tyevco/dial-me-spinner/hardware/mechanical/clash_report.txt

# clash_report.txt -- generated by check_clashes.sh (see legend at the end)
CLEAR  rotor  antenna
CLEAR  rotor  base_board
CLEAR  rotor  base_cup
CLEAR  rotor  base_parts
CLEAR  rotor  battery
CLEAR  rotor  battery_leads
CLEAR  rotor  coax
CLEAR  rotor  detent@click
CLEAR  rotor  detent@free
CLEAR  rotor  fa_lower_plate
CLEAR  rotor  guide_pins
CLEAR  rotor  harness
CLEAR  rotor  hub+nut
CLEAR  rotor  light_box
CLEAR  rotor  lower_spacer
CLEAR  rotor  main_board
CLEAR  rotor  main_bottom_parts
CLEAR  rotor  main_top_parts
CLEAR  rotor  nfc_coil
CLEAR  rotor  nfc_tail
CLEAR  rotor  oled_bracket
CLEAR  rotor  oled_glass
CLEAR  rotor  spindle+pad
CLEAR  rotor  top_cover
CLASH  press  base_cup  overlap ~ 0.000 mm^3
CLASH  press  base_parts  overlap ~ 1.674 mm^3
CLEAR  press  antenna
CLEAR  press  base_board
CLEAR  press  battery
CLEAR  press  battery_leads
CLEAR  press  guide_pins
CLEAR  rest   antenna
CLEAR  rest   base_board
CLEAR  rest   base_cup
CLEAR  rest   base_parts
CLEAR  rest   battery
CLEAR  rest   battery_leads
CLASH  pair   detent@click  x  main_board  overlap ~ 0.000 mm^3
CLASH  pair   detent@free  x  main_board  overlap ~ 0.000 mm^3
CLEAR  pair   battery_leads  x  base_cup
CLEAR  pair   battery_leads  x  fa_lower_plate
CLEAR  pair   battery_leads  x  guide_pins
CLEAR  pair   coax  x  base_board
CLEAR  pair   coax  x  base_cup
CLEAR  pair   coax  x  base_parts
CLEAR  pair   coax  x  detent@click
CLEAR  pair   coax  x  detent@free
CLEAR  pair   coax  x  fa_lower_plate
CLEAR  pair   coax  x  hub+nut
CLEAR  pair   coax  x  lower_spacer
CLEAR  pair   coax  x  spindle+pad
CLEAR  pair   detent@click  x  hub+nut
CLEAR  pair   detent@free  x  hub+nut
CLEAR  pair   harness  x  base_cup
CLEAR  pair   harness  x  detent@click
CLEAR  pair   harness  x  detent@free
CLEAR  pair   harness  x  fa_lower_plate
CLEAR  pair   harness  x  hub+nut
CLEAR  pair   harness  x  lower_spacer
CLEAR  pair   harness  x  spindle+pad
CLEAR  pair   main_bottom_parts  x  coax
CLEAR  pair   main_bottom_parts  x  detent@click
CLEAR  pair   main_bottom_parts  x  detent@free
CLEAR  pair   main_bottom_parts  x  harness
CLEAR  pair   main_bottom_parts  x  hub+nut
CLEAR  pair   main_top_parts  x  hub+nut
CLEAR  pair   main_top_parts  x  light_box
CLEAR  pair   main_top_parts  x  oled_bracket
CLEAR  pair   main_top_parts  x  top_cover
CLEAR  pair   nfc_coil  x  light_box
CLEAR  pair   nfc_coil  x  main_top_parts
CLEAR  pair   nfc_coil  x  oled_bracket
CLEAR  pair   nfc_coil  x  oled_glass
CLEAR  pair   nfc_coil  x  top_cover
CLEAR  pair   nfc_tail  x  light_box
CLEAR  pair   nfc_tail  x  main_board
CLEAR  pair   nfc_tail  x  main_top_parts
CLEAR  pair   nfc_tail  x  oled_bracket
CLEAR  pair   nfc_tail  x  oled_glass
CLEAR  pair   nfc_tail  x  top_cover
CLEAR  pair   oled_bracket  x  hub+nut
--- near misses (rotor envelope grown 0.3 mm) ---
CLASH  rotor  detent@click  overlap ~ 0.600 mm^3
CLASH  rotor  lower_spacer  overlap ~ 9.399 mm^3
--- legend ---
rotor  = stationary item vs the rotor's swept envelope; press/rest = base item vs the floating assembly
(FA) + rotor moved down 0.50 mm / at rest; pair = two items in the same body.  top_cover includes the
cover glass and the diffuser; nfc_coil / nfc_tail = the NFC flex coil and its tail to the J11 pads.
Expected, not defects:
  * press base_cup ~0 mm^3: the plate under-bosses touch the cup stop faces at full travel (the hard stop).
  * press base_parts: includes SW1 actuator vs the press pad (switch travel + pad compression, ~1-2 mm^3).
  * pair detent x main_board ~0 mm^3: rails and saddle are bonded/screwed to the board bottom (face contact).
  * not checked: nfc_coil x nfc_tail (one flex) and the tail's soldered end, which is the J11 joint body in
    main_top_parts; the modelled tail starts 0.05 mm beyond it, so nfc_tail x main_top_parts must be CLEAR.
  * near misses (envelope grown 0.3 mm): detent@click = the felt shoe resting on the ring (intended),
    lower_spacer = the drop-stop flange 0.15 mm under the carrier lip (intended crash stop).
Everything else that says CLASH is a real interference.  calcs_output.txt section 11 names the parts
(exact for the rotor and hub, sampled for the actuator); docs/mechanical.md section 3 says who must act.
