tyevco/dial-me-spinner/hardware/fab/base/dial-me-spinner-base-3d-bottom.png

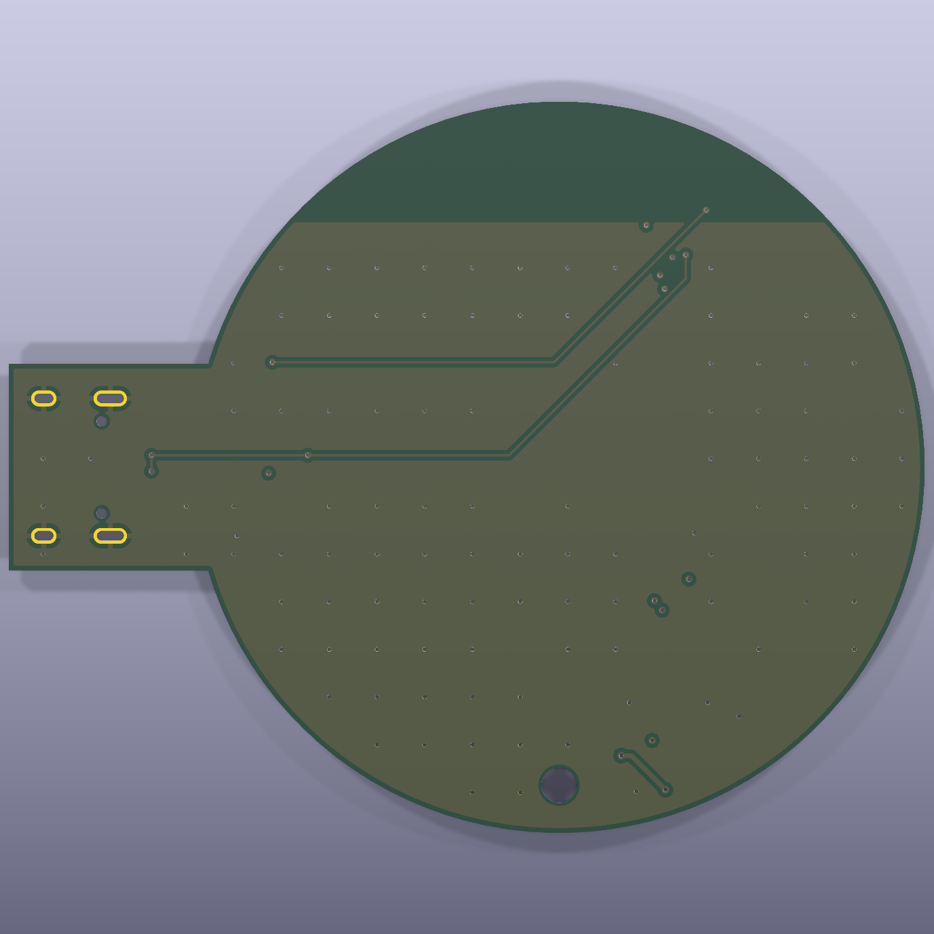
hardware/fab/base/dial-me-spinner-base-3d-bottom.png
