tyevco/dial-me-spinner/hardware/fab/base/dial-me-spinner-base-3d-top.png

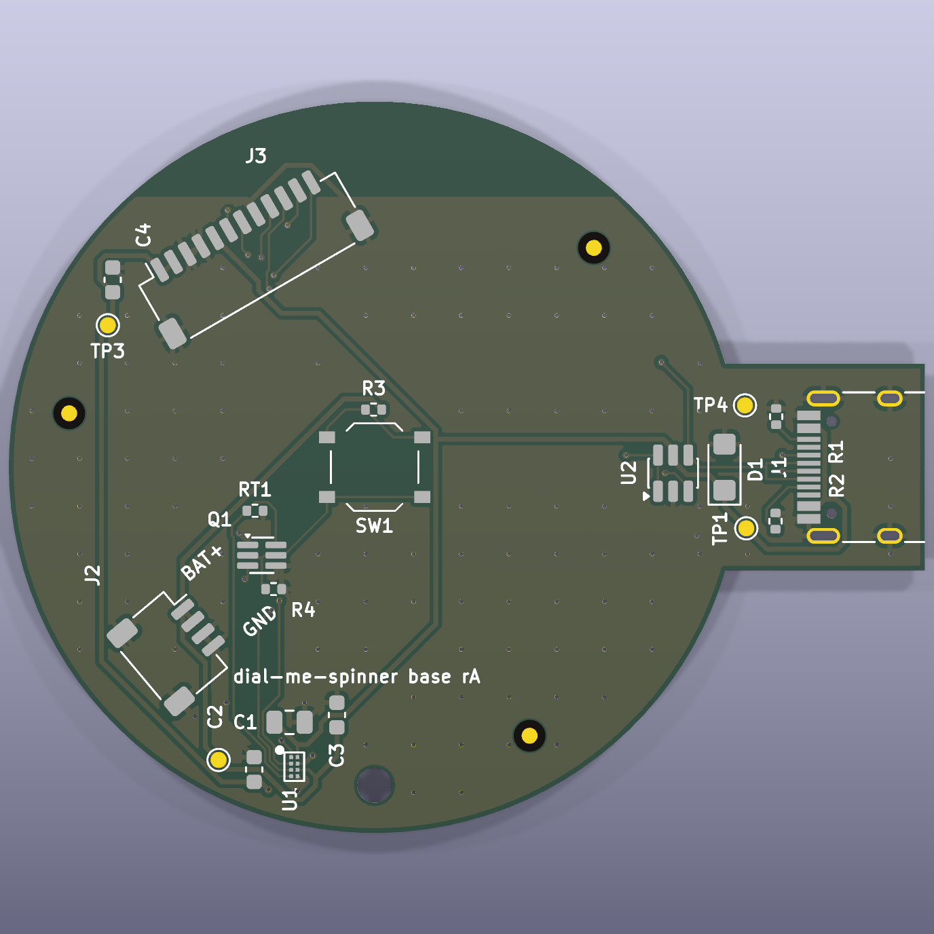
hardware/fab/base/dial-me-spinner-base-3d-top.png
