tyevco/dial-me-spinner/hardware/fab/main/dial-me-spinner-main-3d-bottom.png

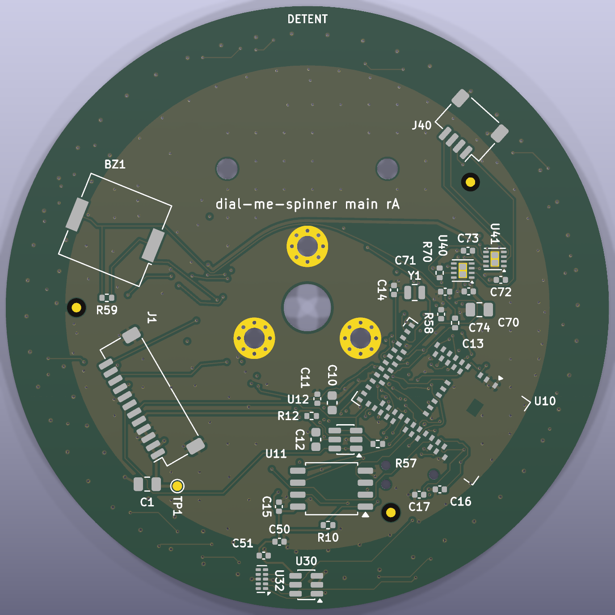
hardware/fab/main/dial-me-spinner-main-3d-bottom.png
