tyevco/dial-me-spinner/hardware/kicad/main/render/sheet-1.png

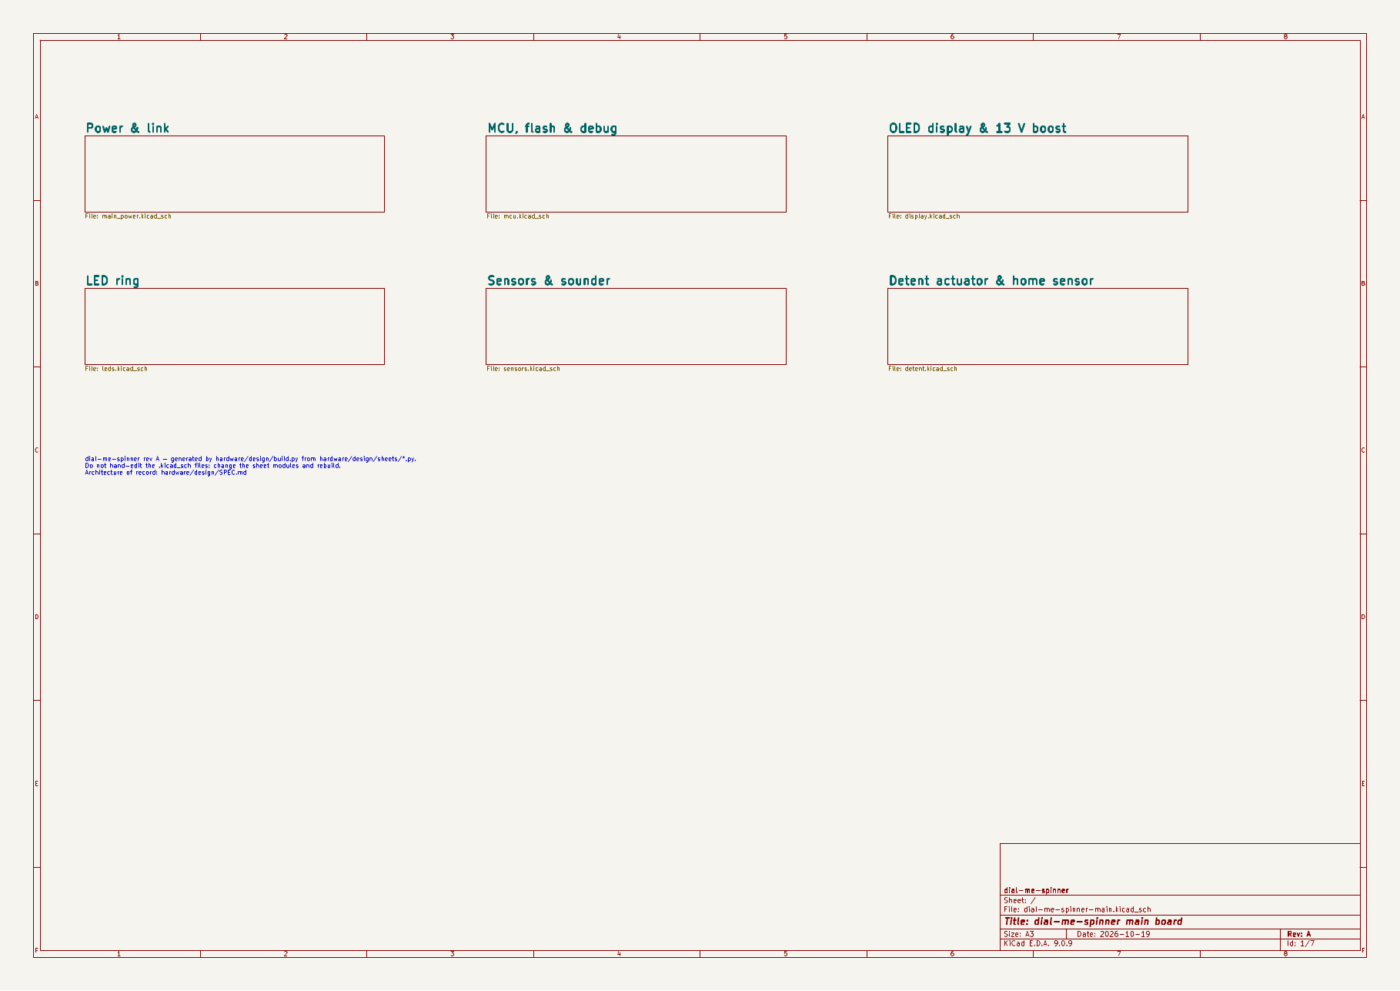
hardware/kicad/main/render/sheet-1.png
