tyevco/dial-me-spinner/hardware/kicad/main/render/sheet-2.png

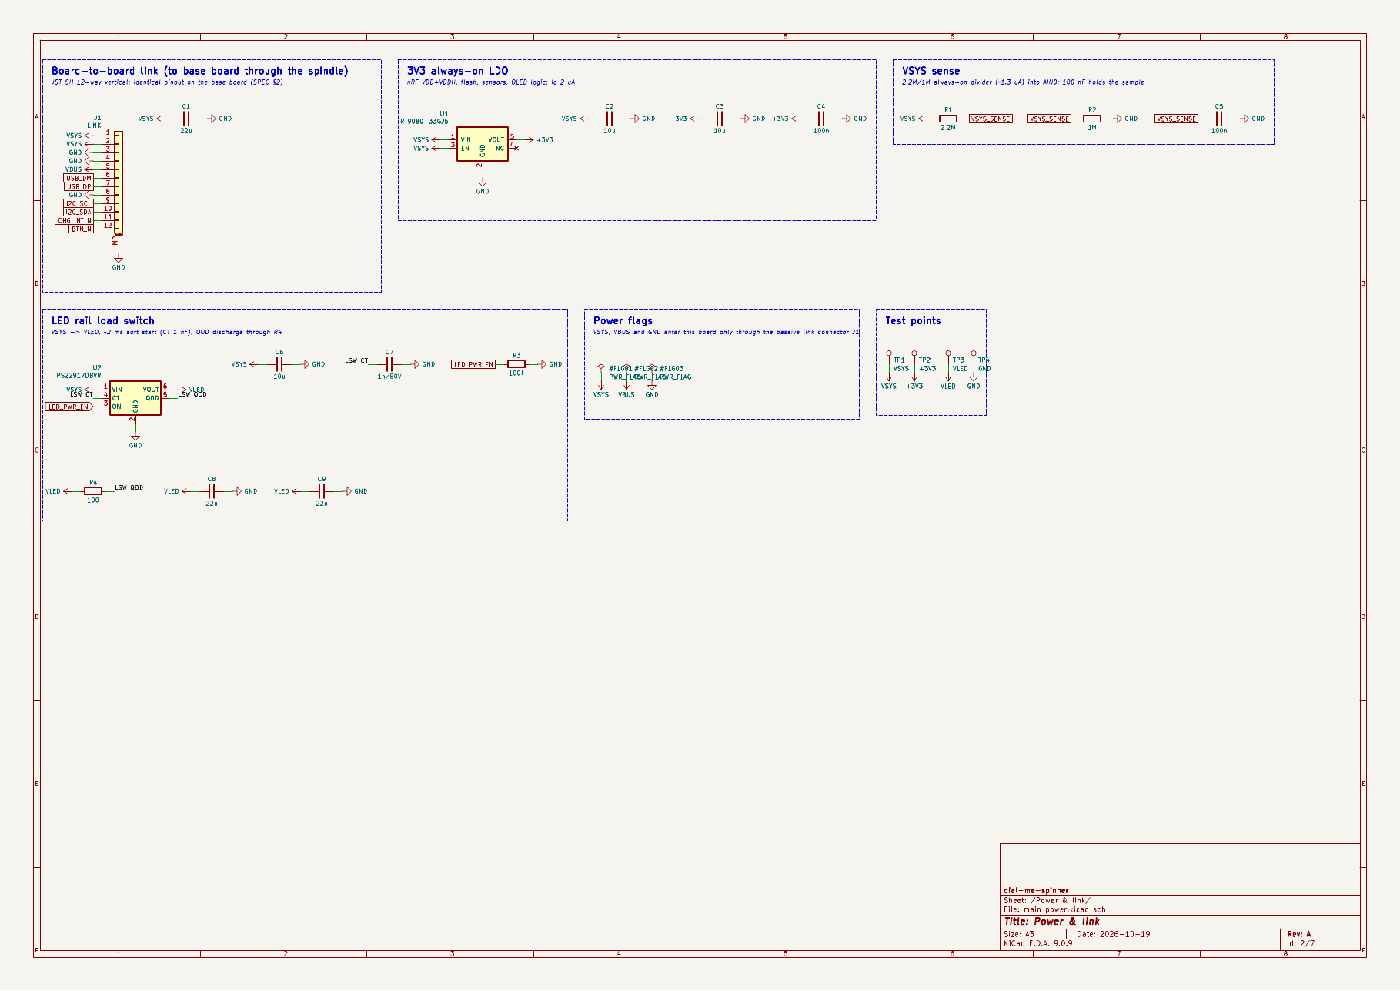
hardware/kicad/main/render/sheet-2.png
