tyevco/dial-me-spinner/hardware/kicad/main/render/sheet-3.png

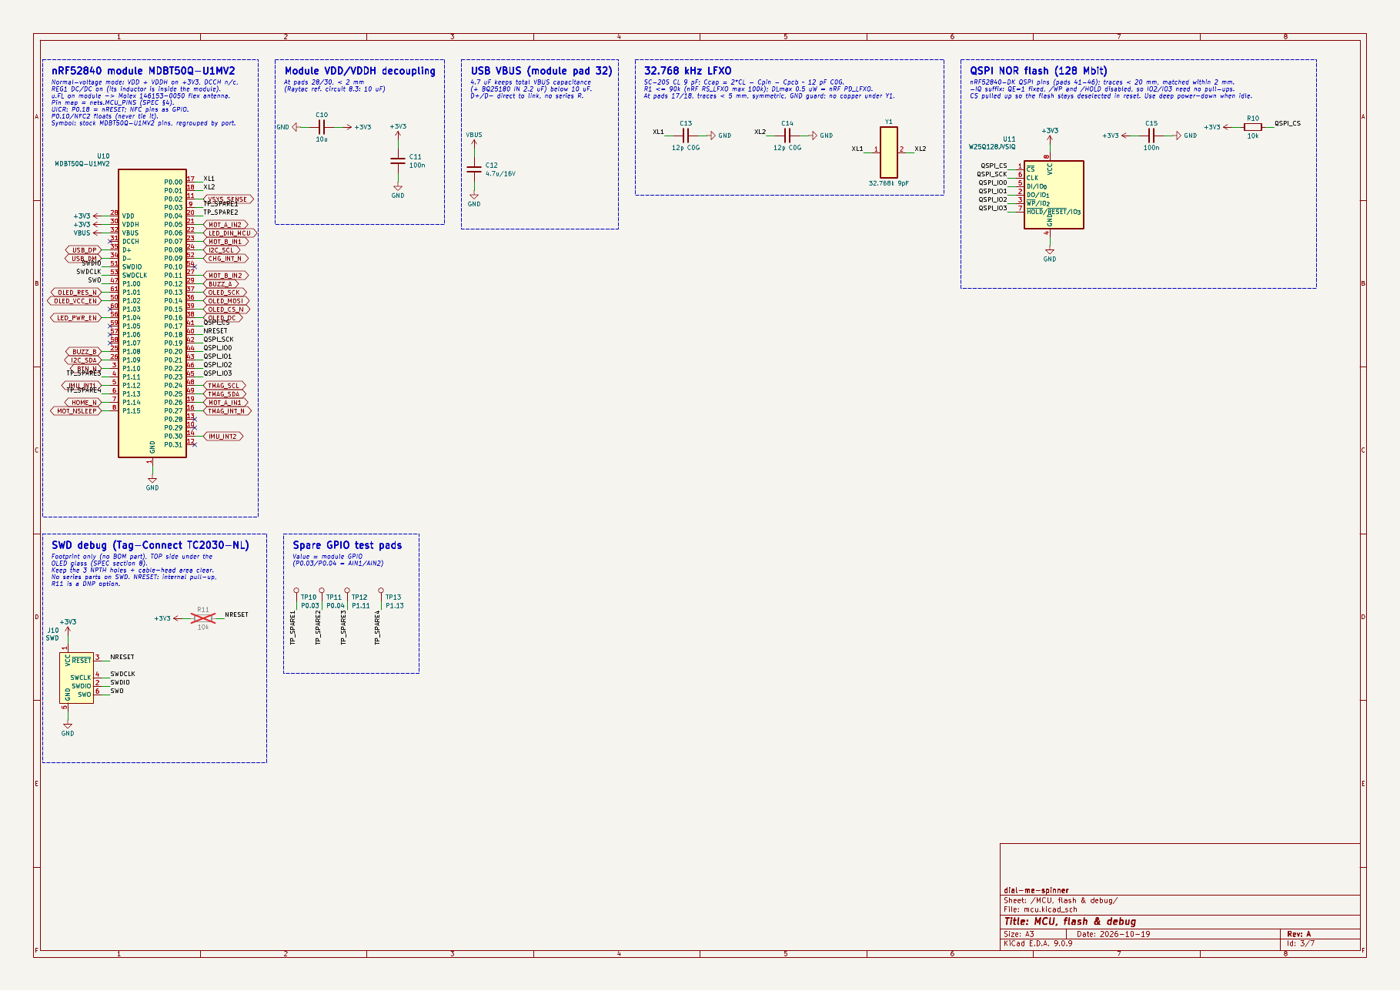
hardware/kicad/main/render/sheet-3.png
