tyevco/dial-me-spinner/hardware/kicad/main/render/sheet-4.png

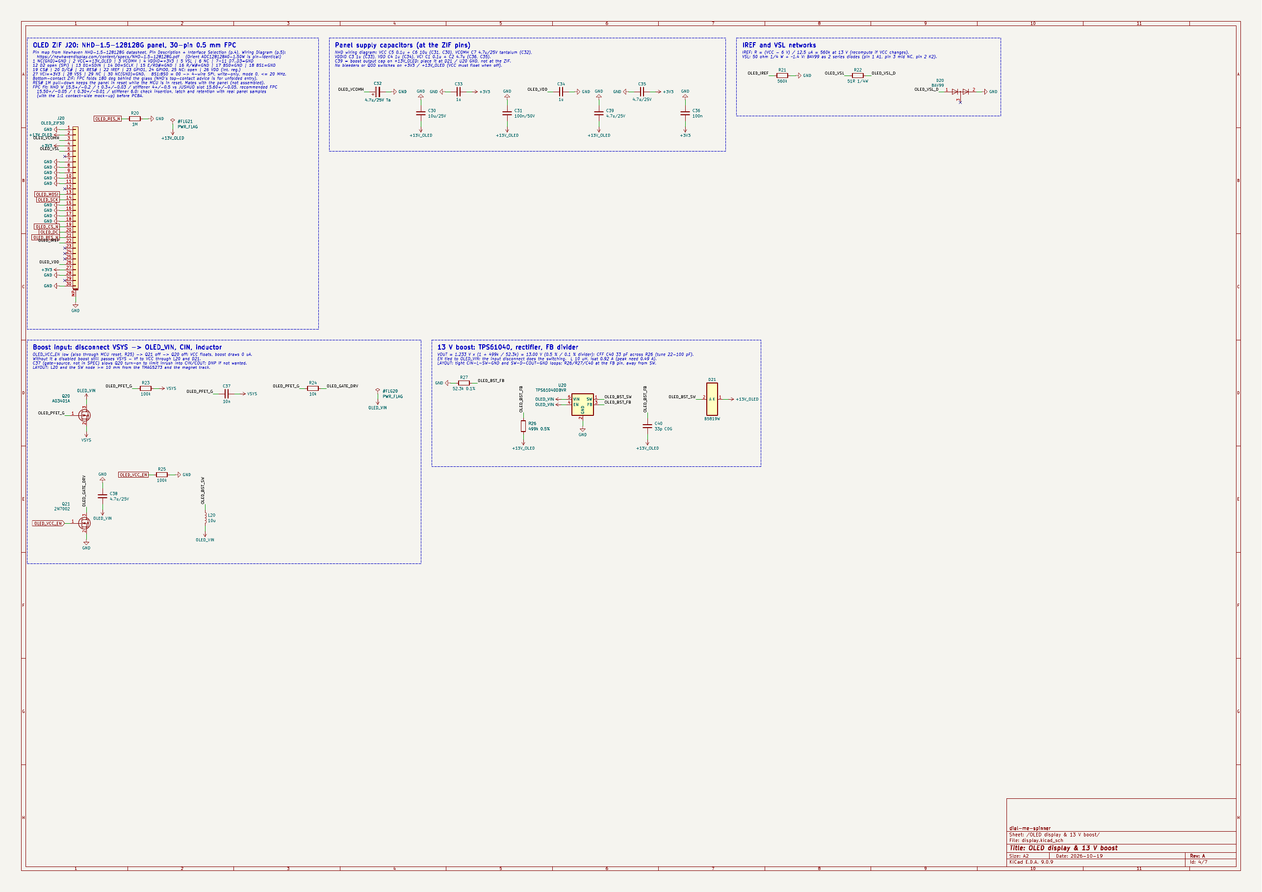
hardware/kicad/main/render/sheet-4.png
