tyevco/dial-me-spinner/hardware/kicad/main/render/sheet-5.png

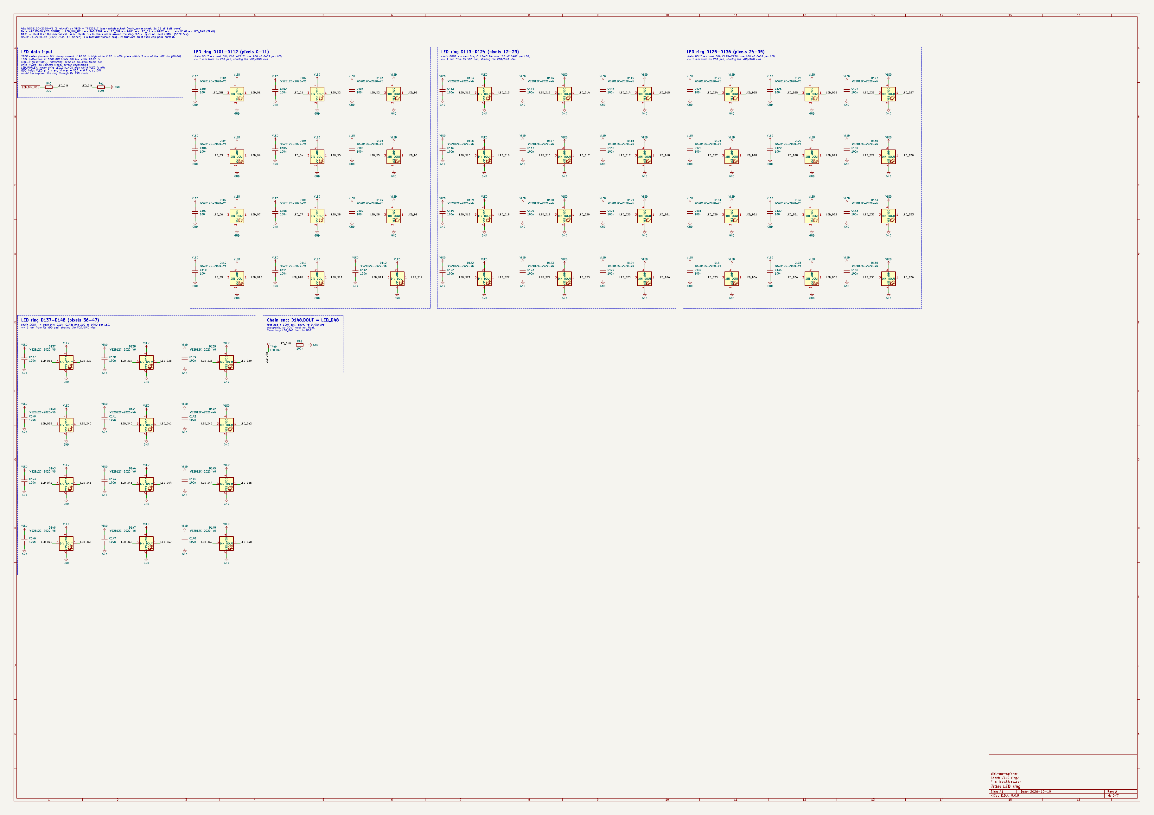
hardware/kicad/main/render/sheet-5.png
