tyevco/dial-me-spinner/hardware/kicad/main/render/sheet-6.png

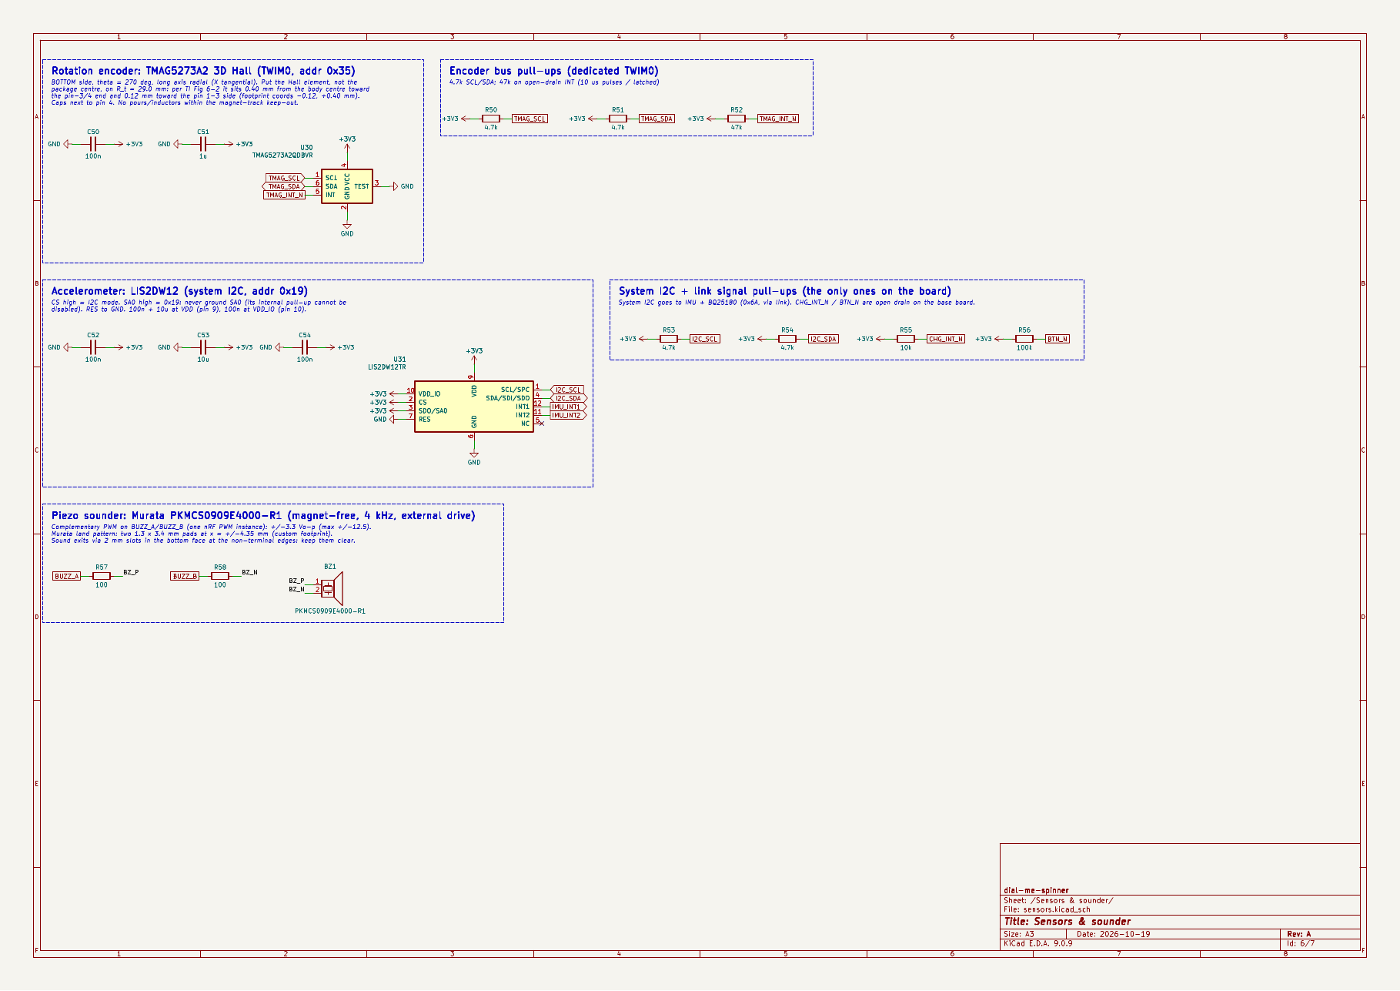
hardware/kicad/main/render/sheet-6.png
