tyevco/dial-me-spinner/hardware/kicad/main/render/sheet-7.png

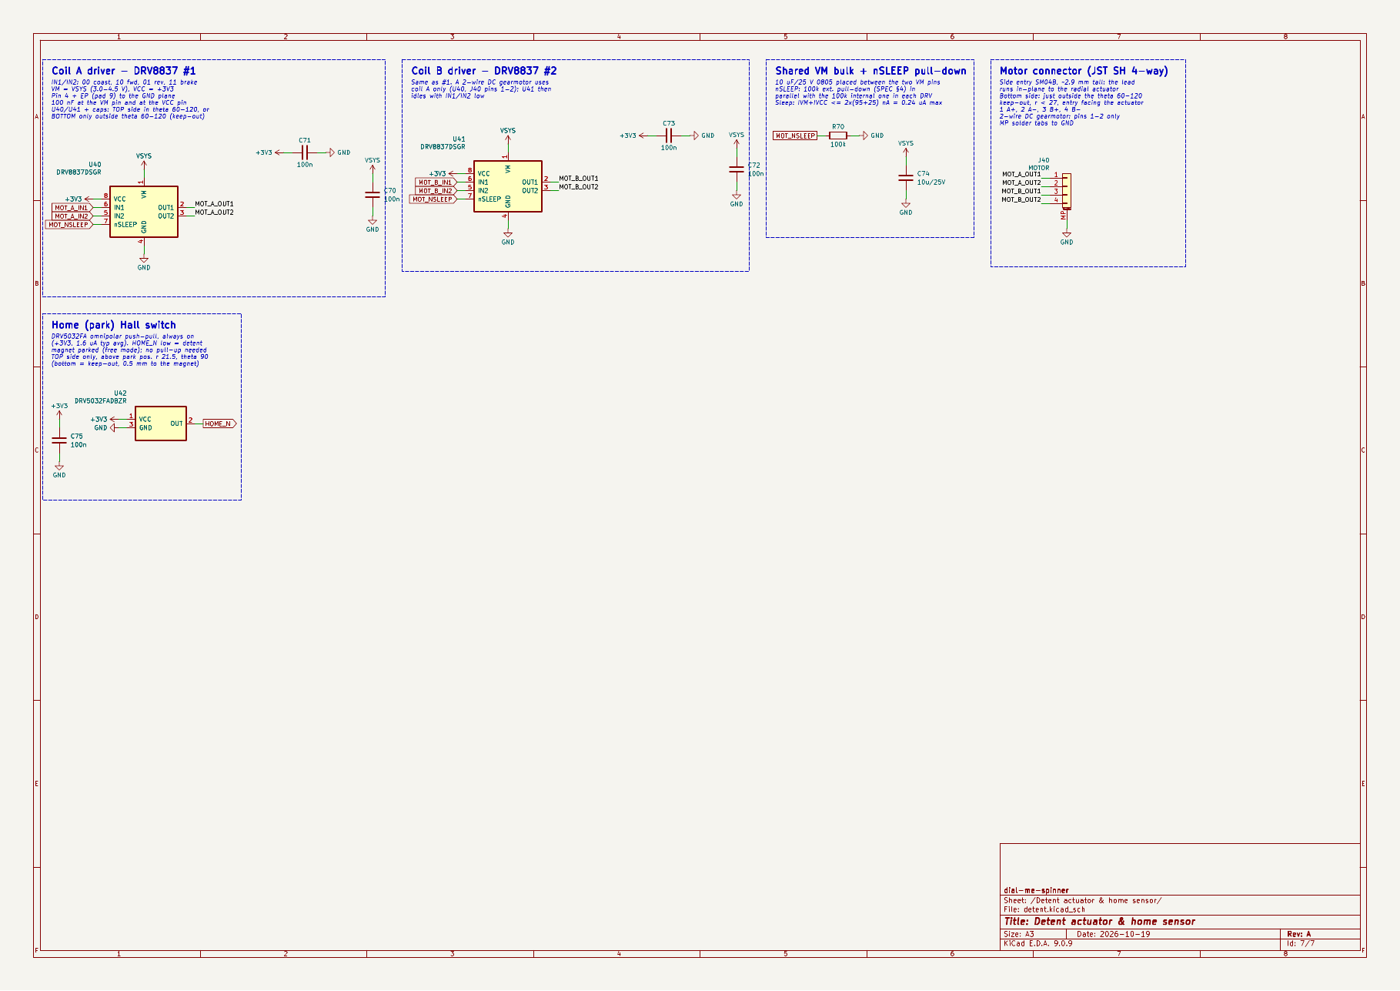
hardware/kicad/main/render/sheet-7.png
