tyevco/dial-me-spinner/hardware/mechanical/renders/section_xz.png

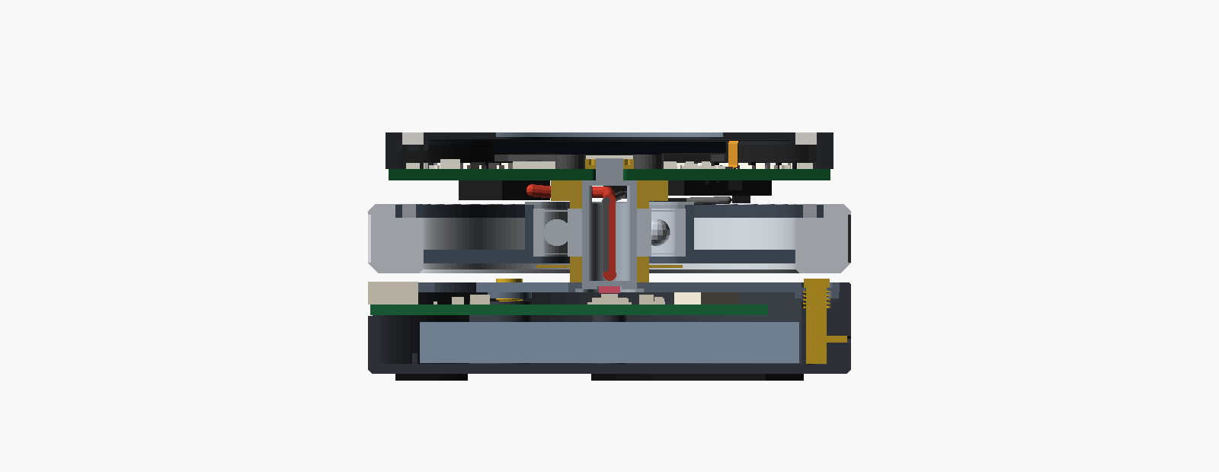
hardware/mechanical/renders/section_xz.png
