tyevco/dial-me-spinner/hardware/fab/main/ORDER-NOTES.md

# Order notes: dial-me-spinner-main.kicad_pcb

(generated by hardware/design/release.py; do not edit)

* Do not place (DNP), excluded from BOM/CPL: C43, R11, U43
* Bottom-side placements (33): BZ1, C1, C10, C11, C12, C13, C14, C15, C16, C17, C50, C51, C70, C71, C72, C73, C74, J1, J40, R10, R12, R57, R58, R59, R70, U10, U11, U12, U30, U32, U40, U41, Y1
* CPL angles and origins include the JLC library corrections from hardware/design/jlc_offsets.json (top: θ+α, bottom: 180−θ+α). Every row was checked by putting the EasyEDA pads down at its point and angle: all land on copper. Still check every IC and connector in JLC's placement preview.
* Board-only parts (no BOM): FID1, FID2, FID3, FID4, FID5, FID6, H4, H5
