tyevco/dial-me-spinner/hardware/fab/base/dial-me-spinner-base-BOM-JLCPCB.csv

Comment | Designator | Footprint | LCSC Part # | MPN | Qty
2.2u/25V | C1 | C_0805_2012Metric | C277470 | CC0805KKX7R8BB225 | 1
10u/25V | C2,C4 | C_0603_1608Metric | C96446 | CL10A106MA8NRNC | 2
4.7u | C3 | C_0603_1608Metric | C19666 | CL10A475KO8NNNC | 1
SMF5.0A | D1 | D_SMF | C151296 | SMF5.0A | 1
TYPE-C-31-M-12 | J1 | USB_C_Receptacle_HRO_TYPE-C-31-M-12 | C165948 | TYPE-C-31-M-12 | 1
BATT | J2 | JST_SH_SM04B-SRSS-TB_1x04-1MP_P1.00mm_Horizontal | C160404 | SM04B-SRSS-TB(LF)(SN) | 1
LINK | J3 | JST_SH_SM12B-SRSS-TB_1x12-1MP_P1.00mm_Horizontal | C160411 | SM12B-SRSS-TB(LF)(SN) | 1
BSS138DW | Q1 | SOT-363_SC-70-6 | C154900 | BSS138DW-7-F | 1
5.1k | R1,R2 | R_0402_1005Metric | C25905 | 0402WGF5101TCE | 2
1k | R3 | R_0402_1005Metric | C11702 | 0402WGF1001TCE | 1
100k | R4 | R_0402_1005Metric | C25741 | 0402WGF1003TCE | 1
10k B3435 | RT1 | R_0402_1005Metric | C77131 | NCP15XH103F03RC | 1
TS-1187A | SW1 | SW_Push_1P1T_XKB_TS-1187A | C318884 | TS-1187A-B-A-B | 1
BQ25180YBGR | U1 | Texas_DSBGA-8_1.04x1.59mm_Layout2x4_P0.4mm_YBG0008 | C3682423 | BQ25180YBGR | 1
USBLC6-2SC6 | U2 | SOT-23-6 | C7519 | USBLC6-2SC6 | 1
