tyevco/dial-me-spinner/hardware/fab/main/dial-me-spinner-main-BOM-JLCPCB.csv

Comment | Designator | Footprint | LCSC Part # | MPN | Qty
PKMCS0909E4000-R1 | BZ1 | Buzzer_Murata_PKMCS0909E4000-R1 | C910763 | PKMCS0909E4000-R1 | 1
22u | C1,C8,C9 | C_0805_2012Metric | C45783 | CL21A226MAQNNNE | 3
10u/25V | C2,C6,C41 | C_0603_1608Metric | C96446 | CL10A106MA8NRNC | 3
10u | C3,C10,C53 | C_0603_1608Metric | C19702 | CL10A106KP8NNNC | 3
100n | C4,C5,C11,C15,C36,C50,C52,C54,C70,C71,C72,C73,C75,C101,C102,C103,C104,C105,C106,C107,C108,C109,C110,C111,C112,C113,C114,C115,C116,C117,C118,C119,C120,C121,C122,C123,C124,C125,C126,C127,C128,C129,C130,C131,C132,C133,C134,C135,C136,C137,C138,C139,C140,C141,C142,C143,C144,C145,C146,C147,C148 | C_0402_1005Metric | C1525 | CL05B104KO5NNNC | 61
1n/50V | C7,C37 | C_0402_1005Metric | C1523 | 0402B102K500NT | 2
4.7u/16V | C12 | C_0603_1608Metric | C19666 | CL10A475KO8NNNC | 1
12p C0G | C13,C14 | C_0402_1005Metric | C1547 | 0402CG120J500NT | 2
180p C0G | C16,C17 | C_0402_1005Metric | C78636 | 0402CG181J500NT | 2
10u/25V | C30,C74 | C_0805_2012Metric | C15850 | CL21A106KAYNNNE | 2
100n/50V | C31 | C_0402_1005Metric | C307331 | CL05B104KB54PNC | 1
4.7u/25V Ta | C32 | CP_EIA-3216-18_Kemet-A | C7189 | TAJA475K025RNJ | 1
1u | C33,C34,C51 | C_0402_1005Metric | C52923 | CL05A105KA5NQNC | 3
4.7u/25V | C35,C38,C39 | C_0805_2012Metric | C1779 | CL21A475KAQNNNE | 3
33p C0G | C40 | C_0402_1005Metric | C1562 | 0402CG330J500NT | 1
BAV99 | D20 | SOT-23 | C2500 | BAV99,215 | 1
B5819W | D21 | D_SOD-123 | C8598 | B5819W SL | 1
WS2812C-2020-V6 | D101,D102,D103,D104,D105,D106,D107,D108,D109,D110,D111,D112,D113,D114,D115,D116,D117,D118,D119,D120,D121,D122,D123,D124,D125,D126,D127,D128,D129,D130,D131,D132,D133,D134,D135,D136,D137,D138,D139,D140,D141,D142,D143,D144,D145,D146,D147,D148 | LED_WS2812B-2020_PLCC4_2.0x2.0mm | C55109522 | WS2812C-2020-V6 | 48
LINK | J1 | JST_SH_SM12B-SRSS-TB_1x12-1MP_P1.00mm_Horizontal | C160411 | SM12B-SRSS-TB(LF)(SN) | 1
OLED_ZIF30 | J20 | JUSHUO_AFC01-S30FCA-00_1x30-1MP_P0.50mm_Horizontal | C262671 | AFC01-S30FCA-00 | 1
MOTOR | J40 | JST_SH_SM04B-SRSS-TB_1x04-1MP_P1.00mm_Horizontal | C160404 | SM04B-SRSS-TB(LF)(SN) | 1
10u | L20 | L_Sunlord_SWPA3015S | C45403 | SWPA3015S100MT | 1
2.2M | R1 | R_0402_1005Metric | C11490 | 0402WGF2204TCE | 1
1M | R2,R20,R59 | R_0402_1005Metric | C26083 | 0402WGF1004TCE | 3
100k | R3,R25,R41,R42,R56,R70 | R_0402_1005Metric | C25741 | 0402WGF1003TCE | 6
68 | R4 | R_0402_1005Metric | C163455 | RC0402FR-0768RL | 1
10k | R10,R55 | R_0402_1005Metric | C25744 | 0402WGF1002TCE | 2
4.7 | R12 | R_0402_1005Metric | C2909356 | FRC0402F4R70TS | 1
560k | R21 | R_0402_1005Metric | C132339 | 0402WGF5603TCE | 1
51R 1/4W | R22 | R_1206_3216Metric | C18019 | 1206W4F510JT5E | 1
499k 0.5% | R26 | R_0402_1005Metric | C4167968 | RC0402DR-07499KL | 1
52.3k 0.1% | R27 | R_0402_1005Metric | C852832 | RT0402BRD0752K3L | 1
220 | R40 | R_0402_1005Metric | C25091 | 0402WGF2200TCE | 1
0 | R43 | R_0402_1005Metric | C17168 | 0402WGF0000TCE | 1
4.7k | R50,R51,R53,R54 | R_0402_1005Metric | C25900 | 0402WGF4701TCE | 4
47k | R52 | R_0402_1005Metric | C25792 | 0402WGF4702TCE | 1
470 | R57,R58 | R_0402_1005Metric | C25117 | 0402WGF4700TCE | 2
RT9080-33GJ5 | U1 | SOT-23-5 | C841192 | RT9080-33GJ5 | 1
TPS22917DBVR | U2,U21 | SOT-23-6 | C2681320 | TPS22917DBVR | 2
MDBT50Q-U1MV2 | U10 | Raytac_MDBT50Q_UFL | C2688382 | MDBT50Q-U1MV2 | 1
W25Q128JVSIQ | U11 | SOIC-8_5.3x5.3mm_P1.27mm | C97521 | W25Q128JVSIQ | 1
USBLC6-2SC6 | U12 | SOT-23-6 | C7519 | USBLC6-2SC6 | 1
TPS61040DBVR | U20 | SOT-23-5 | C7722 | TPS61040DBVR | 1
TMAG5273A2QDBVR | U30 | SOT-23-6 | C3715882 | TMAG5273A2QDBVR | 1
LIS2DW12TR | U31 | LGA-12_2x2mm_P0.5mm | C189624 | LIS2DW12TR | 1
TPD4E05U06DQAR | U32 | USON-10_2.5x1.0mm_P0.5mm | C138714 | TPD4E05U06DQAR | 1
DRV8837DSGR | U40,U41 | Texas_DSG0008A_WSON-8-1EP_2x2mm_P0.5mm_EP0.9x1.6mm | C39159 | DRV8837DSGR | 2
DRV5032FADBZR | U42 | SOT-23 | C140921 | DRV5032FADBZR | 1
32.768k 9pF | Y1 | Crystal_SII_SC-20S_2.0x1.2mm | C97603 | SC-20S 32.768kHz 20PPM 9pF | 1
