tyevco/dial-me-spinner/hardware/mechanical/step/rotor_ring.step

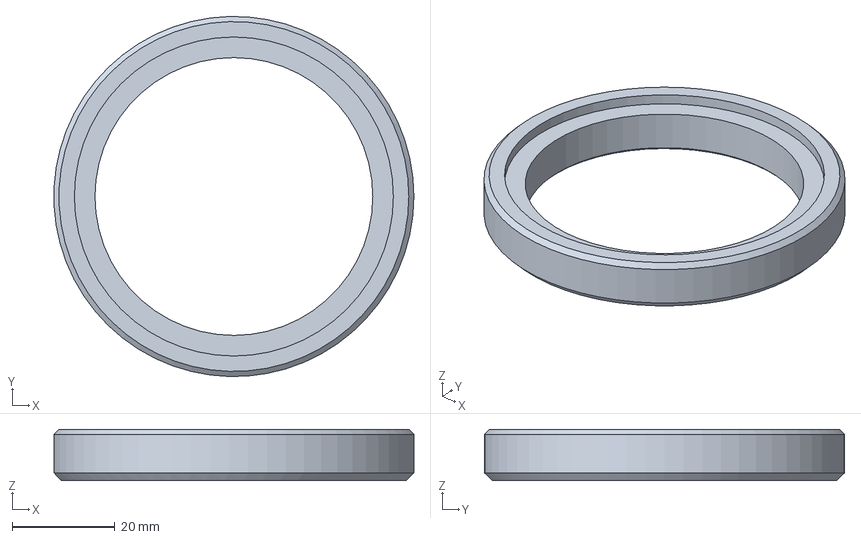
[picture p24: CAD file, 2026-10-21]
hardware/mechanical/step/rotor_ring.step
70.0 x 70.0 x 10.0 mm
