tyevco/dial-me-spinner/hardware/mechanical/stl/magnet_shim.stl

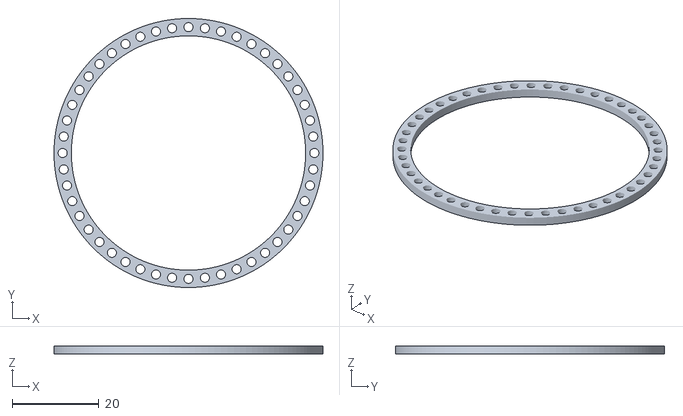
[picture p25: CAD file, 2026-10-21]
hardware/mechanical/stl/magnet_shim.stl
62.0 x 62.0 x 1.95
