tyevco/dial-me-spinner/hardware/mechanical/step/spindle_hub.step

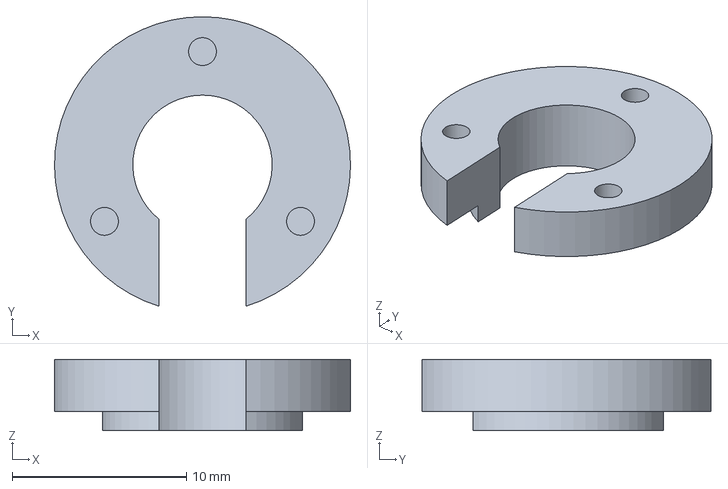
[picture p26: CAD file, 2026-10-21]
hardware/mechanical/step/spindle_hub.step
17.0 x 16.6 x 4.10 mm
