tyevco/dial-me-spinner/hardware/mechanical/stl/light_box.stl

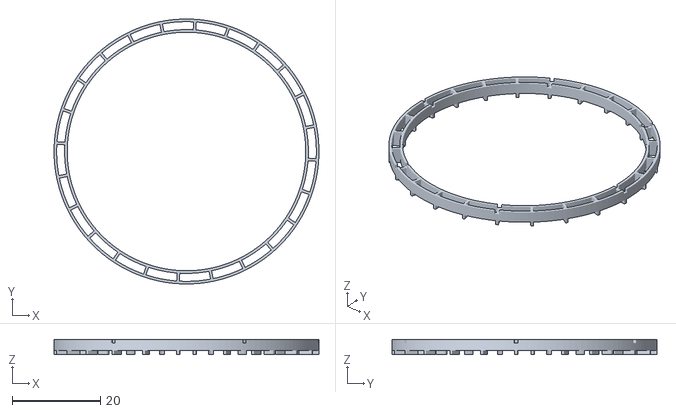
[picture p27: CAD file, 2026-10-20]
hardware/mechanical/stl/light_box.stl
60.0 x 60.0 x 3.50
