tyevco/dial-me-spinner/hardware/mechanical/step/lower_spacer.step

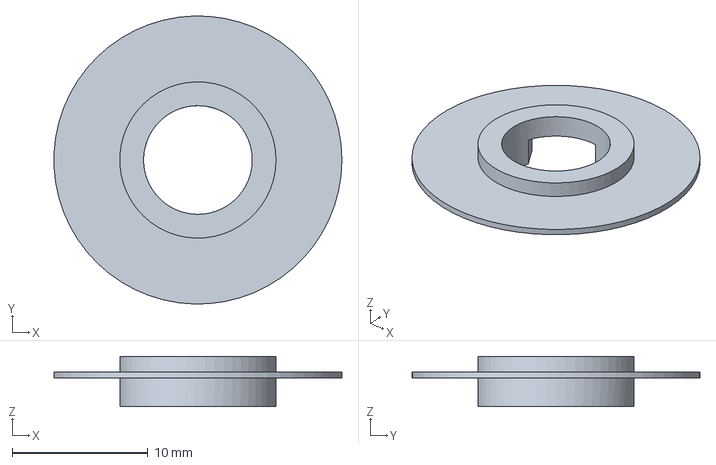
[picture p28: CAD file, 2026-10-21]
hardware/mechanical/step/lower_spacer.step
21.2 x 21.2 x 3.70 mm
