tyevco/dial-me-spinner/hardware/mechanical/stl/oled_bracket.stl

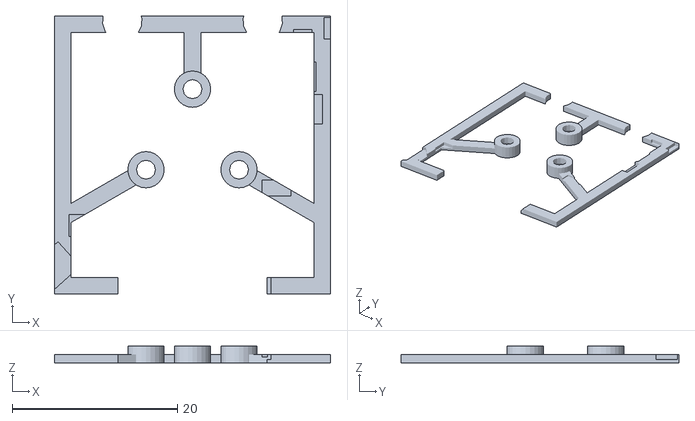
[picture p29: CAD file, 2026-10-20]
hardware/mechanical/stl/oled_bracket.stl
33.4 x 33.6 x 2.05
