tyevco/dial-me-spinner/hardware/mechanical/step/cap_ring.step

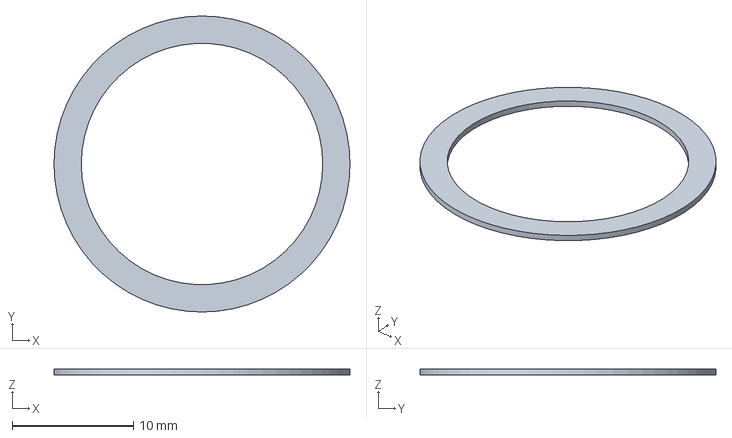
[picture p30: CAD file, 2026-10-21]
hardware/mechanical/step/cap_ring.step
24.4 x 24.4 x 0.5 mm
