tyevco/dial-me-spinner/hardware/mechanical/stl/diffuser.stl

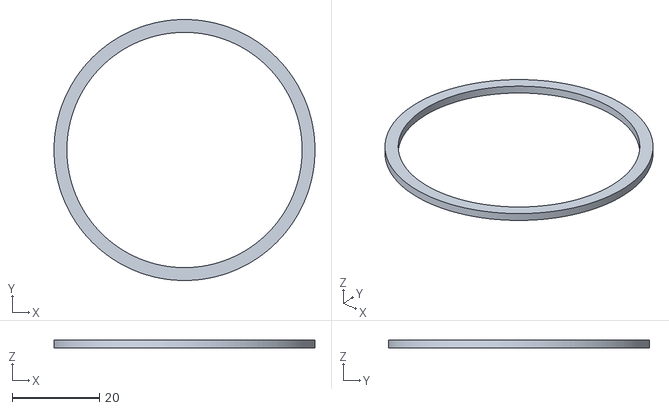
[picture p31: CAD file, 2026-10-20]
hardware/mechanical/stl/diffuser.stl
60.0 x 60.0 x 1.76
