tyevco/dial-me-spinner/hardware/mechanical/step/spindle.step

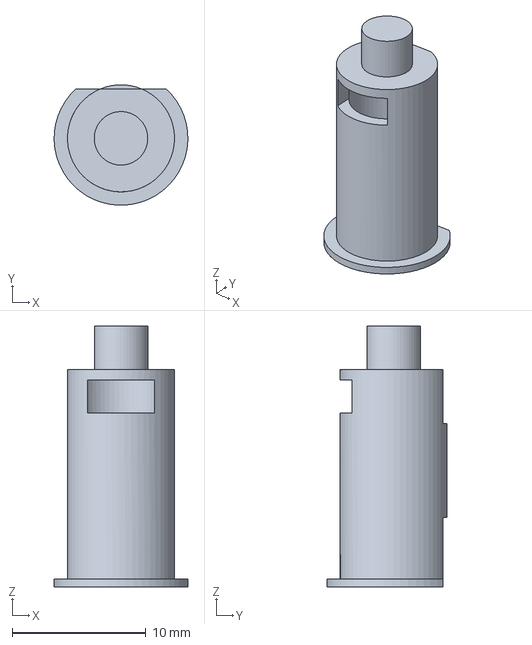
[picture p32: CAD file, 2026-10-21]
hardware/mechanical/step/spindle.step
10.00 x 8.98 x 19.5 mm
