tyevco/dial-me-spinner/hardware/mechanical/stl/base_cup.stl

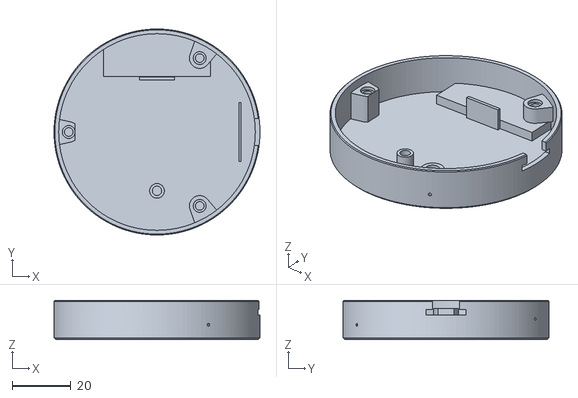
[picture p33: CAD file, 2026-10-20]
hardware/mechanical/stl/base_cup.stl
70.0 x 70.0 x 13.3
