tyevco/dial-me-spinner/hardware/mechanical/stl/fa_lower_plate.stl

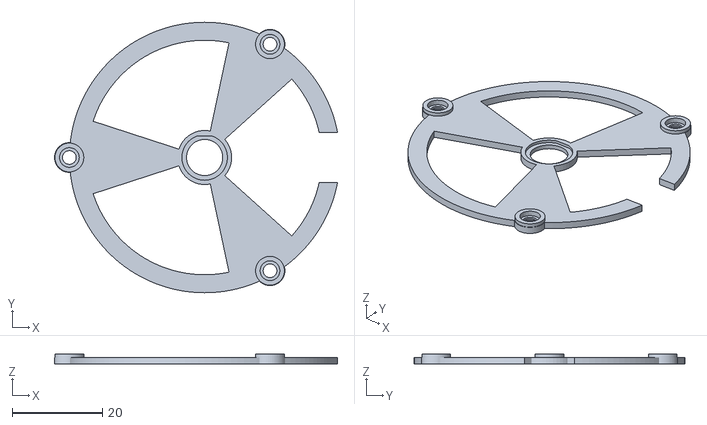
[picture p34: CAD file, 2026-10-20]
hardware/mechanical/stl/fa_lower_plate.stl
62.8 x 60.0 x 2.30
