tyevco/dial-me-spinner/hardware/mechanical/stl/top_cover.stl

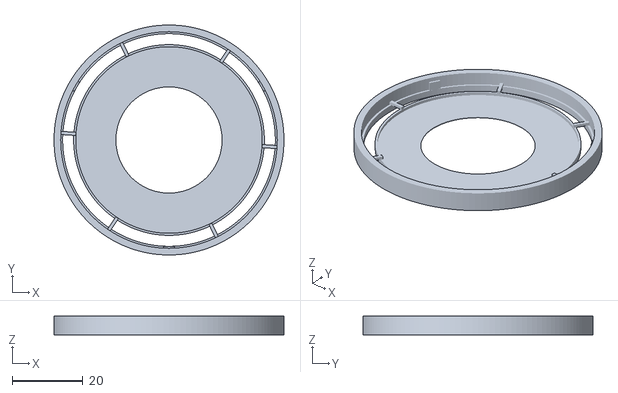
[picture p35: CAD file, 2026-10-20]
hardware/mechanical/stl/top_cover.stl
65.0 x 65.0 x 5.25
