tyevco/dial-me-spinner/hardware/mechanical/stl/link_plate.stl

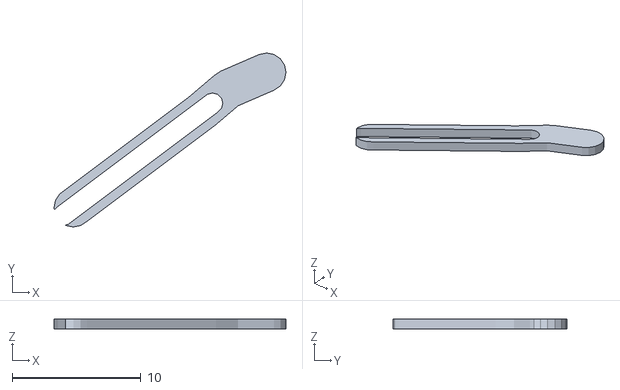
[picture p36: CAD file, 2026-10-19]
hardware/mechanical/stl/link_plate.stl
18.0 x 13.5 x 0.8
