tyevco/dial-me-spinner/hardware/mechanical/stl/detent_carriage.stl

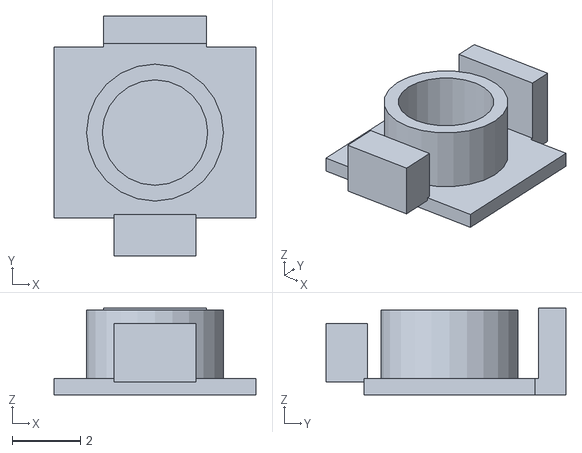
[picture p37: CAD file, 2026-10-19]
hardware/mechanical/stl/detent_carriage.stl
5.90 x 7.00 x 2.53
