tyevco/dial-me-spinner/hardware/mechanical/stl/rotor_carrier.stl

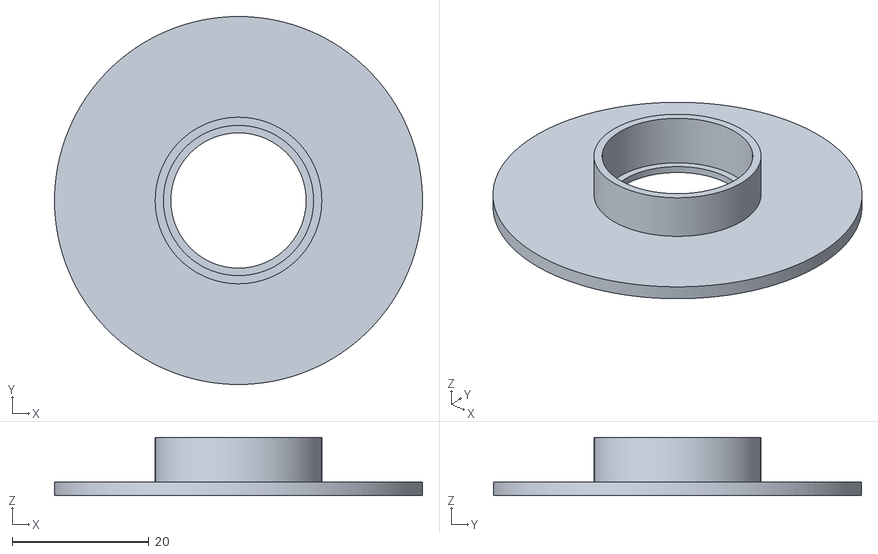
[picture p38: CAD file, 2026-10-19]
hardware/mechanical/stl/rotor_carrier.stl
53.9 x 53.9 x 8.50
