tyevco/dial-me-spinner/hardware/mechanical/stl/carriage_rail.stl

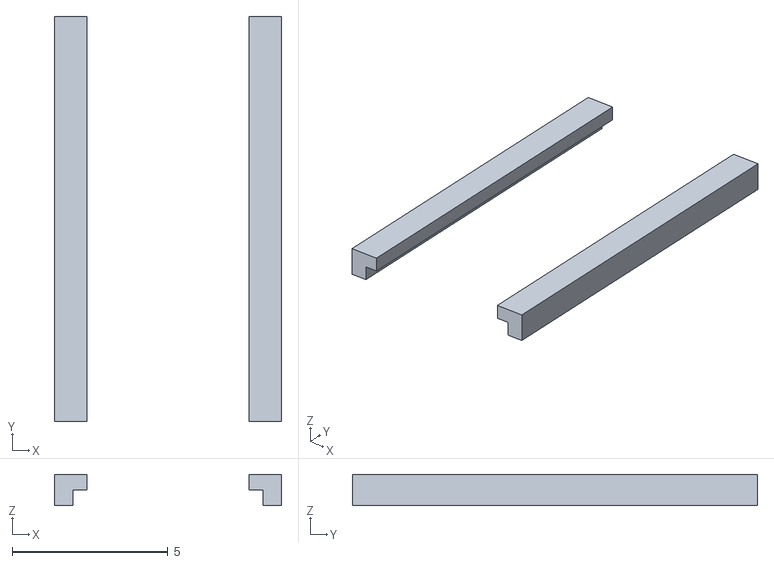
[picture p39: CAD file, 2026-10-19]
hardware/mechanical/stl/carriage_rail.stl
7.30 x 13.0 x 1.00
