tyevco/dial-me-spinner/hardware/mechanical/stl/stepper_saddle.stl

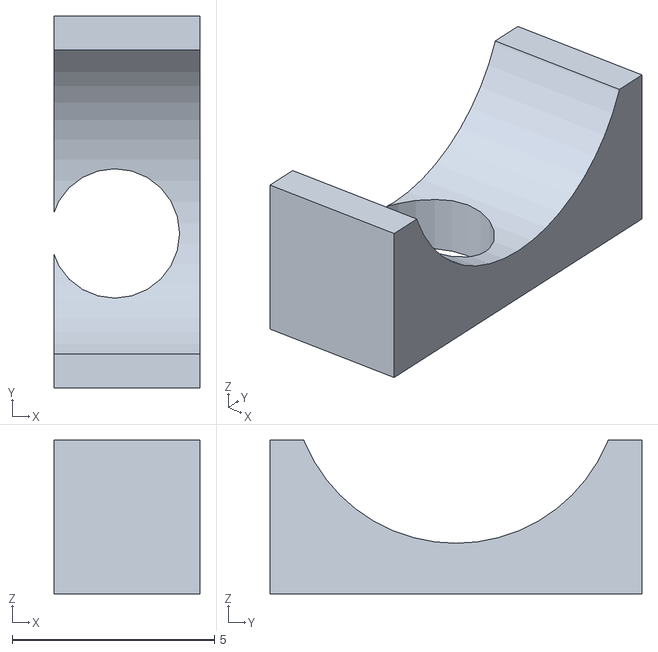
[picture p40: CAD file, 2026-10-19]
hardware/mechanical/stl/stepper_saddle.stl
3.60 x 9.20 x 3.80
