tyevco/dial-me-spinner/hardware/mechanical/board_parts.scad

// GENERATED by extract_board_parts.py from hardware/kicad/*/*.kicad_pcb -- do not edit.
// [ref, side, x, y, phi_deg, u0, u1, v0, v1, z0, h]  (oriented box in the footprint frame)
MAIN_PARTS = [
  ["R2", "T", -14.233, -5.388, 0.00, -0.525, 0.525, -0.270, 0.270, 30.700, 0.40],
  ["C7", "T", 16.547, 1.464, 0.00, -0.500, 0.500, -0.250, 0.250, 30.700, 0.55],
  ["C142", "T", 15.767, -20.548, 38.00, -0.500, 0.500, -0.250, 0.250, 30.700, 0.55],
  ["C115", "T", -6.703, 25.017, -165.00, -0.500, 0.500, -0.250, 0.250, 30.700, 0.55],
  ["C116", "T", -9.912, 23.928, -157.00, -0.500, 0.500, -0.250, 0.250, 30.700, 0.55],
  ["D125", "T", -28.500, 0.000, -90.00, -1.100, 1.100, -1.000, 1.000, 30.700, 0.90],
  ["U31", "T", -11.841, -2.448, 0.00, -1.000, 1.000, -1.000, 1.000, 30.700, 0.80],
  ["L20", "T", 12.500, -12.124, 0.00, -1.500, 1.500, -1.500, 1.500, 30.700, 1.50],
  ["D141", "T", 14.250, -24.682, 30.00, -1.100, 1.100, -1.000, 1.000, 30.700, 0.90],
  ["D128", "T", -26.331, -10.906, -67.00, -1.100, 1.100, -1.000, 1.000, 30.700, 0.90],
  ["D114", "T", -3.720, 28.256, -172.00, -1.100, 1.100, -1.000, 1.000, 30.700, 0.90],
  ["C38", "T", 16.842, 13.872, 90.00, -1.000, 1.000, -0.625, 0.625, 30.700, 1.45],
  ["C31", "T", -7.618, -7.156, 0.00, -0.500, 0.500, -0.250, 0.250, 30.700, 0.55],
  ["D119", "T", -20.153, 20.153, -135.00, -1.100, 1.100, -1.000, 1.000, 30.700, 0.90],
  ["D105", "T", 24.682, 14.250, 120.00, -1.100, 1.100, -1.000, 1.000, 30.700, 0.90],
  ["C54", "T", -9.521, 0.078, 90.00, -0.500, 0.500, -0.250, 0.250, 30.700, 0.55],
  ["C104", "T", 23.928, 9.912, 113.00, -0.500, 0.500, -0.250, 0.250, 30.700, 0.55],
  ["D21", "T", 3.521, -17.317, 0.00, -1.400, 1.400, -0.900, 0.900, 30.700, 1.35],
  ["D109", "T", 14.250, 24.682, 150.00, -1.100, 1.100, -1.000, 1.000, 30.700, 0.90],
  ["R1", "T", -14.909, -4.049, 0.00, -0.525, 0.525, -0.270, 0.270, 30.700, 0.40],
  ["C53", "T", -13.314, 1.521, 0.00, -0.800, 0.800, -0.400, 0.400, 30.700, 0.90],
  ["C117", "T", -12.950, 22.430, -150.00, -0.500, 0.500, -0.250, 0.250, 30.700, 0.55],
  ["C37", "T", 12.919, 14.684, 0.00, -0.500, 0.500, -0.250, 0.250, 30.700, 0.55],
  ["C107", "T", 18.314, 18.314, 135.00, -0.500, 0.500, -0.250, 0.250, 30.700, 0.55],
  ["D135", "T", -7.376, -27.529, -15.00, -1.100, 1.100, -1.000, 1.000, 30.700, 0.90],
  ["C106", "T", 20.548, 15.767, 128.00, -0.500, 0.500, -0.250, 0.250, 30.700, 0.55],
  ["D144", "T", 22.611, -17.350, 53.00, -1.100, 1.100, -1.000, 1.000, 30.700, 0.90],
  ["R53", "T", -14.993, -0.293, 0.00, -0.525, 0.525, -0.270, 0.270, 30.700, 0.40],
  ["D124", "T", -28.256, 3.720, -97.00, -1.100, 1.100, -1.000, 1.000, 30.700, 0.90],
  ["C118", "T", -15.767, 20.548, -142.00, -0.500, 0.500, -0.250, 0.250, 30.700, 0.55],
  ["C103", "T", 25.017, 6.703, 105.00, -0.500, 0.500, -0.250, 0.250, 30.700, 0.55],
  ["D103", "T", 27.529, 7.376, 105.00, -1.100, 1.100, -1.000, 1.000, 30.700, 0.90],
  ["R27", "T", 5.480, -19.879, 90.00, -0.525, 0.525, -0.270, 0.270, 30.700, 0.40],
  ["D126", "T", -28.256, -3.720, -82.00, -1.100, 1.100, -1.000, 1.000, 30.700, 0.90],
  ["D129", "T", -24.682, -14.250, -60.00, -1.100, 1.100, -1.000, 1.000, 30.700, 0.90],
  ["D132", "T", -17.350, -22.611, -37.00, -1.100, 1.100, -1.000, 1.000, 30.700, 0.90],
  ["R55", "T", -10.546, 2.112, 0.00, -0.525, 0.525, -0.270, 0.270, 30.700, 0.40],
  ["R42", "T", 23.599, -4.806, 0.00, -0.525, 0.525, -0.270, 0.270, 30.700, 0.40],
  ["D131", "T", -20.153, -20.153, -45.00, -1.100, 1.100, -1.000, 1.000, 30.700, 0.90],
  ["C124", "T", -25.678, 3.381, -97.00, -0.500, 0.500, -0.250, 0.250, 30.700, 0.55],
  ["C110", "T", 9.912, 23.928, 158.00, -0.500, 0.500, -0.250, 0.250, 30.700, 0.55],
  ["C135", "T", -6.703, -25.017, -15.00, -0.500, 0.500, -0.250, 0.250, 30.700, 0.55],
  ["C8", "T", 19.493, 5.021, 90.00, -1.000, 1.000, -0.625, 0.625, 30.700, 1.45],
  ["R50", "T", -9.591, -2.198, 90.00, -0.525, 0.525, -0.270, 0.270, 30.700, 0.40],
  ["D127", "T", -27.529, -7.376, -75.00, -1.100, 1.100, -1.000, 1.000, 30.700, 0.90],
  ["D108", "T", 17.350, 22.611, 143.00, -1.100, 1.100, -1.000, 1.000, 30.700, 0.90],
  ["D122", "T", -26.331, 10.906, -112.00, -1.100, 1.100, -1.000, 1.000, 30.700, 0.90],
  ["C4", "T", 16.808, 11.340, 0.00, -0.500, 0.500, -0.250, 0.250, 30.700, 0.55],
  ["D142", "T", 17.350, -22.611, 38.00, -1.100, 1.100, -1.000, 1.000, 30.700, 0.90],
  ["R41", "T", 23.243, -2.711, 0.00, -0.525, 0.525, -0.270, 0.270, 30.700, 0.40],
  ["C112", "T", 3.381, 25.678, 173.00, -0.500, 0.500, -0.250, 0.250, 30.700, 0.55],
  ["C9", "T", 19.026, 1.250, 90.00, -1.000, 1.000, -0.625, 0.625, 30.700, 1.45],
  ["D130", "T", -22.611, -17.350, -52.00, -1.100, 1.100, -1.000, 1.000, 30.700, 0.90],
  ["C30", "T", -11.623, -10.621, 90.00, -1.000, 1.000, -0.625, 0.625, 30.700, 1.45],
  ["C147", "T", 25.017, -6.703, 75.00, -0.500, 0.500, -0.250, 0.250, 30.700, 0.55],
  ["C130", "T", -20.548, -15.767, -52.00, -0.500, 0.500, -0.250, 0.250, 30.700, 0.55],
  ["C120", "T", -20.548, 15.767, -127.00, -0.500, 0.500, -0.250, 0.250, 30.700, 0.55],
  ["C148", "T", 25.678, -3.381, 83.00, -0.500, 0.500, -0.250, 0.250, 30.700, 0.55],
  ["D136", "T", -3.720, -28.256, -7.00, -1.100, 1.100, -1.000, 1.000, 30.700, 0.90],
  ["C129", "T", -22.430, -12.950, -60.00, -0.500, 0.500, -0.250, 0.250, 30.700, 0.55],
  ["D120", "T", -22.611, 17.350, -127.00, -1.100, 1.100, -1.000, 1.000, 30.700, 0.90],
  ["D107", "T", 20.153, 20.153, 135.00, -1.100, 1.100, -1.000, 1.000, 30.700, 0.90],
  ["C128", "T", -23.928, -9.912, -67.00, -0.500, 0.500, -0.250, 0.250, 30.700, 0.55],
  ["C33", "T", -4.320, -6.982, 0.00, -0.500, 0.500, -0.250, 0.250, 30.700, 0.55],
  ["D138", "T", 3.720, -28.256, 8.00, -1.100, 1.100, -1.000, 1.000, 30.700, 0.90],
  ["R54", "T", -16.236, -2.146, 0.00, -0.525, 0.525, -0.270, 0.270, 30.700, 0.40],
  ["C145", "T", 22.430, -12.950, 60.00, -0.500, 0.500, -0.250, 0.250, 30.700, 0.55],
  ["U2", "T", 14.606, 4.071, 0.00, -0.800, 0.800, -1.450, 1.450, 30.700, 1.45],
  ["C144", "T", 20.548, -15.767, 53.00, -0.500, 0.500, -0.250, 0.250, 30.700, 0.55],
  ["C6", "T", 11.441, 4.045, 90.00, -0.800, 0.800, -0.400, 0.400, 30.700, 0.90],
  ["J20", "T", 0.000, -9.500, 0.00, -9.700, 9.700, -5.700, -0.350, 30.700, 2.00],
  ["D145", "T", 24.682, -14.250, 60.00, -1.100, 1.100, -1.000, 1.000, 30.700, 0.90],
  ["C102", "T", 25.678, 3.381, 98.00, -0.500, 0.500, -0.250, 0.250, 30.700, 0.55],
  ["C146", "T", 23.928, -9.912, 68.00, -0.500, 0.500, -0.250, 0.250, 30.700, 0.55],
  ["D143", "T", 20.153, -20.153, 45.00, -1.100, 1.100, -1.000, 1.000, 30.700, 0.90],
  ["U42", "T", 0.000, 21.500, 0.00, -0.650, 0.650, -1.450, 1.450, 30.700, 1.15],
  ["C109", "T", 12.950, 22.430, 150.00, -0.500, 0.500, -0.250, 0.250, 30.700, 0.55],
  ["D139", "T", 7.376, -27.529, 15.00, -1.100, 1.100, -1.000, 1.000, 30.700, 0.90],
  ["C141", "T", 12.950, -22.430, 30.00, -0.500, 0.500, -0.250, 0.250, 30.700, 0.55],
  ["C134", "T", -9.912, -23.928, -22.00, -0.500, 0.500, -0.250, 0.250, 30.700, 0.55],
  ["C127", "T", -25.017, -6.703, -75.00, -0.500, 0.500, -0.250, 0.250, 30.700, 0.55],
  ["U21", "T", 13.355, 11.969, 0.00, -0.800, 0.800, -1.450, 1.450, 30.700, 1.45],
  ["C43", "T", 22.037, 3.052, 0.00, -0.500, 0.500, -0.250, 0.250, 30.700, 0.55],
  ["D110", "T", 10.906, 26.331, 158.00, -1.100, 1.100, -1.000, 1.000, 30.700, 0.90],
  ["D20", "T", 10.142, -5.451, 90.00, -0.650, 0.650, -1.450, 1.450, 30.700, 1.15],
  ["C131", "T", -18.314, -18.314, -45.00, -0.500, 0.500, -0.250, 0.250, 30.700, 0.55],
  ["D106", "T", 22.611, 17.350, 128.00, -1.100, 1.100, -1.000, 1.000, 30.700, 0.90],
  ["D118", "T", -17.350, 22.611, -142.00, -1.100, 1.100, -1.000, 1.000, 30.700, 0.90],
  ["C123", "T", -25.017, 6.703, -105.00, -0.500, 0.500, -0.250, 0.250, 30.700, 0.55],
  ["D116", "T", -10.906, 26.331, -157.00, -1.100, 1.100, -1.000, 1.000, 30.700, 0.90],
  ["R3", "T", 14.153, 1.510, 0.00, -0.525, 0.525, -0.270, 0.270, 30.700, 0.40],
  ["R51", "T", -12.585, -0.074, 0.00, -0.525, 0.525, -0.270, 0.270, 30.700, 0.40],
  ["D134", "T", -10.906, -26.331, -22.00, -1.100, 1.100, -1.000, 1.000, 30.700, 0.90],
  ["R21", "T", 3.123, -7.003, 0.00, -0.525, 0.525, -0.270, 0.270, 30.700, 0.40],
  ["C113", "T", 0.000, 25.900, 180.00, -0.500, 0.500, -0.250, 0.250, 30.700, 0.55],
  ["R20", "T", 5.357, -6.804, 0.00, -0.525, 0.525, -0.270, 0.270, 30.700, 0.40],
  ["C119", "T", -18.314, 18.314, -135.00, -0.500, 0.500, -0.250, 0.250, 30.700, 0.55],
  ["C138", "T", 3.381, -25.678, 8.00, -0.500, 0.500, -0.250, 0.250, 30.700, 0.55],
  ["C125", "T", -25.900, 0.000, -90.00, -0.500, 0.500, -0.250, 0.250, 30.700, 0.55],
  ["C34", "T", 11.203, -8.748, 90.00, -0.500, 0.500, -0.250, 0.250, 30.700, 0.55],
  ["D137", "T", 0.000, -28.500, 0.00, -1.100, 1.100, -1.000, 1.000, 30.700, 0.90],
  ["D111", "T", 7.376, 27.529, 165.00, -1.100, 1.100, -1.000, 1.000, 30.700, 0.90],
  ["R40", "T", -9.023, -5.166, 90.00, -0.525, 0.525, -0.270, 0.270, 30.700, 0.40],
  ["C35", "T", -0.314, -18.244, 90.00, -1.000, 1.000, -0.625, 0.625, 30.700, 1.45],
  ["R43", "T", 23.967, 3.638, 90.00, -0.525, 0.525, -0.270, 0.270, 30.700, 0.40],
  ["D113", "T", 0.000, 28.500, 180.00, -1.100, 1.100, -1.000, 1.000, 30.700, 0.90],
  ["C108", "T", 15.767, 20.548, 143.00, -0.500, 0.500, -0.250, 0.250, 30.700, 0.55],
  ["C5", "T", -13.674, -6.780, 0.00, -0.500, 0.500, -0.250, 0.250, 30.700, 0.55],
  ["U1", "T", 13.856, 8.000, 0.00, -0.800, 0.800, -1.450, 1.450, 30.700, 1.45],
  ["D121", "T", -24.682, 14.250, -120.00, -1.100, 1.100, -1.000, 1.000, 30.700, 0.90],
  ["D117", "T", -14.250, 24.682, -150.00, -1.100, 1.100, -1.000, 1.000, 30.700, 0.90],
  ["C143", "T", 18.314, -18.314, 45.00, -0.500, 0.500, -0.250, 0.250, 30.700, 0.55],
  ["C2", "T", 10.719, 8.000, 90.00, -0.800, 0.800, -0.400, 0.400, 30.700, 0.90],
  ["C40", "T", 7.918, -21.837, 0.00, -0.500, 0.500, -0.250, 0.250, 30.700, 0.55],
  ["C139", "T", 6.703, -25.017, 15.00, -0.500, 0.500, -0.250, 0.250, 30.700, 0.55],
  ["C105", "T", 22.430, 12.950, 120.00, -0.500, 0.500, -0.250, 0.250, 30.700, 0.55],
  ["D146", "T", 26.331, -10.906, 68.00, -1.100, 1.100, -1.000, 1.000, 30.700, 0.90],
  ["D101", "T", 28.500, 0.000, 90.00, -1.100, 1.100, -1.000, 1.000, 30.700, 0.90],
  ["D140", "T", 10.906, -26.331, 23.00, -1.100, 1.100, -1.000, 1.000, 30.700, 0.90],
  ["R56", "T", -8.167, 0.812, 90.00, -0.525, 0.525, -0.270, 0.270, 30.700, 0.40],
  ["R26", "T", 7.917, -20.526, 0.00, -0.525, 0.525, -0.270, 0.270, 30.700, 0.40],
  ["C133", "T", -12.950, -22.430, -30.00, -0.500, 0.500, -0.250, 0.250, 30.700, 0.55],
  ["C32", "T", -3.969, -17.168, 0.00, -1.600, 1.600, -0.800, 0.800, 30.700, 1.80],
  ["C121", "T", -22.430, 12.950, -120.00, -0.500, 0.500, -0.250, 0.250, 30.700, 0.55],
  ["D123", "T", -27.529, 7.376, -105.00, -1.100, 1.100, -1.000, 1.000, 30.700, 0.90],
  ["C136", "T", -3.381, -25.678, -7.00, -0.500, 0.500, -0.250, 0.250, 30.700, 0.55],
  ["C137", "T", 0.000, -25.900, 0.00, -0.500, 0.500, -0.250, 0.250, 30.700, 0.55],
  ["D133", "T", -14.250, -24.682, -30.00, -1.100, 1.100, -1.000, 1.000, 30.700, 0.90],
  ["C140", "T", 9.912, -23.928, 23.00, -0.500, 0.500, -0.250, 0.250, 30.700, 0.55],
  ["R22", "T", -0.540, -6.202, 0.00, -1.600, 1.600, -0.800, 0.800, 30.700, 0.65],
  ["C101", "T", 25.900, 0.000, 90.00, -0.500, 0.500, -0.250, 0.250, 30.700, 0.55],
  ["C111", "T", 6.703, 25.017, 165.00, -0.500, 0.500, -0.250, 0.250, 30.700, 0.55],
  ["D115", "T", -7.376, 27.529, -165.00, -1.100, 1.100, -1.000, 1.000, 30.700, 0.90],
  ["R52", "T", -10.803, 0.349, 90.00, -0.525, 0.525, -0.270, 0.270, 30.700, 0.40],
  ["C52", "T", -14.341, -2.198, 90.00, -0.500, 0.500, -0.250, 0.250, 30.700, 0.55],
  ["D102", "T", 28.256, 3.720, 98.00, -1.100, 1.100, -1.000, 1.000, 30.700, 0.90],
  ["C36", "T", 1.928, -19.312, 0.00, -0.500, 0.500, -0.250, 0.250, 30.700, 0.55],
  ["D147", "T", 27.529, -7.376, 75.00, -1.100, 1.100, -1.000, 1.000, 30.700, 0.90],
  ["R4", "T", 17.493, 4.546, 90.00, -0.525, 0.525, -0.270, 0.270, 30.700, 0.40],
  ["U43", "T", 23.051, 0.166, 90.00, -0.800, 0.800, -1.450, 1.450, 30.700, 1.45],
  ["C122", "T", -23.928, 9.912, -112.00, -0.500, 0.500, -0.250, 0.250, 30.700, 0.55],
  ["U20", "T", 8.370, -17.966, 0.00, -0.800, 0.800, -1.450, 1.450, 30.700, 1.45],
  ["C39", "T", -13.983, -10.000, 90.00, -1.000, 1.000, -0.625, 0.625, 30.700, 1.45],
  ["C41", "T", 12.908, 16.350, 0.00, -0.800, 0.800, -0.400, 0.400, 30.700, 0.90],
  ["R11", "T", -11.002, -20.564, 0.00, -0.525, 0.525, -0.270, 0.270, 30.700, 0.40],
  ["C132", "T", -15.767, -20.548, -37.00, -0.500, 0.500, -0.250, 0.250, 30.700, 0.55],
  ["D148", "T", 28.256, -3.720, 83.00, -1.100, 1.100, -1.000, 1.000, 30.700, 0.90],
  ["C114", "T", -3.381, 25.678, -172.00, -0.500, 0.500, -0.250, 0.250, 30.700, 0.55],
  ["C75", "T", -1.502, 24.106, 0.00, -0.500, 0.500, -0.250, 0.250, 30.700, 0.55],
  ["D104", "T", 26.331, 10.906, 113.00, -1.100, 1.100, -1.000, 1.000, 30.700, 0.90],
  ["D112", "T", 3.720, 28.256, 173.00, -1.100, 1.100, -1.000, 1.000, 30.700, 0.90],
  ["J11", "T", -15.978, -14.386, 132.00, -1.700, 1.700, -1.100, 1.100, 30.700, 0.35],
  ["R25", "T", 10.472, 10.891, 90.00, -0.525, 0.525, -0.270, 0.270, 30.700, 0.40],
  ["C3", "T", 16.994, 8.950, 90.00, -0.800, 0.800, -0.400, 0.400, 30.700, 0.90],
  ["C126", "T", -25.678, -3.381, -82.00, -0.500, 0.500, -0.250, 0.250, 30.700, 0.55],
  ["C10", "B", -2.631, -10.103, 90.00, -0.800, 0.800, -0.400, 0.400, 28.200, 0.90],
  ["C73", "B", -17.041, 6.036, 0.00, -0.500, 0.500, -0.250, 0.250, 28.550, 0.55],
  ["U12", "B", -4.038, -13.993, 0.00, -0.800, 0.800, -1.450, 1.450, 27.650, 1.45],
  ["C71", "B", -14.620, 1.690, 0.00, -0.500, 0.500, -0.250, 0.250, 28.550, 0.55],
  ["C51", "B", 4.635, -26.307, 0.00, -0.500, 0.500, -0.250, 0.250, 28.550, 0.55],
  ["C12", "B", -0.901, -13.993, 90.00, -0.800, 0.800, -0.400, 0.400, 28.200, 0.90],
  ["C72", "B", -20.522, 2.941, 0.00, -0.500, 0.500, -0.250, 0.250, 28.550, 0.55],
  ["U41", "B", -19.888, 5.157, 0.00, -1.000, 1.000, -1.000, 1.000, 28.300, 0.80],
  ["U30", "B", 0.120, -29.400, 0.00, -0.800, 0.800, -1.450, 1.450, 27.650, 1.45],
  ["U11", "B", -2.568, -19.208, 0.00, -2.650, 2.650, -2.650, 2.650, 26.940, 2.16],
  ["U32", "B", 4.826, -28.798, 0.00, -0.500, 0.500, -1.250, 1.250, 28.500, 0.60],
  ["R58", "B", -15.669, -1.629, 90.00, -0.525, 0.525, -0.270, 0.270, 28.700, 0.40],
  ["C74", "B", -18.245, -0.220, 0.00, -1.000, 1.000, -0.625, 0.625, 27.650, 1.45],
  ["C16", "B", -14.052, -19.282, 0.00, -0.500, 0.500, -0.250, 0.250, 28.550, 0.55],
  ["BZ1", "B", 20.398, 8.241, 22.00, -4.500, 4.500, -4.500, 4.500, 27.200, 1.90],
  ["Y1", "B", -11.388, 1.600, 0.00, -1.025, 1.025, -0.600, 0.600, 28.500, 0.60],
  ["R59", "B", 21.272, 1.044, 0.00, -0.525, 0.525, -0.270, 0.270, 28.700, 0.40],
  ["C15", "B", 3.020, -21.113, 90.00, -0.500, 0.500, -0.250, 0.250, 28.550, 0.55],
  ["R57", "B", -7.466, -14.462, 0.00, -0.525, 0.525, -0.270, 0.270, 28.700, 0.40],
  ["J40", "B", -17.063, 18.950, 42.00, -3.000, 3.000, -1.675, 2.575, 26.150, 2.95],
  ["J40_plug", "B", -17.063, 18.950, 42.00, -3.000, 3.000, 2.575, 5.575, 26.150, 2.95],
  ["U40", "B", -16.481, 3.934, 0.00, -1.000, 1.000, -1.000, 1.000, 28.300, 0.80],
  ["C70", "B", -17.115, 1.718, 0.00, -0.500, 0.500, -0.250, 0.250, 28.550, 0.55],
  ["R70", "B", -14.031, 3.684, 90.00, -0.525, 0.525, -0.270, 0.270, 28.700, 0.40],
  ["C13", "B", -14.188, -0.700, 90.00, -0.500, 0.500, -0.250, 0.250, 28.550, 0.55],
  ["C1", "B", 16.989, -18.728, 0.00, -1.000, 1.000, -0.625, 0.625, 27.650, 1.45],
  ["C11", "B", -1.055, -9.670, 90.00, -0.500, 0.500, -0.250, 0.250, 28.550, 0.55],
  ["R10", "B", -2.193, -23.077, 0.00, -0.525, 0.525, -0.270, 0.270, 28.700, 0.40],
  ["C50", "B", 2.961, -24.831, 0.00, -0.500, 0.500, -0.250, 0.250, 28.550, 0.55],
  ["R12", "B", -0.448, -11.496, 0.00, -0.525, 0.525, -0.270, 0.270, 28.700, 0.40],
  ["C17", "B", -11.864, -19.844, 0.00, -0.500, 0.500, -0.250, 0.250, 28.550, 0.55],
  ["U10", "B", -14.171, -9.923, -55.00, -5.250, 5.250, -7.750, 7.750, 26.900, 2.20],
  ["U10_uFL", "B", -19.086, -13.364, 0.00, -1.300, 1.300, -1.300, 1.300, 25.800, 2.50],
  ["J1", "B", 16.888, -9.750, 60.00, -7.000, 7.000, -1.675, 2.575, 26.150, 2.95],
  ["J1_plug", "B", 16.888, -9.750, 60.00, -7.000, 7.000, 2.575, 5.575, 26.150, 2.95],
  ["C14", "B", -9.190, 1.872, 90.00, -0.500, 0.500, -0.250, 0.250, 28.550, 0.55]
];
MAIN_HOLES = [[8.5, 14.722], [5.629, -3.25], [-8.5, 14.722], [-5.629, -3.25], [0.0, 6.5]];
BASE_PARTS = [
  ["D1", "T", 22.000, 0.000, 90.00, -1.400, 1.400, -0.900, 0.900, 11.100, 1.10],
  ["SW1", "T", 0.000, 0.000, 0.00, -3.250, 3.250, -2.550, 2.550, 11.100, 1.50],
  ["U1", "T", -5.047, -18.836, 0.00, -0.520, 0.520, -0.795, 0.795, 11.100, 0.50],
  ["R3", "T", -0.064, 3.624, 0.00, -0.525, 0.525, -0.270, 0.270, 11.100, 0.40],
  ["R1", "T", 25.206, -3.393, 90.00, -0.525, 0.525, -0.270, 0.270, 11.100, 0.40],
  ["R2", "T", 25.253, 3.178, 90.00, -0.525, 0.525, -0.270, 0.270, 11.100, 0.40],
  ["R4", "T", -6.349, -7.665, 0.00, -0.525, 0.525, -0.270, 0.270, 11.100, 0.40],
  ["RT1", "T", -7.517, -2.736, 0.00, -0.525, 0.525, -0.270, 0.270, 11.100, 0.40],
  ["Q1", "T", -7.092, -5.541, 0.00, -0.625, 0.625, -1.000, 1.000, 11.100, 1.10],
  ["C1", "T", -5.348, -16.042, 0.00, -1.000, 1.000, -0.625, 0.625, 11.100, 1.45],
  ["J2", "T", -12.633, -11.375, -50.00, -3.000, 3.000, -2.575, 1.675, 11.100, 2.95],
  ["J2_plug", "T", -12.633, -11.375, -50.00, -3.000, 3.000, -5.575, -2.575, 11.100, 2.95],
  ["U2", "T", 18.772, -0.377, 90.00, -0.800, 0.800, -1.450, 1.450, 11.100, 1.45],
  ["J3", "T", -7.750, 13.423, 30.00, -7.000, 7.000, -2.575, 1.675, 11.100, 2.95],
  ["J3_plug", "T", -7.750, 13.423, 30.00, -7.000, 7.000, -5.575, -2.575, 11.100, 2.95],
  ["J1", "T", 31.350, 0.000, 90.00, -4.470, 4.470, -3.650, 3.650, 11.100, 3.26],
  ["C2", "T", -7.571, -19.010, 90.00, -0.800, 0.800, -0.400, 0.400, 11.100, 0.90],
  ["C3", "T", -2.369, -15.582, 90.00, -0.800, 0.800, -0.400, 0.400, 11.100, 0.90],
  ["C4", "T", -16.469, 11.780, 90.00, -0.800, 0.800, -0.400, 0.400, 11.100, 0.90]
];
BASE_HOLES = [[0.0, -20.0]];
