tyevco/dial-me-spinner/(list of files, cad)

Other CAD files:
hardware/mechanical/stl/cap_ring.stl
hardware/mechanical/stl/lower_spacer.stl
hardware/mechanical/stl/rotor_ring.stl
hardware/mechanical/stl/spindle.stl
hardware/mechanical/stl/spindle_hub.stl
