tyevco/dial-me-spinner/hardware/fab/base/dial-me-spinner-base-bottom.pdf

Id: 1/1 Title: File: dial-me-spinner-base.kicad_pcb Sheet:
