tyevco/dial-me-spinner/hardware/fab/base/dial-me-spinner-base-F_Cu.pdf

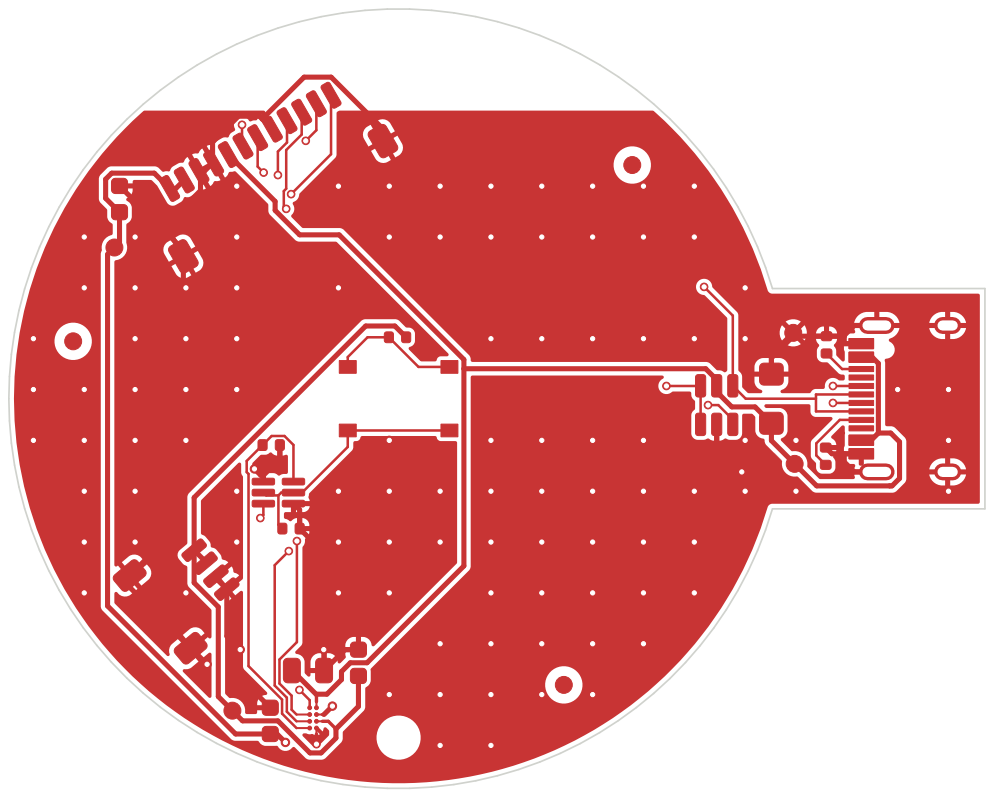
[picture p42: page 1]

Id: 1/1 Title: File: dial-me-spinner-base.kicad_pcb Sheet:
