tyevco/dial-me-spinner/hardware/fab/base/dial-me-spinner-base-schematic.pdf

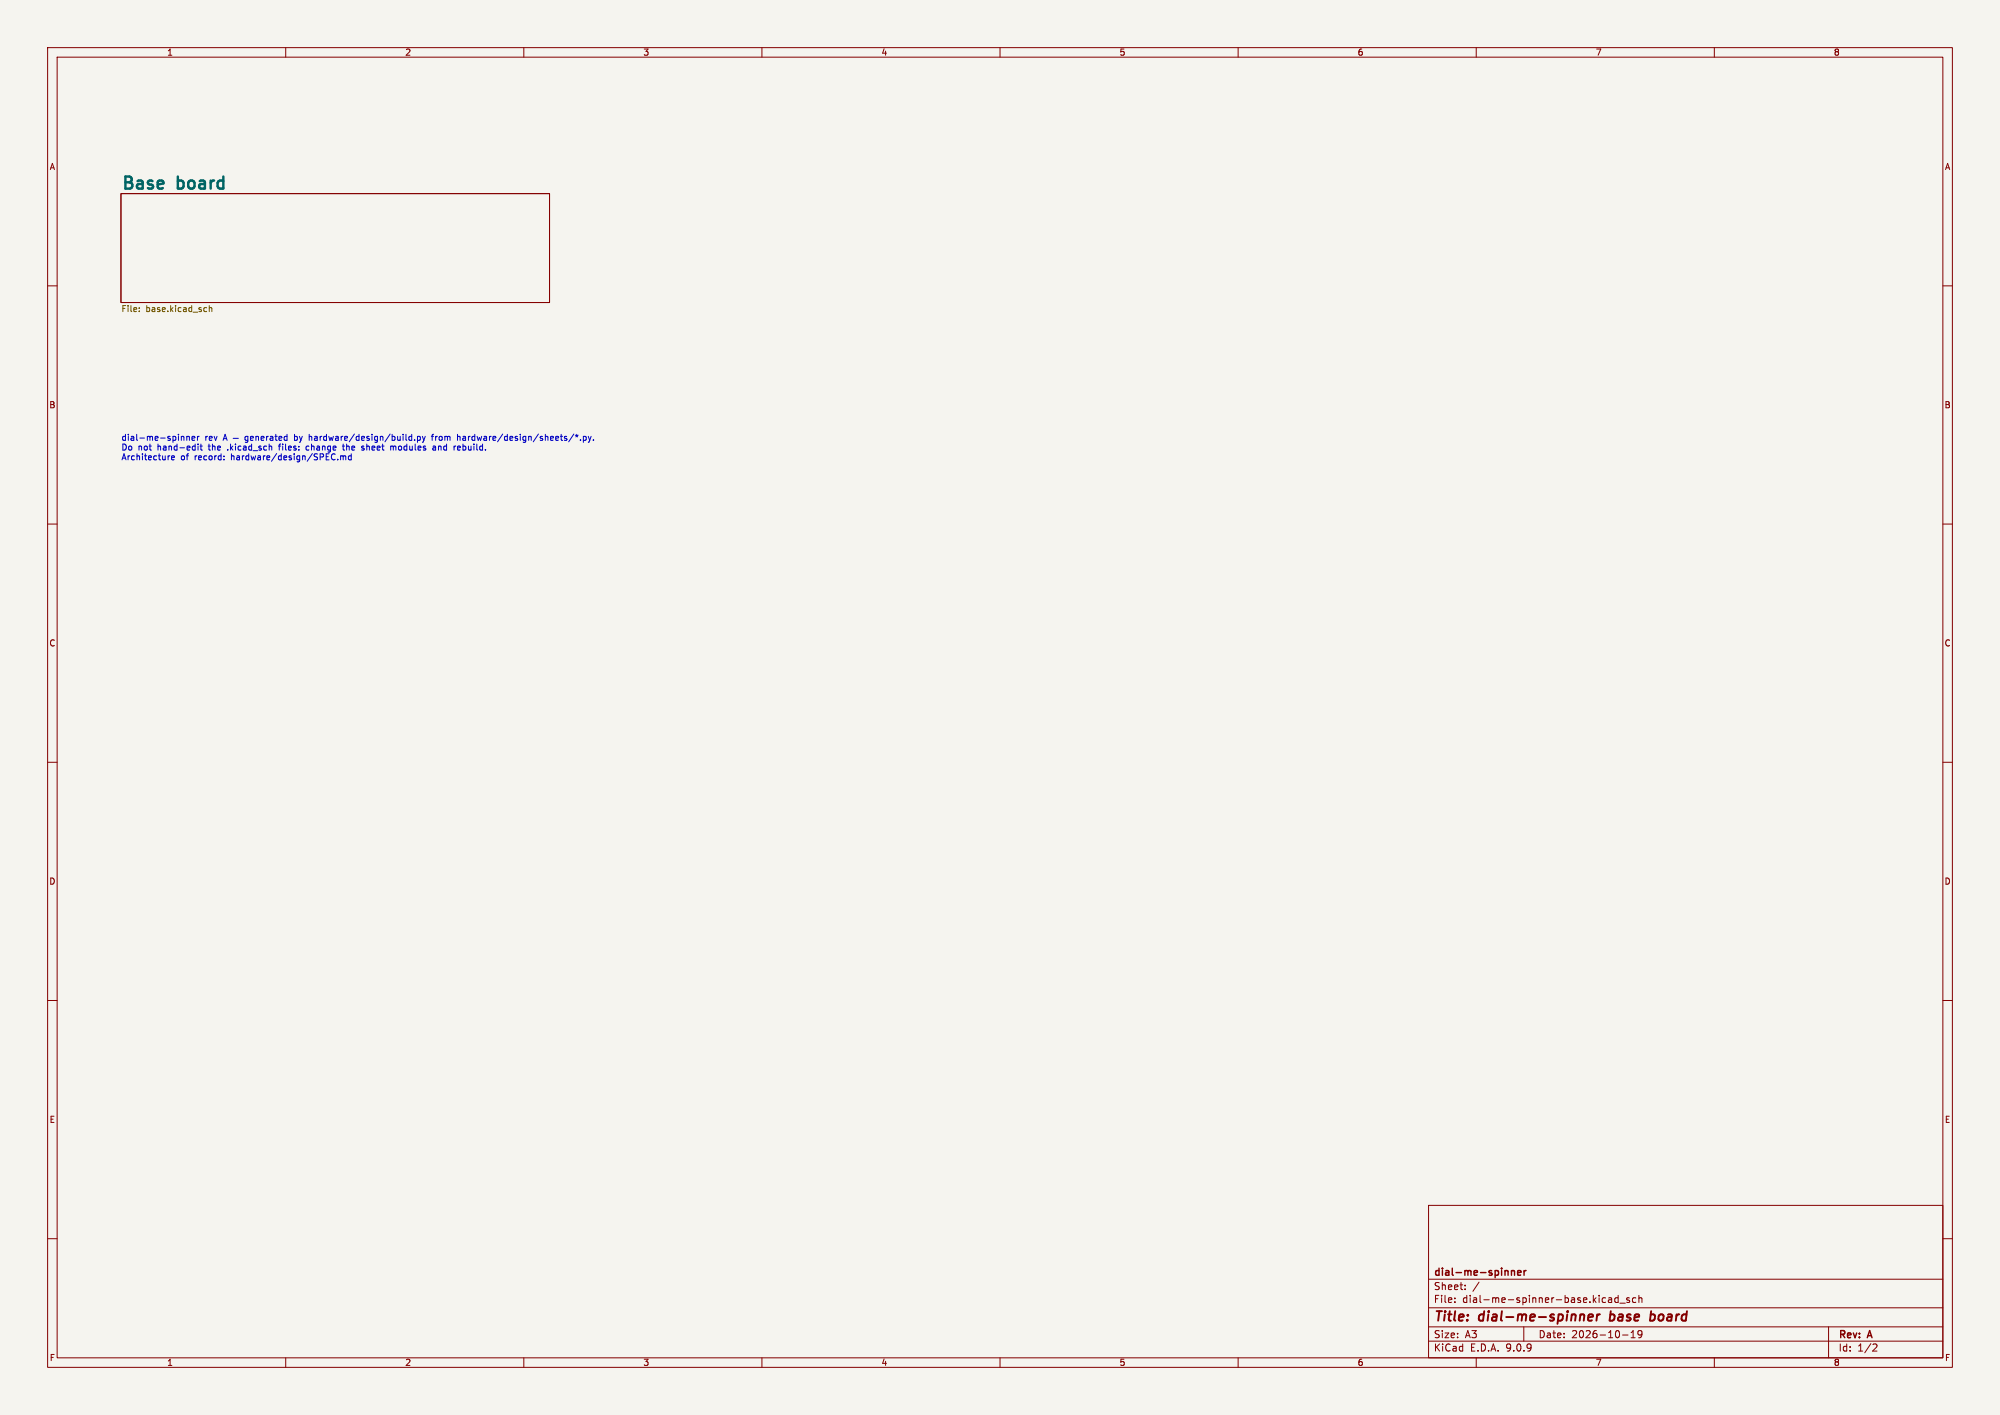
[picture p45: page 1]

File: dial-me-spinner-base.kicad_sch Sheet: / dial-me-spinner

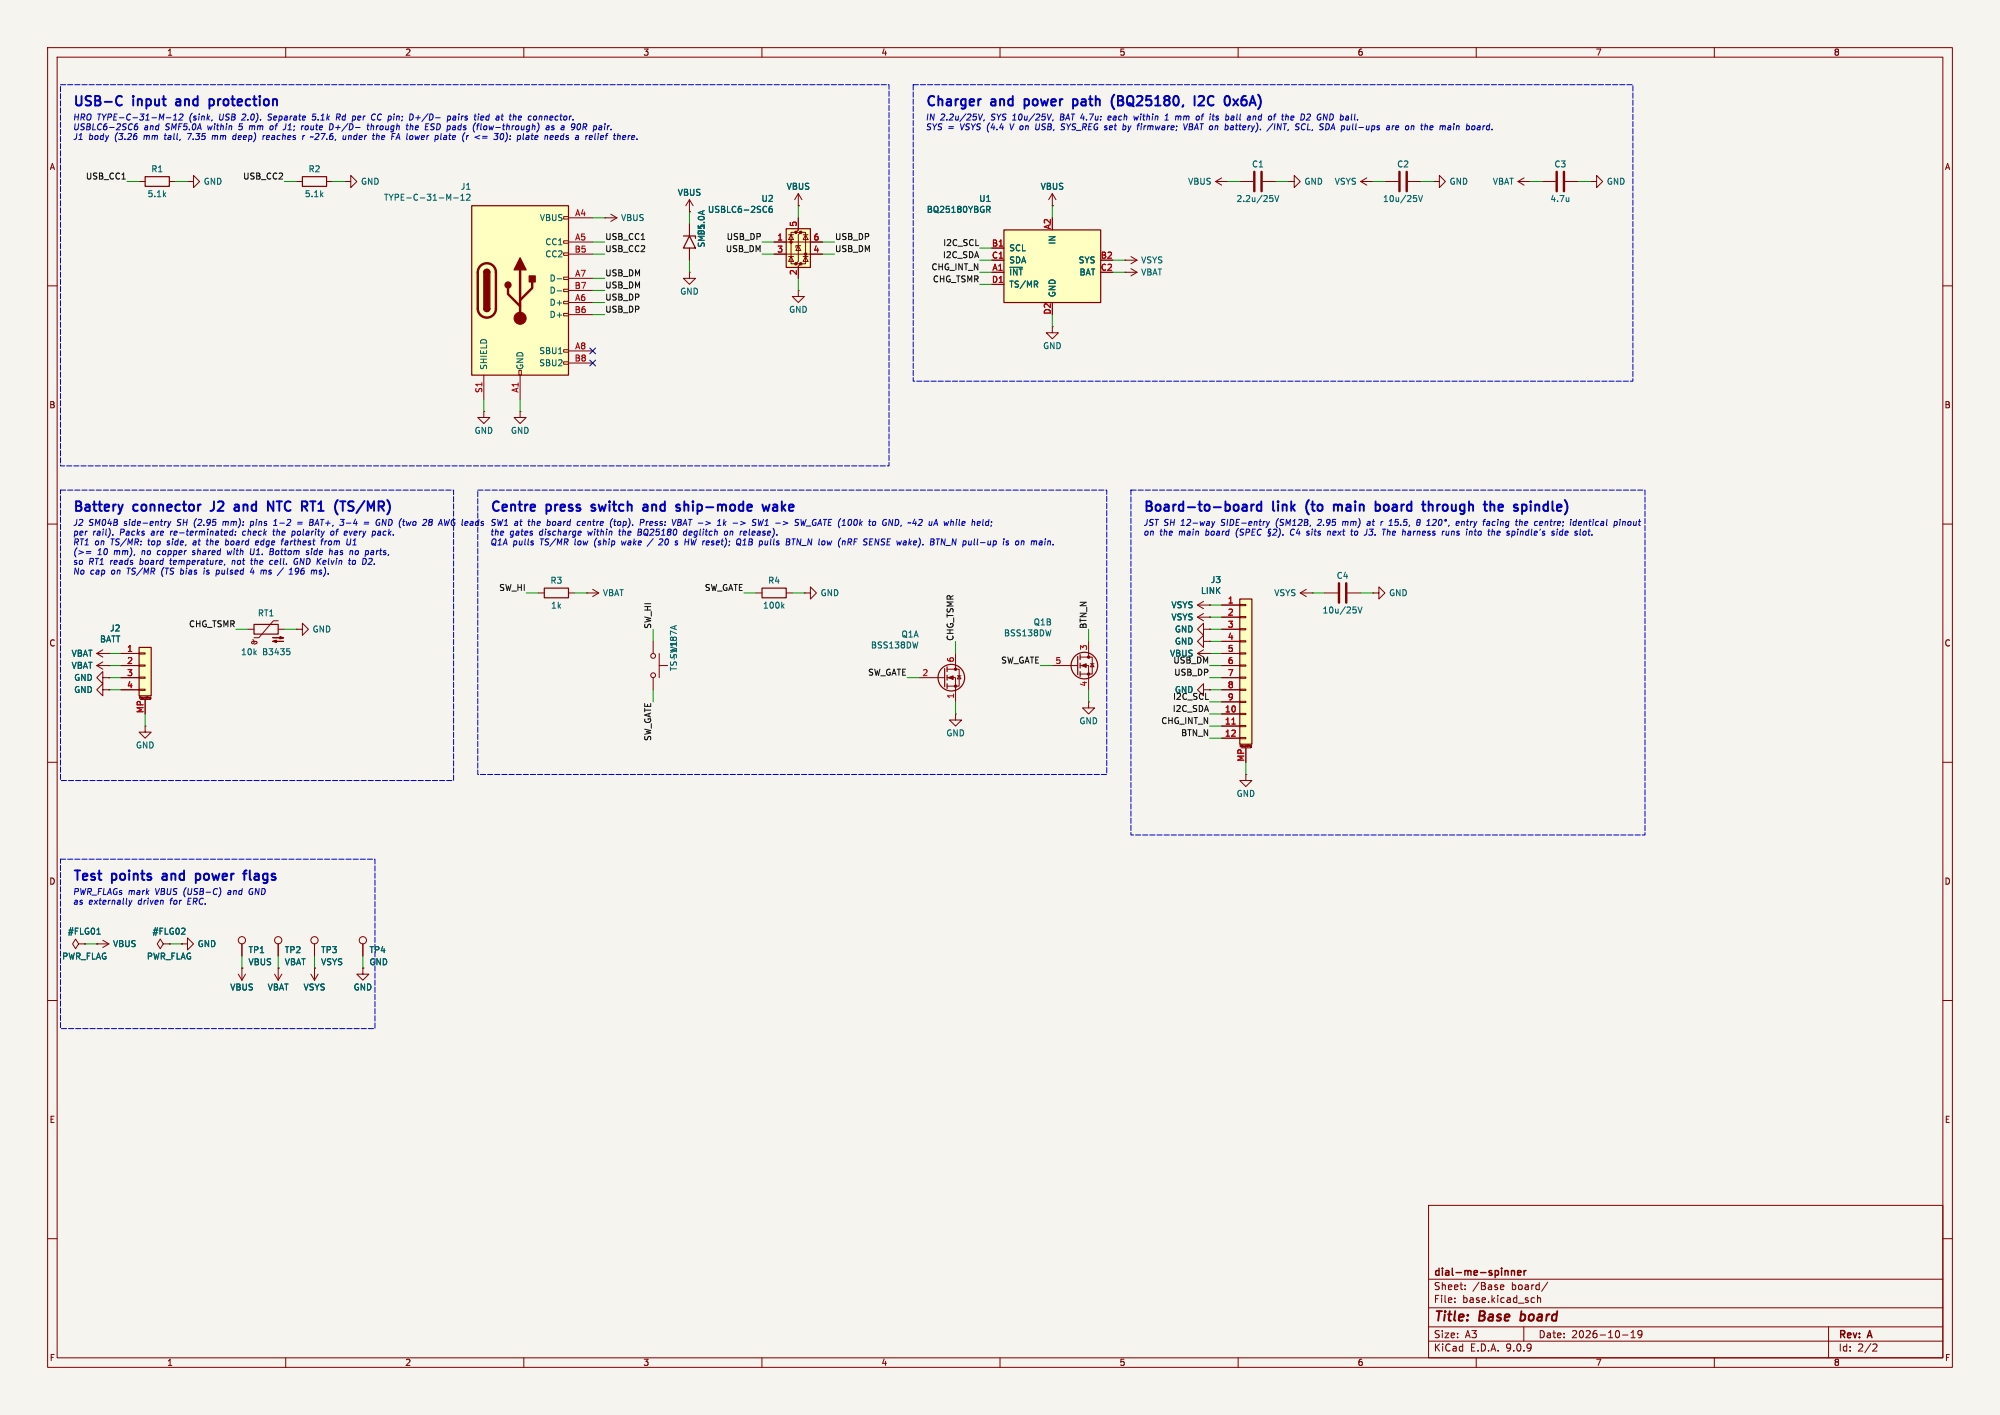
[picture p46: page 2]

Id: 2/2 Title: Base board
