tyevco/dial-me-spinner/hardware/fab/base/dial-me-spinner-base-top.pdf

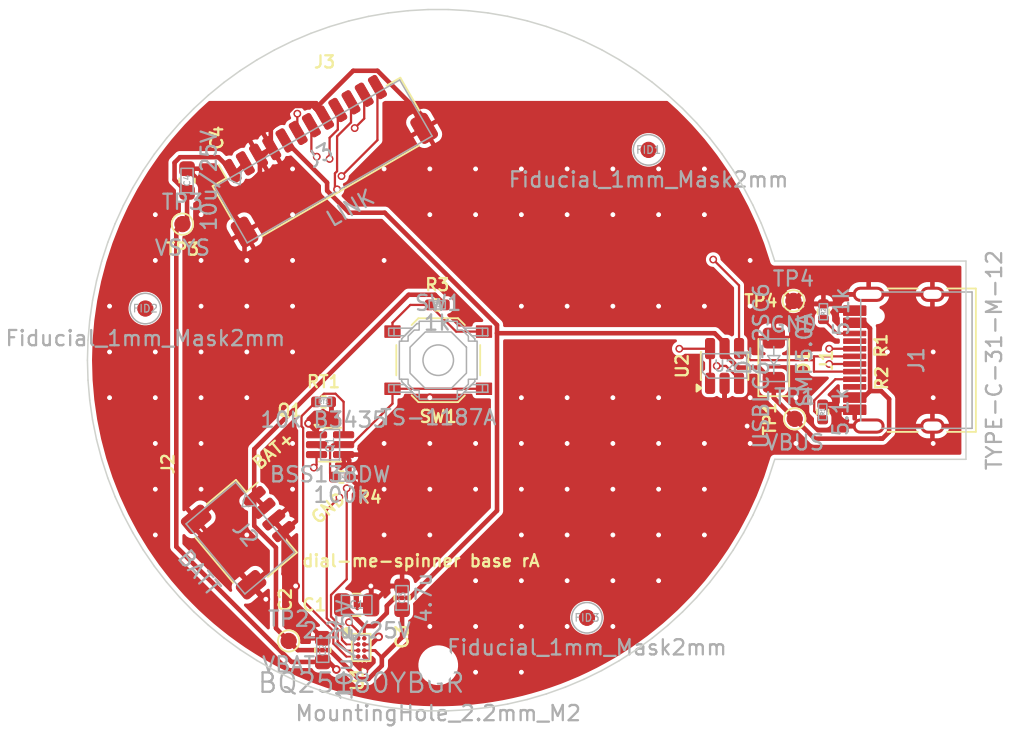
[picture p47: page 1]

Id: 1/1 Title: File: dial-me-spinner-base.kicad_pcb Sheet:
