tyevco/dial-me-spinner/hardware/fab/main/dial-me-spinner-main-bottom.pdf

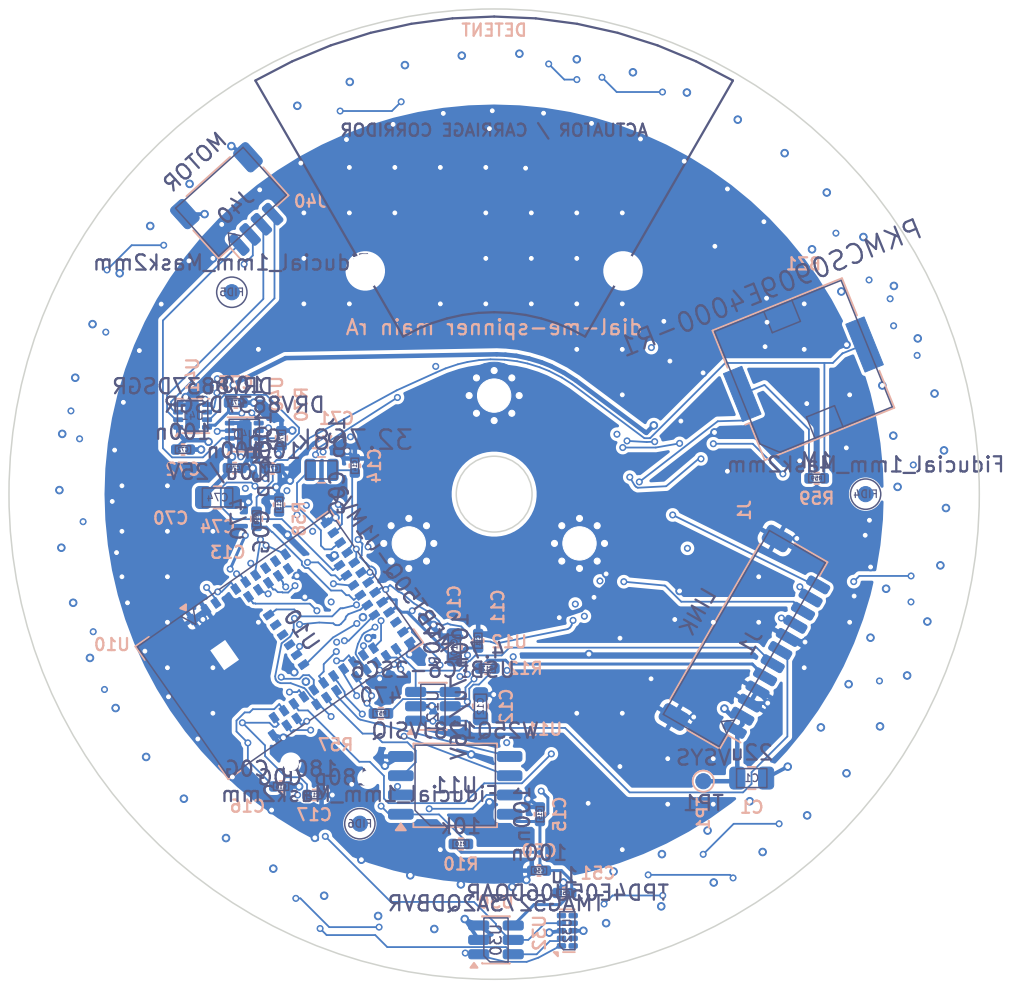
[picture p49: page 1]

rA main dial-me-spinner C10 C73 U12 C71 C51 C12 C72 TP1 U41 U30 U11U32 R58 C74 C16 BZ1 Y1 R59 C15 R57

Id: 1/1 Title: File: dial-me-spinner-main.kicad_pcb Sheet:
