tyevco/dial-me-spinner/hardware/fab/main/dial-me-spinner-main-In1_Cu.pdf

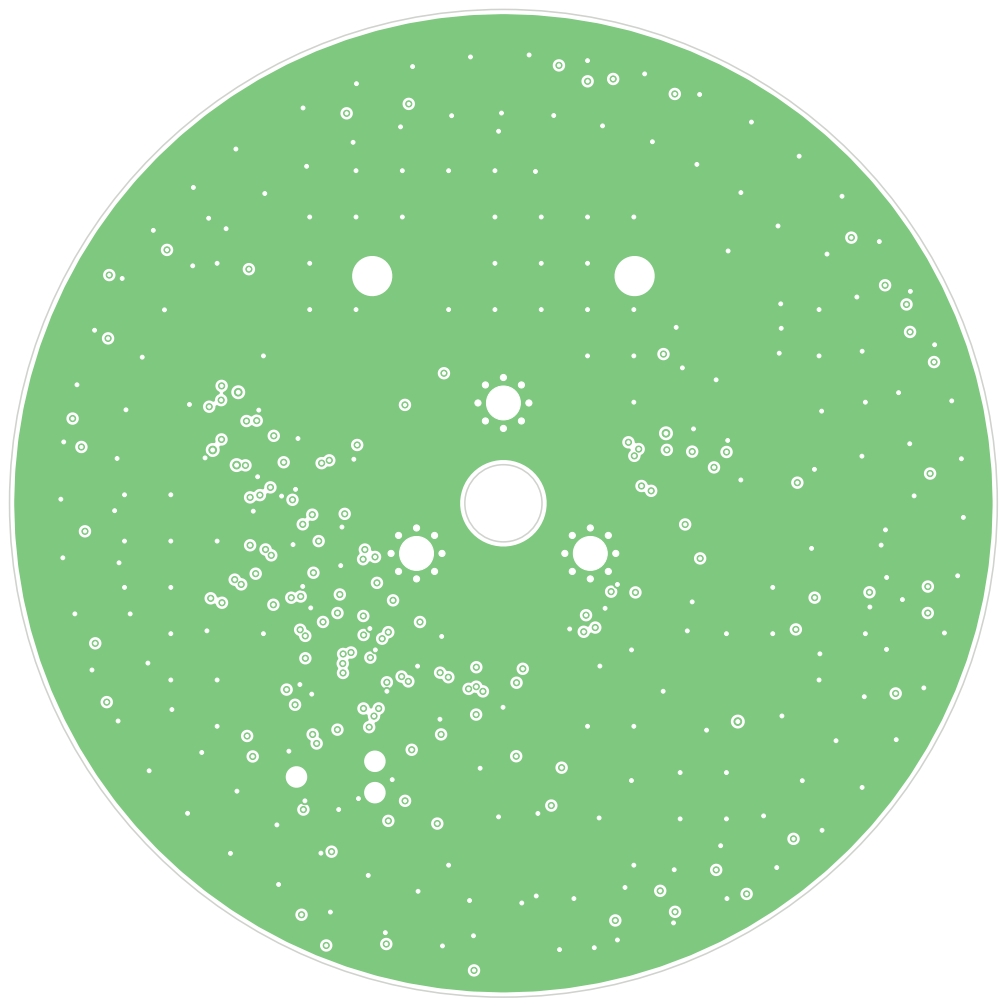
[picture p51: page 1]

Id: 1/1 Title: File: dial-me-spinner-main.kicad_pcb Sheet:
