tyevco/dial-me-spinner/hardware/fab/main/dial-me-spinner-main-In2_Cu.pdf

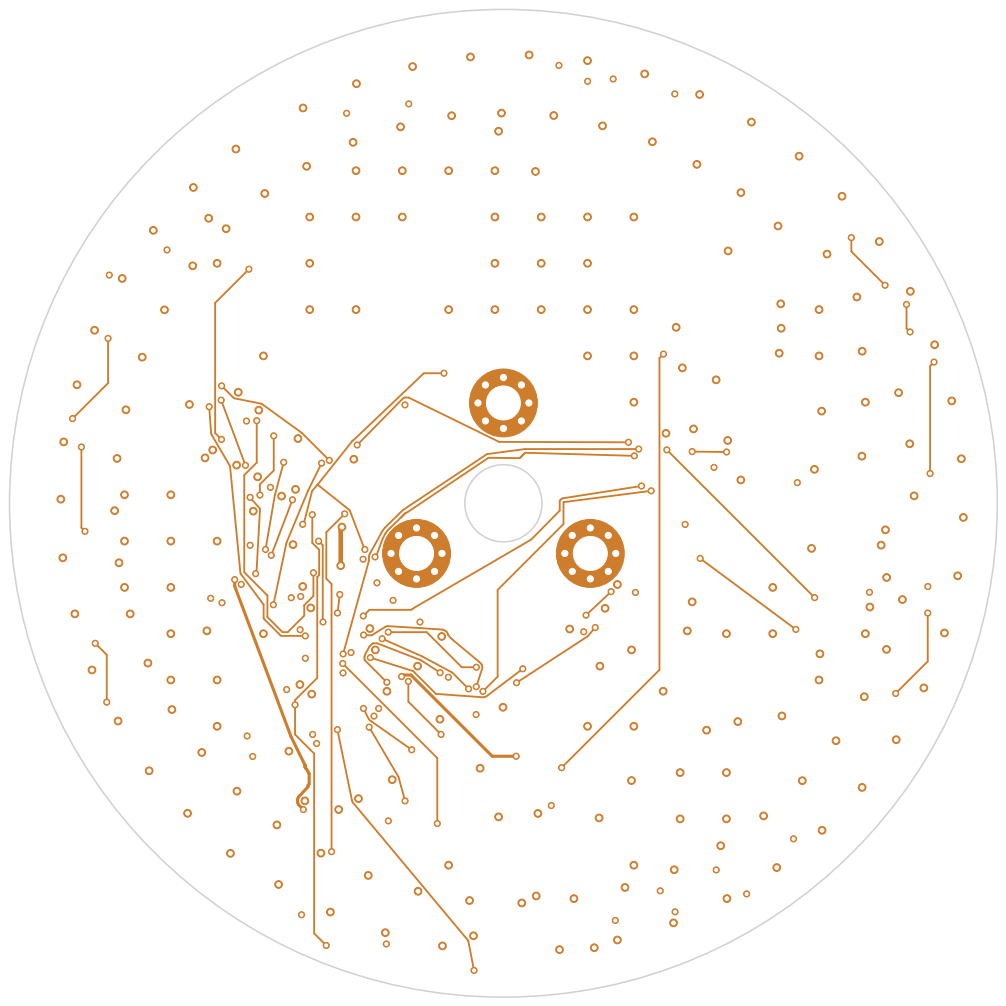
[picture p52: page 1]

Id: 1/1 Title: File: dial-me-spinner-main.kicad_pcb Sheet:
