tyevco/dial-me-spinner/hardware/fab/main/dial-me-spinner-main-schematic.pdf

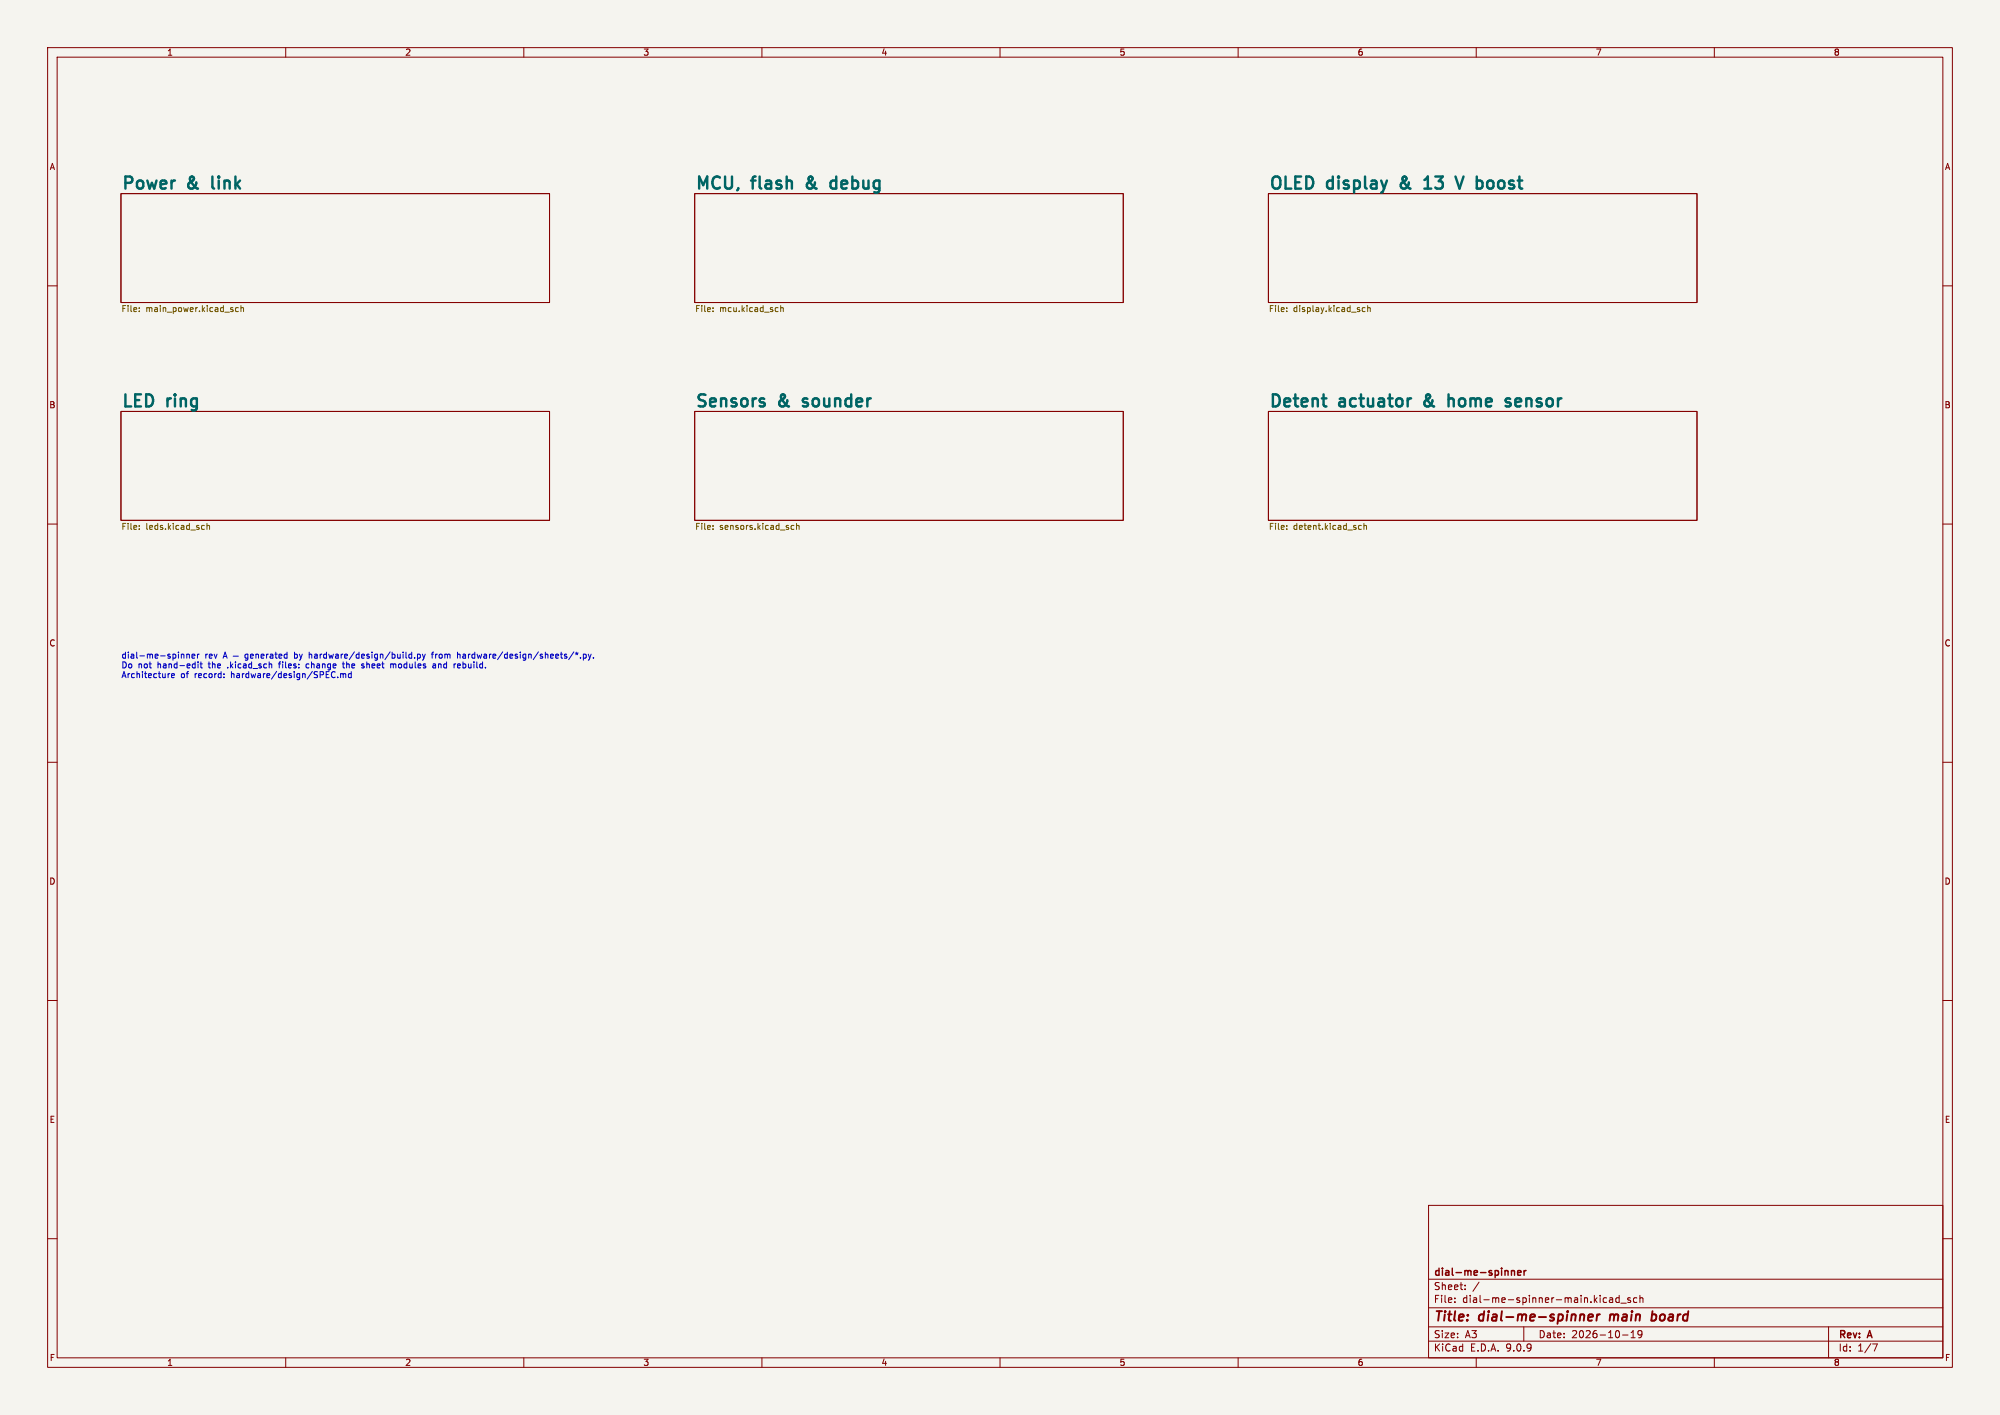
[picture p53: page 1]

File: dial-me-spinner-main.kicad_sch Sheet: / dial-me-spinner

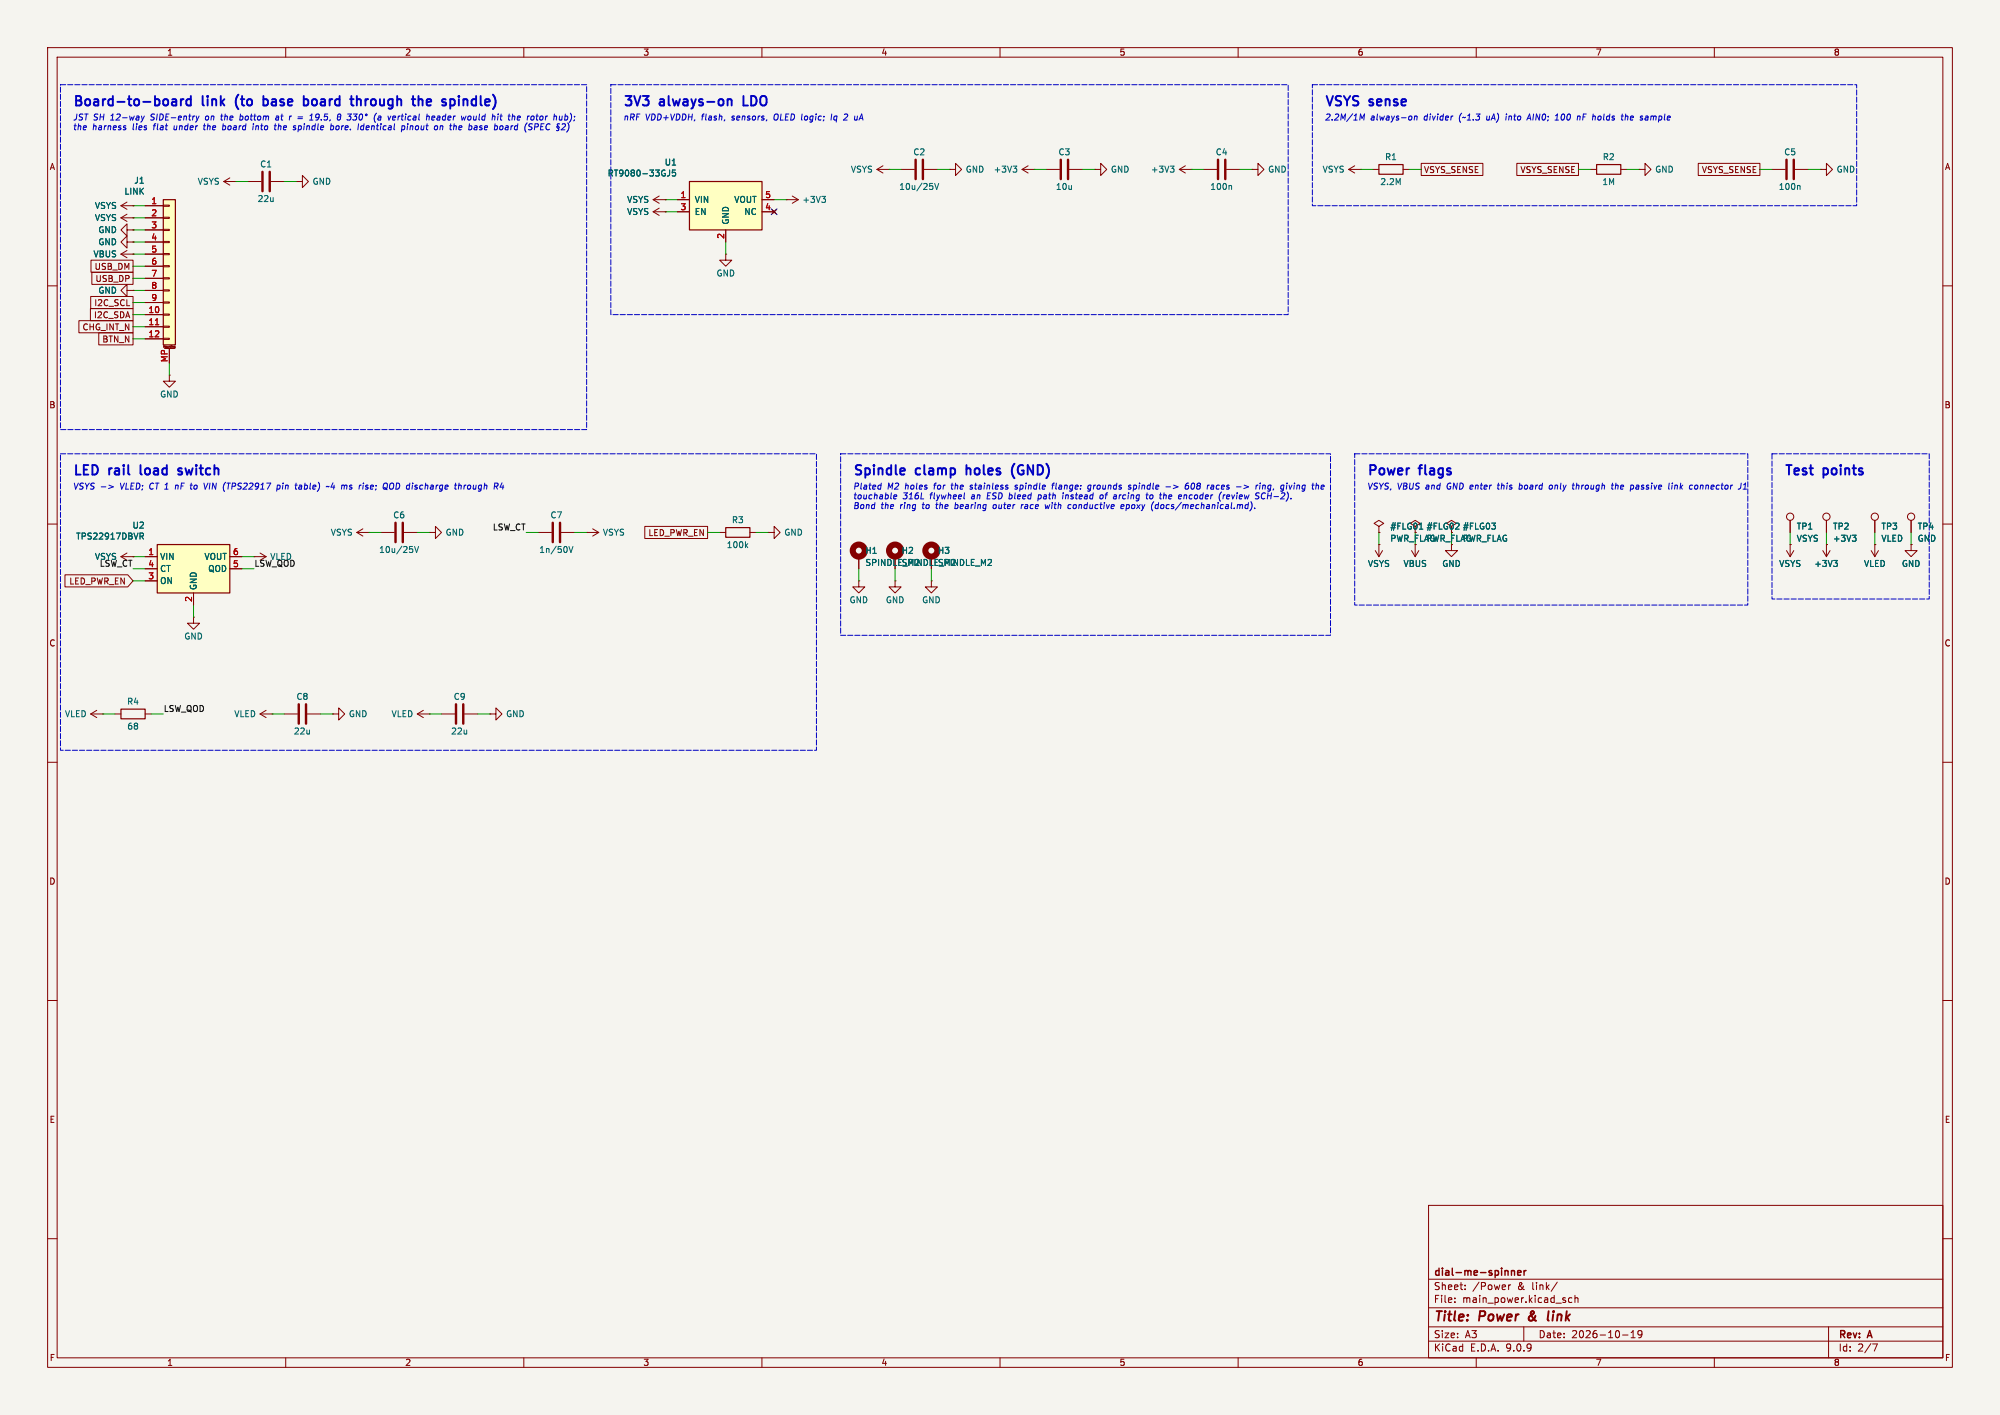
[picture p54: page 2]

2 VOUT 5 NC 4 U1 RT9080-33GJ5 GND GND GND
100n VSYS

Id: 2/7 Title: Power & link

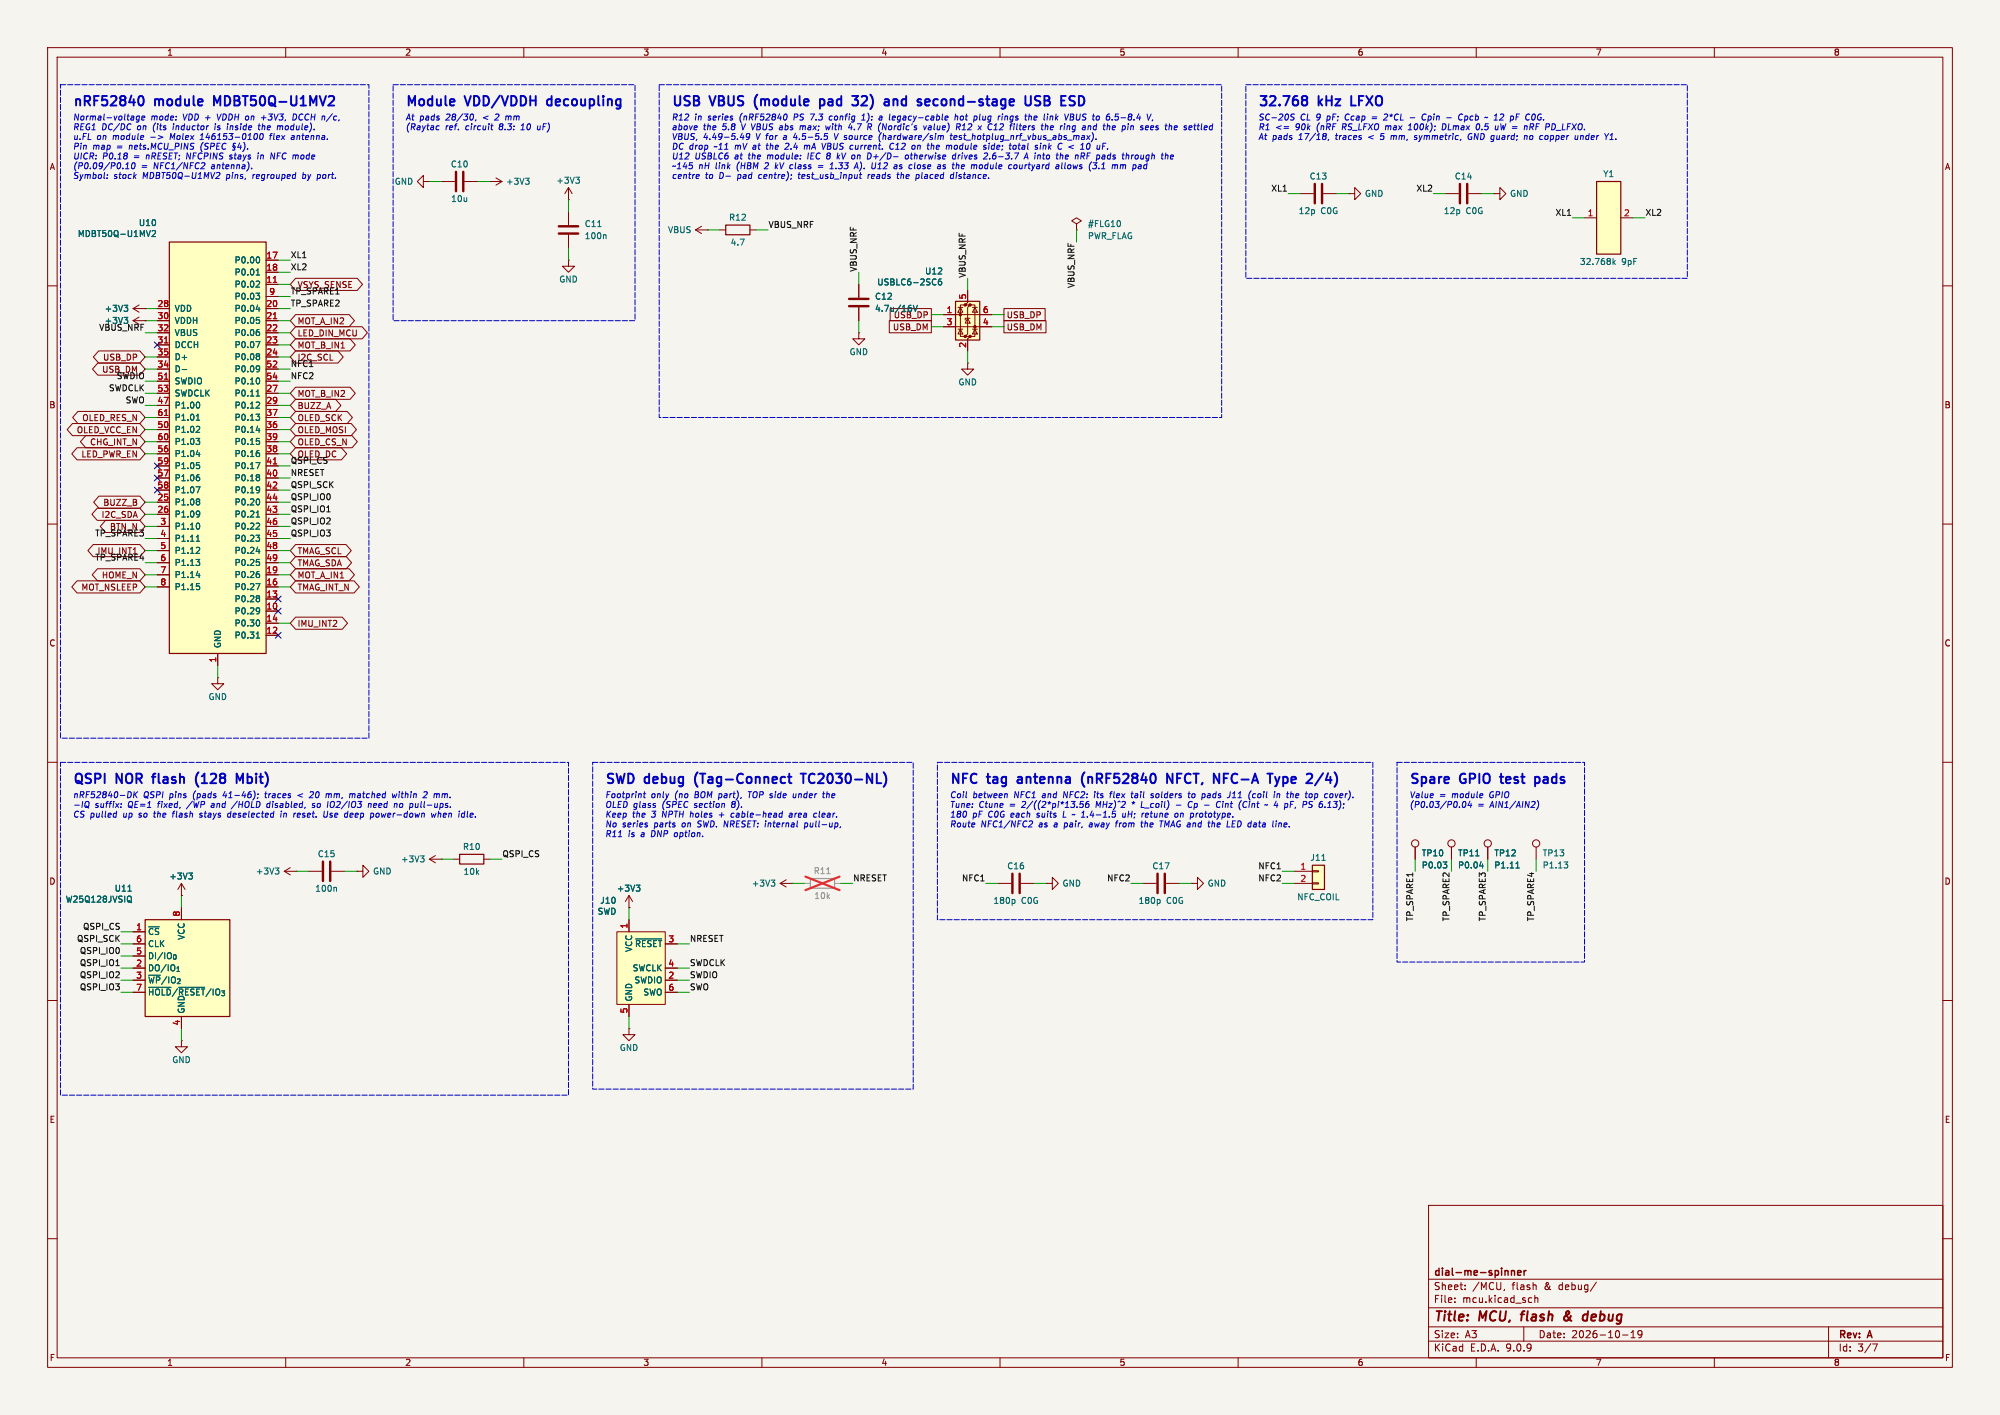
[picture p55: page 3]

Module VDD/VDDH decoupling
(Raytac ref. circuit 8.3: 10 uF)

Spare GPIO test pads
Value = module GPIO

5 ~{RESET}3 SWCLK 4 SWDIO 2 SWO 6 +3V3

5 ~{RESET}3 SWCLK 4 SWDIO 2 SWO 6

Id: 3/7 Title: MCU, flash & debug

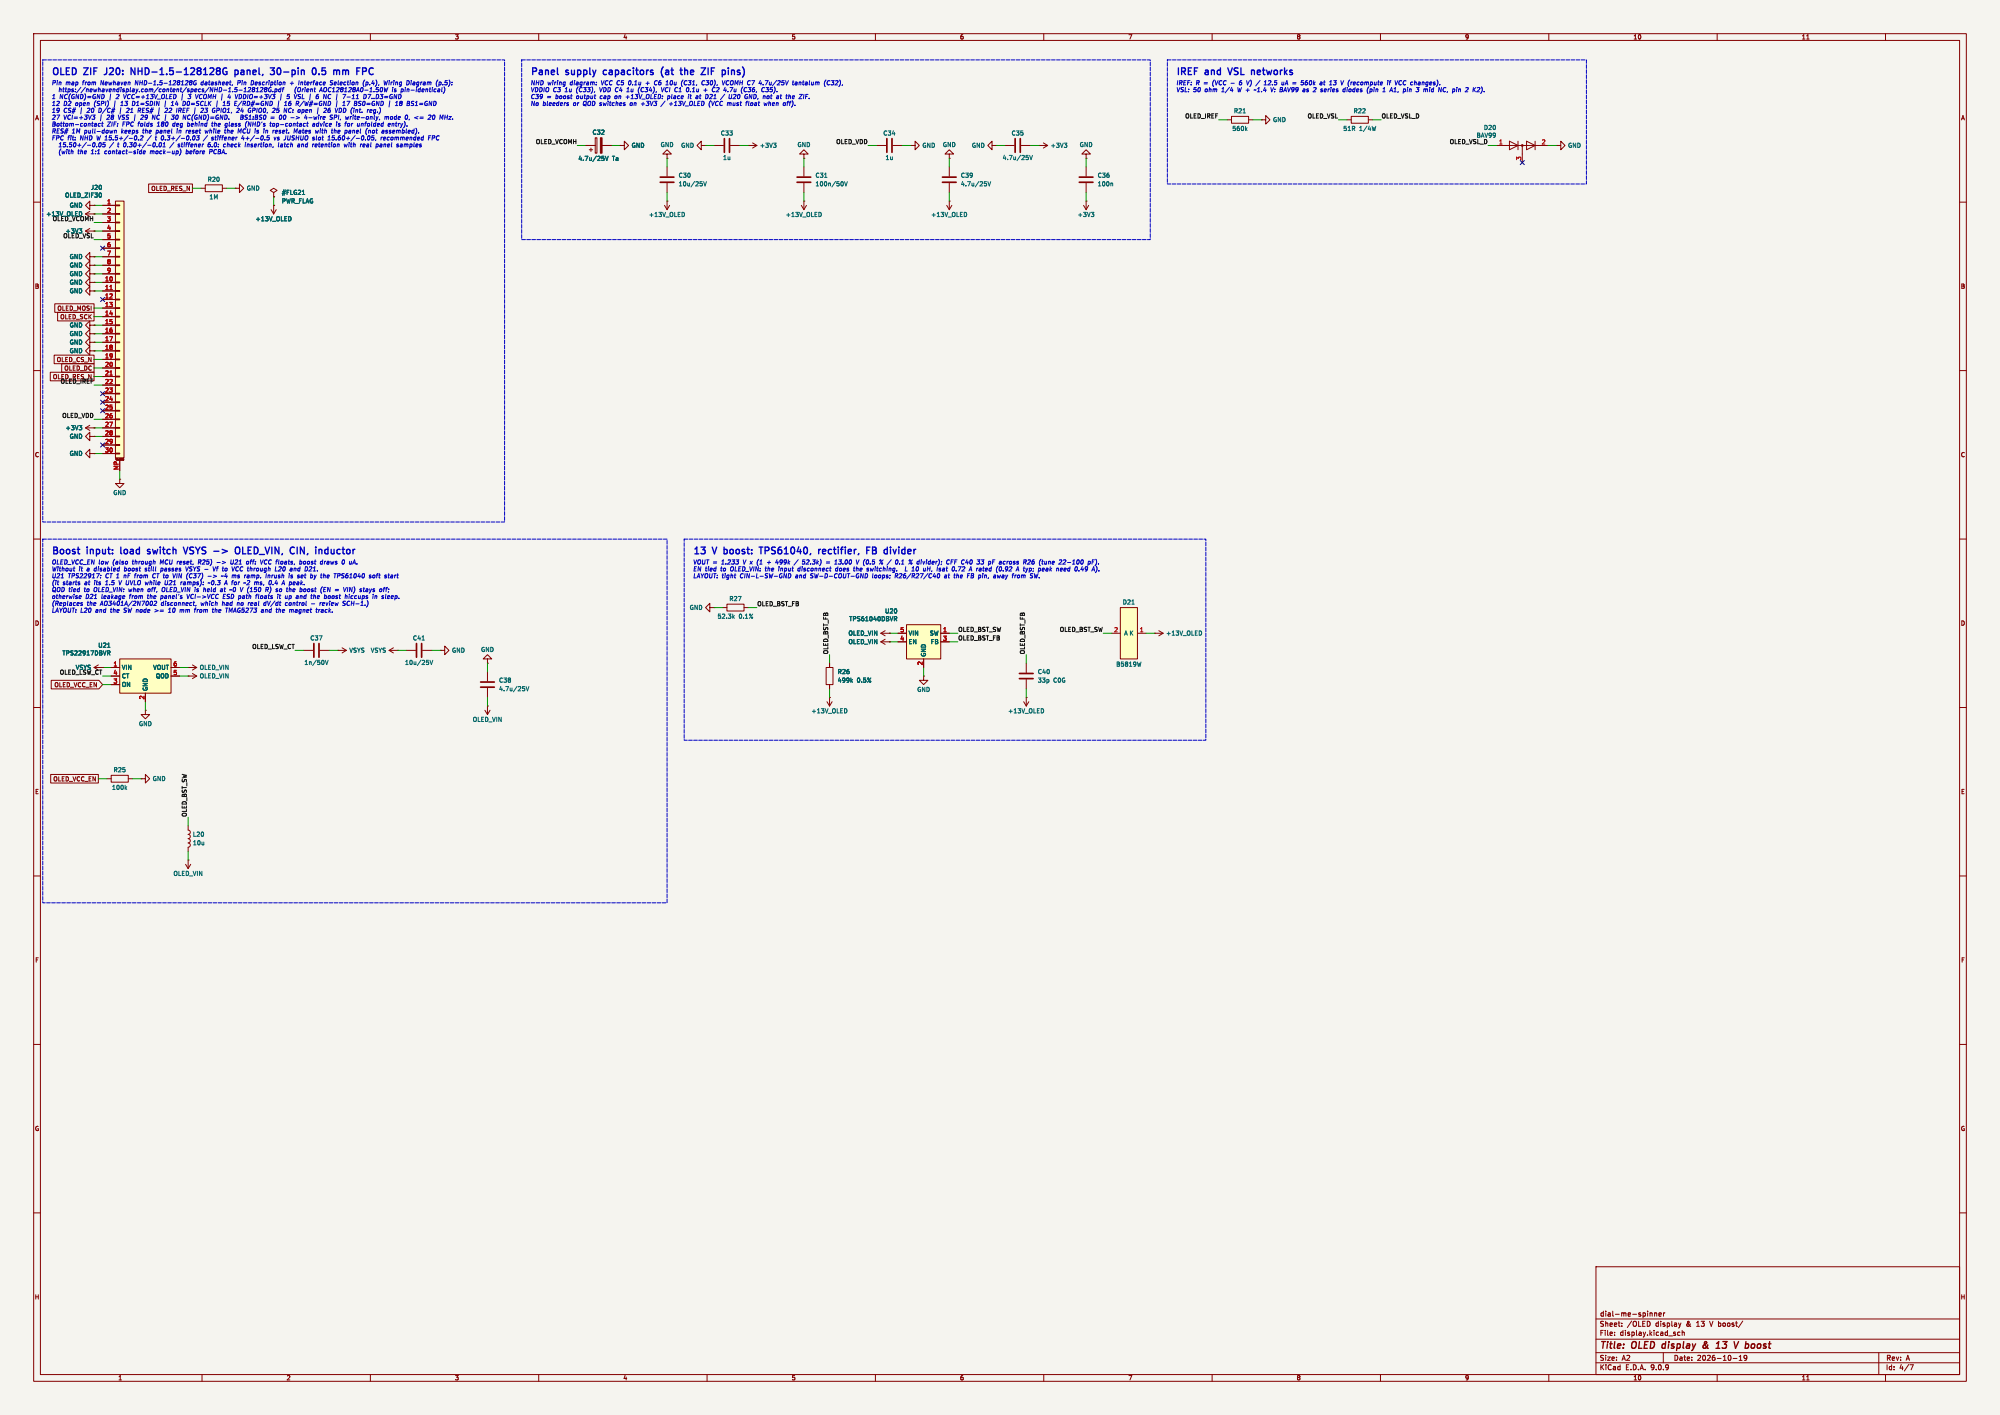
[picture p56: page 4]

2 VOUT 6 QOD 5 U21 TPS22917DBVR GND GND GND GND

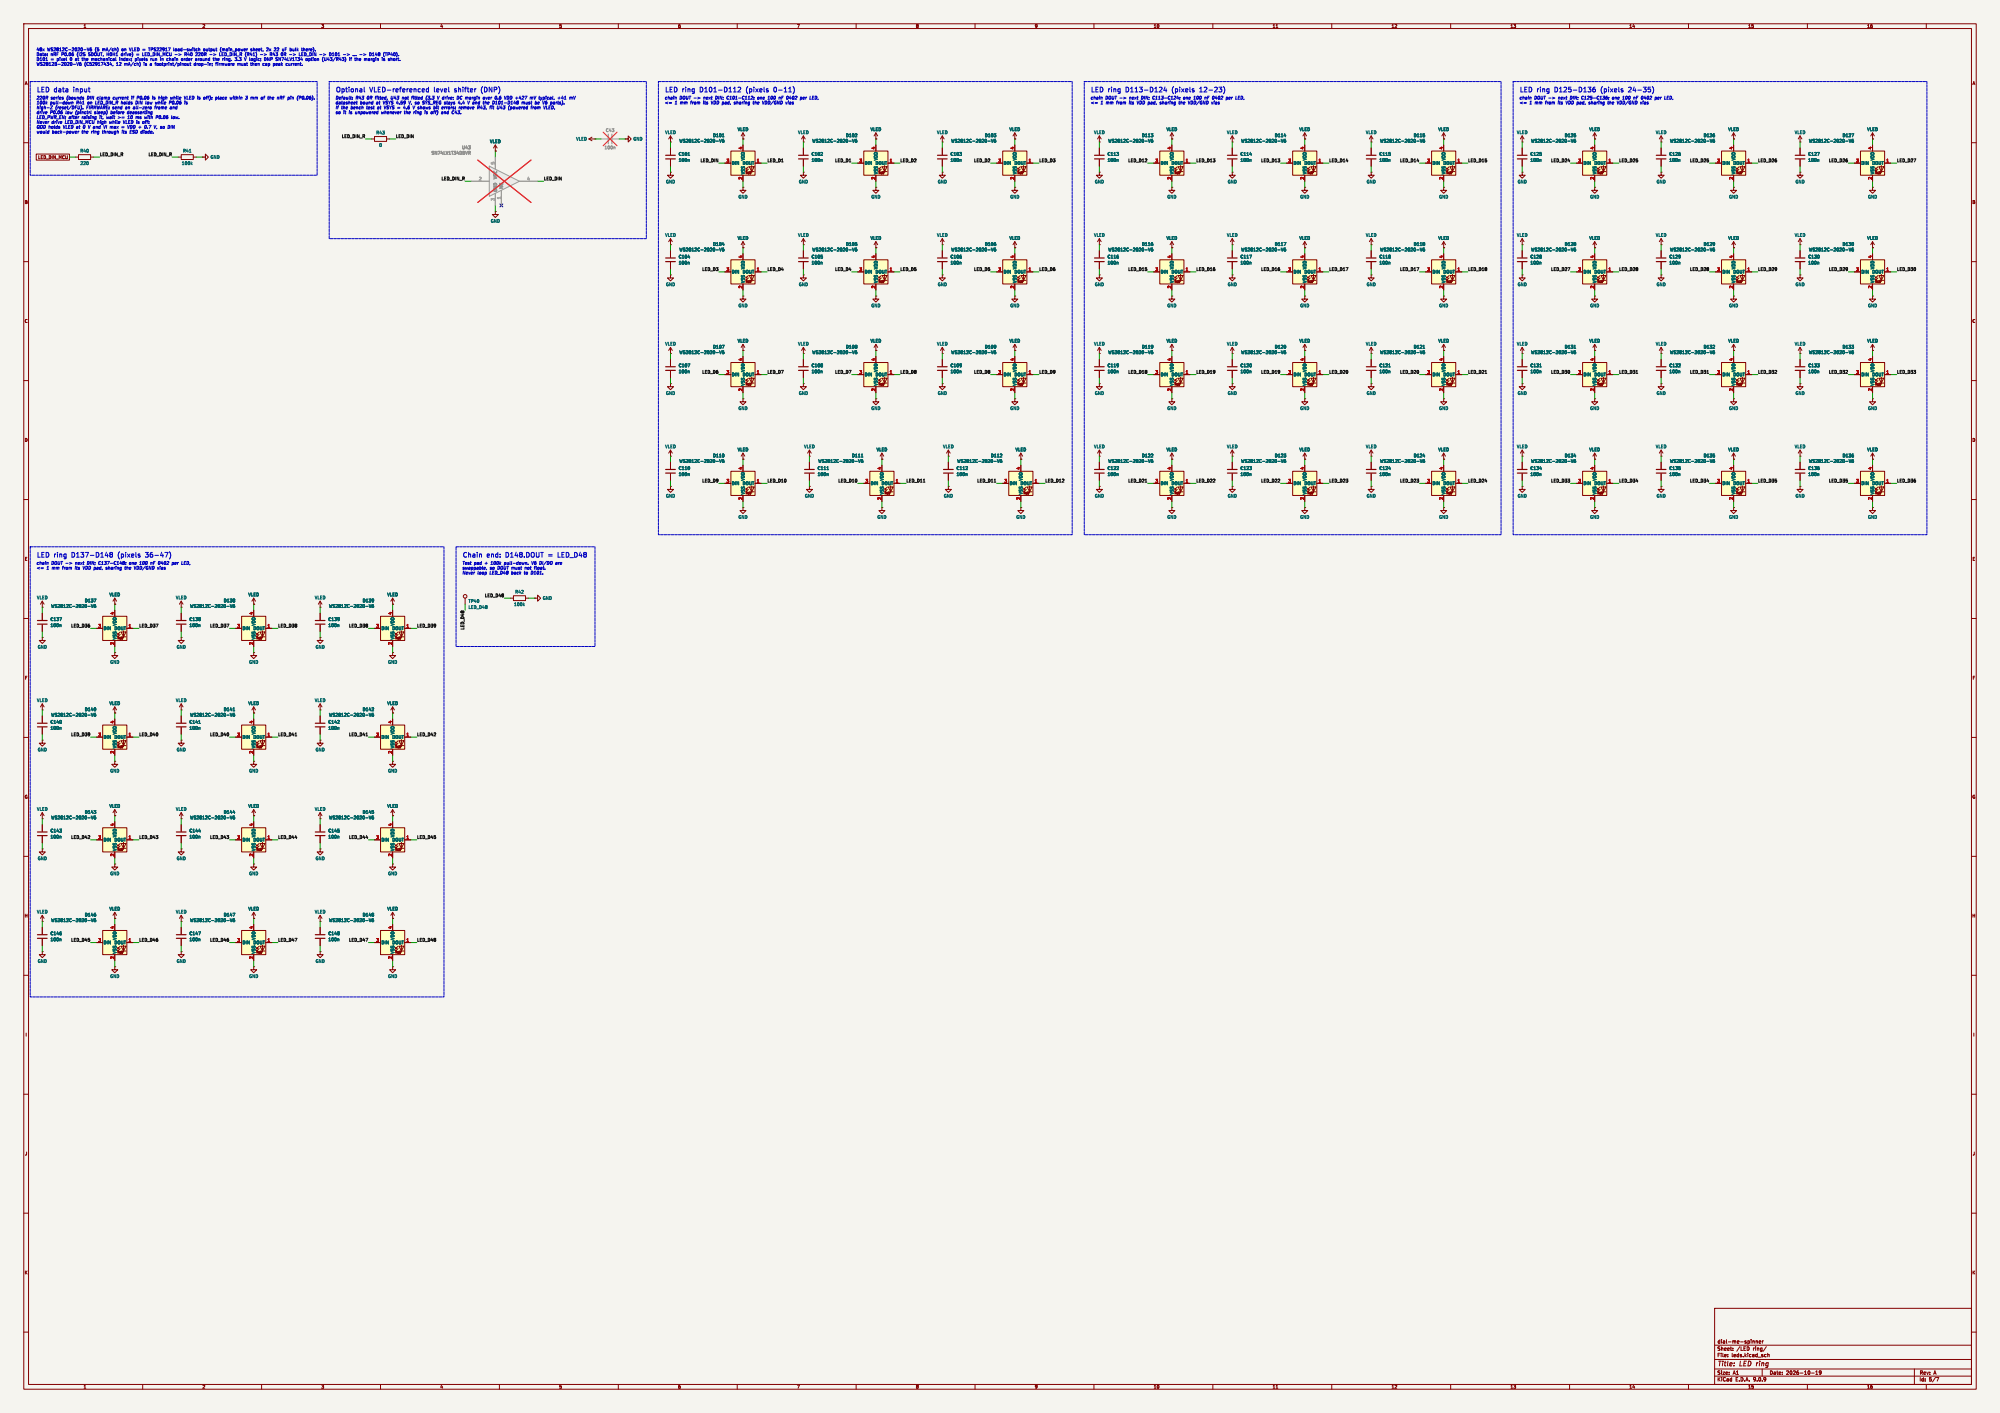
[picture p57: page 5]

LED_PWR_EN; after raising it, wait >= 10 ms with P0.06 low. Never drive LED_DIN_MCU high while VLED is off: QOD holds VLED at 0 V and VI max = VDD + 0.7 V, so DIN

2 DOUT 1 D137 WS2812C-2020-V6 VLED VLED GND
VLED

dial-me-spinner
Id: 5/7 Title: LED ring

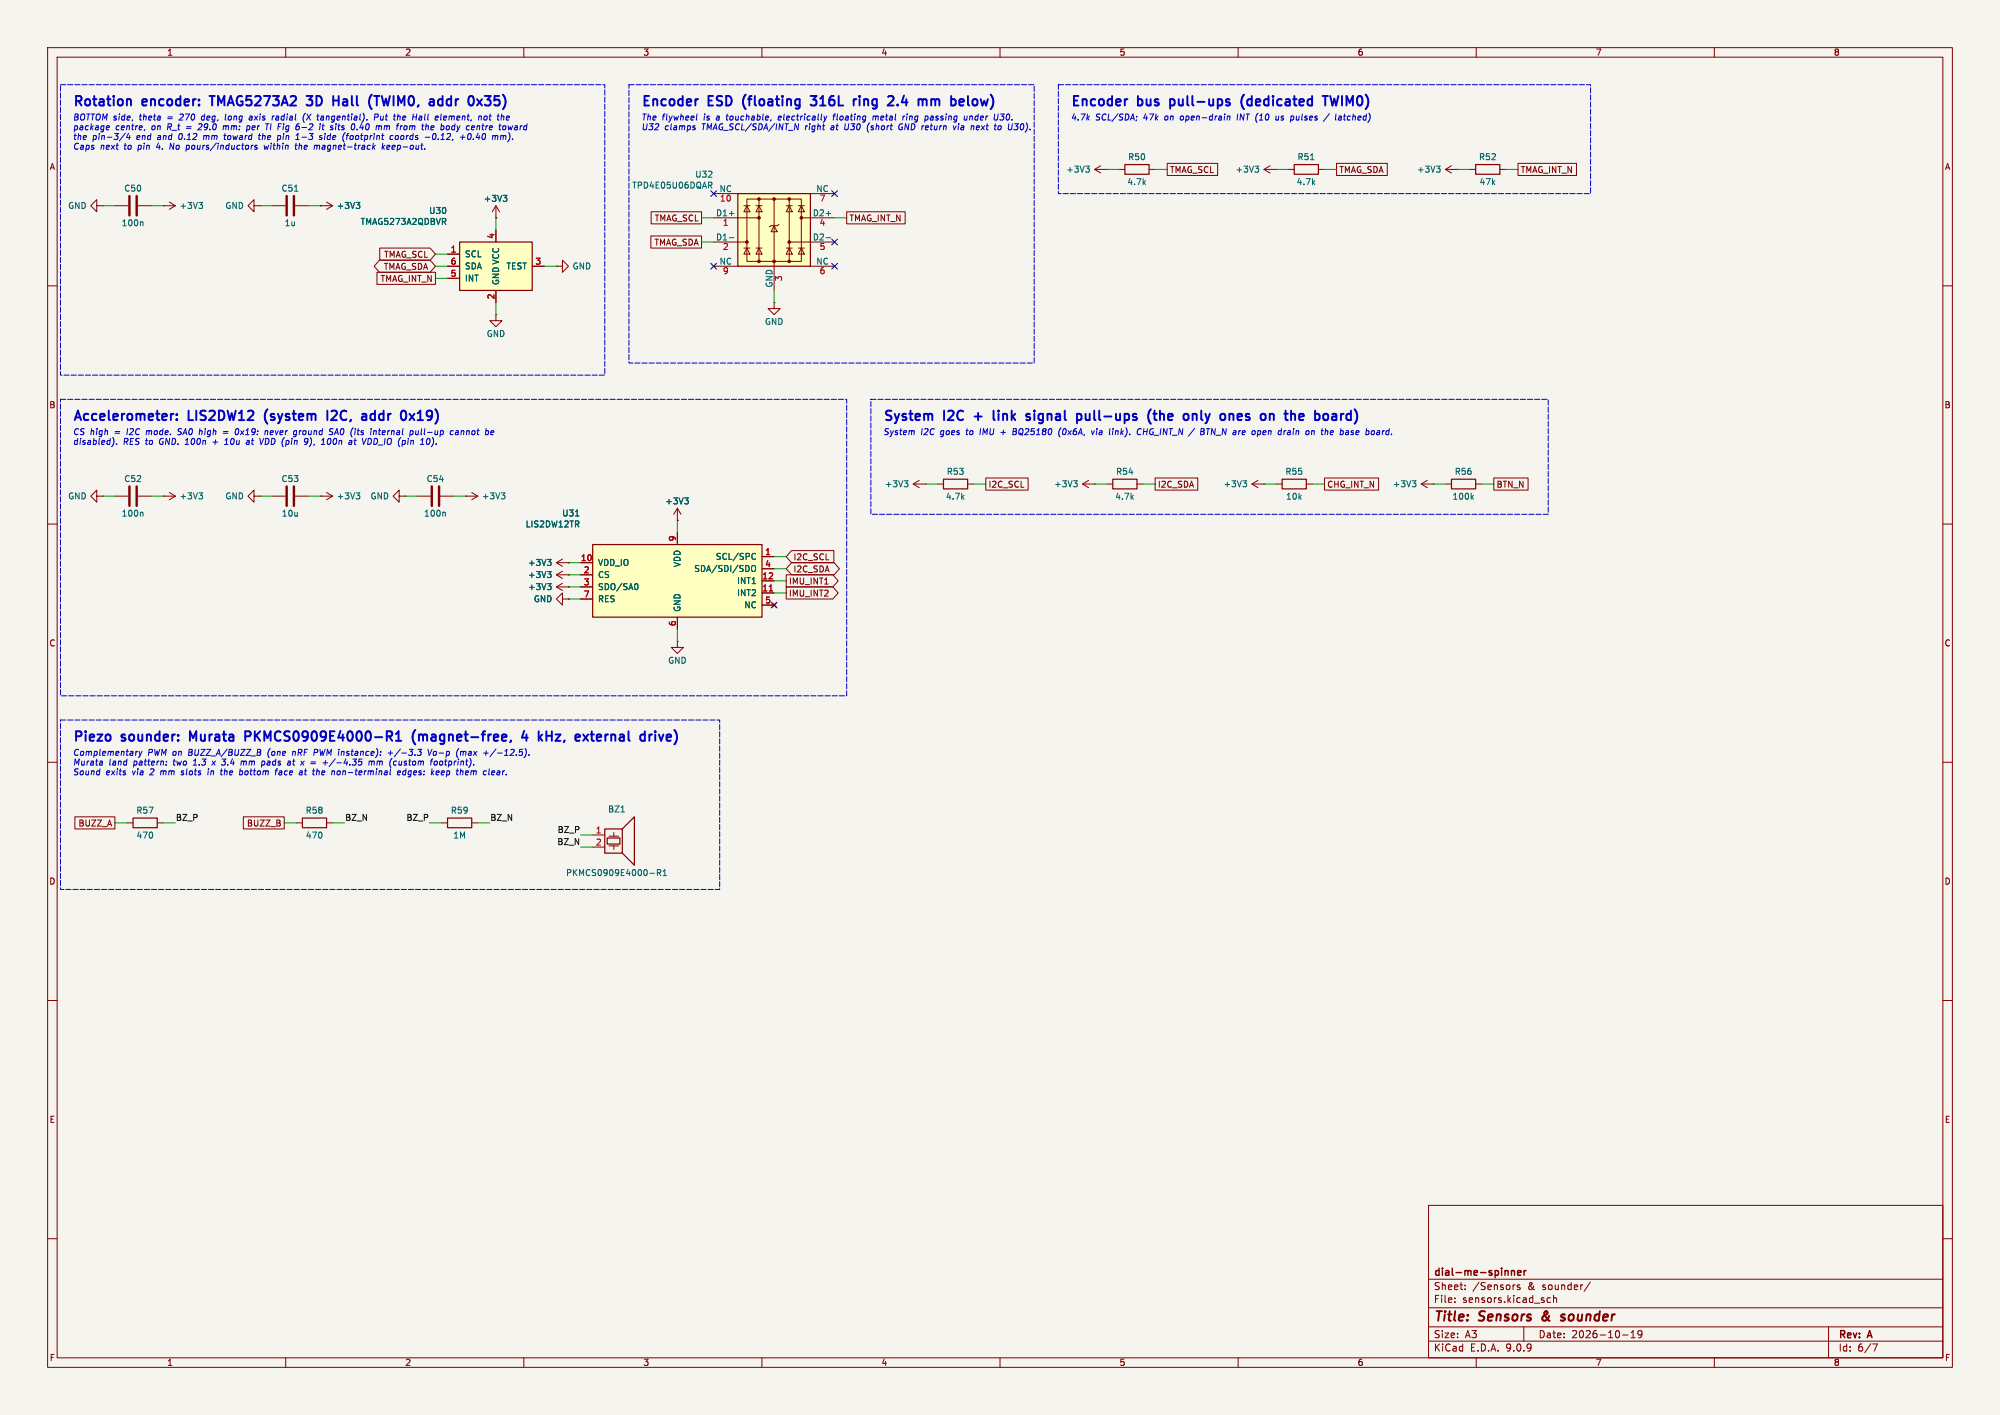
[picture p58: page 6]

6 SCL/SPC 1 SDA/SDI/SDO 4

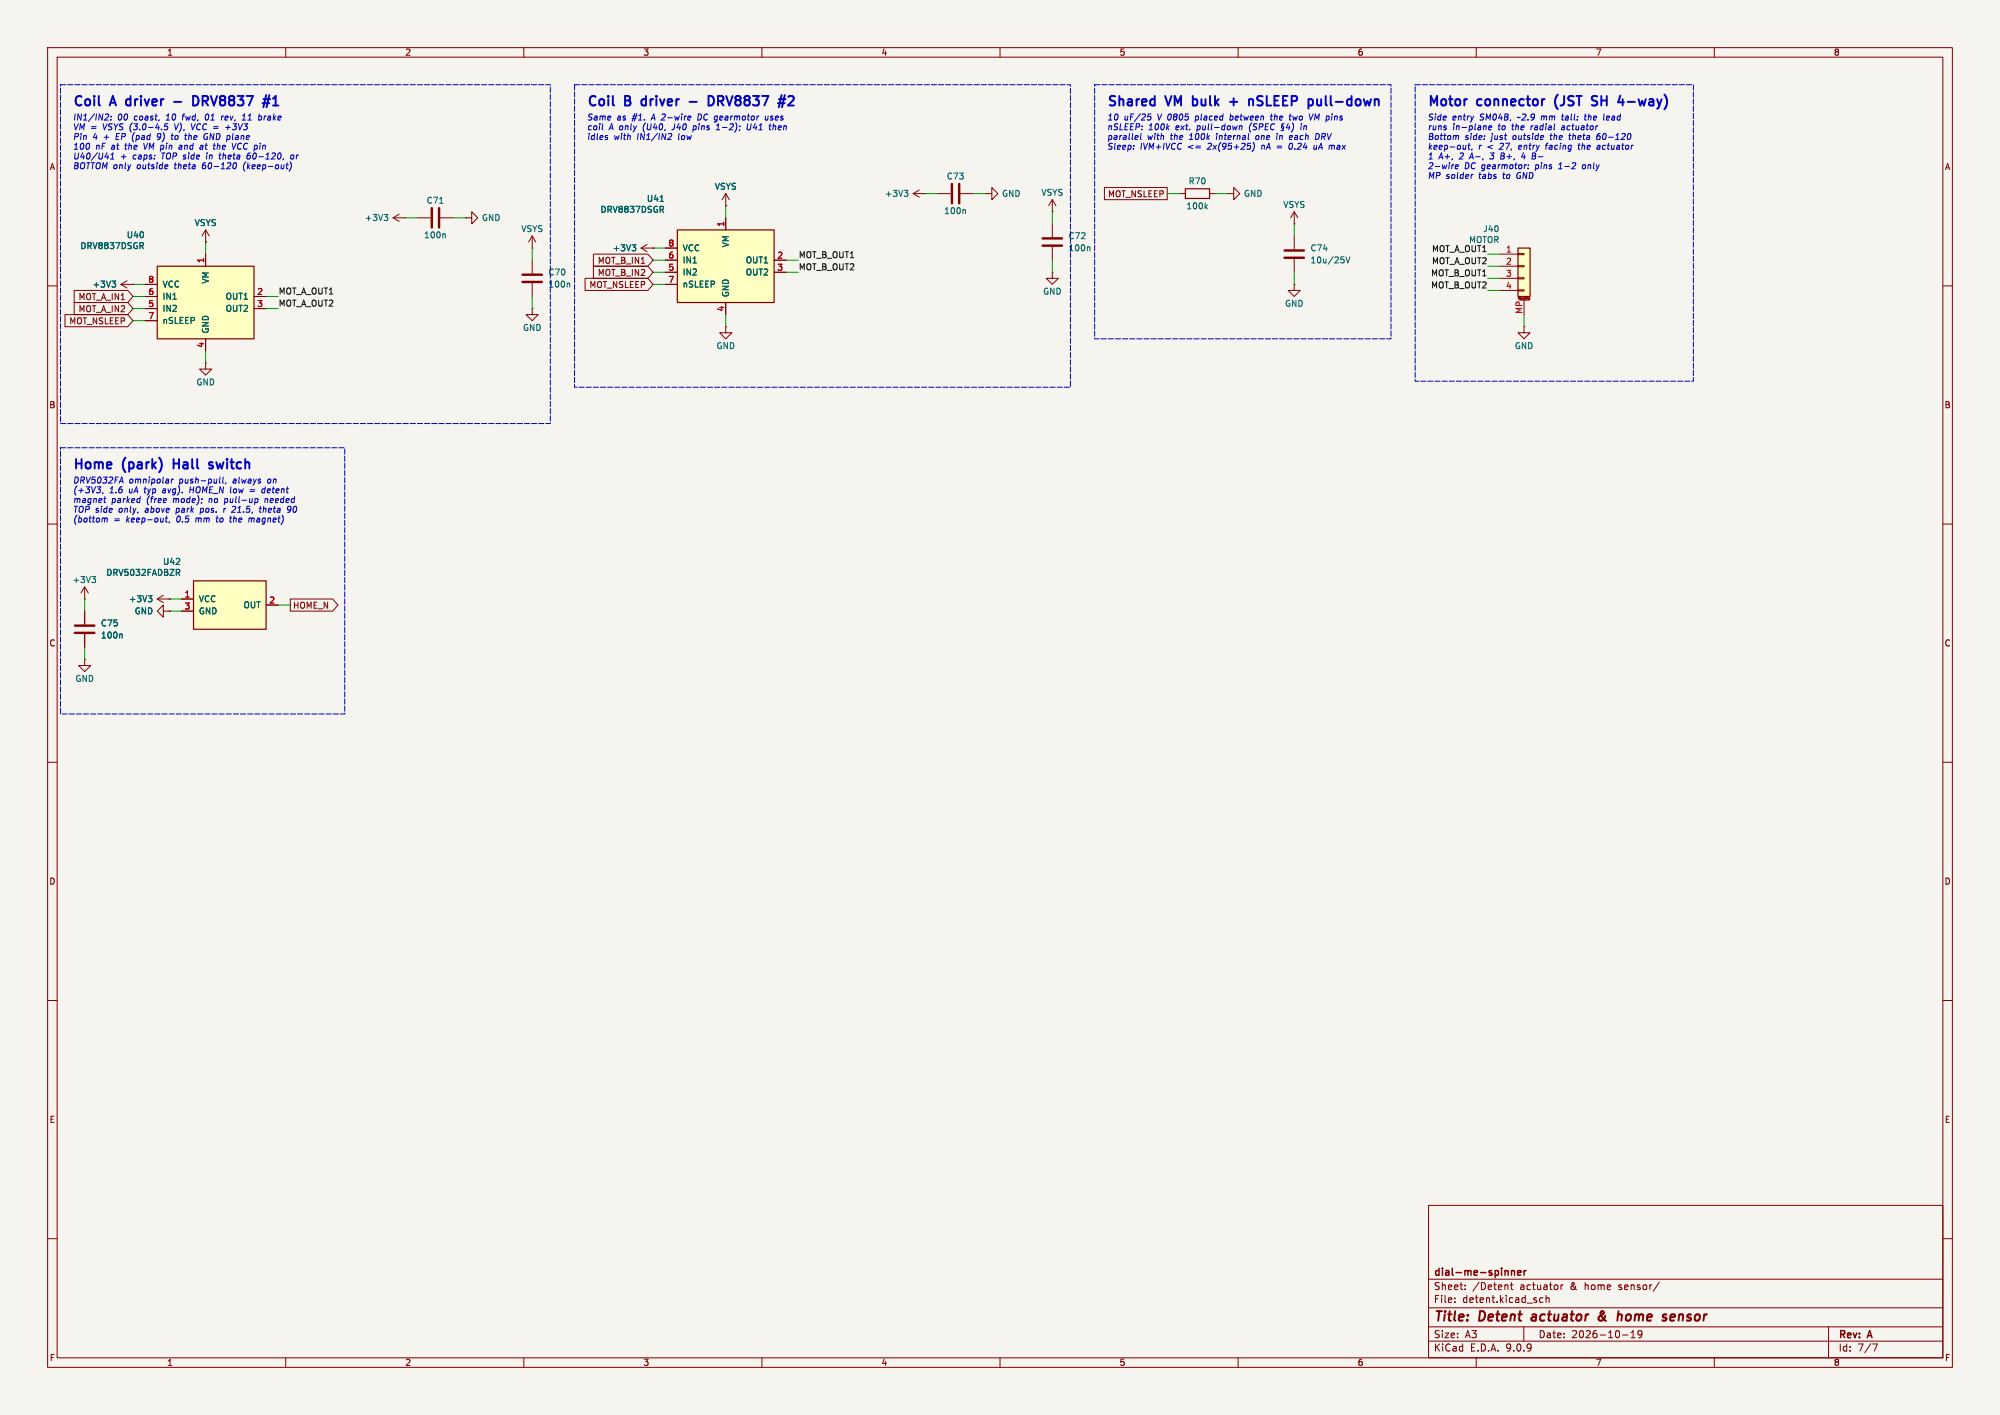
[picture p59: page 7]

Home (park) Hall switch
