tyevco/dial-me-spinner/hardware/kicad/main/render/dial-me-spinner-main-schematic.pdf

File: dial-me-spinner-main.kicad_sch Sheet: / dial-me-spinner

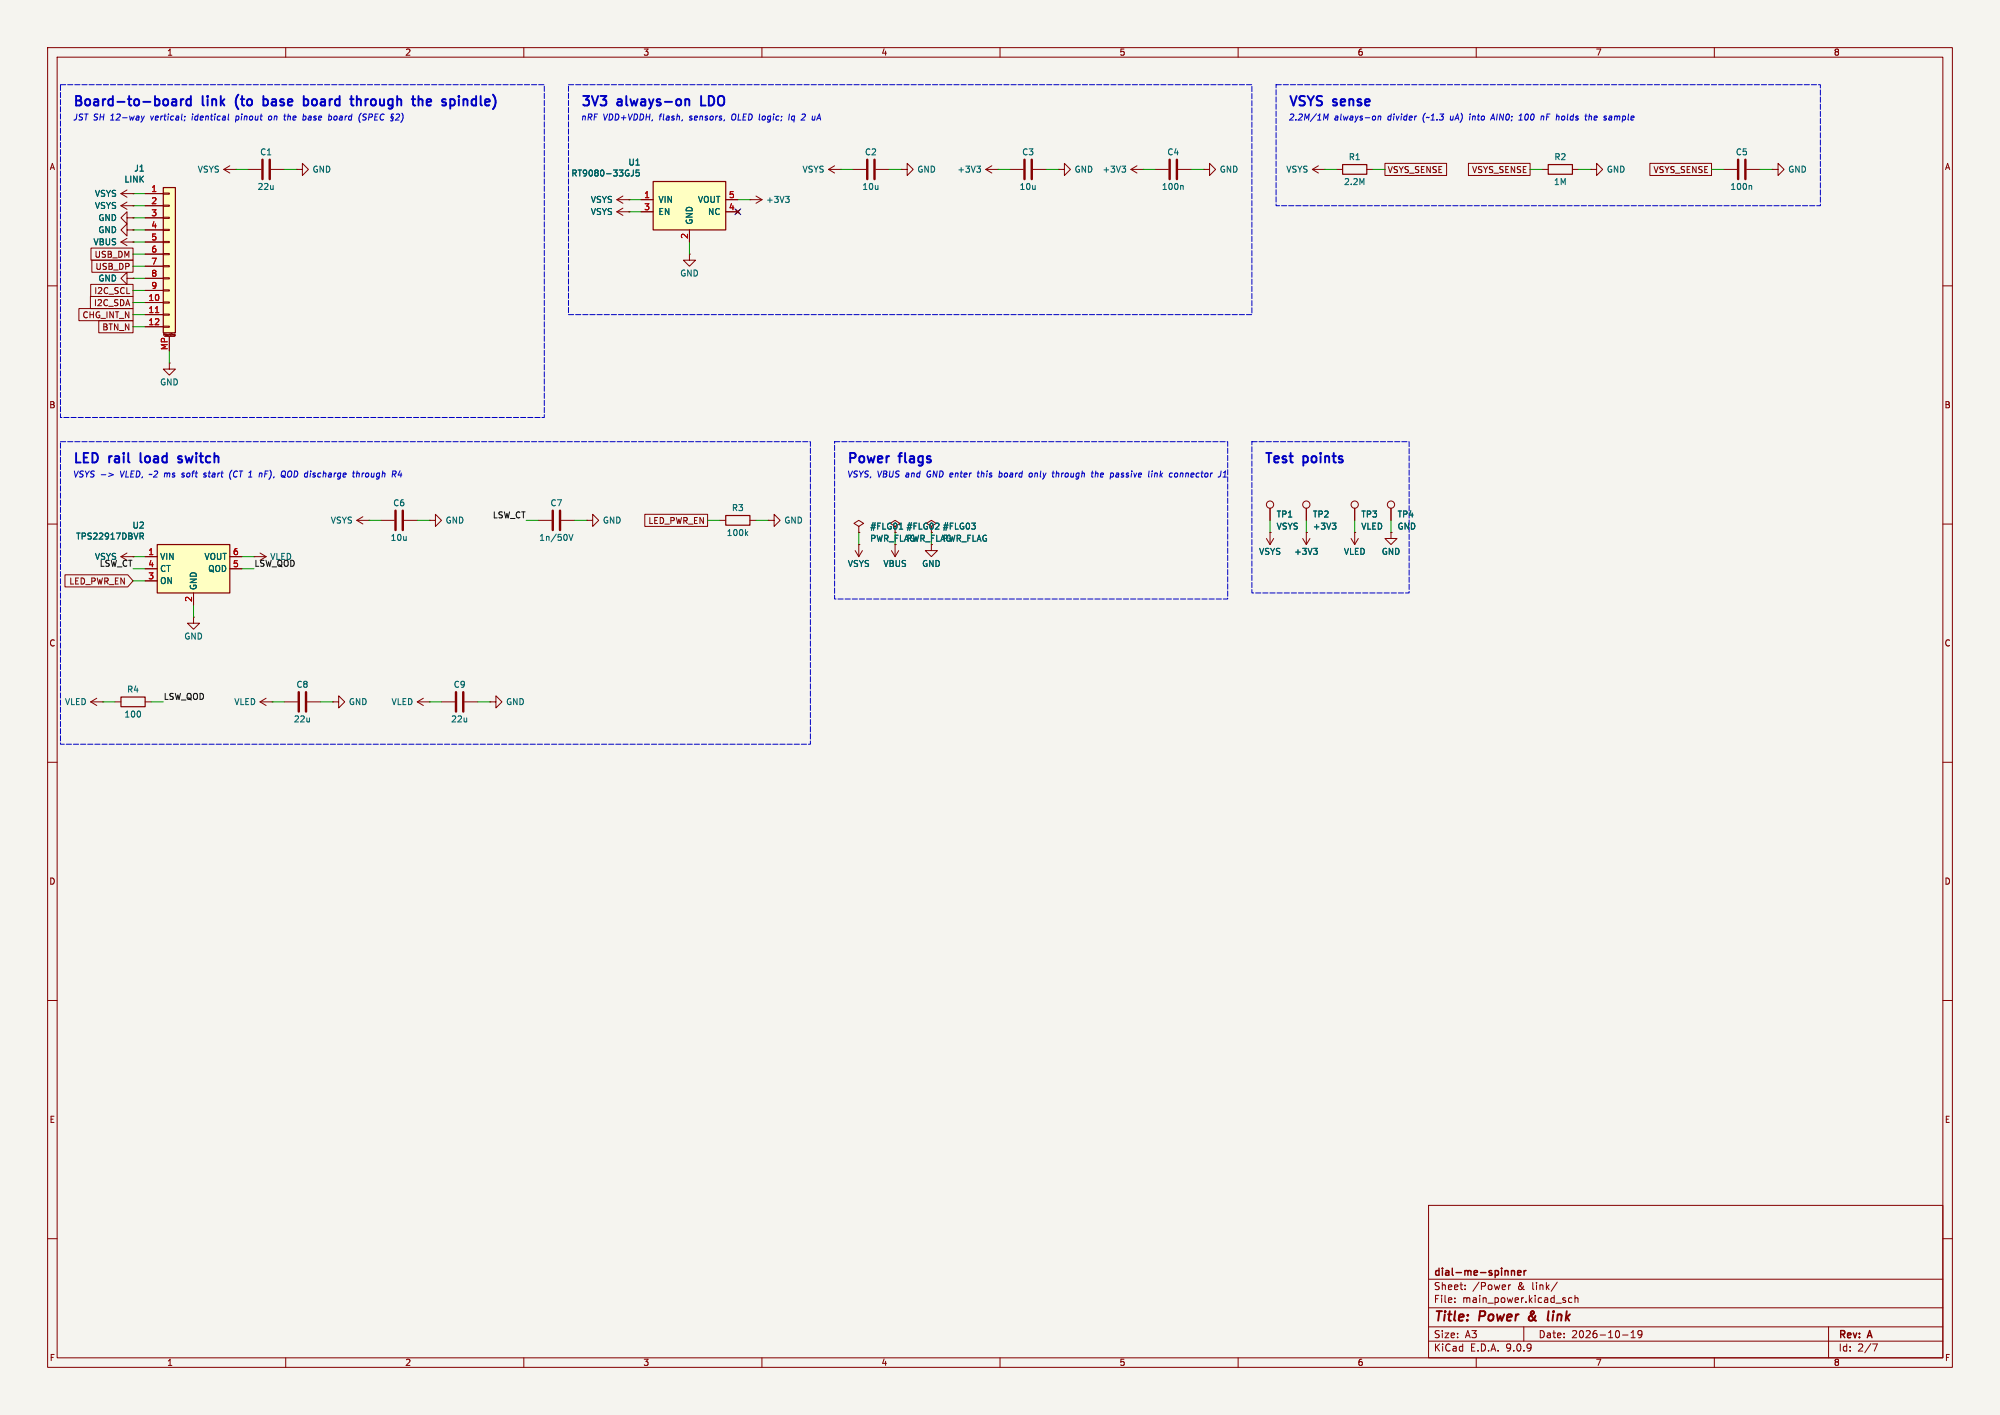
[picture p61: page 2]

LED rail load switch

Id: 2/7 Title: Power & link

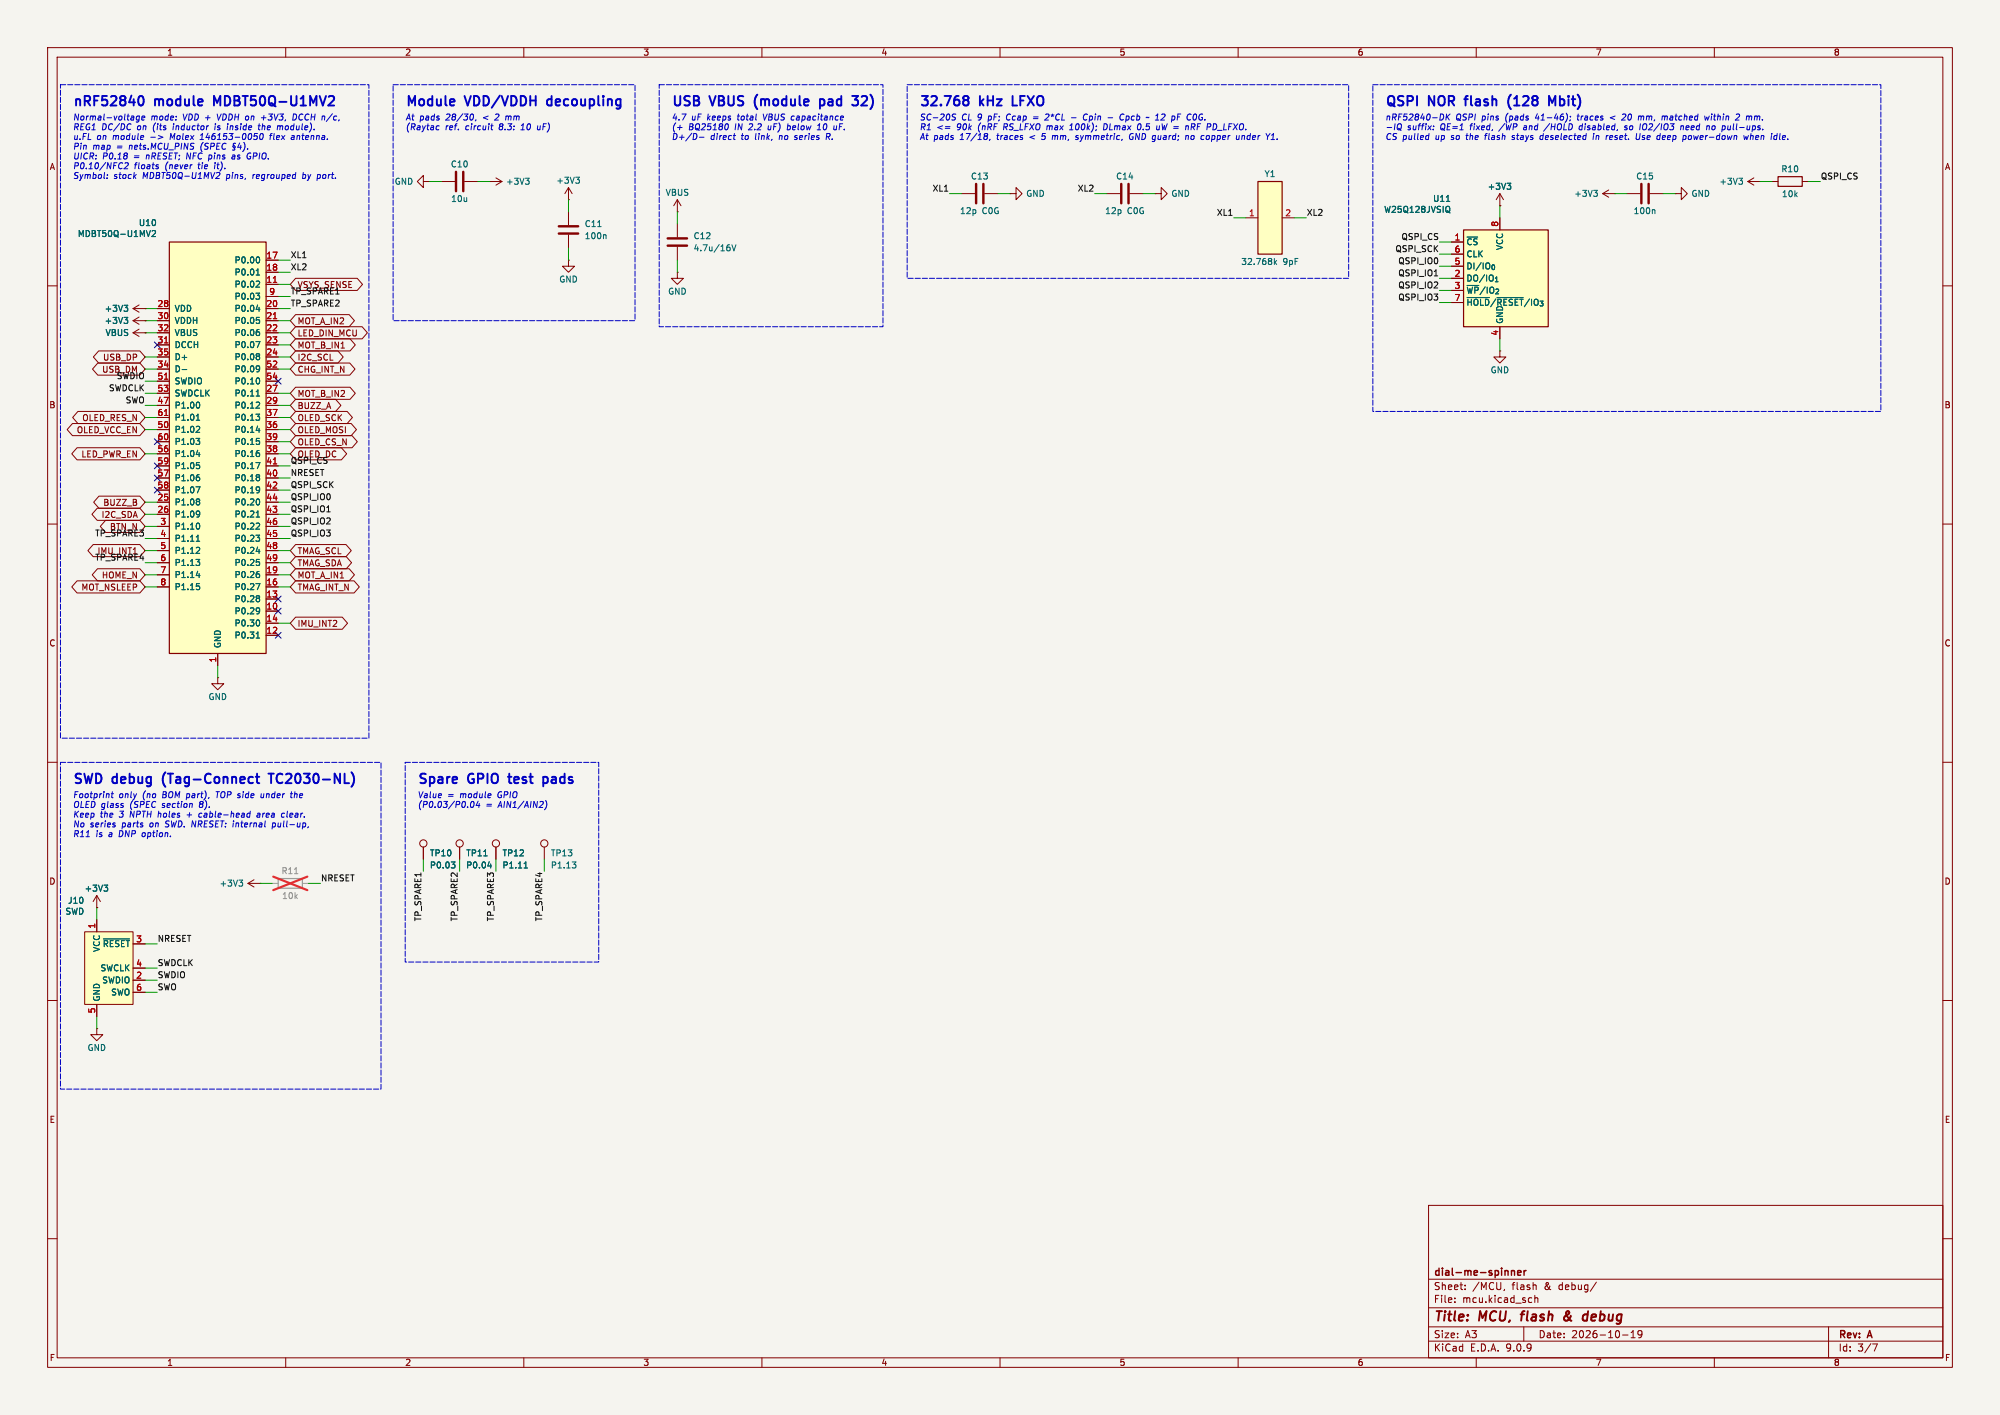
[picture p62: page 3]

(Raytac ref. circuit 8.3: 10 uF)

4.7 uF keeps total VBUS capacitance

5 ~{RESET}3 SWCLK 4 SWDIO 2 SWO 6 +3V3
J10 SWD VCC

5 ~{RESET}3 SWCLK 4 SWDIO 2 SWO 6

dial-me-spinner
Id: 3/7 Title: MCU, flash & debug

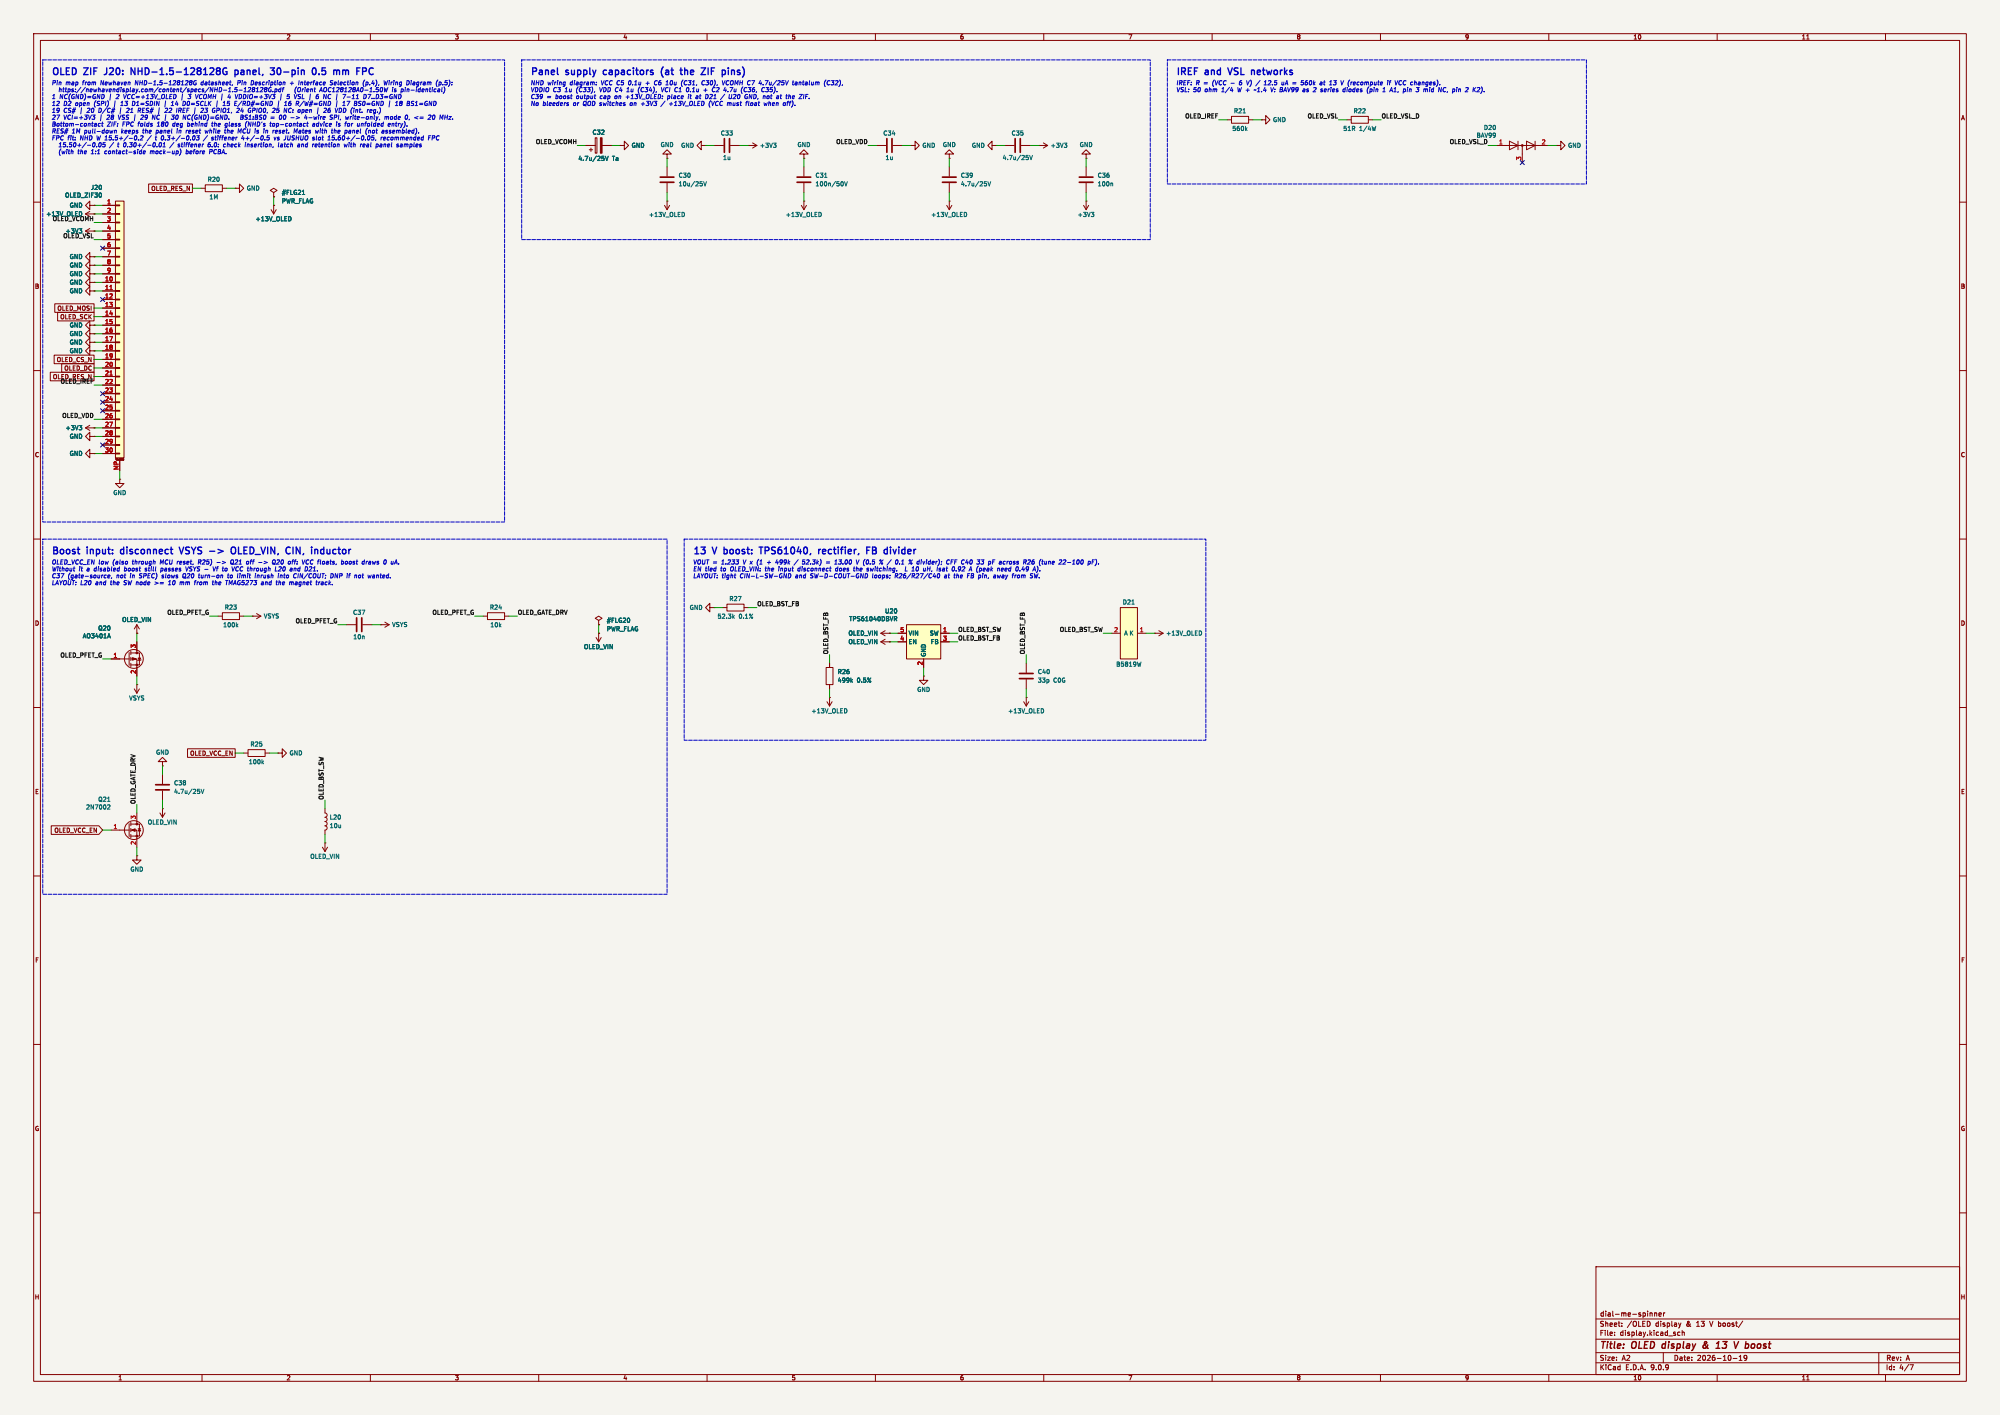
[picture p63: page 4]

2 D20 BAV99 GND
30 MP GND GND GND
+13V_OLED GND
+13V_OLED GND GND GND GND GND GND

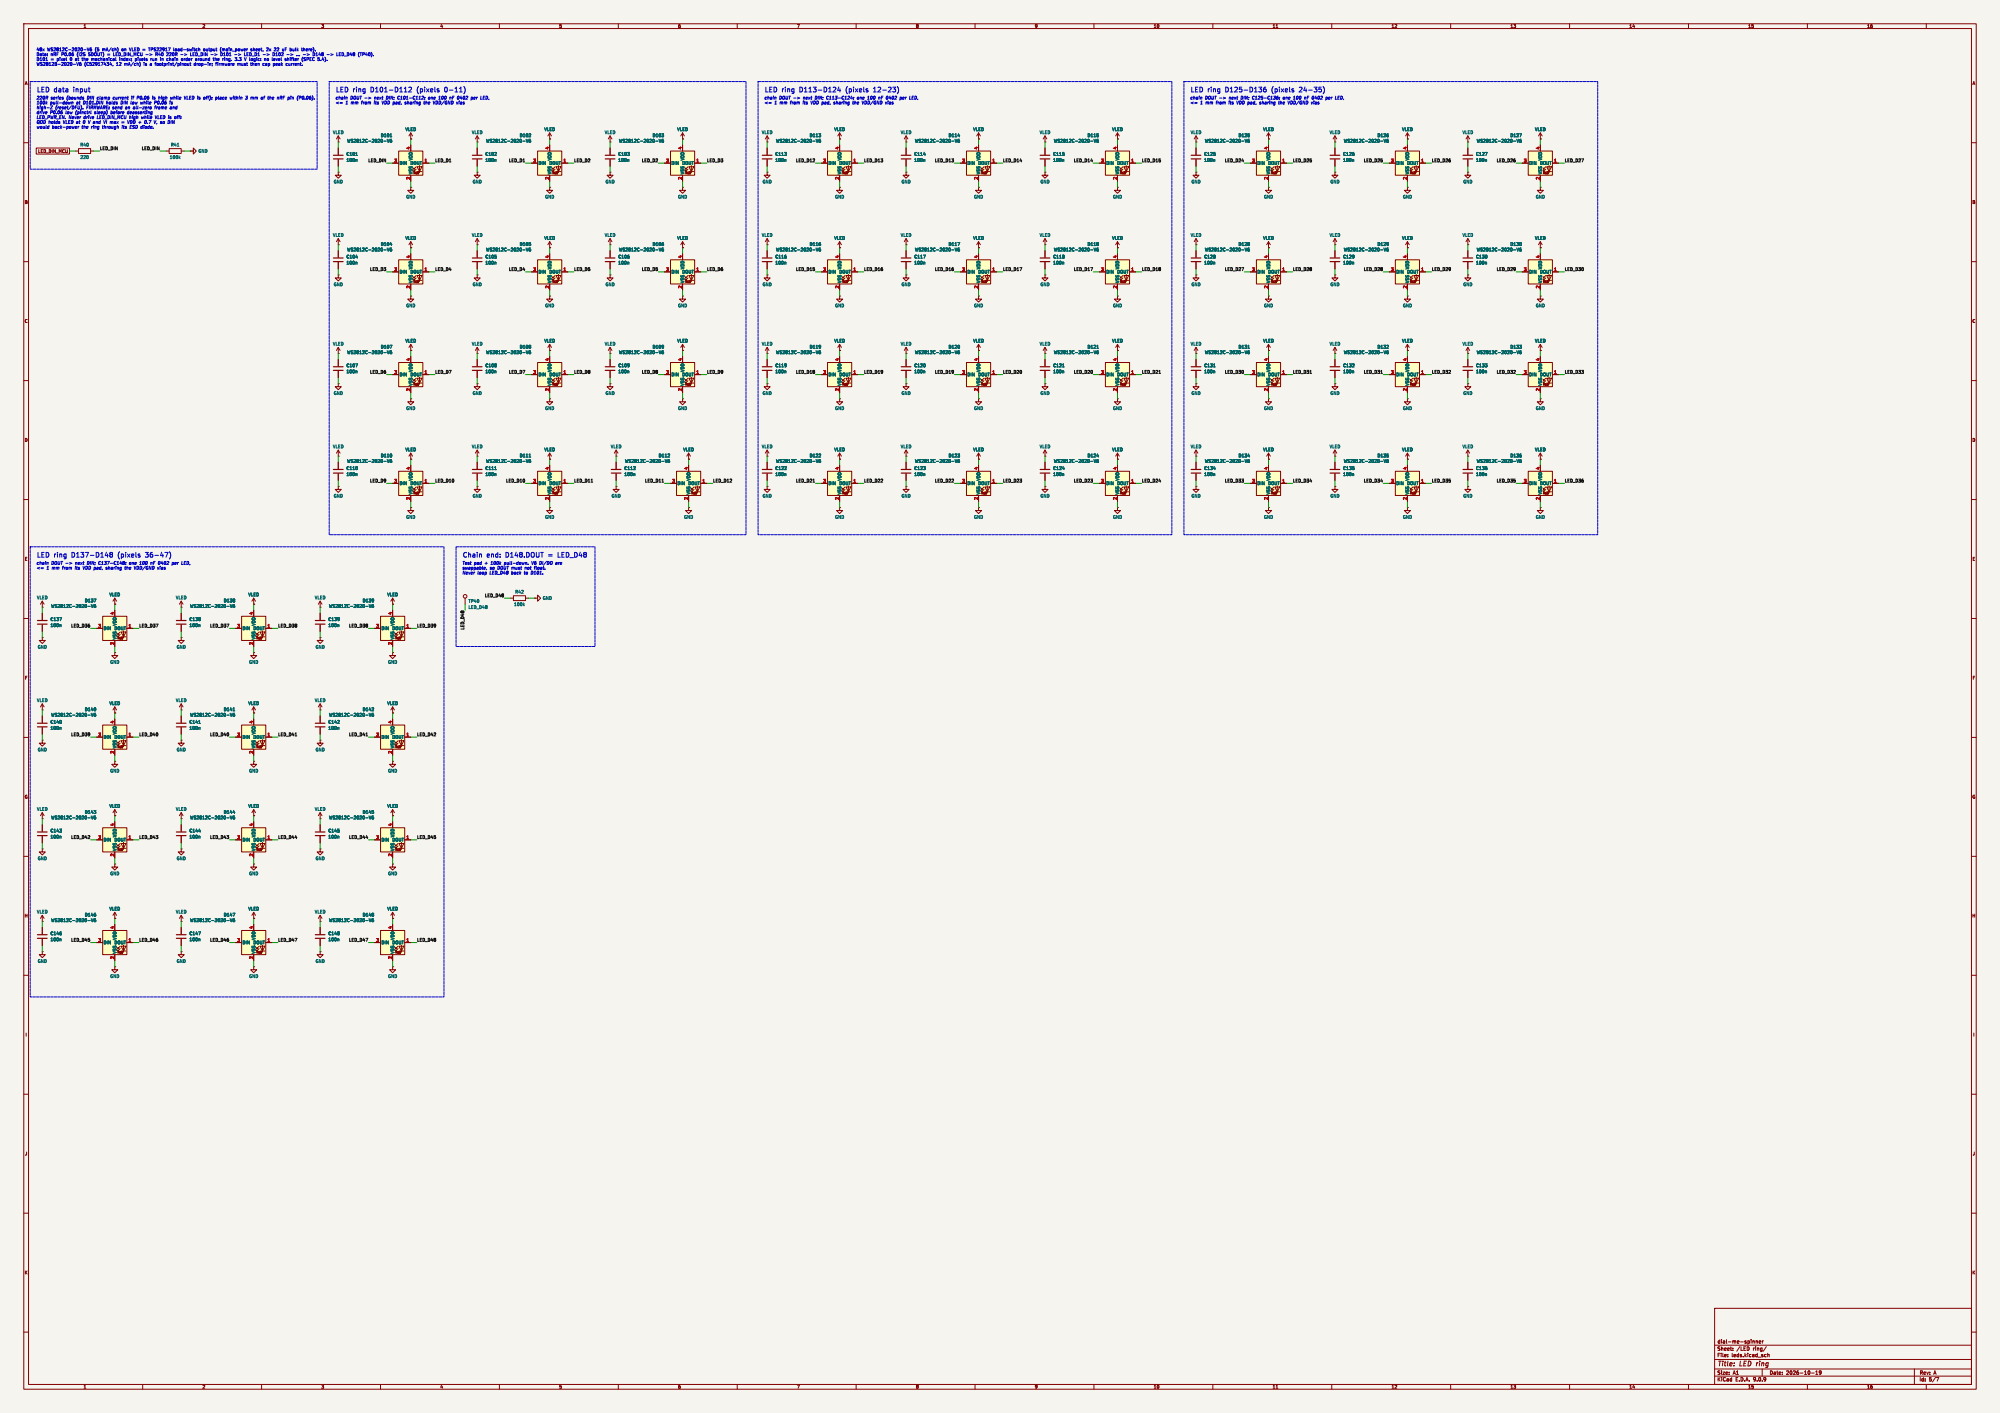
[picture p64: page 5]

LED_PWR_EN. Never drive LED_DIN_MCU high while VLED is off: QOD holds VLED at 0 V and VI max = VDD + 0.7 V, so DIN

2 DOUT 1 D112 WS2812C-2020-V6 VLED GND GND

2 DOUT 1 D142 WS2812C-2020-V6 GND GND GND

dial-me-spinner
Id: 5/7 Title: LED ring

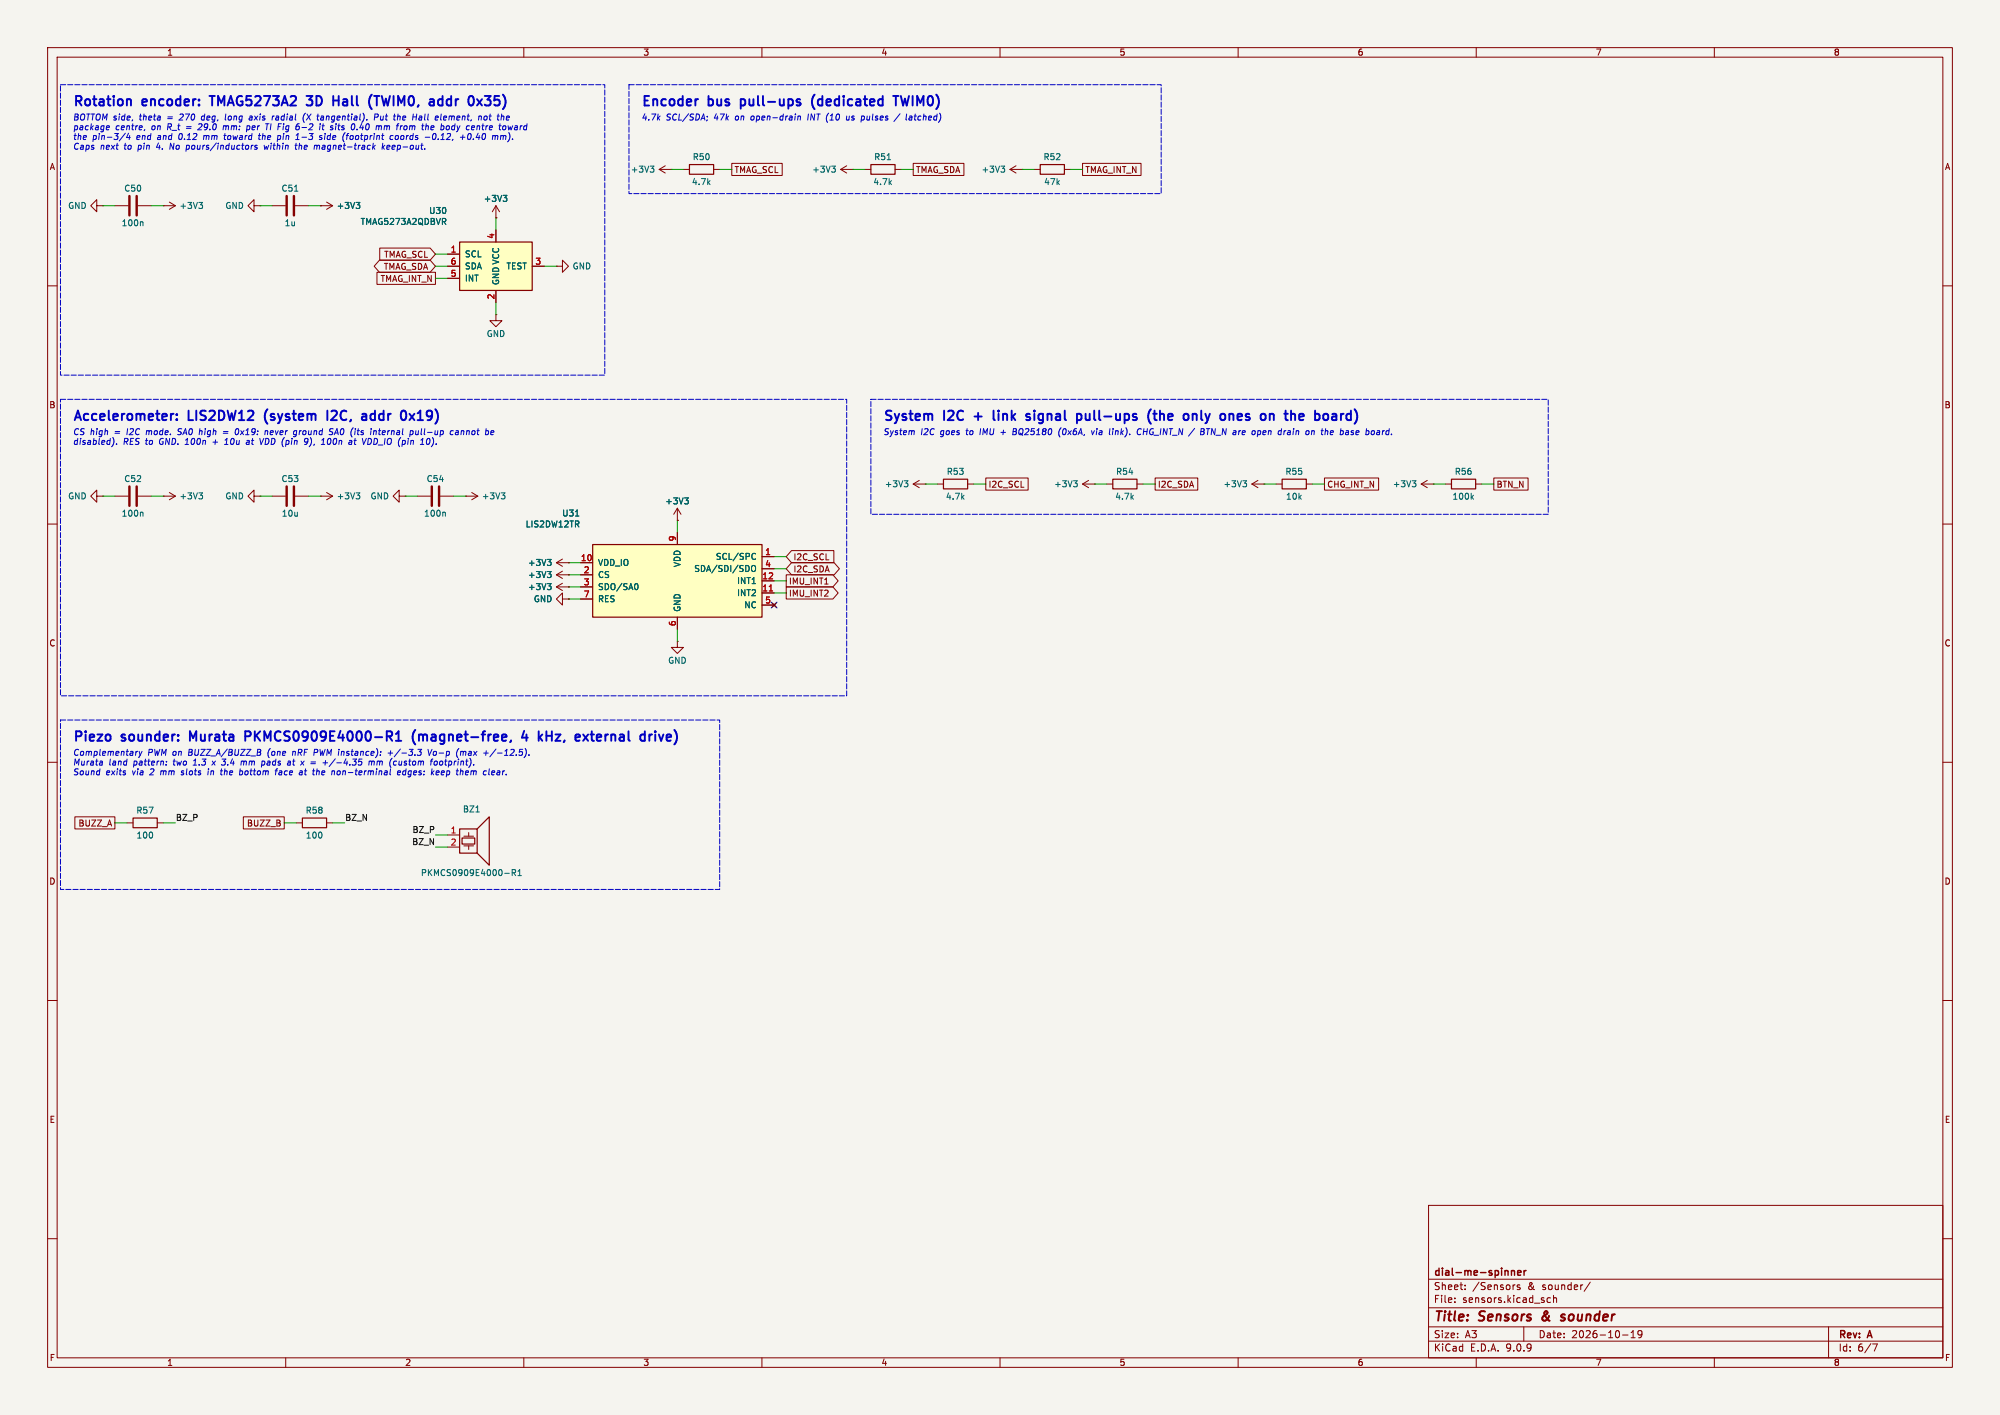
[picture p65: page 6]

Rotation encoder: TMAG5273A2 3D Hall (TWIM0, addr 0x35)

6 SCL/SPC 1 SDA/SDI/SDO 4


Home (park) Hall switch
