tyevco/dial-me-spinner/hardware/mechanical/drawings/cap_ring.pdf

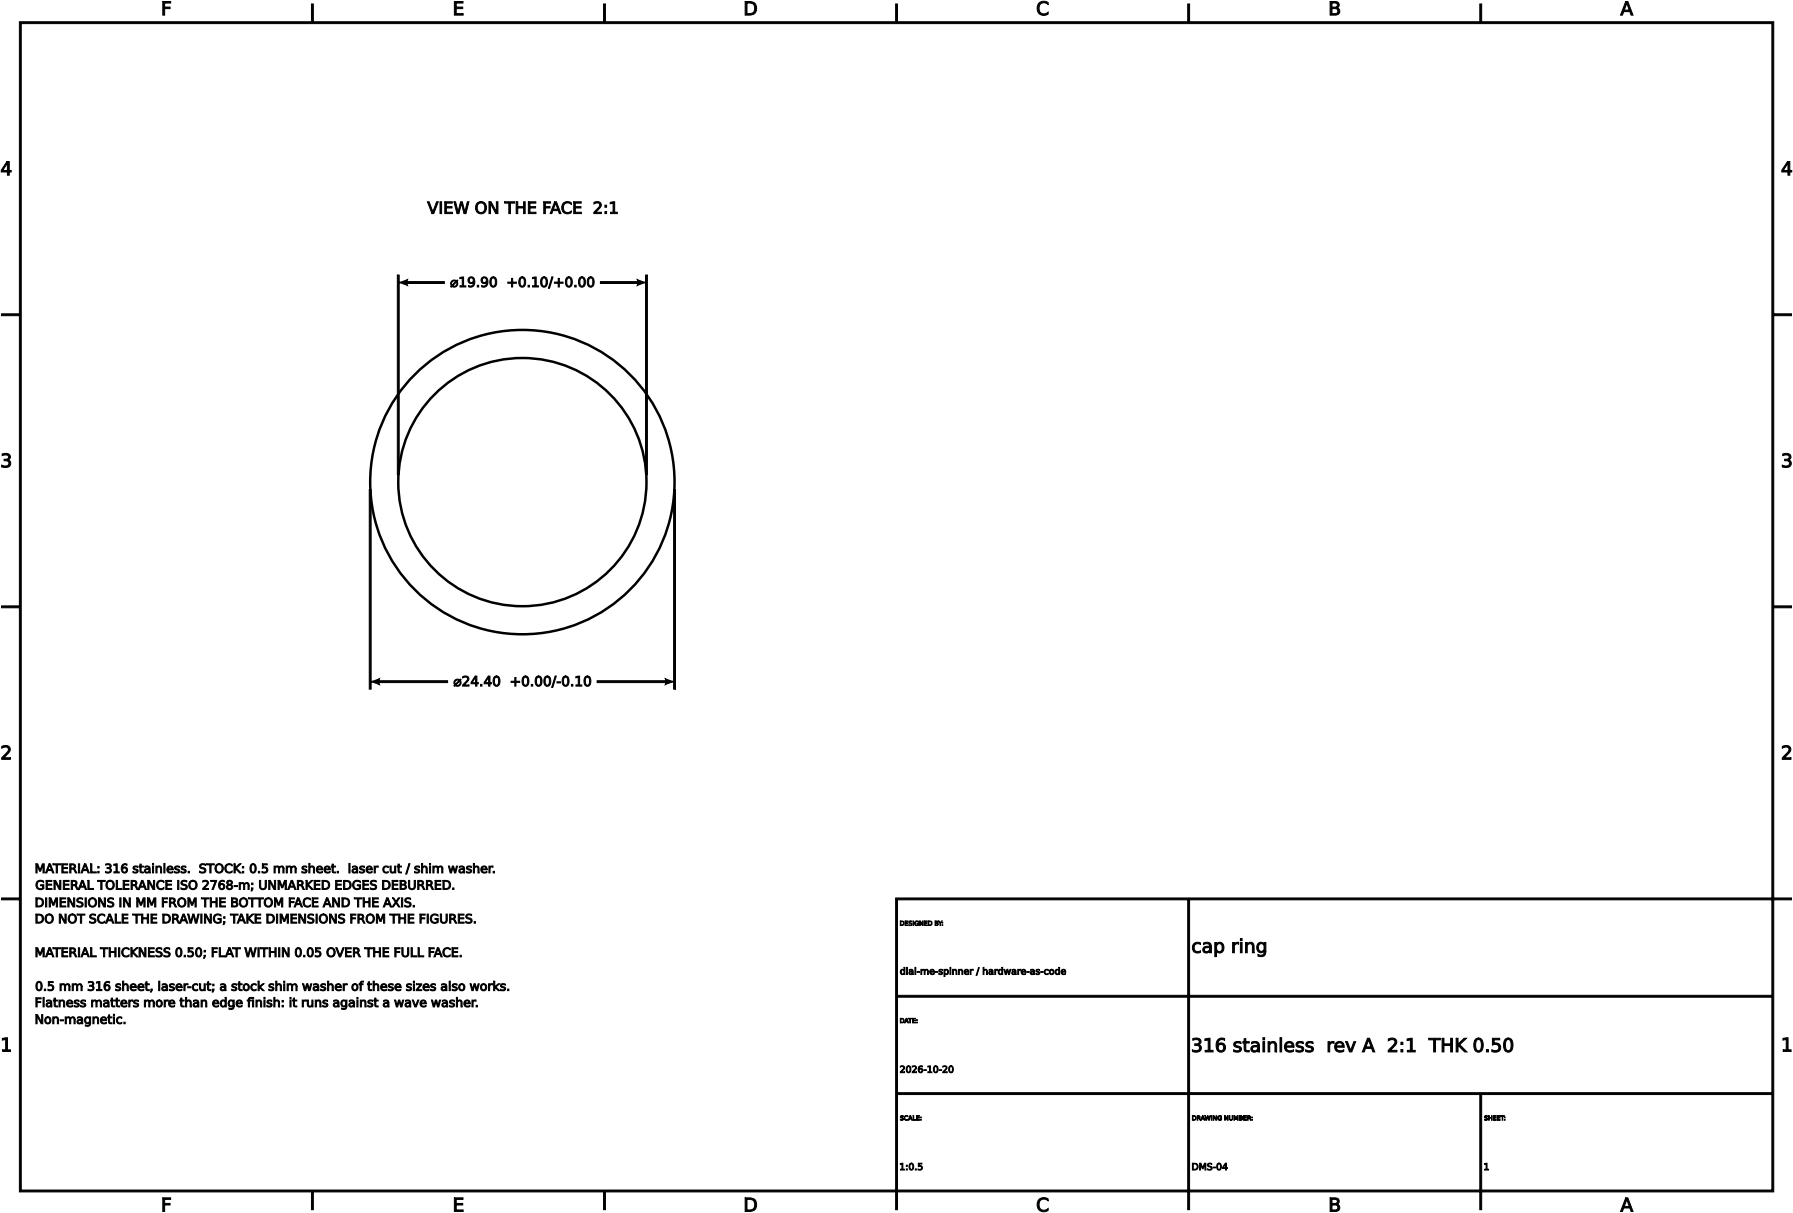
[picture p66: page 1]
