tyevco/dial-me-spinner/hardware/mechanical/drawings/lower_spacer.pdf

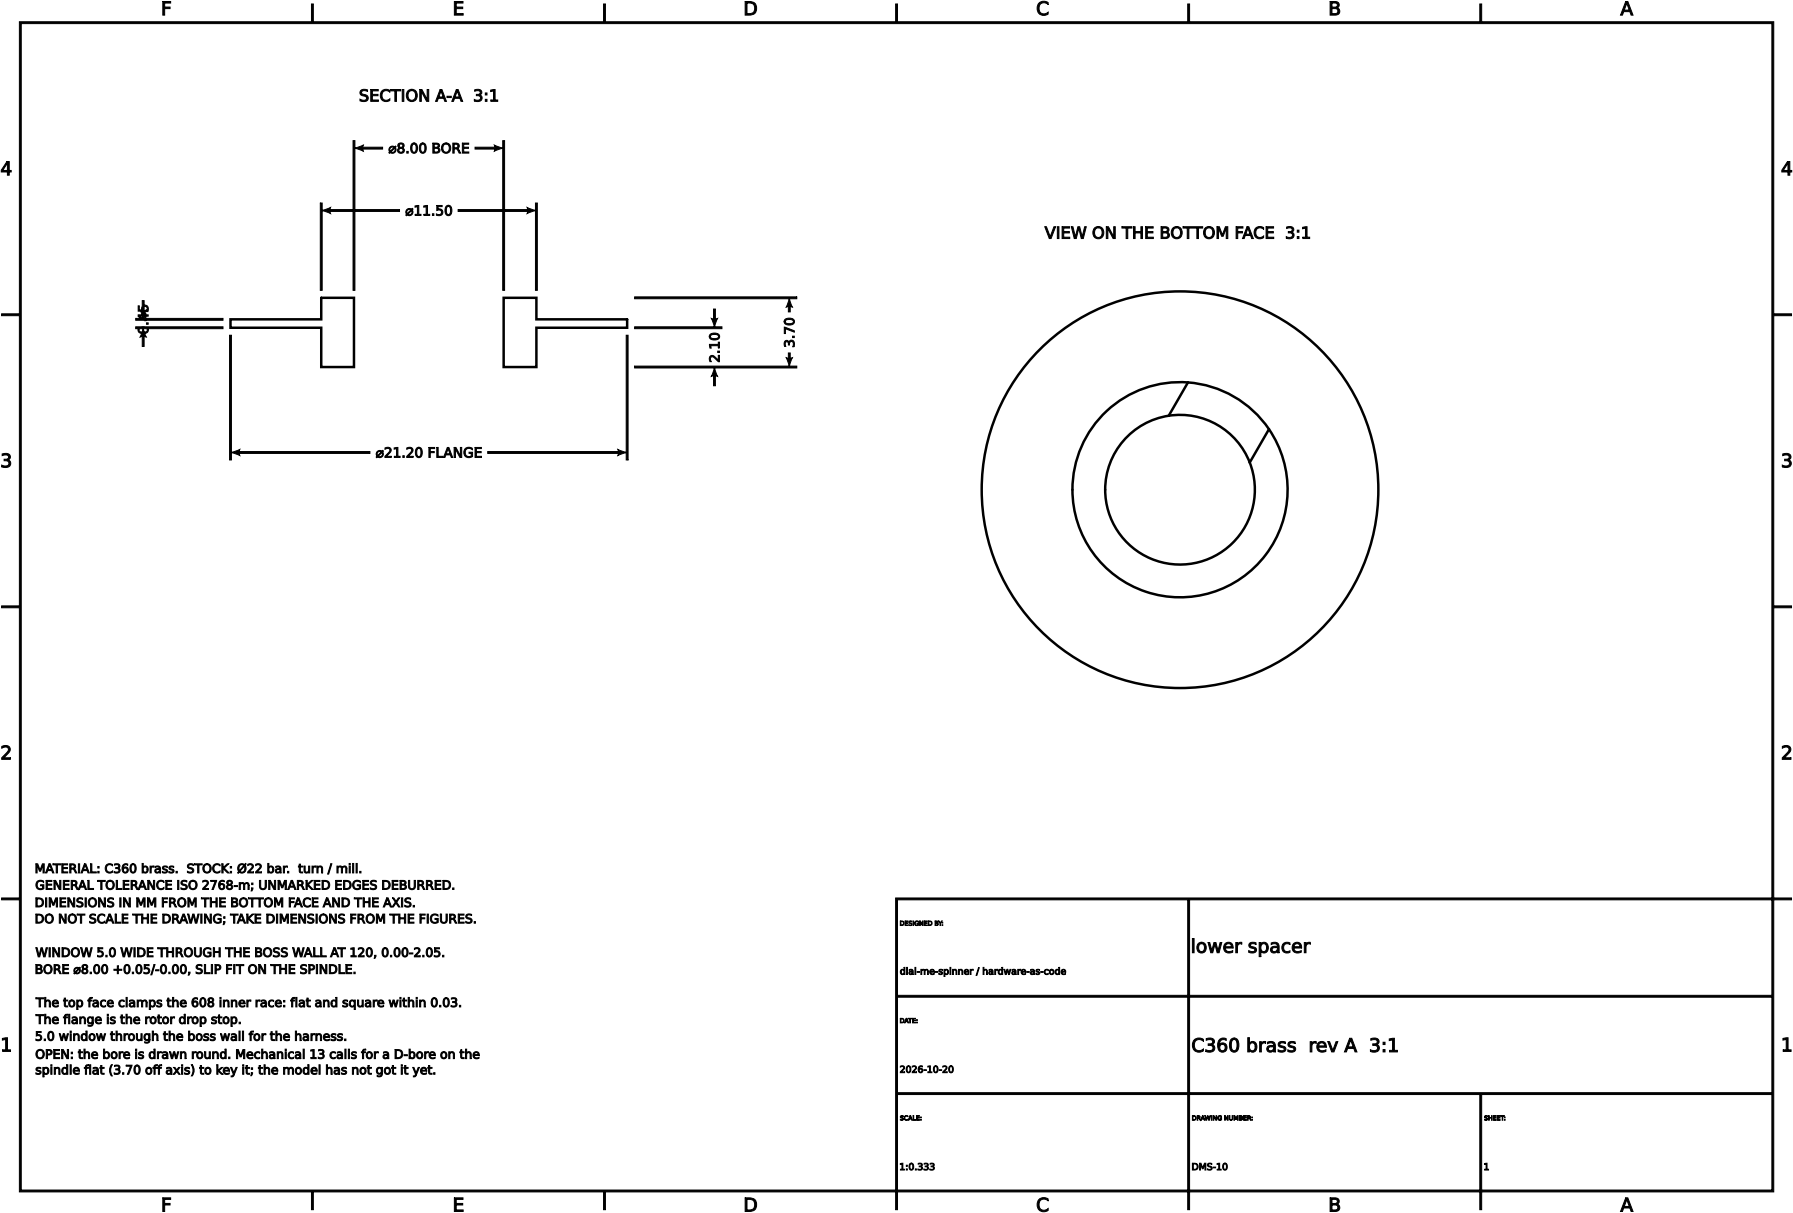
[picture p67: page 1]
