tyevco/dial-me-spinner/hardware/mechanical/drawings/rotor_ring.pdf

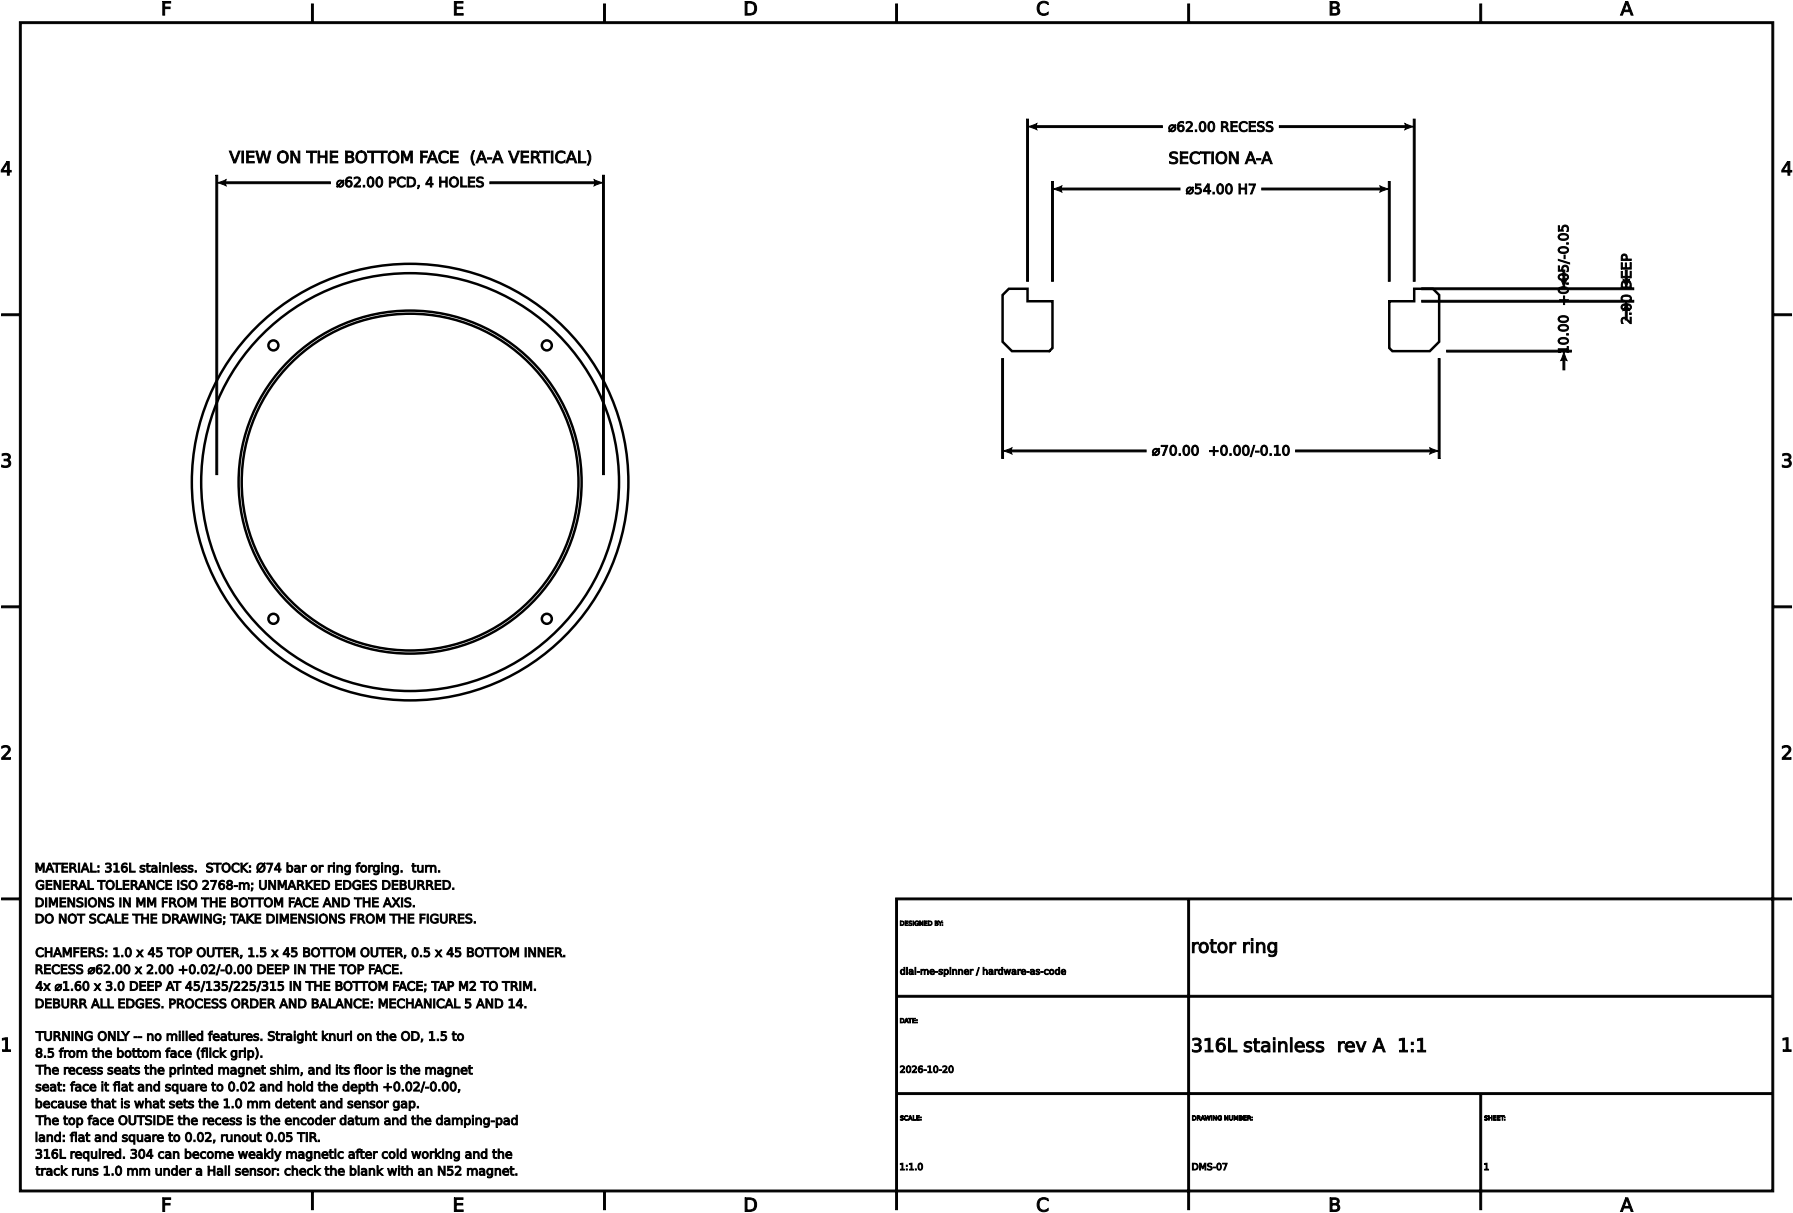
[picture p68: page 1]
