tyevco/dial-me-spinner/hardware/mechanical/drawings/spindle.pdf

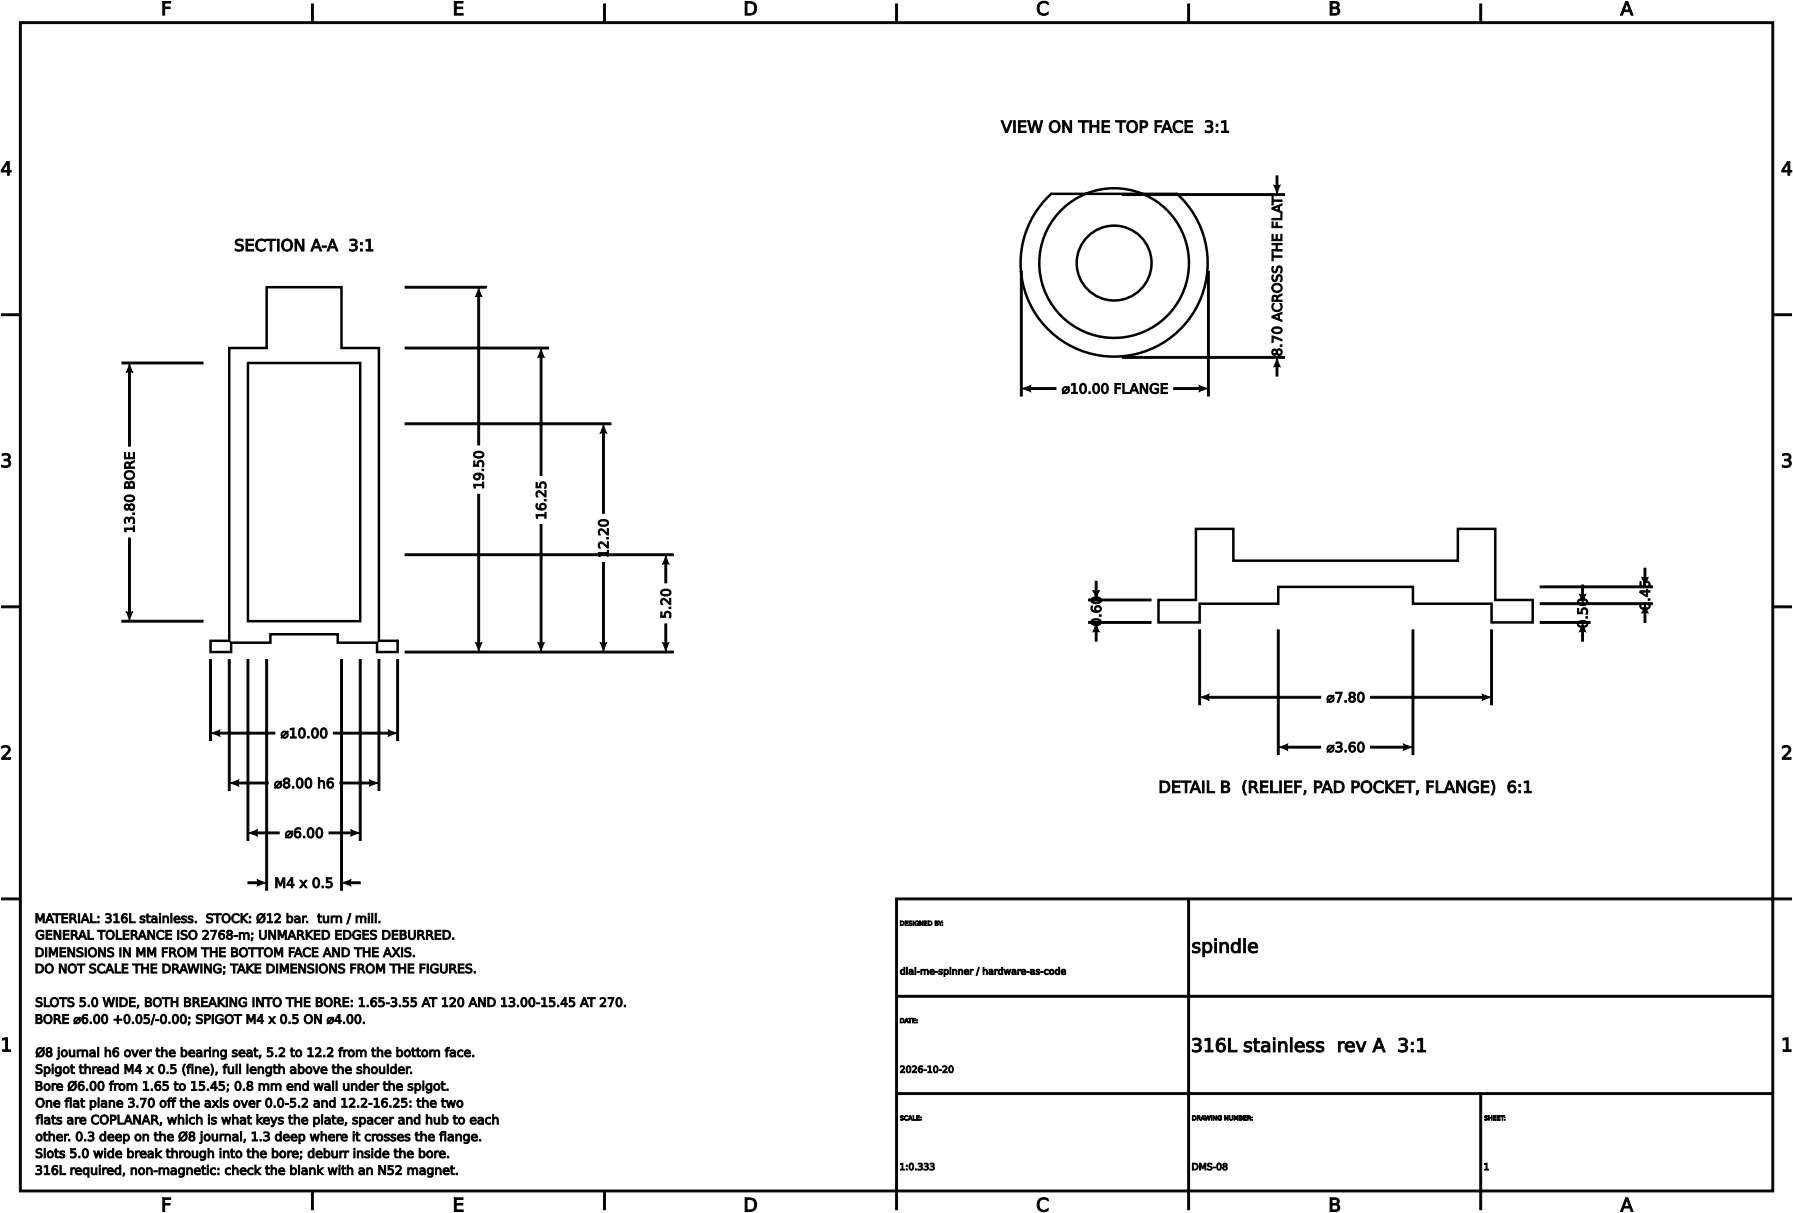
[picture p69: page 1]
