tyevco/dial-me-spinner/hardware/mechanical/drawings/spindle_hub.pdf

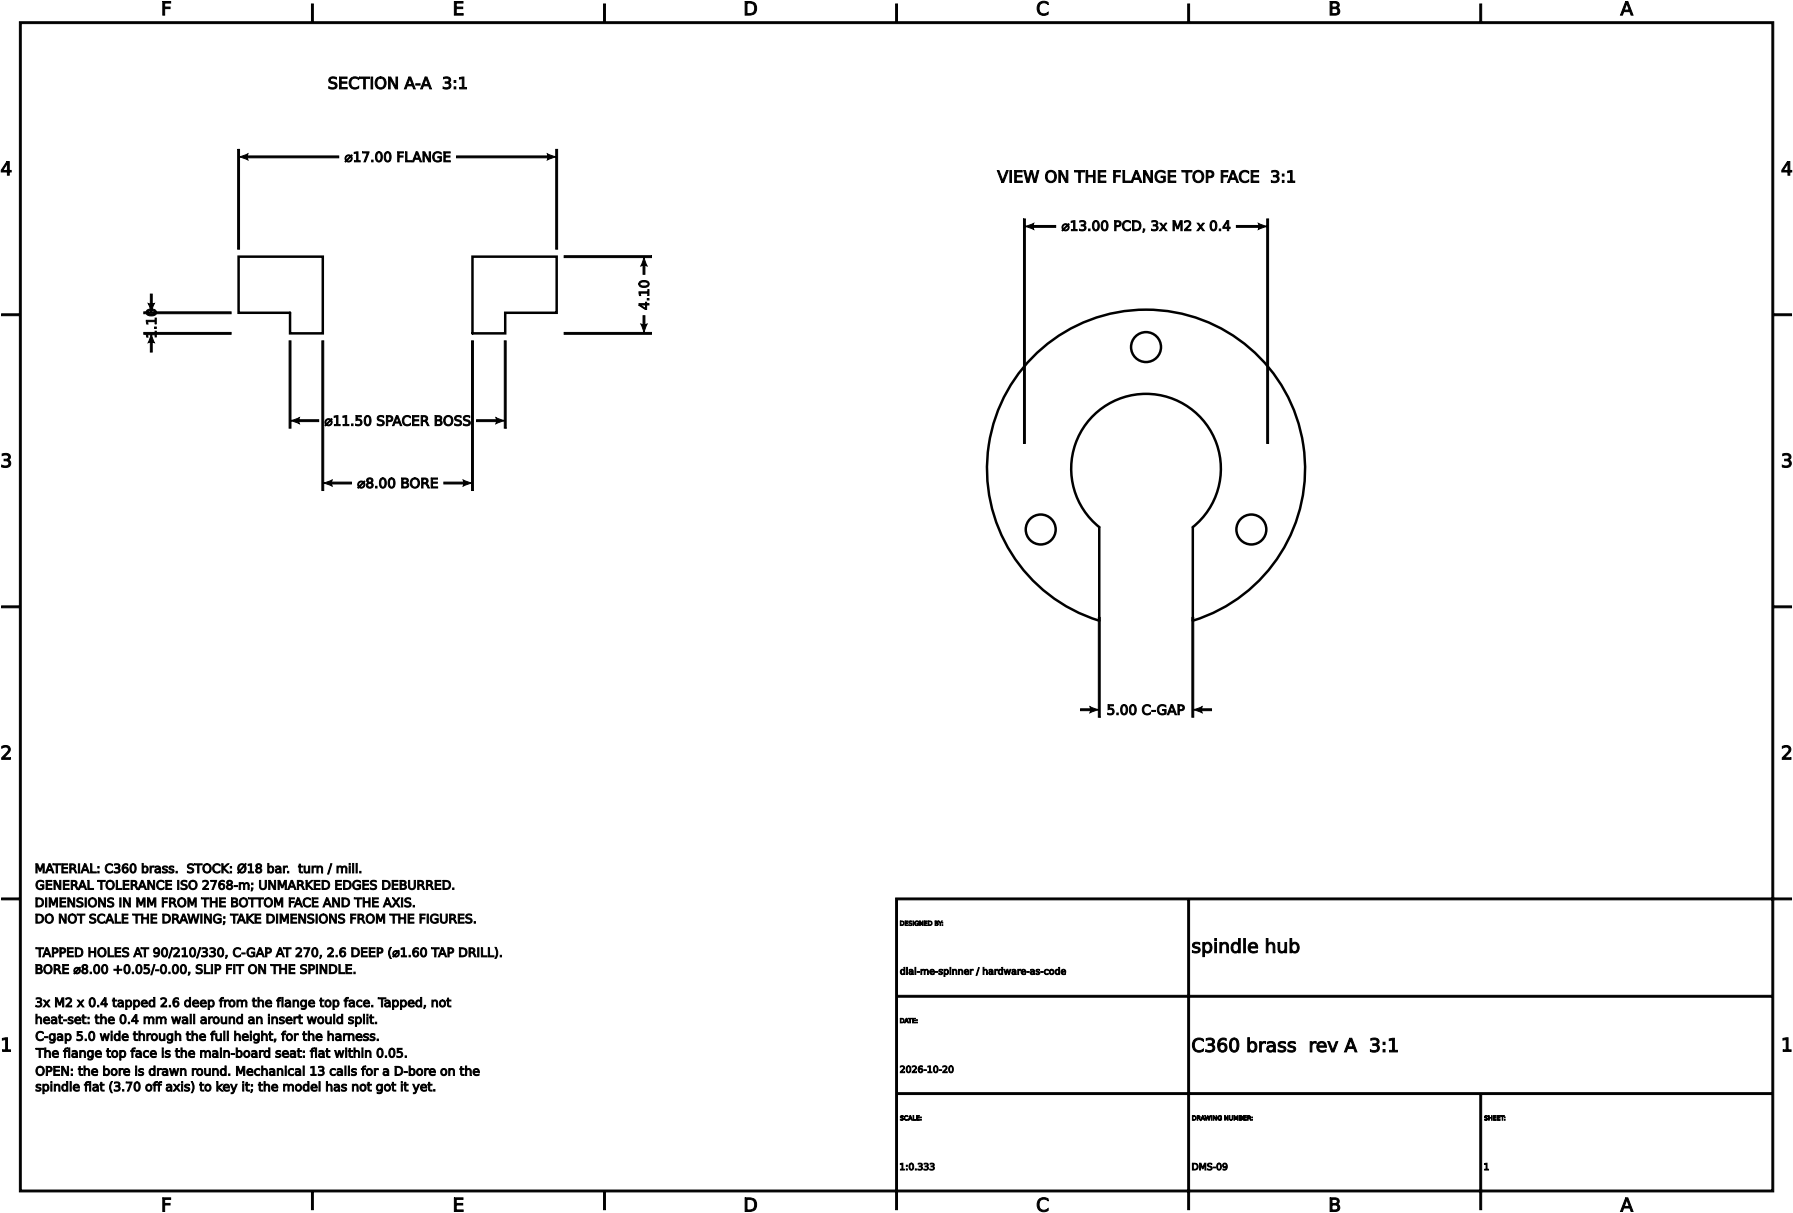
[picture p70: page 1]
