tyevco/dial-me-spinner/hardware/kicad/base/dial-me-spinner-base.kicad_pcb

## KiCad design hardware/kicad/base/dial-me-spinner-base.kicad_pcb (2026-10-20)

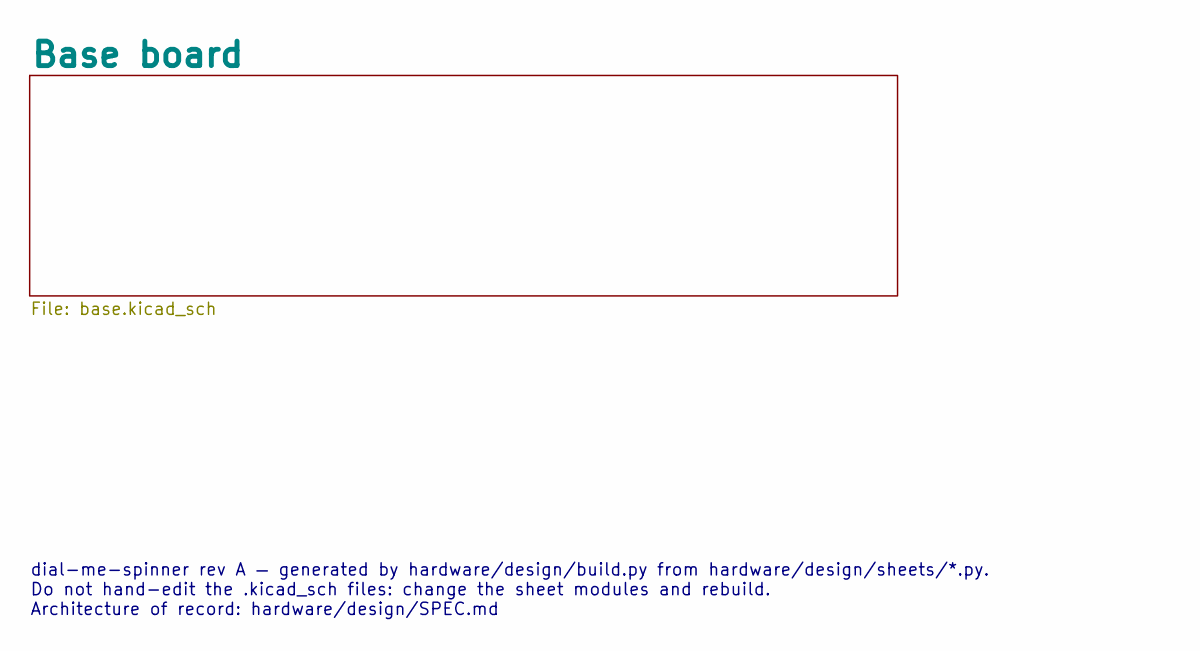
[picture p71: schematic dial-me-spinner-base.kicad_sch, dial-me-spinner base board]

Notes on the sheet:
dial-me-spinner rev A — generated by hardware/design/build.py from hardware/design/sheets/*.py. Do not hand-edit the .kicad_sch files: change the sheet modules and rebuild. Architecture of record: hardware/design/SPEC.md

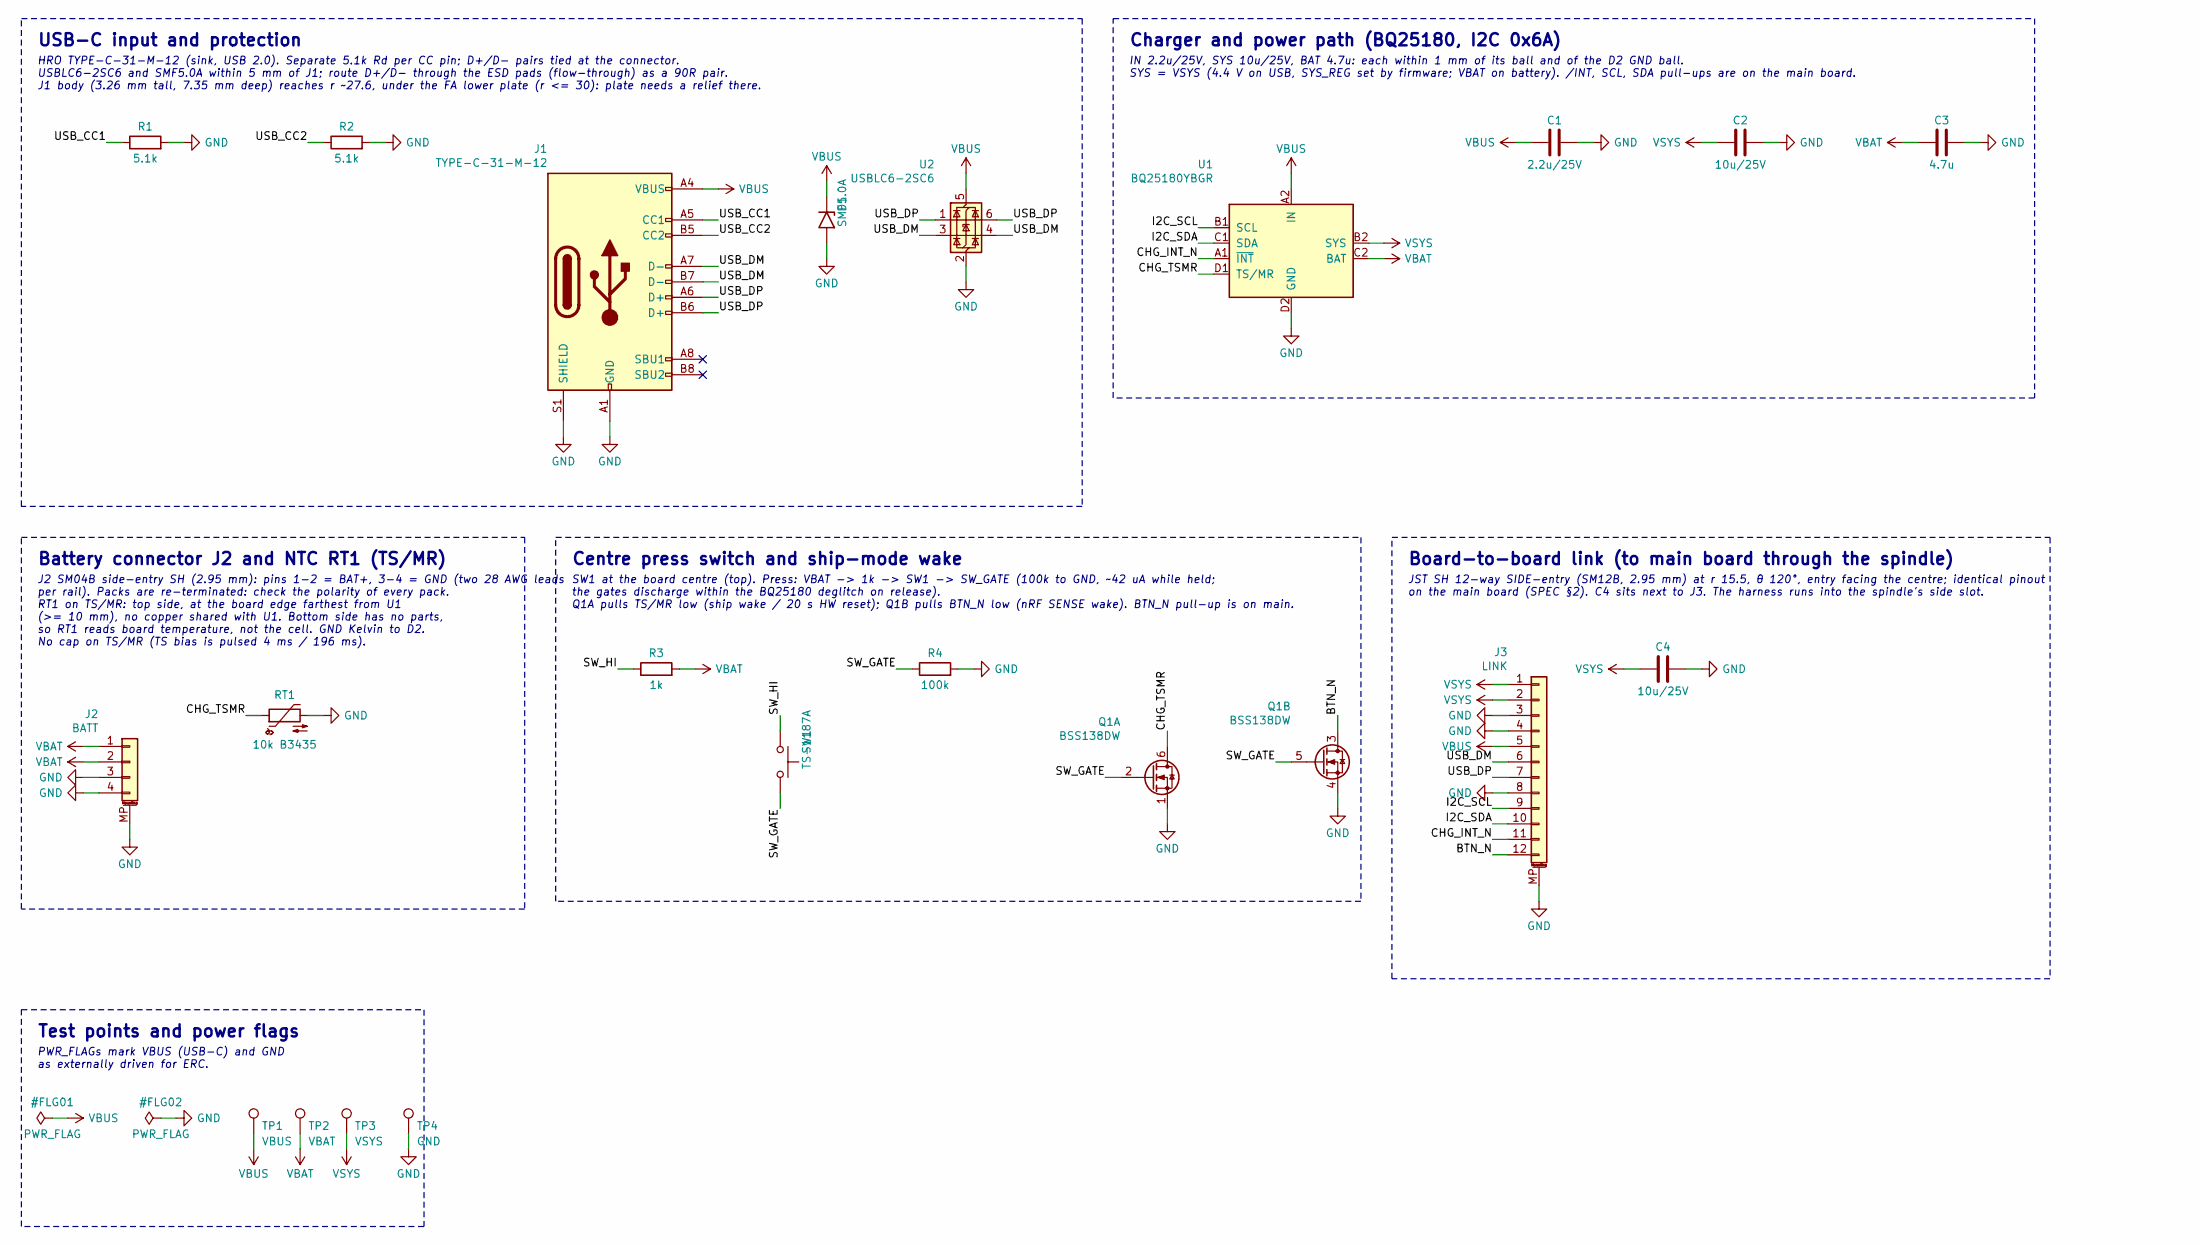
[picture p72: schematic base.kicad_sch, Base board]

Parts:
C1: 2.2u/25V; C_0805_2012Metric; MPN CC0805KKX7R8BB225; LCSC C277470
C2, C4: 10u/25V; C_0603_1608Metric; MPN CL10A106MA8NRNC; LCSC C96446
C3: 4.7u; C_0603_1608Metric; MPN CL10A475KO8NNNC; LCSC C19666
D1: SMF5.0A; D_SMF; MPN SMF5.0A; LCSC C151296
J1: TYPE-C-31-M-12; USB_C_Receptacle_HRO_TYPE-C-31-M-12; MPN TYPE-C-31-M-12; LCSC C165948
J2: BATT; JST_SH_SM04B-SRSS-TB_1x04-1MP_P1.00mm_Horizontal; MPN SM04B-SRSS-TB(LF)(SN); LCSC C160404
J3: LINK; JST_SH_SM12B-SRSS-TB_1x12-1MP_P1.00mm_Horizontal; MPN SM12B-SRSS-TB(LF)(SN); LCSC C160411
Q1: BSS138DW; SOT-363_SC-70-6; MPN BSS138DW-7-F; LCSC C154900
R1, R2: 5.1k; R_0402_1005Metric; MPN 0402WGF5101TCE; LCSC C25905
R3: 1k; R_0402_1005Metric; MPN 0402WGF1001TCE; LCSC C11702
R4: 100k; R_0402_1005Metric; MPN 0402WGF1003TCE; LCSC C25741
RT1: 10k B3435; R_0402_1005Metric; MPN NCP15XH103F03RC; LCSC C77131
SW1: TS-1187A; SW_Push_1P1T_XKB_TS-1187A; MPN TS-1187A-B-A-B; LCSC C318884
TP1: VBUS; TestPoint_Pad_D1.0mm
TP2: VBAT; TestPoint_Pad_D1.0mm
TP3: VSYS; TestPoint_Pad_D1.0mm
TP4: GND; TestPoint_Pad_D1.0mm
U1: BQ25180YBGR; Texas_DSBGA-8_1.04x1.59mm_Layout2x4_P0.4mm_YBG0008; MPN BQ25180YBGR; LCSC C3682423
U2: USBLC6-2SC6; SOT-23-6; MPN USBLC6-2SC6; LCSC C7519

Connections:
/Base board/BTN_N: J3.12, Q1.3 (D)
/Base board/CHG_INT_N: J3.11, U1.A1 (~INT)
/Base board/CHG_TSMR: Q1.6 (D), RT1.1, U1.D1 (TS/MR)
/Base board/I2C_SCL: J3.9, U1.B1 (SCL)
/Base board/I2C_SDA: J3.10, U1.C1 (SDA)
/Base board/SW_GATE: Q1.2 (G), Q1.5 (G), R4.1, SW1.2
/Base board/SW_HI: R3.1, SW1.1
/Base board/USB_CC1: J1.A5 (CC1), R1.1
/Base board/USB_CC2: J1.B5 (CC2), R2.1
/Base board/USB_DM: J1.A7 (D-), J1.B7 (D-), J3.6, U2.3 (I/O2), U2.4 (I/O2)
/Base board/USB_DP: J1.A6 (D+), J1.B6 (D+), J3.7, U2.1 (I/O1), U2.6 (I/O1)
GND: C1.2, C2.2, C3.2, C4.2, D1.2 (A2), J1.A1 (GND), J1.A12 (GND), J1.B1 (GND), J1.B12 (GND), J1.S1 (SHIELD), J2.3, J2.4, J2.MP (MountPin), J3.3, J3.4, J3.8, J3.MP (MountPin), Q1.1 (S), Q1.4 (S), R1.2, R2.2, R4.2, RT1.2, TP4.1, U1.D2 (GND), U2.2 (GND)
VBAT: C3.1, J2.1, J2.2, R3.2, TP2.1, U1.C2 (BAT)
VBUS: C1.1, D1.1 (A1), J1.A4 (VBUS), J1.A9 (VBUS), J1.B4 (VBUS), J1.B9 (VBUS), J3.5, TP1.1, U1.A2 (IN), U2.5 (VBUS)
VSYS: C2.1, C4.1, J3.1, J3.2, TP3.1, U1.B2 (SYS)

Notes on the sheet:
USB-C input and protection
HRO TYPE-C-31-M-12 (sink, USB 2.0). Separate 5.1k Rd per CC pin; D+/D- pairs tied at the connector. USBLC6-2SC6 and SMF5.0A within 5 mm of J1; route D+/D- through the ESD pads (flow-through) as a 90R pair. J1 body (3.26 mm tall, 7.35 mm deep) reaches r ~27.6, under the FA lower plate (r <= 30): pla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
Charger and power path (BQ25180, I2C 0x6A)
IN 2.2u/25V, SYS 10u/25V, BAT 4.7u: each within 1 mm of its ball and of the D2 GND ball. SYS = VSYS (4.4 V on USB, SYS_REG set by firmware; VBAT on battery). /INT, SCL, SDA pull-ups are on the main board.
Battery connector J2 and NTC RT1 (TS/MR)
J2 SM04B side-entry SH (2.95 mm): pins 1-2 = BAT+, 3-4 = GND (two 28 AWG leads per rail). Packs are re-terminated: check the polarity of every pack. RT1 on TS/MR: top side, at the board edge farthest from U1 (>= 10 mm), no copper shared with U1. Bottom side has no parts, so RT1 reads board temperat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
Centre press switch and ship-mode wake
SW1 at the board centre (top). Press: VBAT -> 1k -> SW1 -> SW_GATE (100k to GND, ~42 uA while held; the gates discharge within the BQ25180 deglitch on release). Q1A pulls TS/MR low (ship wake / 20 s HW reset); Q1B pulls BTN_N low (nRF SENSE wake). BTN_N pull-up is on main.
Board-to-board link (to main board through the spindle)
JST SH 12-way SIDE-entry (SM12B, 2.95 mm) at r 15.5, θ 120°, entry facing the centre; identical pinout on the main board (SPEC §2). C4 sits next to J3. The harness runs into the spindle's side slot.
Test points and power flags
PWR_FLAGs mark VBUS (USB-C) and GND as externally driven for ERC.

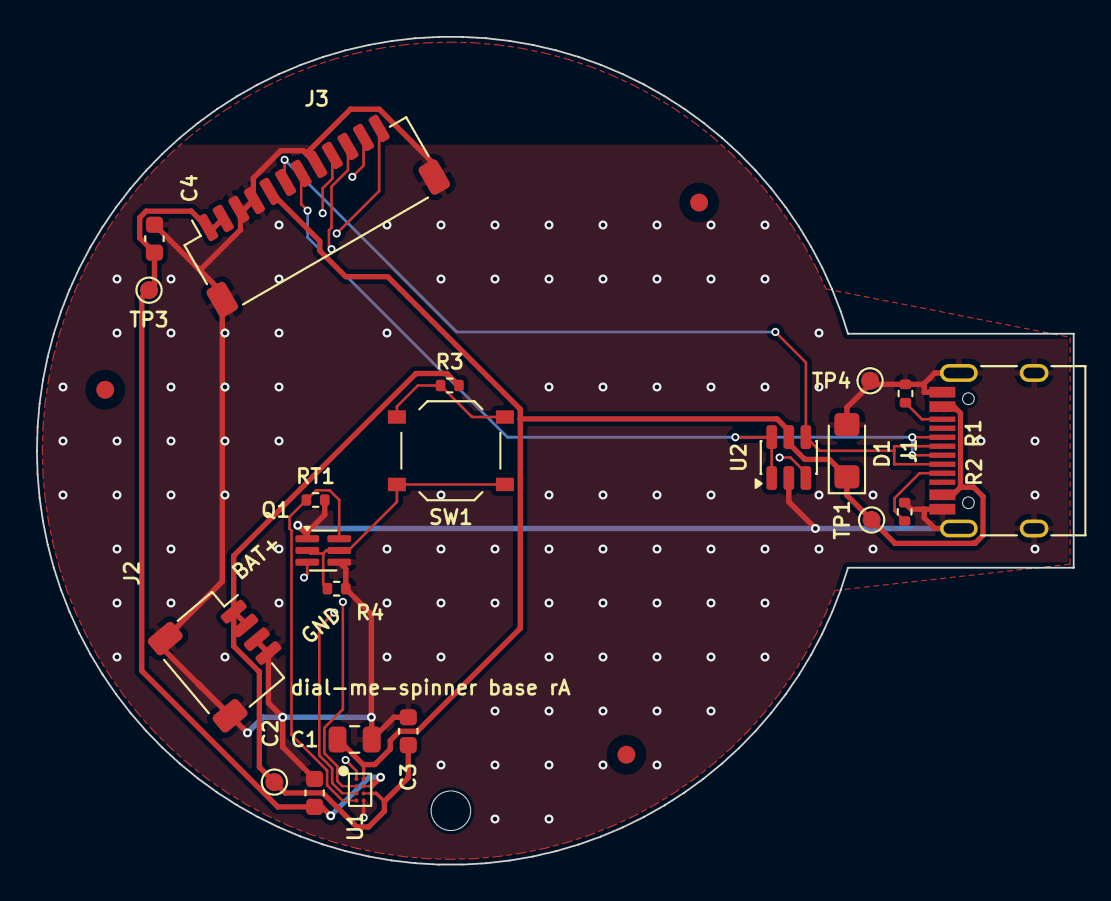
[picture p73: board dial-me-spinner-base.kicad_pcb from above]

Board: 4 copper layers, 57.6 x 46.0 mm, 25 parts (0 on the bottom side), 15 nets.

Other parts of the board:
FID1, FID2, FID3: Fiducial_1mm_Mask2mm
H1: MountingHole_2.2mm_M2
