tyevco/dial-me-spinner/hardware/kicad/main/dial-me-spinner-main.kicad_pcb

## KiCad design hardware/kicad/main/dial-me-spinner-main.kicad_pcb (2026-10-20)

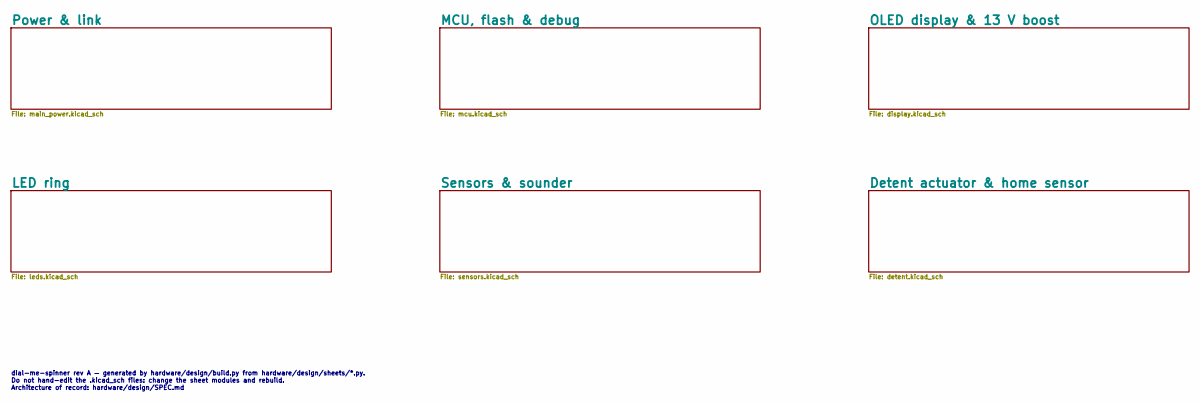
[picture p74: schematic dial-me-spinner-main.kicad_sch, dial-me-spinner main board]

Notes on the sheet:
dial-me-spinner rev A — generated by hardware/design/build.py from hardware/design/sheets/*.py. Do not hand-edit the .kicad_sch files: change the sheet modules and rebuild. Architecture of record: hardware/design/SPEC.md

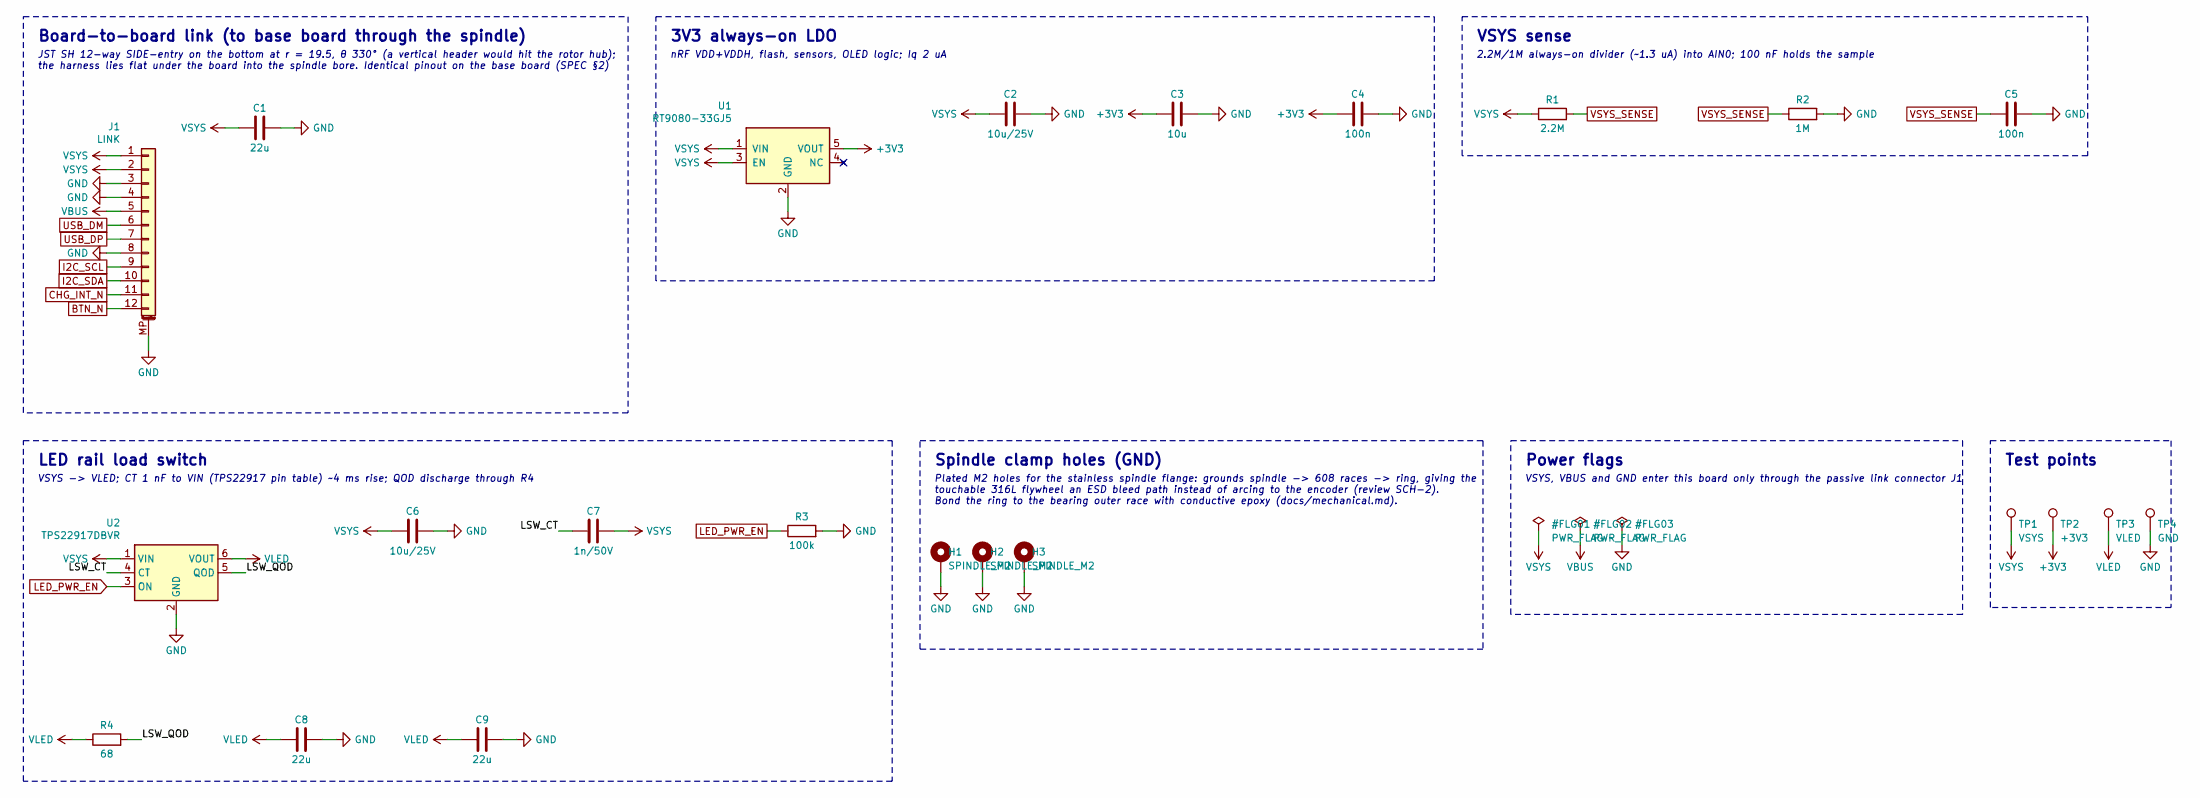
[picture p75: schematic main_power.kicad_sch, Power & link]

Parts:
C1, C8, C9: 22u; C_0805_2012Metric; MPN CL21A226MAQNNNE; LCSC C45783
C2, C6: 10u/25V; C_0603_1608Metric; MPN CL10A106MA8NRNC; LCSC C96446
C3: 10u; C_0603_1608Metric; MPN CL10A106KP8NNNC; LCSC C19702
C4, C5: 100n; C_0402_1005Metric; MPN CL05B104KO5NNNC; LCSC C1525
C7: 1n/50V; C_0402_1005Metric; MPN 0402B102K500NT; LCSC C1523
H1, H2, H3: SPINDLE_M2; MountingHole_2.2mm_M2_Pad_Via
J1: LINK; JST_SH_SM12B-SRSS-TB_1x12-1MP_P1.00mm_Horizontal; MPN SM12B-SRSS-TB(LF)(SN); LCSC C160411
R1: 2.2M; R_0402_1005Metric; MPN 0402WGF2204TCE; LCSC C11490
R2: 1M; R_0402_1005Metric; MPN 0402WGF1004TCE; LCSC C26083
R3: 100k; R_0402_1005Metric; MPN 0402WGF1003TCE; LCSC C25741
R4: 68; R_0402_1005Metric; MPN RC0402FR-0768RL; LCSC C163455
TP1: VSYS; TestPoint_Pad_D1.0mm
TP2: +3V3; TestPoint_Pad_D1.0mm
TP3: VLED; TestPoint_Pad_D1.0mm
TP4: GND; TestPoint_Pad_D1.0mm
U1: RT9080-33GJ5; SOT-23-5; MPN RT9080-33GJ5; LCSC C841192
U2: TPS22917DBVR; SOT-23-6; MPN TPS22917DBVR; LCSC C2681320

Connections:
+3V3: C3.1, C4.1, TP2.1, U1.5 (VOUT); also elsewhere on the board
/Power & link/LSW_CT: C7.1, U2.4 (CT)
/Power & link/LSW_QOD: R4.2, U2.5 (QOD)
BTN_N: J1.12; also elsewhere on the board
CHG_INT_N: J1.11; also elsewhere on the board
GND: C1.2, C2.2, C3.2, C4.2, C5.2, C6.2, C8.2, C9.2, H1.1, H2.1, H3.1, J1.3, J1.4, J1.8, J1.MP (MountPin), R2.2, R3.2, TP4.1, U1.2 (GND), U2.2 (GND); also elsewhere on the board
I2C_SCL: J1.9; also elsewhere on the board
I2C_SDA: J1.10; also elsewhere on the board
LED_PWR_EN: R3.1, U2.3 (ON); also elsewhere on the board
USB_DM: J1.6; also elsewhere on the board
USB_DP: J1.7; also elsewhere on the board
VBUS: J1.5; also elsewhere on the board
VLED: C8.1, C9.1, R4.1, TP3.1, U2.6 (VOUT); also elsewhere on the board
VSYS: C1.1, C2.1, C6.1, C7.2, J1.1, J1.2, R1.1, TP1.1, U1.1 (VIN), U1.3 (EN), U2.1 (VIN); also elsewhere on the board
VSYS_SENSE: C5.1, R1.2, R2.1; also elsewhere on the board

Notes on the sheet:
Board-to-board link (to base board through the spindle)
JST SH 12-way SIDE-entry on the bottom at r = 19.5, θ 330° (a vertical header would hit the rotor hub); the harness lies flat under the board into the spindle bore. Identical pinout on the base board (SPEC §2)
3V3 always-on LDO
nRF VDD+VDDH, flash, sensors, OLED logic; Iq 2 uA
VSYS sense
2.2M/1M always-on divider (~1.3 uA) into AIN0; 100 nF holds the sample
LED rail load switch
VSYS -> VLED; CT 1 nF to VIN (TPS22917 pin table) ~4 ms rise; QOD discharge through R4
Spindle clamp holes (GND)
Plated M2 holes for the stainless spindle flange: grounds spindle -> 608 races -> ring, giving the touchable 316L flywheel an ESD bleed path instead of arcing to the encoder (review SCH-2). Bond the ring to the bearing outer race with conductive epoxy (docs/mechanical.md).
Power flags
VSYS, VBUS and GND enter this board only through the passive link connector J1
Test points

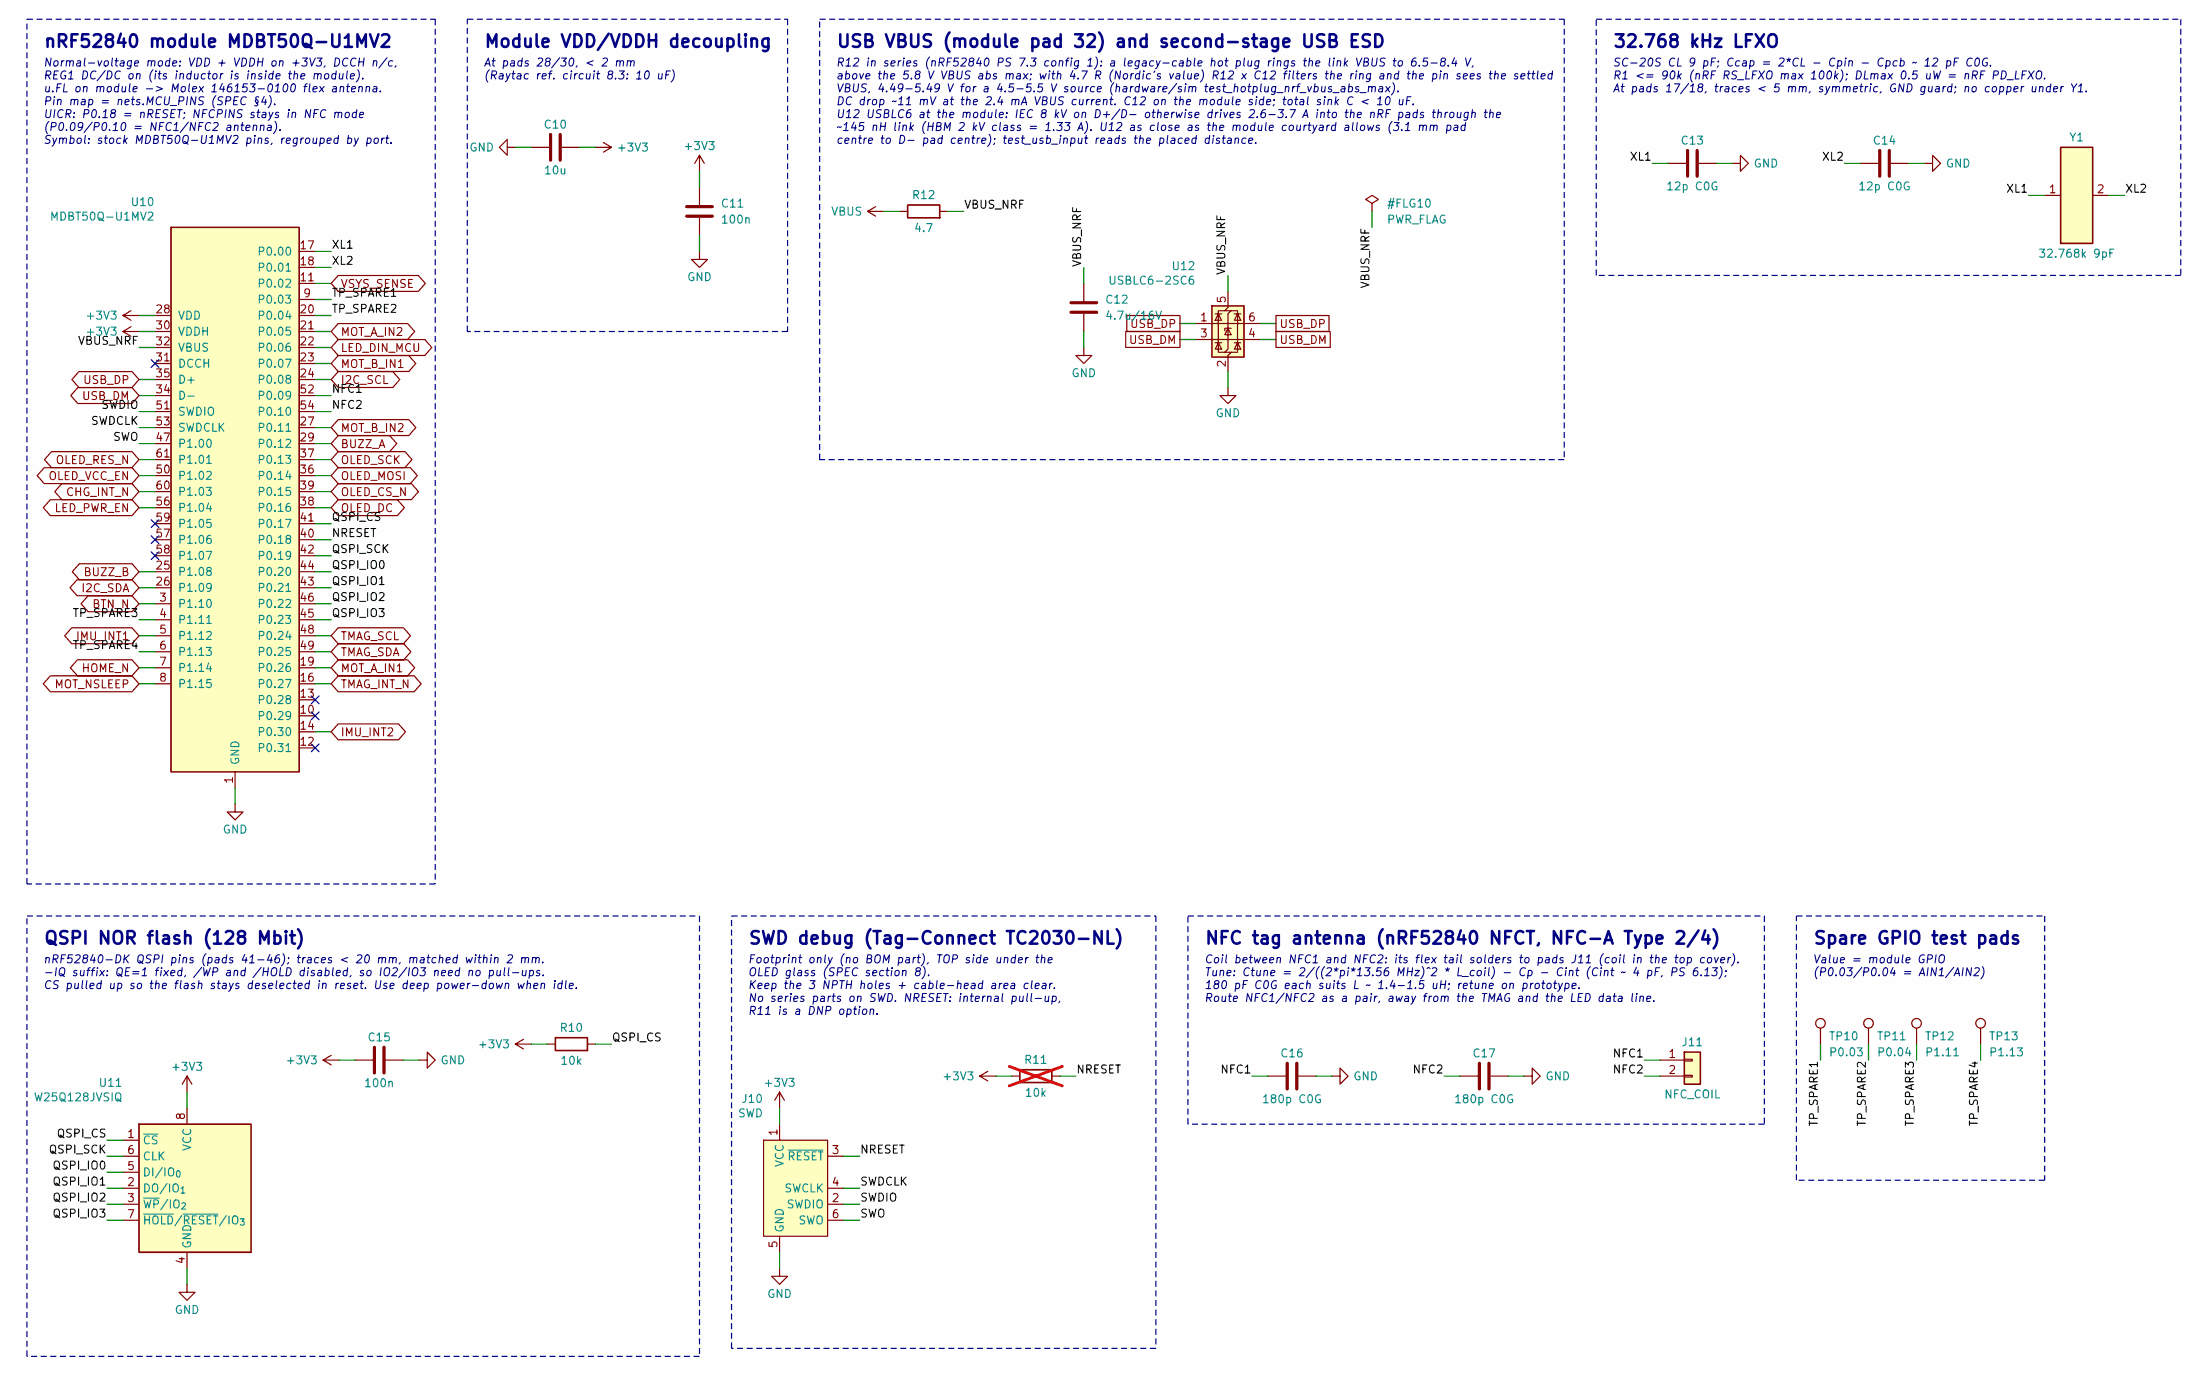
[picture p76: schematic mcu.kicad_sch, MCU, flash & debug]

Parts:
C10: 10u; C_0603_1608Metric; MPN CL10A106KP8NNNC; LCSC C19702
C11, C15: 100n; C_0402_1005Metric; MPN CL05B104KO5NNNC; LCSC C1525
C12: 4.7u/16V; C_0603_1608Metric; MPN CL10A475KO8NNNC; LCSC C19666
C13, C14: 12p C0G; C_0402_1005Metric; MPN 0402CG120J500NT; LCSC C1547
C16, C17: 180p C0G; C_0402_1005Metric; MPN 0402CG181J500NT; LCSC C78636
J10: SWD; Tag-Connect_TC2030-IDC-NL_2x03_P1.27mm_Vertical; MPN TC2030-IDC-NL (footprint only)
J11: NFC_COIL; NFC_Coil_Pads_1x02_P2.0mm
R10: 10k; R_0402_1005Metric; MPN 0402WGF1002TCE; LCSC C25744
R11: 10k; R_0402_1005Metric; MPN 0402WGF1002TCE; LCSC C25744; not fitted
R12: 4.7; R_0402_1005Metric; MPN FRC0402F4R70TS; LCSC C2909356
TP10: P0.03; TestPoint_Pad_D1.0mm
TP11: P0.04; TestPoint_Pad_D1.0mm
TP12: P1.11; TestPoint_Pad_D1.0mm
TP13: P1.13; TestPoint_Pad_D1.0mm
U10: MDBT50Q-U1MV2; Raytac_MDBT50Q_UFL; MPN MDBT50Q-U1MV2; LCSC C2688382
U11: W25Q128JVSIQ; SOIC-8_5.3x5.3mm_P1.27mm; MPN W25Q128JVSIQ; LCSC C97521
U12: USBLC6-2SC6; SOT-23-6; MPN USBLC6-2SC6; LCSC C7519
Y1: 32.768k 9pF; Crystal_SII_SC-20S_2.0x1.2mm; MPN SC-20S 32.768kHz 20PPM 9pF; LCSC C97603

Connections:
+3V3: C10.1, C11.1, C15.1, J10.1 (VCC), R10.1, R11.1, U10.28 (VDD), U10.30 (VDDH), U11.8 (VCC); also elsewhere on the board
/MCU, flash & debug/NFC1: C16.1, J11.1, U10.52 (P0.09)
/MCU, flash & debug/NFC2: C17.1, J11.2, U10.54 (P0.10)
/MCU, flash & debug/NRESET: J10.3 (~RESET), R11.2, U10.40 (P0.18)
/MCU, flash & debug/QSPI_CS: R10.2, U10.41 (P0.17), U11.1 (~CS)
/MCU, flash & debug/QSPI_IO0: U10.44 (P0.20), U11.5 (DI/IO_{0})
/MCU, flash & debug/QSPI_IO1: U10.43 (P0.21), U11.2 (DO/IO_{1})
/MCU, flash & debug/QSPI_IO2: U10.46 (P0.22), U11.3 (~WP/IO_{2})
/MCU, flash & debug/QSPI_IO3: U10.45 (P0.23), U11.7 (~HOLD/~RESET/IO_{3})
/MCU, flash & debug/QSPI_SCK: U10.42 (P0.19), U11.6 (CLK)
/MCU, flash & debug/SWDCLK: J10.4 (SWCLK), U10.53 (SWDCLK)
/MCU, flash & debug/SWDIO: J10.2 (SWDIO), U10.51 (SWDIO)
/MCU, flash & debug/SWO: J10.6 (SWO), U10.47 (P1.00)
/MCU, flash & debug/TP_SPARE1: TP10.1, U10.9 (P0.03)
/MCU, flash & debug/TP_SPARE2: TP11.1, U10.20 (P0.04)
/MCU, flash & debug/TP_SPARE3: TP12.1, U10.4 (P1.11)
/MCU, flash & debug/TP_SPARE4: TP13.1, U10.6 (P1.13)
/MCU, flash & debug/VBUS_NRF: C12.1, R12.2, U10.32 (VBUS), U12.5 (VBUS)
/MCU, flash & debug/XL1: C13.1, U10.17 (P0.00), Y1.1
/MCU, flash & debug/XL2: C14.1, U10.18 (P0.01), Y1.2
BTN_N: U10.3 (P1.10); also elsewhere on the board
BUZZ_A: U10.29 (P0.12); also elsewhere on the board
BUZZ_B: U10.25 (P1.08); also elsewhere on the board
CHG_INT_N: U10.60 (P1.03); also elsewhere on the board
GND: C10.2, C11.2, C12.2, C13.2, C14.2, C15.2, C16.2, C17.2, J10.5 (GND), U10.1 (GND), U10.2 (GND), U10.15 (GND), U10.33 (GND), U10.55 (GND), U11.4 (GND), U12.2 (GND); also elsewhere on the board
HOME_N: U10.7 (P1.14); also elsewhere on the board
I2C_SCL: U10.24 (P0.08); also elsewhere on the board
I2C_SDA: U10.26 (P1.09); also elsewhere on the board
IMU_INT1: U10.5 (P1.12); also elsewhere on the board
IMU_INT2: U10.14 (P0.30); also elsewhere on the board
LED_DIN_MCU: U10.22 (P0.06); also elsewhere on the board
LED_PWR_EN: U10.56 (P1.04); also elsewhere on the board
MOT_A_IN1: U10.19 (P0.26); also elsewhere on the board
MOT_A_IN2: U10.21 (P0.05); also elsewhere on the board
MOT_B_IN1: U10.23 (P0.07); also elsewhere on the board
MOT_B_IN2: U10.27 (P0.11); also elsewhere on the board
MOT_NSLEEP: U10.8 (P1.15); also elsewhere on the board
OLED_CS_N: U10.39 (P0.15); also elsewhere on the board
OLED_DC: U10.38 (P0.16); also elsewhere on the board
OLED_MOSI: U10.36 (P0.14); also elsewhere on the board
OLED_RES_N: U10.61 (P1.01); also elsewhere on the board
OLED_SCK: U10.37 (P0.13); also elsewhere on the board
OLED_VCC_EN: U10.50 (P1.02); also elsewhere on the board
TMAG_INT_N: U10.16 (P0.27); also elsewhere on the board
TMAG_SCL: U10.48 (P0.24); also elsewhere on the board
TMAG_SDA: U10.49 (P0.25); also elsewhere on the board
USB_DM: U10.34 (D-), U12.3 (I/O2), U12.4 (I/O2); also elsewhere on the board
USB_DP: U10.35 (D+), U12.1 (I/O1), U12.6 (I/O1); also elsewhere on the board
VBUS: R12.1; also elsewhere on the board
VSYS_SENSE: U10.11 (P0.02); also elsewhere on the board

Notes on the sheet:
nRF52840 module MDBT50Q-U1MV2
Normal-voltage mode: VDD + VDDH on +3V3, DCCH n/c, REG1 DC/DC on (its inductor is inside the module). u.FL on module -> Molex 146153-0100 flex antenna. Pin map = nets.MCU_PINS (SPEC §4). UICR: P0.18 = nRESET; NFCPINS stays in NFC mode (P0.09/P0.10 = NFC1/NFC2 antenna). Symbol: stock MDBT50Q-U1MV2 p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
Module VDD/VDDH decoupling
At pads 28/30, < 2 mm (Raytac ref. circuit 8.3: 10 uF)
USB VBUS (module pad 32) and second-stage USB ESD
R12 in series (nRF52840 PS 7.3 config 1): a legacy-cable hot plug rings the link VBUS to 6.5-8.4 V, above the 5.8 V VBUS abs max; with 4.7 R (Nordic's value) R12 x C12 filters the ring and the pin sees the settled VBUS, 4.49-5.49 V for a 4.5-5.5 V source (hardware/sim test_hotplug_nrf_vbus_abs_max)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
32.768 kHz LFXO
SC-20S CL 9 pF; Ccap = 2*CL - Cpin - Cpcb ~ 12 pF C0G. R1 <= 90k (nRF RS_LFXO max 100k); DLmax 0.5 uW = nRF PD_LFXO. At pads 17/18, traces < 5 mm, symmetric, GND guard; no copper under Y1.
QSPI NOR flash (128 Mbit)
nRF52840-DK QSPI pins (pads 41-46); traces < 20 mm, matched within 2 mm. -IQ suffix: QE=1 fixed, /WP and /HOLD disabled, so IO2/IO3 need no pull-ups. CS pulled up so the flash stays deselected in reset. Use deep power-down when idle.
SWD debug (Tag-Connect TC2030-NL)
Footprint only (no BOM part), TOP side under the OLED glass (SPEC section 8). Keep the 3 NPTH holes + cable-head area clear. No series parts on SWD. NRESET: internal pull-up, R11 is a DNP option.
NFC tag antenna (nRF52840 NFCT, NFC-A Type 2/4)
Coil between NFC1 and NFC2: its flex tail solders to pads J11 (coil in the top cover). Tune: Ctune = 2/((2*pi*13.56 MHz)^2 * L_coil) - Cp - Cint (Cint ~ 4 pF, PS 6.13); 180 pF C0G each suits L ~ 1.4-1.5 uH; retune on prototype. Route NFC1/NFC2 as a pair, away from the TMAG and the LED data line.
Spare GPIO test pads
Value = module GPIO (P0.03/P0.04 = AIN1/AIN2)

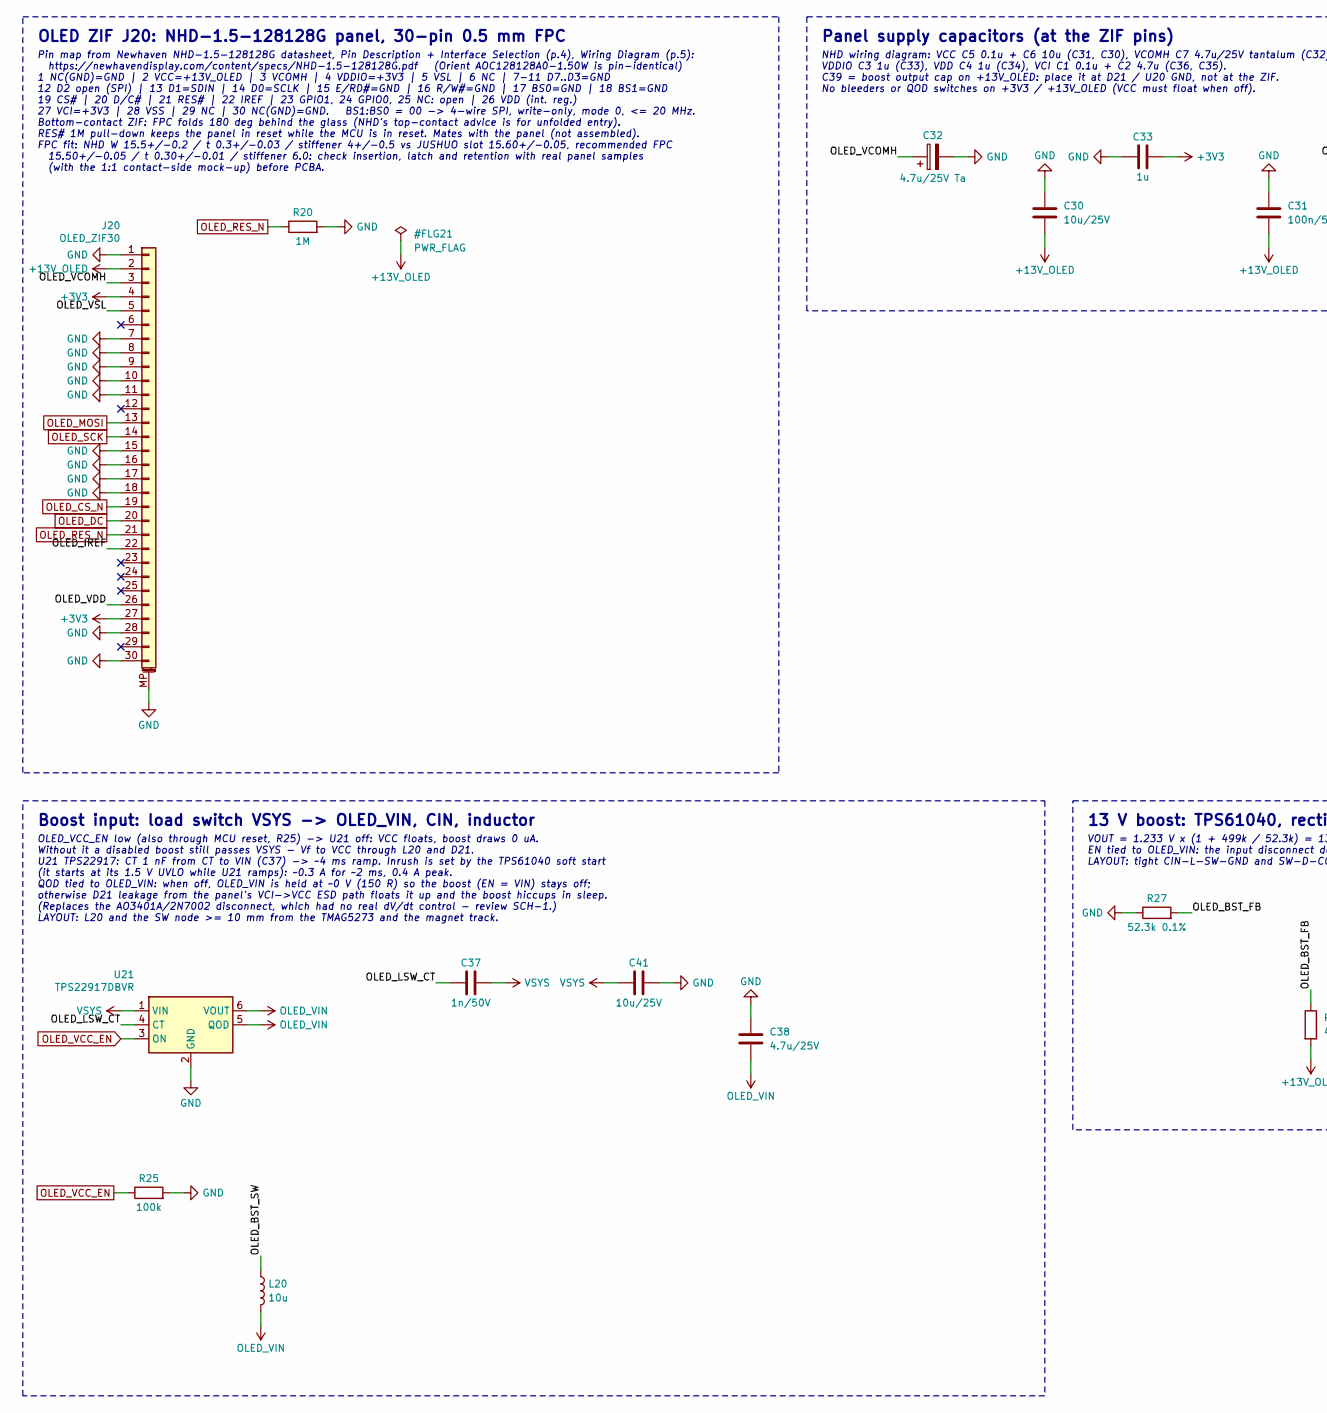
[picture p77: schematic display.kicad_sch, OLED display & 13 V boost, part in row 1, column 1]

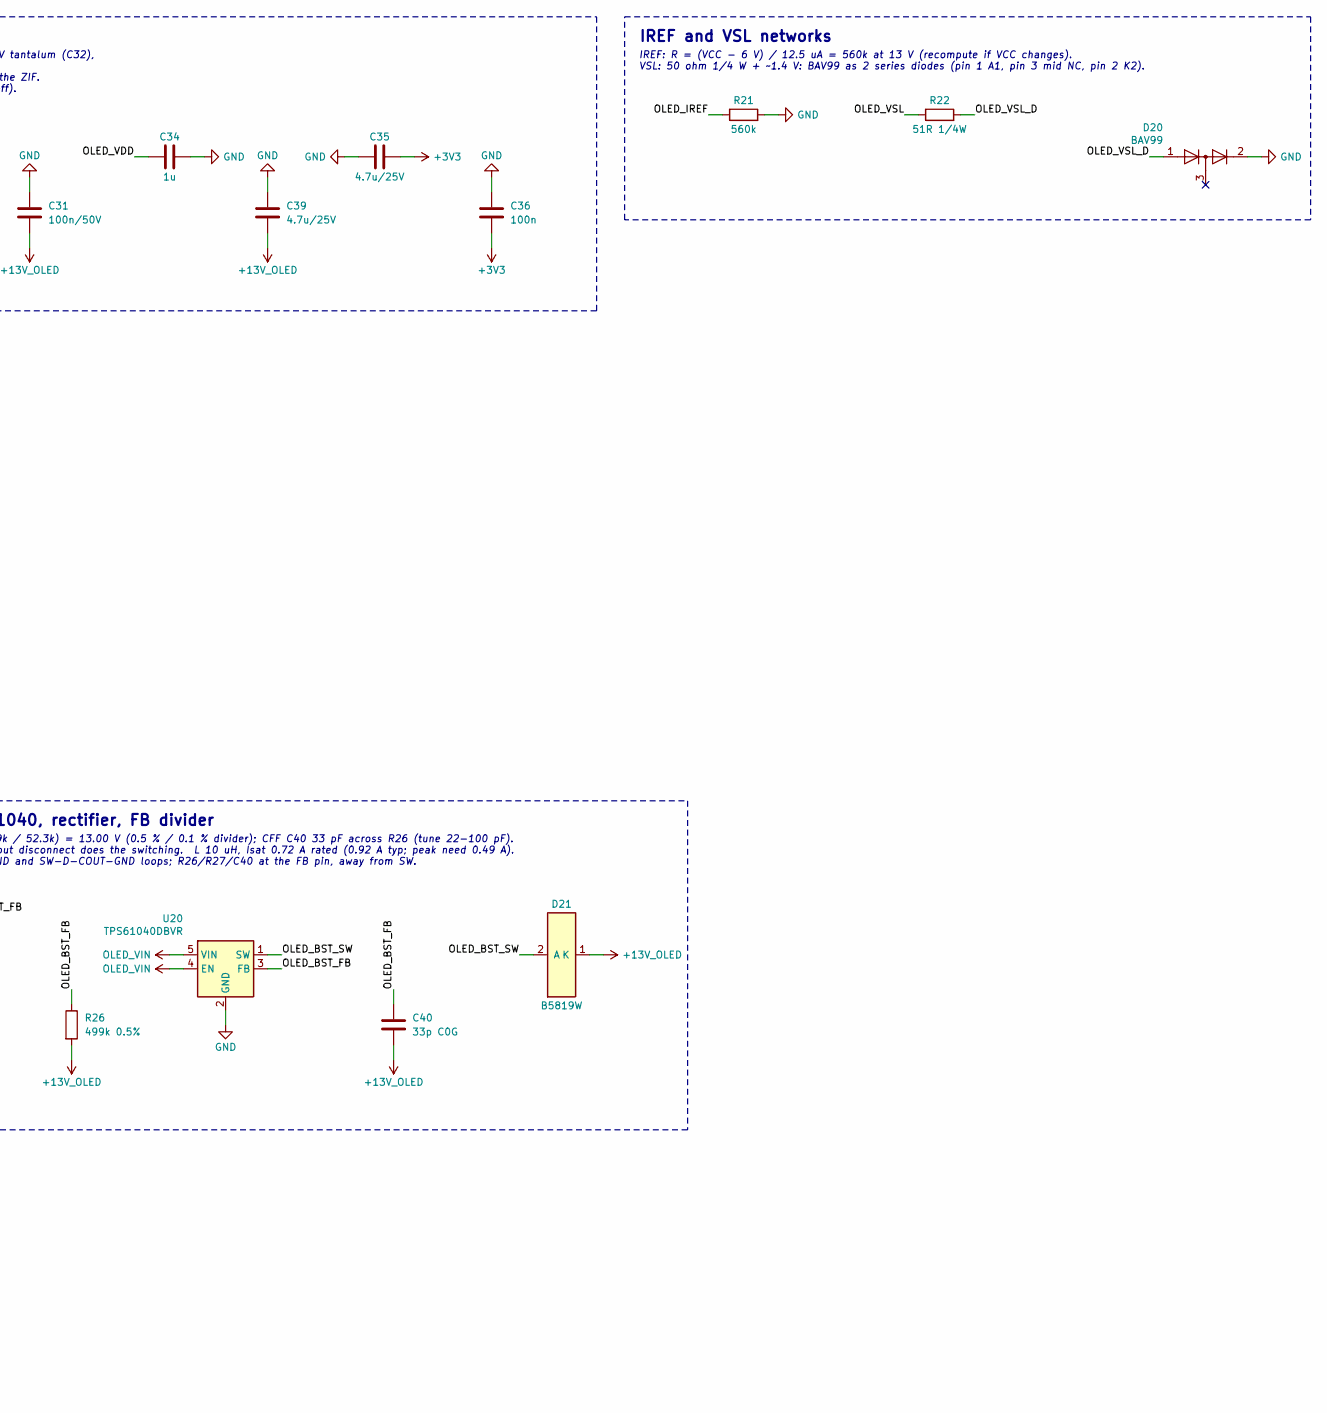
[picture p78: schematic display.kicad_sch, OLED display & 13 V boost, part in row 1, column 2]

Parts:
C30: 10u/25V; C_0805_2012Metric; MPN CL21A106KAYNNNE; LCSC C15850
C31: 100n/50V; C_0402_1005Metric; MPN CL05B104KB54PNC; LCSC C307331
C32: 4.7u/25V Ta; CP_EIA-3216-18_Kemet-A; MPN TAJA475K025RNJ; LCSC C7189
C33, C34: 1u; C_0402_1005Metric; MPN CL05A105KA5NQNC; LCSC C52923
C35, C38, C39: 4.7u/25V; C_0805_2012Metric; MPN CL21A475KAQNNNE; LCSC C1779
C36: 100n; C_0402_1005Metric; MPN CL05B104KO5NNNC; LCSC C1525
C37: 1n/50V; C_0402_1005Metric; MPN 0402B102K500NT; LCSC C1523
C40: 33p C0G; C_0402_1005Metric; MPN 0402CG330J500NT; LCSC C1562
C41: 10u/25V; C_0603_1608Metric; MPN CL10A106MA8NRNC; LCSC C96446
D20: BAV99; SOT-23; MPN BAV99,215; LCSC C2500
D21: B5819W; D_SOD-123; MPN B5819W SL; LCSC C8598
J20: OLED_ZIF30; JUSHUO_AFC01-S30FCA-00_1x30-1MP_P0.50mm_Horizontal; MPN AFC01-S30FCA-00; LCSC C262671
L20: 10u; L_Sunlord_SWPA3015S; MPN SWPA3015S100MT; LCSC C45403
R20: 1M; R_0402_1005Metric; MPN 0402WGF1004TCE; LCSC C26083
R21: 560k; R_0402_1005Metric; MPN 0402WGF5603TCE; LCSC C132339
R22: 51R 1/4W; R_1206_3216Metric; MPN 1206W4F510JT5E; LCSC C18019
R25: 100k; R_0402_1005Metric; MPN 0402WGF1003TCE; LCSC C25741
R26: 499k 0.5%; R_0402_1005Metric; MPN RC0402DR-07499KL; LCSC C4167968
R27: 52.3k 0.1%; R_0402_1005Metric; MPN RT0402BRD0752K3L; LCSC C852832
U20: TPS61040DBVR; SOT-23-5; MPN TPS61040DBVR; LCSC C7722
U21: TPS22917DBVR; SOT-23-6; MPN TPS22917DBVR; LCSC C2681320

Connections:
+3V3: C33.2, C35.2, C36.2, J20.4, J20.27; also elsewhere on the board
+13V_OLED: C30.2, C31.2, C39.2, C40.2, D21.1 (K), J20.2, R26.2
/OLED display & 13 V boost/OLED_BST_FB: C40.1, R26.1, R27.2, U20.3 (FB)
/OLED display & 13 V boost/OLED_BST_SW: D21.2 (A), L20.1, U20.1 (SW)
/OLED display & 13 V boost/OLED_IREF: J20.22, R21.1
/OLED display & 13 V boost/OLED_LSW_CT: C37.1, U21.4 (CT)
/OLED display & 13 V boost/OLED_VCOMH: C32.1, J20.3
/OLED display & 13 V boost/OLED_VDD: C34.1, J20.26
/OLED display & 13 V boost/OLED_VSL: J20.5, R22.1
/OLED display & 13 V boost/OLED_VSL_D: D20.1 (K), R22.2
GND: C30.1, C31.1, C32.2, C33.1, C34.2, C35.1, C36.1, C38.1, C39.1, C41.2, D20.2 (A), J20.1, J20.7, J20.8, J20.9, J20.10, J20.11, J20.15, J20.16, J20.17, J20.18, J20.28, J20.30, J20.MP (MountPin), R20.2, R21.2, R25.2, R27.1, U20.2 (GND), U21.2 (GND); also elsewhere on the board
OLED_CS_N: J20.19; also elsewhere on the board
OLED_DC: J20.20; also elsewhere on the board
OLED_MOSI: J20.13; also elsewhere on the board
OLED_RES_N: J20.21, R20.1; also elsewhere on the board
OLED_SCK: J20.14; also elsewhere on the board
OLED_VCC_EN: R25.1, U21.3 (ON); also elsewhere on the board
OLED_VIN: C38.2, L20.2, U20.4 (EN), U20.5 (VIN), U21.5 (QOD), U21.6 (VOUT)
VSYS: C37.2, C41.1, U21.1 (VIN); also elsewhere on the board

Notes on the sheet:
OLED ZIF J20: NHD-1.5-128128G panel, 30-pin 0.5 mm FPC
Pin map from Newhaven NHD-1.5-128128G datasheet, Pin Description + Interface Selection (p.4), Wiring Diagram (p.5): https://newhavendisplay.com/content/specs/NHD-1.5-128128G.pdf (Orient AOC128128A0-1.50W is pin-identical) 1 NC(GND)=GND | 2 VCC=+13V_OLED | 3 VCOMH | 4 VDDIO=+3V3 | 5 VSL | 6 NC | 7-1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
Panel supply capacitors (at the ZIF pins)
NHD wiring diagram: VCC C5 0.1u + C6 10u (C31, C30), VCOMH C7 4.7u/25V tantalum (C32), VDDIO C3 1u (C33), VDD C4 1u (C34), VCI C1 0.1u + C2 4.7u (C36, C35). C39 = boost output cap on +13V_OLED: place it at D21 / U20 GND, not at the ZIF. No bleeders or QOD switches on +3V3 / +13V_OLED (VCC must floa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
IREF and VSL networks
IREF: R = (VCC - 6 V) / 12.5 uA = 560k at 13 V (recompute if VCC changes). VSL: 50 ohm 1/4 W + ~1.4 V: BAV99 as 2 series diodes (pin 1 A1, pin 3 mid NC, pin 2 K2).
Boost input: load switch VSYS -> OLED_VIN, CIN, inductor
OLED_VCC_EN low (also through MCU reset, R25) -> U21 off: VCC floats, boost draws 0 uA. Without it a disabled boost still passes VSYS - Vf to VCC through L20 and D21. U21 TPS22917: CT 1 nF from CT to VIN (C37) -> ~4 ms ramp. Inrush is set by the TPS61040 soft start (it starts at its 1.5 V UVLO whil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
13 V boost: TPS61040, rectifier, FB divider
VOUT = 1.233 V x (1 + 499k / 52.3k) = 13.00 V (0.5 % / 0.1 % divider); CFF C40 33 pF across R26 (tune 22-100 pF). EN tied to OLED_VIN: the input disconnect does the switching. L 10 uH, Isat 0.72 A rated (0.92 A typ; peak need 0.49 A). LAYOUT: tight CIN-L-SW-GND and SW-D-COUT-GND loops; R26/R27/C40 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
