tyevco/dial-me-spinner/hardware/kicad/main/dial-me-spinner-main.kicad_pcb

## KiCad design hardware/kicad/main/dial-me-spinner-main.kicad_pcb (continued)

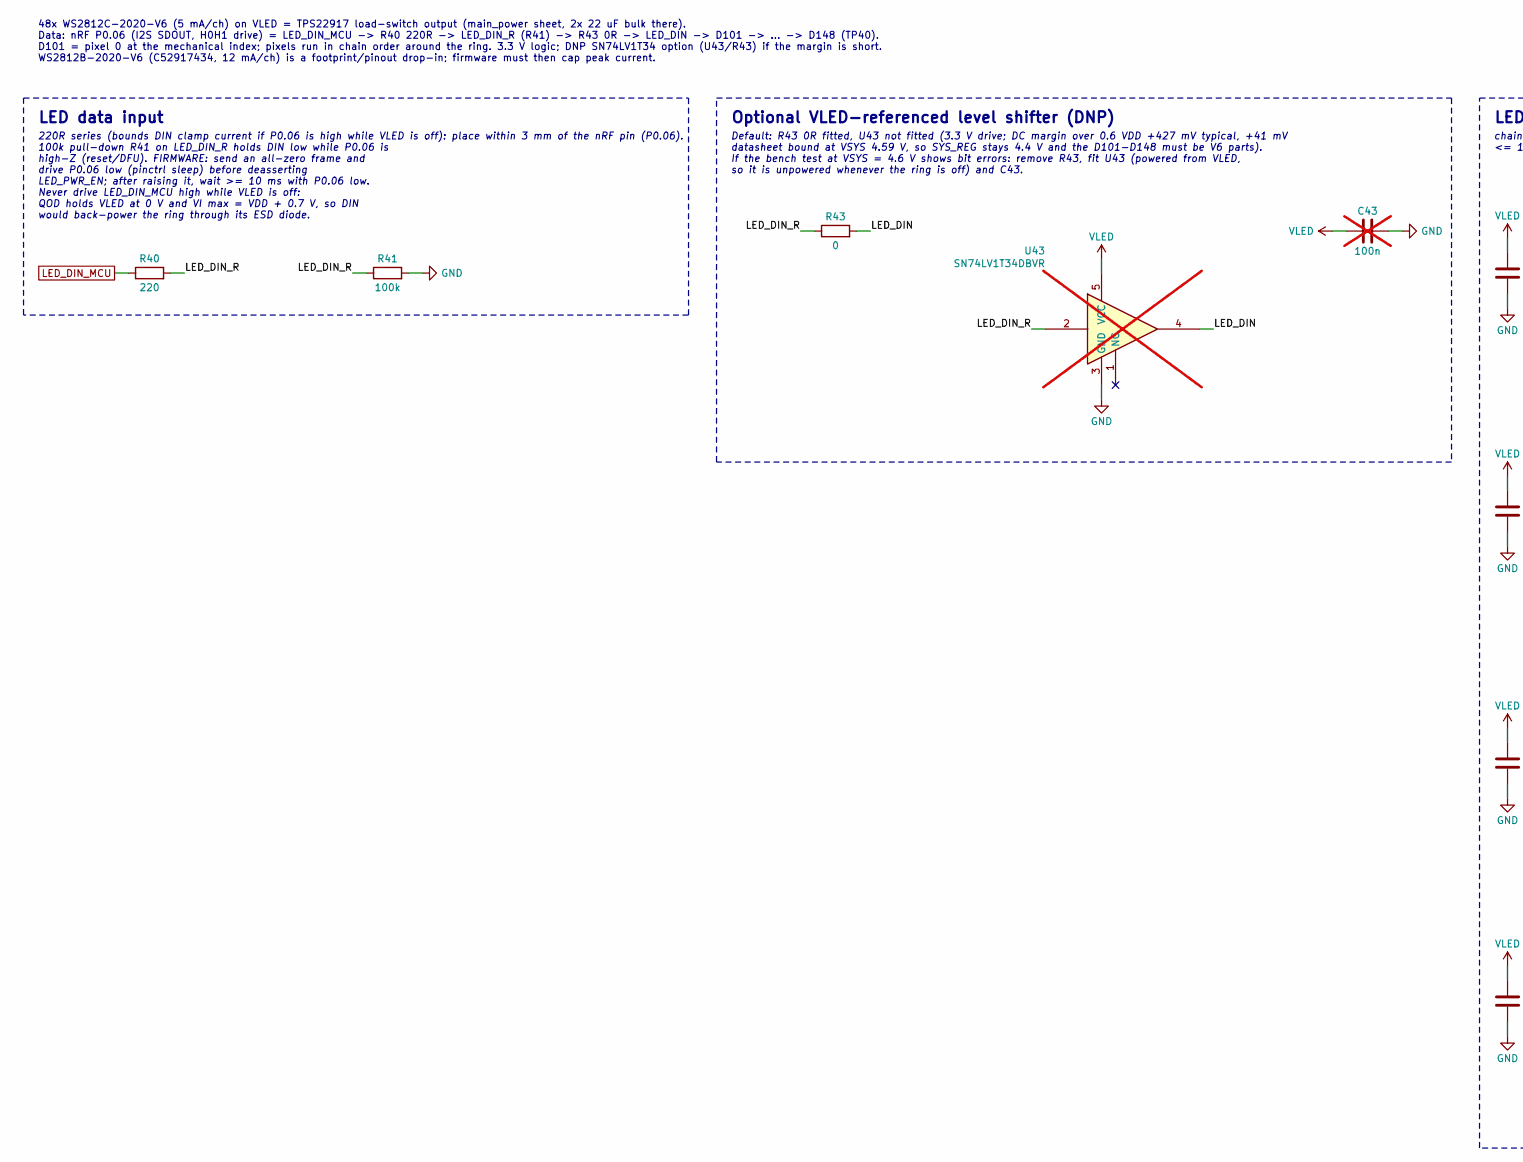
[picture p79: schematic leds.kicad_sch, LED ring, part in row 1, column 1]

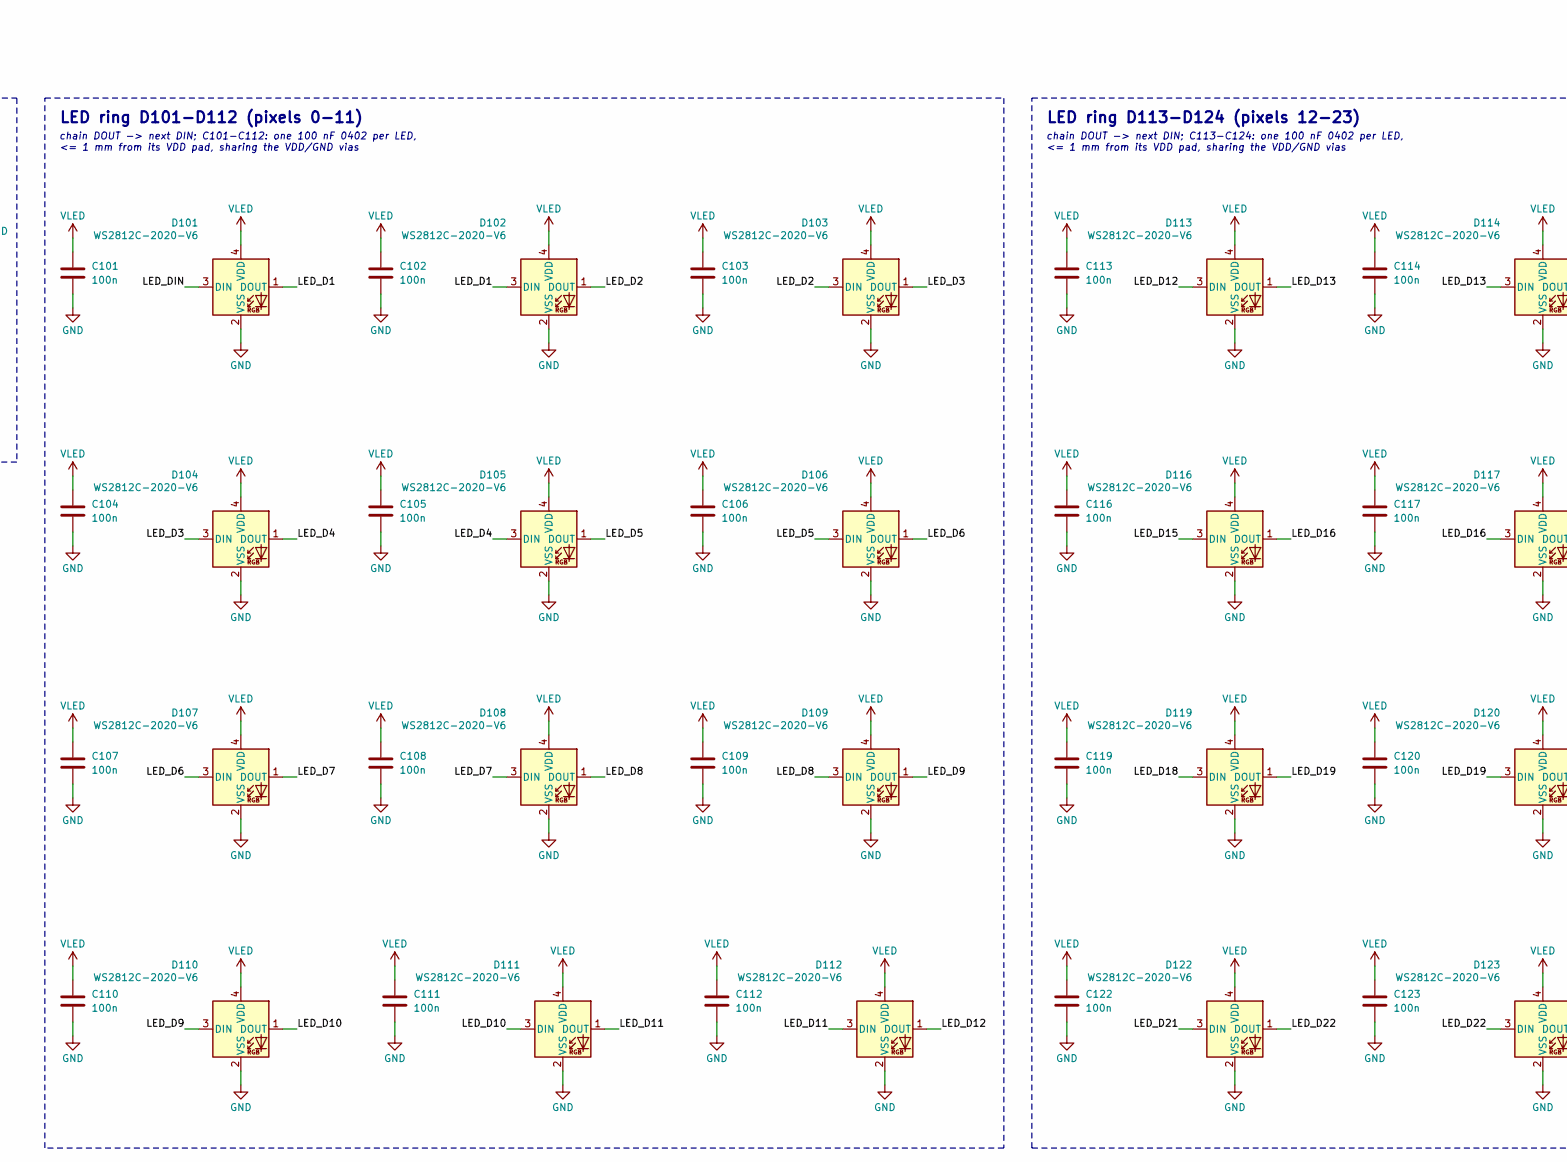
[picture p80: schematic leds.kicad_sch, LED ring, part in row 1, column 2]

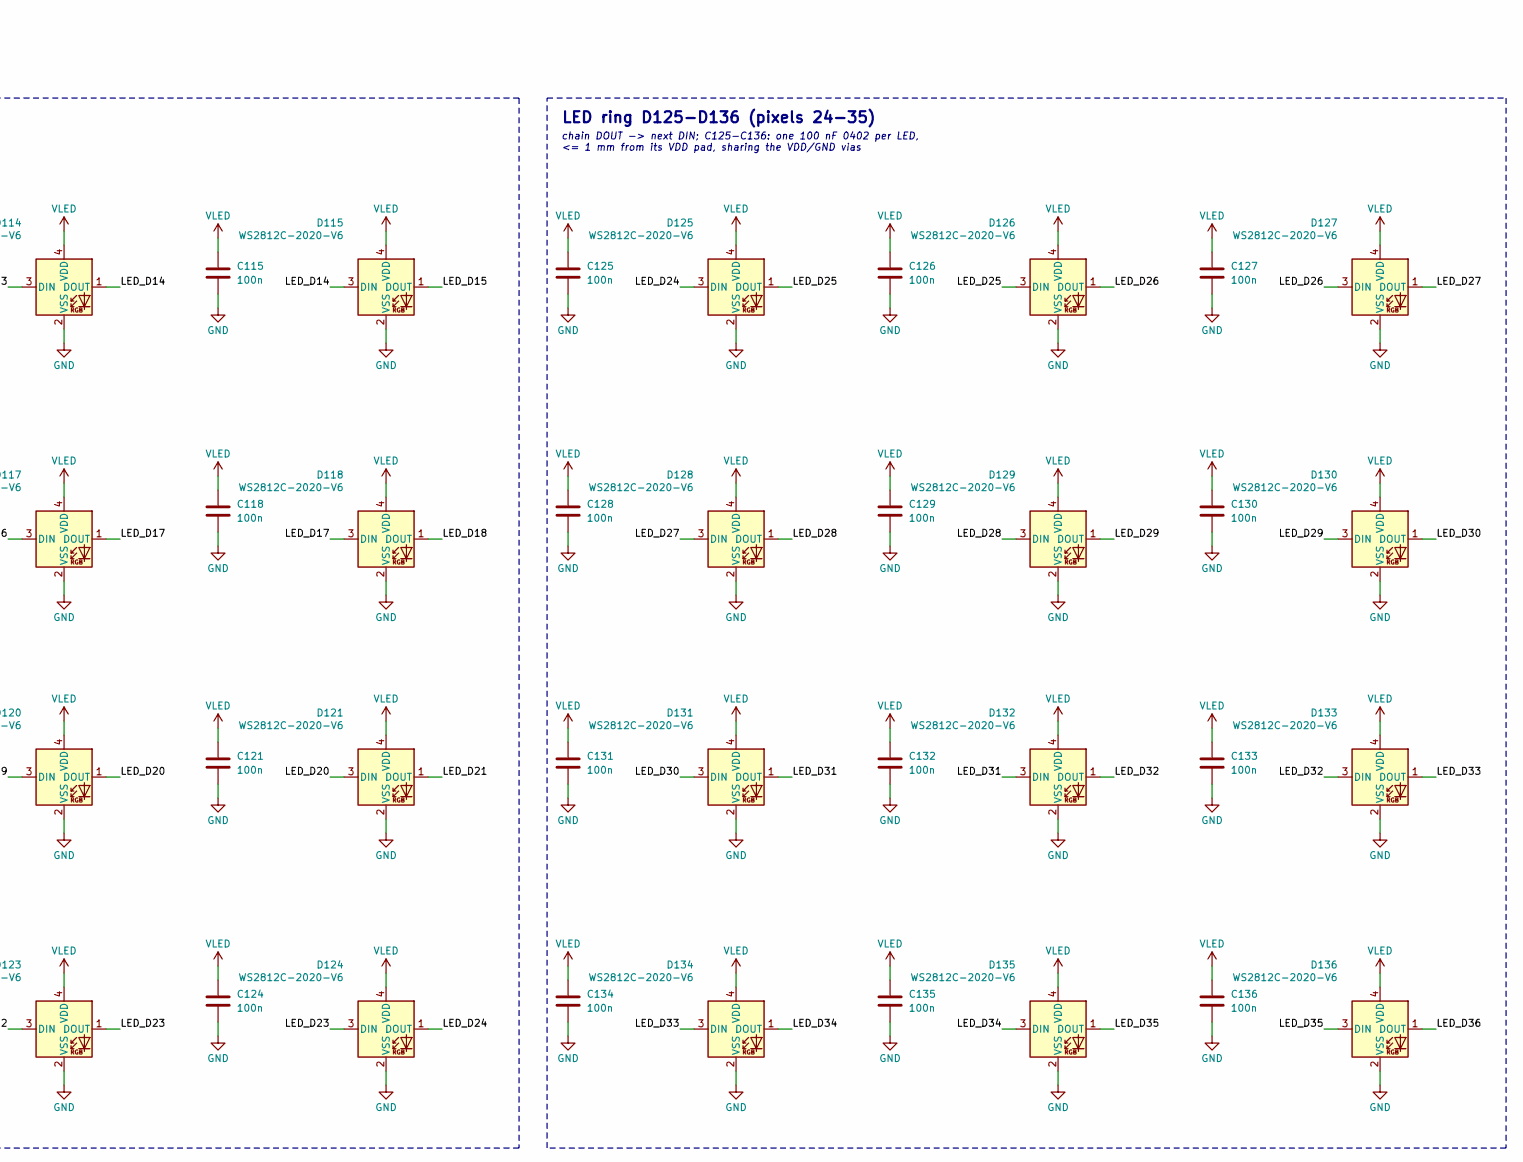
[picture p81: schematic leds.kicad_sch, LED ring, part in row 1, column 3]

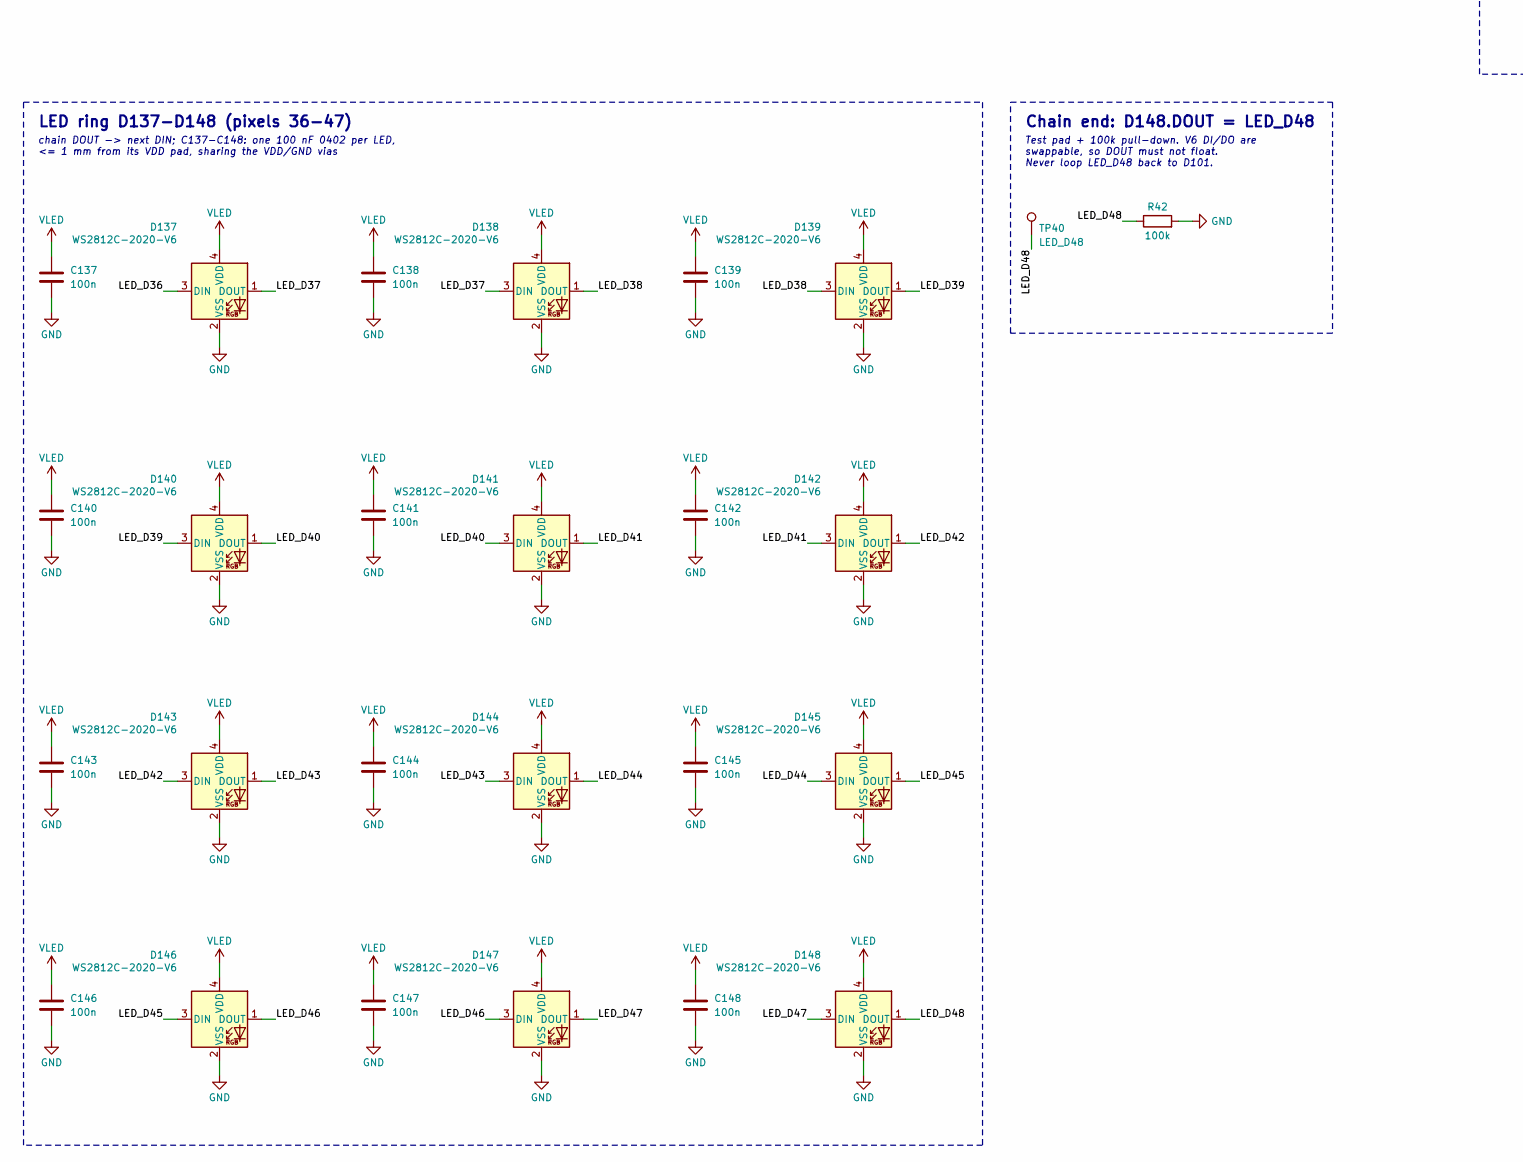
[picture p82: schematic leds.kicad_sch, LED ring, part in row 2, column 1]

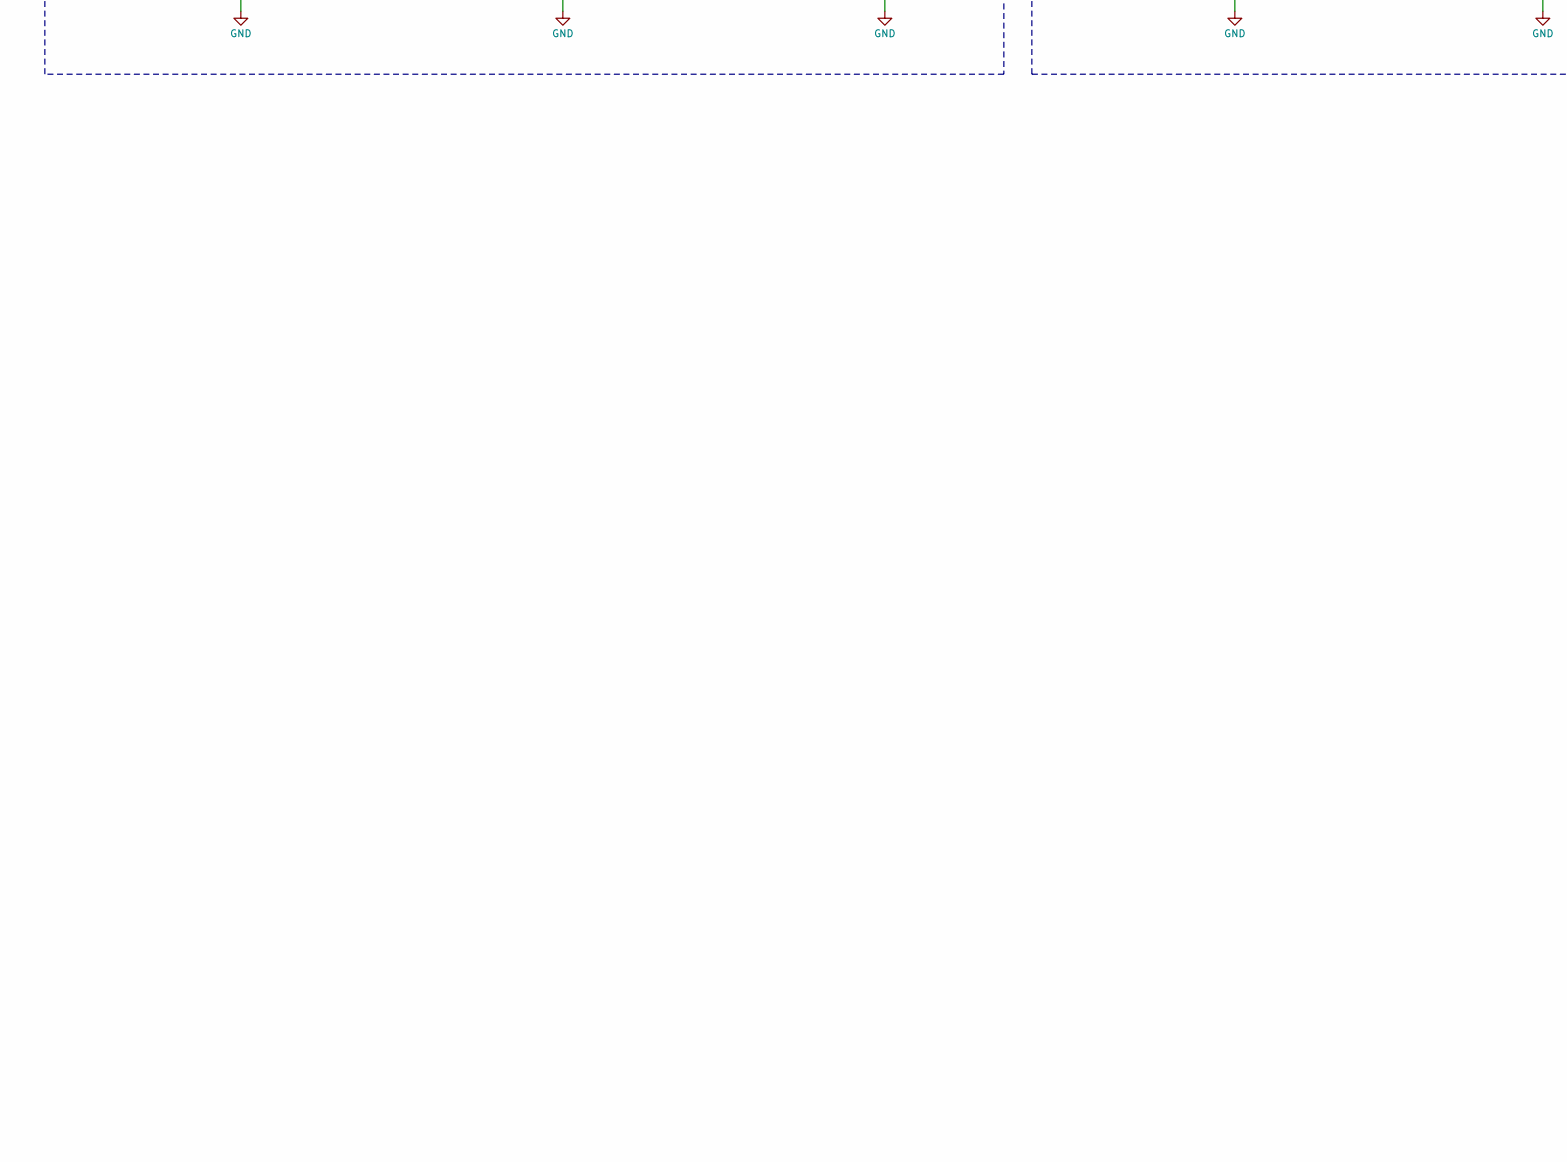
[picture p83: schematic leds.kicad_sch, LED ring, part in row 2, column 2]

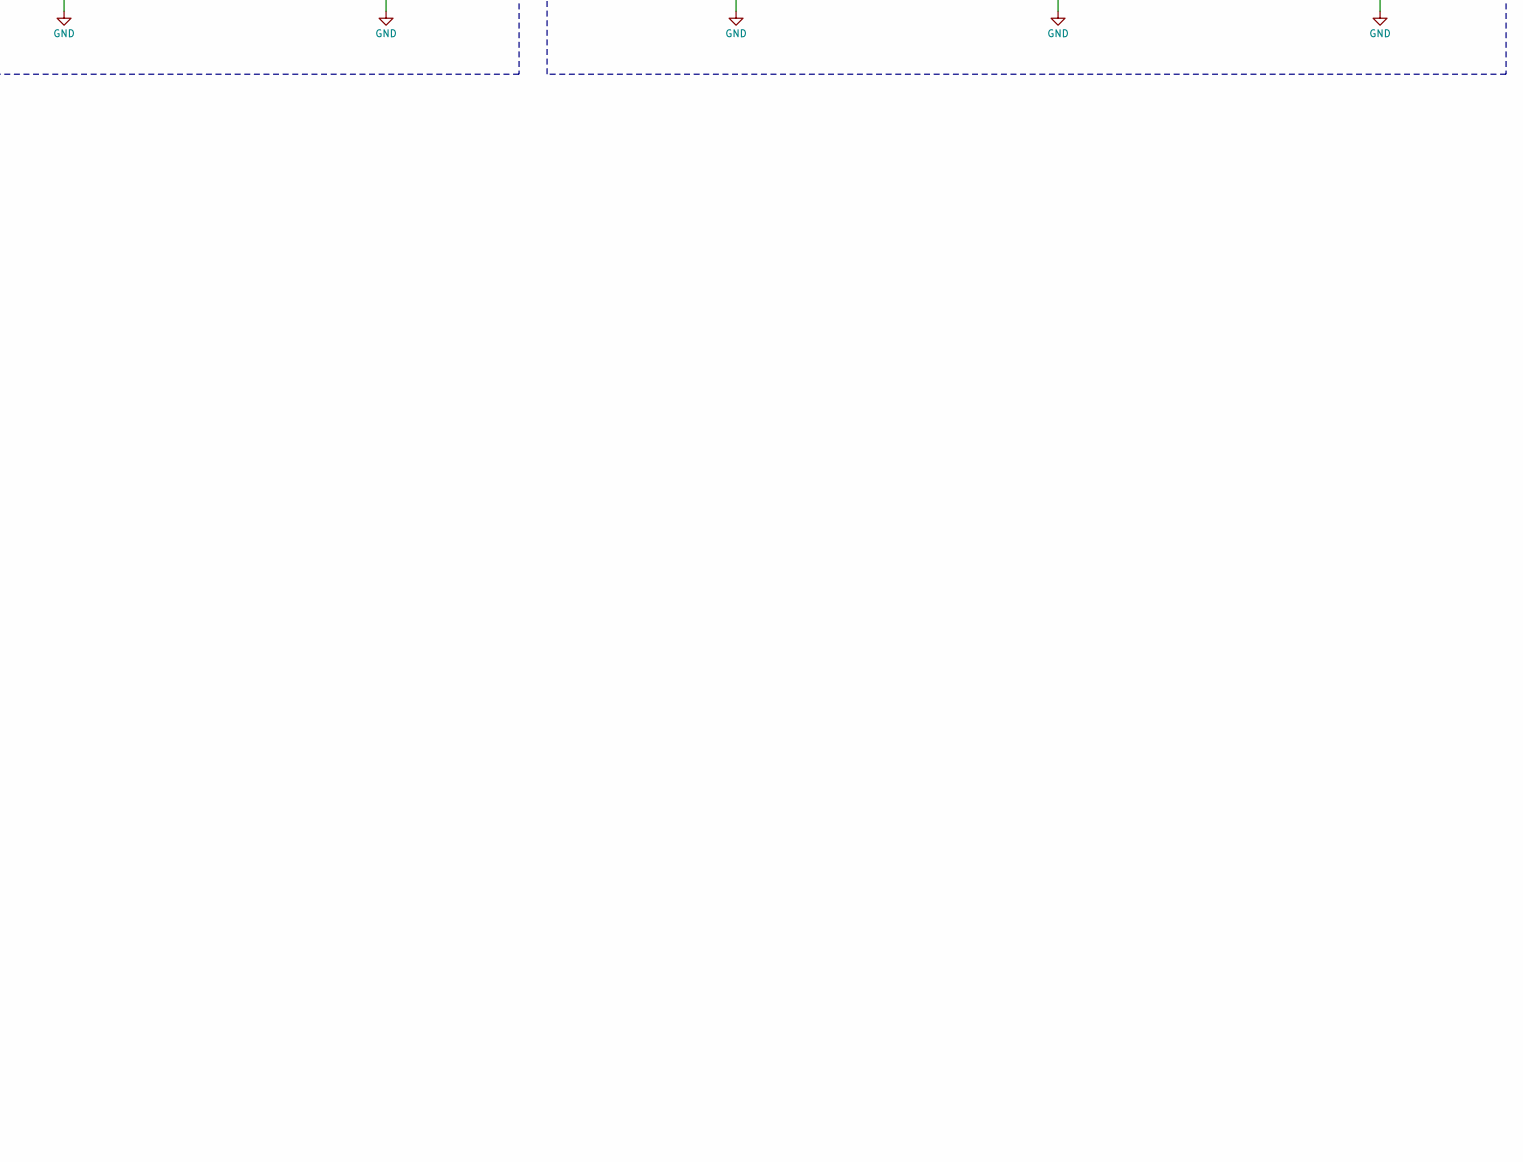
[picture p84: schematic leds.kicad_sch, LED ring, part in row 2, column 3]

Parts:
C43: 100n; C_0402_1005Metric; MPN CL05B104KO5NNNC; LCSC C1525; not fitted
C101, C102, C103, C104, C105, C106, C107, C108, C109, C110, C111, C112, C113, C114, C115, C116, C117, C118, C119, C120, C121, C122, C123, C124, C125, C126, C127, C128, C129, C130, C131, C132, C133, C134, C135, C136, C137, C138, C139, C140, C141, C142, C143, C144, C145, C146, C147, C148: 100n; C_0402_1005Metric; MPN CL05B104KO5NNNC; LCSC C1525
D101, D102, D103, D104, D105, D106, D107, D108, D109, D110, D111, D112, D113, D114, D115, D116, D117, D118, D119, D120, D121, D122, D123, D124, D125, D126, D127, D128, D129, D130, D131, D132, D133, D134, D135, D136, D137, D138, D139, D140, D141, D142, D143, D144, D145, D146, D147, D148: WS2812C-2020-V6; LED_WS2812B-2020_PLCC4_2.0x2.0mm; MPN WS2812C-2020-V6; LCSC C55109522
R40: 220; R_0402_1005Metric; MPN 0402WGF2200TCE; LCSC C25091
R41, R42: 100k; R_0402_1005Metric; MPN 0402WGF1003TCE; LCSC C25741
R43: 0; R_0402_1005Metric; MPN 0402WGF0000TCE; LCSC C17168
TP40: LED_D48; TestPoint_Pad_D1.0mm
U43: SN74LV1T34DBVR; SOT-23-5; MPN SN74LV1T34DBVR; LCSC C100024; not fitted

Connections:
/LED ring/LED_D1: D101.1 (DOUT), D102.3 (DIN)
/LED ring/LED_D2: D102.1 (DOUT), D103.3 (DIN)
/LED ring/LED_D3: D103.1 (DOUT), D104.3 (DIN)
/LED ring/LED_D4: D104.1 (DOUT), D105.3 (DIN)
/LED ring/LED_D5: D105.1 (DOUT), D106.3 (DIN)
/LED ring/LED_D6: D106.1 (DOUT), D107.3 (DIN)
/LED ring/LED_D7: D107.1 (DOUT), D108.3 (DIN)
/LED ring/LED_D8: D108.1 (DOUT), D109.3 (DIN)
/LED ring/LED_D9: D109.1 (DOUT), D110.3 (DIN)
/LED ring/LED_D10: D110.1 (DOUT), D111.3 (DIN)
/LED ring/LED_D11: D111.1 (DOUT), D112.3 (DIN)
/LED ring/LED_D12: D112.1 (DOUT), D113.3 (DIN)
/LED ring/LED_D13: D113.1 (DOUT), D114.3 (DIN)
/LED ring/LED_D14: D114.1 (DOUT), D115.3 (DIN)
/LED ring/LED_D15: D115.1 (DOUT), D116.3 (DIN)
/LED ring/LED_D16: D116.1 (DOUT), D117.3 (DIN)
/LED ring/LED_D17: D117.1 (DOUT), D118.3 (DIN)
/LED ring/LED_D18: D118.1 (DOUT), D119.3 (DIN)
/LED ring/LED_D19: D119.1 (DOUT), D120.3 (DIN)
/LED ring/LED_D20: D120.1 (DOUT), D121.3 (DIN)
/LED ring/LED_D21: D121.1 (DOUT), D122.3 (DIN)
/LED ring/LED_D22: D122.1 (DOUT), D123.3 (DIN)
/LED ring/LED_D23: D123.1 (DOUT), D124.3 (DIN)
/LED ring/LED_D24: D124.1 (DOUT), D125.3 (DIN)
/LED ring/LED_D25: D125.1 (DOUT), D126.3 (DIN)
/LED ring/LED_D26: D126.1 (DOUT), D127.3 (DIN)
/LED ring/LED_D27: D127.1 (DOUT), D128.3 (DIN)
/LED ring/LED_D28: D128.1 (DOUT), D129.3 (DIN)
/LED ring/LED_D29: D129.1 (DOUT), D130.3 (DIN)
/LED ring/LED_D30: D130.1 (DOUT), D131.3 (DIN)
/LED ring/LED_D31: D131.1 (DOUT), D132.3 (DIN)
/LED ring/LED_D32: D132.1 (DOUT), D133.3 (DIN)
/LED ring/LED_D33: D133.1 (DOUT), D134.3 (DIN)
/LED ring/LED_D34: D134.1 (DOUT), D135.3 (DIN)
/LED ring/LED_D35: D135.1 (DOUT), D136.3 (DIN)
/LED ring/LED_D36: D136.1 (DOUT), D137.3 (DIN)
/LED ring/LED_D37: D137.1 (DOUT), D138.3 (DIN)
/LED ring/LED_D38: D138.1 (DOUT), D139.3 (DIN)
/LED ring/LED_D39: D139.1 (DOUT), D140.3 (DIN)
/LED ring/LED_D40: D140.1 (DOUT), D141.3 (DIN)
/LED ring/LED_D41: D141.1 (DOUT), D142.3 (DIN)
/LED ring/LED_D42: D142.1 (DOUT), D143.3 (DIN)
/LED ring/LED_D43: D143.1 (DOUT), D144.3 (DIN)
/LED ring/LED_D44: D144.1 (DOUT), D145.3 (DIN)
/LED ring/LED_D45: D145.1 (DOUT), D146.3 (DIN)
/LED ring/LED_D46: D146.1 (DOUT), D147.3 (DIN)
/LED ring/LED_D47: D147.1 (DOUT), D148.3 (DIN)
/LED ring/LED_D48: D148.1 (DOUT), R42.1, TP40.1
/LED ring/LED_DIN: D101.3 (DIN), R43.2, U43.4
/LED ring/LED_DIN_R: R40.2, R41.1, R43.1, U43.2
GND: C43.2, C101.2, C102.2, C103.2, C104.2, C105.2, C106.2, C107.2, C108.2, C109.2, C110.2, C111.2, C112.2, C113.2, C114.2, C115.2, C116.2, C117.2, C118.2, C119.2, C120.2, C121.2, C122.2, C123.2, C124.2, C125.2, C126.2, C127.2, C128.2, C129.2, C130.2, C131.2, C132.2, C133.2, C134.2, C135.2, C136.2, C137.2, C138.2, C139.2, C140.2, C141.2, C142.2, C143.2, C144.2, C145.2, C146.2, C147.2, C148.2, D101.2 (VSS), D102.2 (VSS), D103.2 (VSS), D104.2 (VSS), D105.2 (VSS), D106.2 (VSS), D107.2 (VSS), D108.2 (VSS), D109.2 (VSS), D110.2 (VSS), D111.2 (VSS), D112.2 (VSS), D113.2 (VSS), D114.2 (VSS), D115.2 (VSS), D116.2 (VSS), D117.2 (VSS), D118.2 (VSS), D119.2 (VSS), D120.2 (VSS), D121.2 (VSS), D122.2 (VSS), D123.2 (VSS), D124.2 (VSS), D125.2 (VSS), D126.2 (VSS), D127.2 (VSS), D128.2 (VSS), D129.2 (VSS), D130.2 (VSS), D131.2 (VSS), D132.2 (VSS), D133.2 (VSS), D134.2 (VSS), D135.2 (VSS), D136.2 (VSS), D137.2 (VSS), D138.2 (VSS), D139.2 (VSS), D140.2 (VSS), D141.2 (VSS), D142.2 (VSS), D143.2 (VSS), D144.2 (VSS), D145.2 (VSS), D146.2 (VSS), D147.2 (VSS), D148.2 (VSS), R41.2, R42.2, U43.3 (GND); also elsewhere on the board
LED_DIN_MCU: R40.1; also elsewhere on the board
VLED: C43.1, C101.1, C102.1, C103.1, C104.1, C105.1, C106.1, C107.1, C108.1, C109.1, C110.1, C111.1, C112.1, C113.1, C114.1, C115.1, C116.1, C117.1, C118.1, C119.1, C120.1, C121.1, C122.1, C123.1, C124.1, C125.1, C126.1, C127.1, C128.1, C129.1, C130.1, C131.1, C132.1, C133.1, C134.1, C135.1, C136.1, C137.1, C138.1, C139.1, C140.1, C141.1, C142.1, C143.1, C144.1, C145.1, C146.1, C147.1, C148.1, D101.4 (VDD), D102.4 (VDD), D103.4 (VDD), D104.4 (VDD), D105.4 (VDD), D106.4 (VDD), D107.4 (VDD), D108.4 (VDD), D109.4 (VDD), D110.4 (VDD), D111.4 (VDD), D112.4 (VDD), D113.4 (VDD), D114.4 (VDD), D115.4 (VDD), D116.4 (VDD), D117.4 (VDD), D118.4 (VDD), D119.4 (VDD), D120.4 (VDD), D121.4 (VDD), D122.4 (VDD), D123.4 (VDD), D124.4 (VDD), D125.4 (VDD), D126.4 (VDD), D127.4 (VDD), D128.4 (VDD), D129.4 (VDD), D130.4 (VDD), D131.4 (VDD), D132.4 (VDD), D133.4 (VDD), D134.4 (VDD), D135.4 (VDD), D136.4 (VDD), D137.4 (VDD), D138.4 (VDD), D139.4 (VDD), D140.4 (VDD), D141.4 (VDD), D142.4 (VDD), D143.4 (VDD), D144.4 (VDD), D145.4 (VDD), D146.4 (VDD), D147.4 (VDD), D148.4 (VDD), U43.5 (VCC); also elsewhere on the board

Notes on the sheet:
48x WS2812C-2020-V6 (5 mA/ch) on VLED = TPS22917 load-switch output (main_power sheet, 2x 22 uF bulk there). Data: nRF P0.06 (I2S SDOUT, H0H1 drive) = LED_DIN_MCU -> R40 220R -> LED_DIN_R (R41) -> R43 0R -> LED_DIN -> D101 -> ... -> D148 (TP40). D101 = pixel 0 at the mechanical index; pixels run in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
LED data input
220R series (bounds DIN clamp current if P0.06 is high while VLED is off): place within 3 mm of the nRF pin (P0.06). 100k pull-down R41 on LED_DIN_R holds DIN low while P0.06 is high-Z (reset/DFU). FIRMWARE: send an all-zero frame and drive P0.06 low (pinctrl sleep) before deasserting LED_PWR_EN; a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
Optional VLED-referenced level shifter (DNP)
Default: R43 0R fitted, U43 not fitted (3.3 V drive; DC margin over 0.6 VDD +427 mV typical, +41 mV datasheet bound at VSYS 4.59 V, so SYS_REG stays 4.4 V and the D101-D148 must be V6 parts). If the bench test at VSYS = 4.6 V shows bit errors: remove R43, fit U43 (powered from VLED, so it is unpowe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
LED ring D101-D112 (pixels 0-11)
chain DOUT -> next DIN; C101-C112: one 100 nF 0402 per LED, <= 1 mm from its VDD pad, sharing the VDD/GND vias
LED ring D113-D124 (pixels 12-23)
chain DOUT -> next DIN; C113-C124: one 100 nF 0402 per LED, <= 1 mm from its VDD pad, sharing the VDD/GND vias
LED ring D125-D136 (pixels 24-35)
chain DOUT -> next DIN; C125-C136: one 100 nF 0402 per LED, <= 1 mm from its VDD pad, sharing the VDD/GND vias
LED ring D137-D148 (pixels 36-47)
chain DOUT -> next DIN; C137-C148: one 100 nF 0402 per LED, <= 1 mm from its VDD pad, sharing the VDD/GND vias
Chain end: D148.DOUT = LED_D48
Test pad + 100k pull-down. V6 DI/DO are swappable, so DOUT must not float. Never loop LED_D48 back to D101.

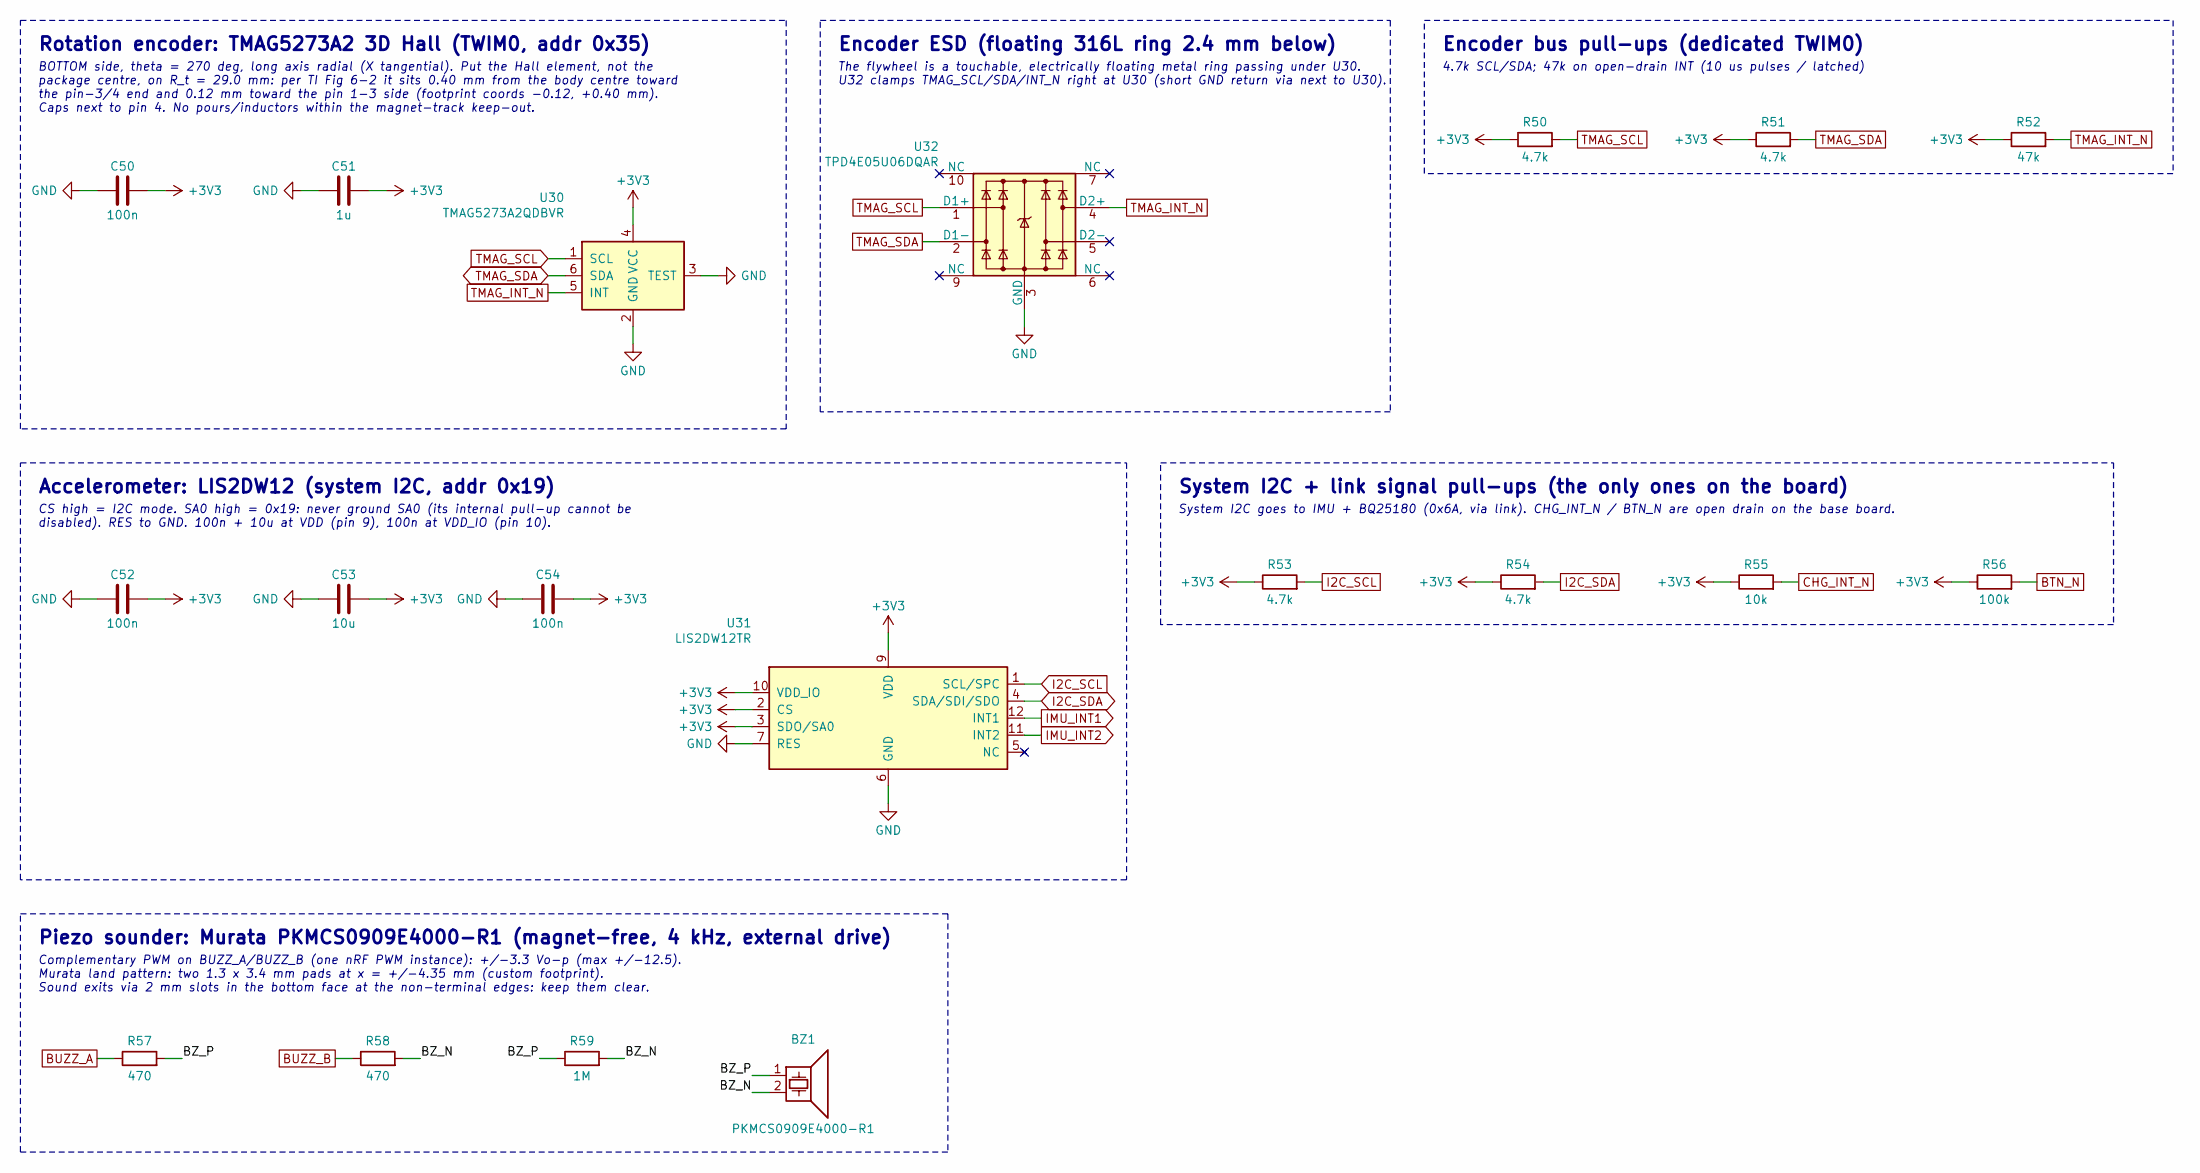
[picture p85: schematic sensors.kicad_sch, Sensors & sounder]

Parts:
BZ1: PKMCS0909E4000-R1; Buzzer_Murata_PKMCS0909E4000-R1; MPN PKMCS0909E4000-R1; LCSC C910763
C50, C52, C54: 100n; C_0402_1005Metric; MPN CL05B104KO5NNNC; LCSC C1525
C51: 1u; C_0402_1005Metric; MPN CL05A105KA5NQNC; LCSC C52923
C53: 10u; C_0603_1608Metric; MPN CL10A106KP8NNNC; LCSC C19702
R50, R51, R53, R54: 4.7k; R_0402_1005Metric; MPN 0402WGF4701TCE; LCSC C25900
R52: 47k; R_0402_1005Metric; MPN 0402WGF4702TCE; LCSC C25792
R55: 10k; R_0402_1005Metric; MPN 0402WGF1002TCE; LCSC C25744
R56: 100k; R_0402_1005Metric; MPN 0402WGF1003TCE; LCSC C25741
R57, R58: 470; R_0402_1005Metric; MPN 0402WGF4700TCE; LCSC C25117
R59: 1M; R_0402_1005Metric; MPN 0402WGF1004TCE; LCSC C26083
U30: TMAG5273A2QDBVR; SOT-23-6; MPN TMAG5273A2QDBVR; LCSC C3715882
U31: LIS2DW12TR; LGA-12_2x2mm_P0.5mm; MPN LIS2DW12TR; LCSC C189624
U32: TPD4E05U06DQAR; USON-10_2.5x1.0mm_P0.5mm; MPN TPD4E05U06DQAR; LCSC C138714

Connections:
+3V3: C50.2, C51.2, C52.2, C53.2, C54.2, R50.1, R51.1, R52.1, R53.1, R54.1, R55.1, R56.1, U30.4 (VCC), U31.2 (CS), U31.3 (SDO/SA0), U31.9 (VDD), U31.10 (VDD_IO); also elsewhere on the board
/Sensors & sounder/BZ_N: BZ1.2, R58.2, R59.2
/Sensors & sounder/BZ_P: BZ1.1, R57.2, R59.1
BTN_N: R56.2; also elsewhere on the board
BUZZ_A: R57.1; also elsewhere on the board
BUZZ_B: R58.1; also elsewhere on the board
CHG_INT_N: R55.2; also elsewhere on the board
GND: C50.1, C51.1, C52.1, C53.1, C54.1, U30.2 (GND), U30.3 (TEST), U31.6 (GND), U31.7 (RES), U31.8 (GND), U32.3 (GND), U32.8 (GND); also elsewhere on the board
I2C_SCL: R53.2, U31.1 (SCL/SPC); also elsewhere on the board
I2C_SDA: R54.2, U31.4 (SDA/SDI/SDO); also elsewhere on the board
IMU_INT1: U31.12 (INT1); also elsewhere on the board
IMU_INT2: U31.11 (INT2); also elsewhere on the board
TMAG_INT_N: R52.2, U30.5 (INT), U32.4 (D2+); also elsewhere on the board
TMAG_SCL: R50.2, U30.1 (SCL), U32.1 (D1+); also elsewhere on the board
TMAG_SDA: R51.2, U30.6 (SDA), U32.2 (D1-); also elsewhere on the board

Notes on the sheet:
Rotation encoder: TMAG5273A2 3D Hall (TWIM0, addr 0x35)
BOTTOM side, theta = 270 deg, long axis radial (X tangential). Put the Hall element, not the package centre, on R_t = 29.0 mm: per TI Fig 6-2 it sits 0.40 mm from the body centre toward the pin-3/4 end and 0.12 mm toward the pin 1-3 side (footprint coords -0.12, +0.40 mm). Caps next to pin 4. No po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
Encoder ESD (floating 316L ring 2.4 mm below)
The flywheel is a touchable, electrically floating metal ring passing under U30. U32 clamps TMAG_SCL/SDA/INT_N right at U30 (short GND return via next to U30).
Encoder bus pull-ups (dedicated TWIM0)
4.7k SCL/SDA; 47k on open-drain INT (10 us pulses / latched)
Accelerometer: LIS2DW12 (system I2C, addr 0x19)
CS high = I2C mode. SA0 high = 0x19: never ground SA0 (its internal pull-up cannot be disabled). RES to GND. 100n + 10u at VDD (pin 9), 100n at VDD_IO (pin 10).
System I2C + link signal pull-ups (the only ones on the board)
System I2C goes to IMU + BQ25180 (0x6A, via link). CHG_INT_N / BTN_N are open drain on the base board.
Piezo sounder: Murata PKMCS0909E4000-R1 (magnet-free, 4 kHz, external drive)
Complementary PWM on BUZZ_A/BUZZ_B (one nRF PWM instance): +/-3.3 Vo-p (max +/-12.5). Murata land pattern: two 1.3 x 3.4 mm pads at x = +/-4.35 mm (custom footprint). Sound exits via 2 mm slots in the bottom face at the non-terminal edges: keep them clear.

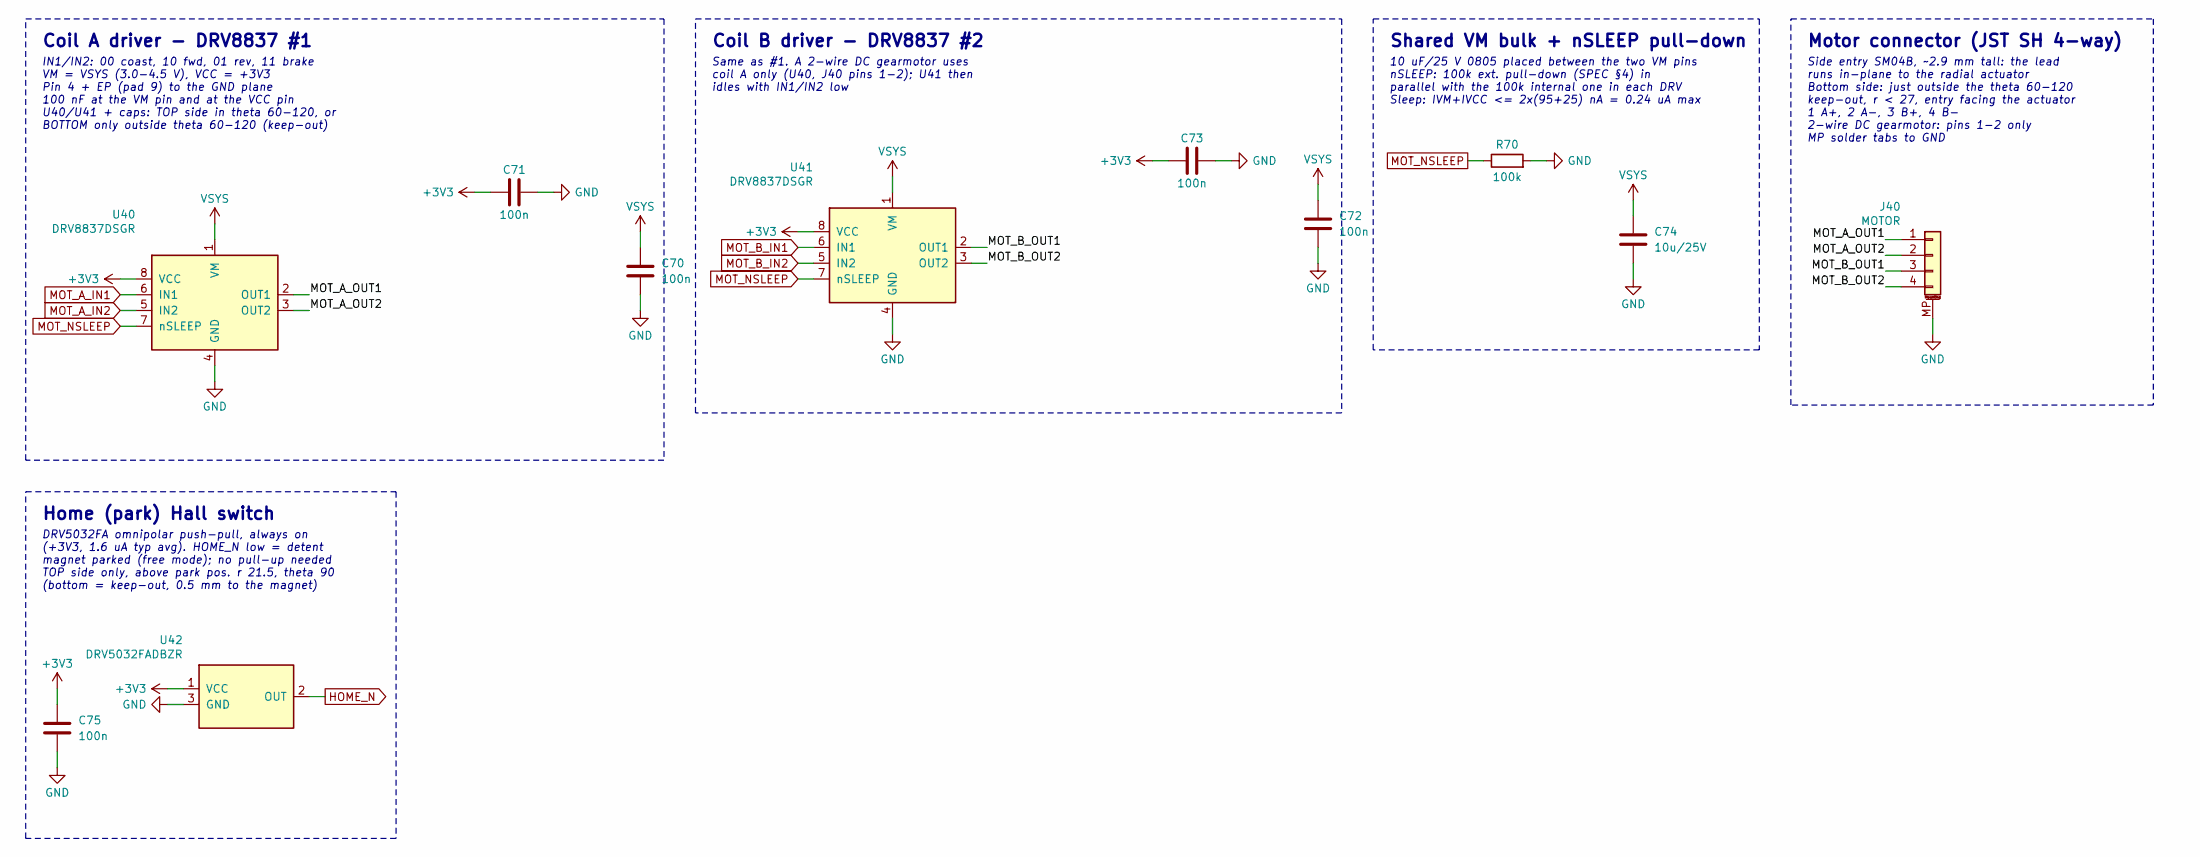
[picture p86: schematic detent.kicad_sch, Detent actuator & home sensor]

Parts:
C70, C71, C72, C73, C75: 100n; C_0402_1005Metric; MPN CL05B104KO5NNNC; LCSC C1525
C74: 10u/25V; C_0805_2012Metric; MPN CL21A106KAYNNNE; LCSC C15850
J40: MOTOR; JST_SH_SM04B-SRSS-TB_1x04-1MP_P1.00mm_Horizontal; MPN SM04B-SRSS-TB(LF)(SN); LCSC C160404
R70: 100k; R_0402_1005Metric; MPN 0402WGF1003TCE; LCSC C25741
U40, U41: DRV8837DSGR; Texas_DSG0008A_WSON-8-1EP_2x2mm_P0.5mm_EP0.9x1.6mm; MPN DRV8837DSGR; LCSC C39159
U42: DRV5032FADBZR; SOT-23; MPN DRV5032FADBZR; LCSC C140921

Connections:
+3V3: C71.1, C73.1, C75.1, U40.8 (VCC), U41.8 (VCC), U42.1 (VCC); also elsewhere on the board
/Detent actuator & home sensor/MOT_A_OUT1: J40.1, U40.2 (OUT1)
/Detent actuator & home sensor/MOT_A_OUT2: J40.2, U40.3 (OUT2)
/Detent actuator & home sensor/MOT_B_OUT1: J40.3, U41.2 (OUT1)
/Detent actuator & home sensor/MOT_B_OUT2: J40.4, U41.3 (OUT2)
GND: C70.2, C71.2, C72.2, C73.2, C74.2, C75.2, J40.MP (MountPin), R70.2, U40.4 (GND), U40.9 (GND), U41.4 (GND), U41.9 (GND), U42.3 (GND); also elsewhere on the board
HOME_N: U42.2 (OUT); also elsewhere on the board
MOT_A_IN1: U40.6 (IN1); also elsewhere on the board
MOT_A_IN2: U40.5 (IN2); also elsewhere on the board
MOT_B_IN1: U41.6 (IN1); also elsewhere on the board
MOT_B_IN2: U41.5 (IN2); also elsewhere on the board
MOT_NSLEEP: R70.1, U40.7 (nSLEEP), U41.7 (nSLEEP); also elsewhere on the board
VSYS: C70.1, C72.1, C74.1, U40.1 (VM), U41.1 (VM); also elsewhere on the board

Notes on the sheet:
Coil A driver - DRV8837 #1
IN1/IN2: 00 coast, 10 fwd, 01 rev, 11 brake VM = VSYS (3.0-4.5 V), VCC = +3V3 Pin 4 + EP (pad 9) to the GND plane 100 nF at the VM pin and at the VCC pin U40/U41 + caps: TOP side in theta 60-120, or BOTTOM only outside theta 60-120 (keep-out)
Coil B driver - DRV8837 #2
Same as #1. A 2-wire DC gearmotor uses coil A only (U40, J40 pins 1-2); U41 then idles with IN1/IN2 low
Shared VM bulk + nSLEEP pull-down
10 uF/25 V 0805 placed between the two VM pins nSLEEP: 100k ext. pull-down (SPEC §4) in parallel with the 100k internal one in each DRV Sleep: IVM+IVCC <= 2x(95+25) nA = 0.24 uA max
Motor connector (JST SH 4-way)
Side entry SM04B, ~2.9 mm tall: the lead runs in-plane to the radial actuator Bottom side: just outside the theta 60-120 keep-out, r < 27, entry facing the actuator 1 A+, 2 A-, 3 B+, 4 B- 2-wire DC gearmotor: pins 1-2 only MP solder tabs to GND
Home (park) Hall switch
DRV5032FA omnipolar push-pull, always on (+3V3, 1.6 uA typ avg). HOME_N low = detent magnet parked (free mode); no pull-up needed TOP side only, above park pos. r 21.5, theta 90 (bottom = keep-out, 0.5 mm to the magnet)
