tyevco/dial-me-spinner/hardware/kicad/main/dial-me-spinner-main.kicad_pcb

## KiCad design hardware/kicad/main/dial-me-spinner-main.kicad_pcb (continued)

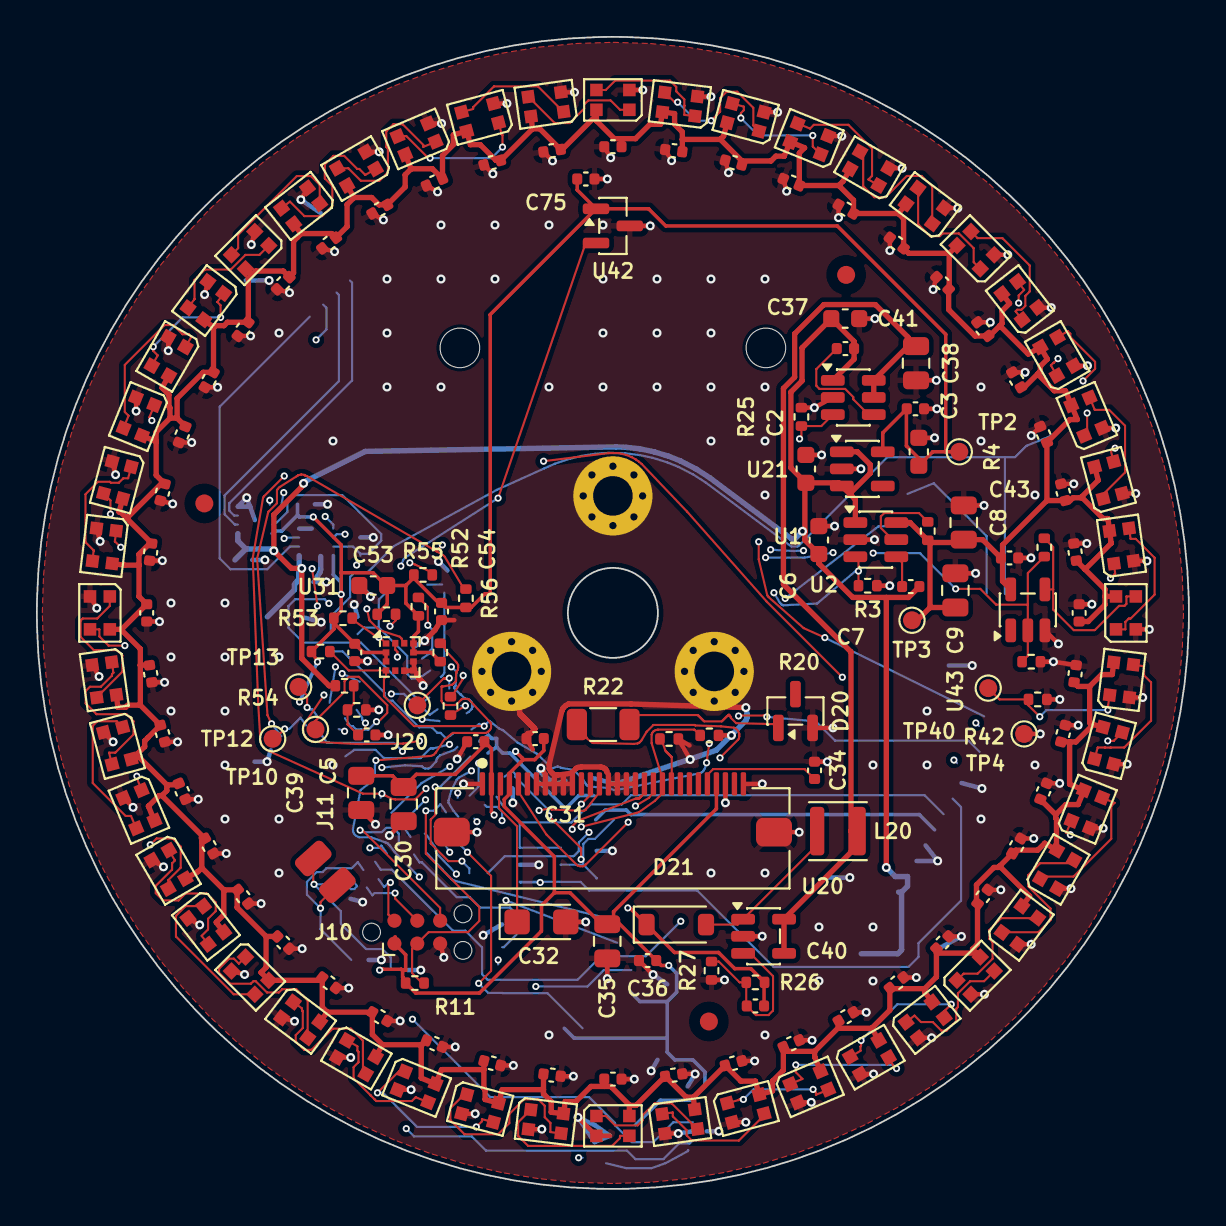
[picture p87: board dial-me-spinner-main.kicad_pcb from above]

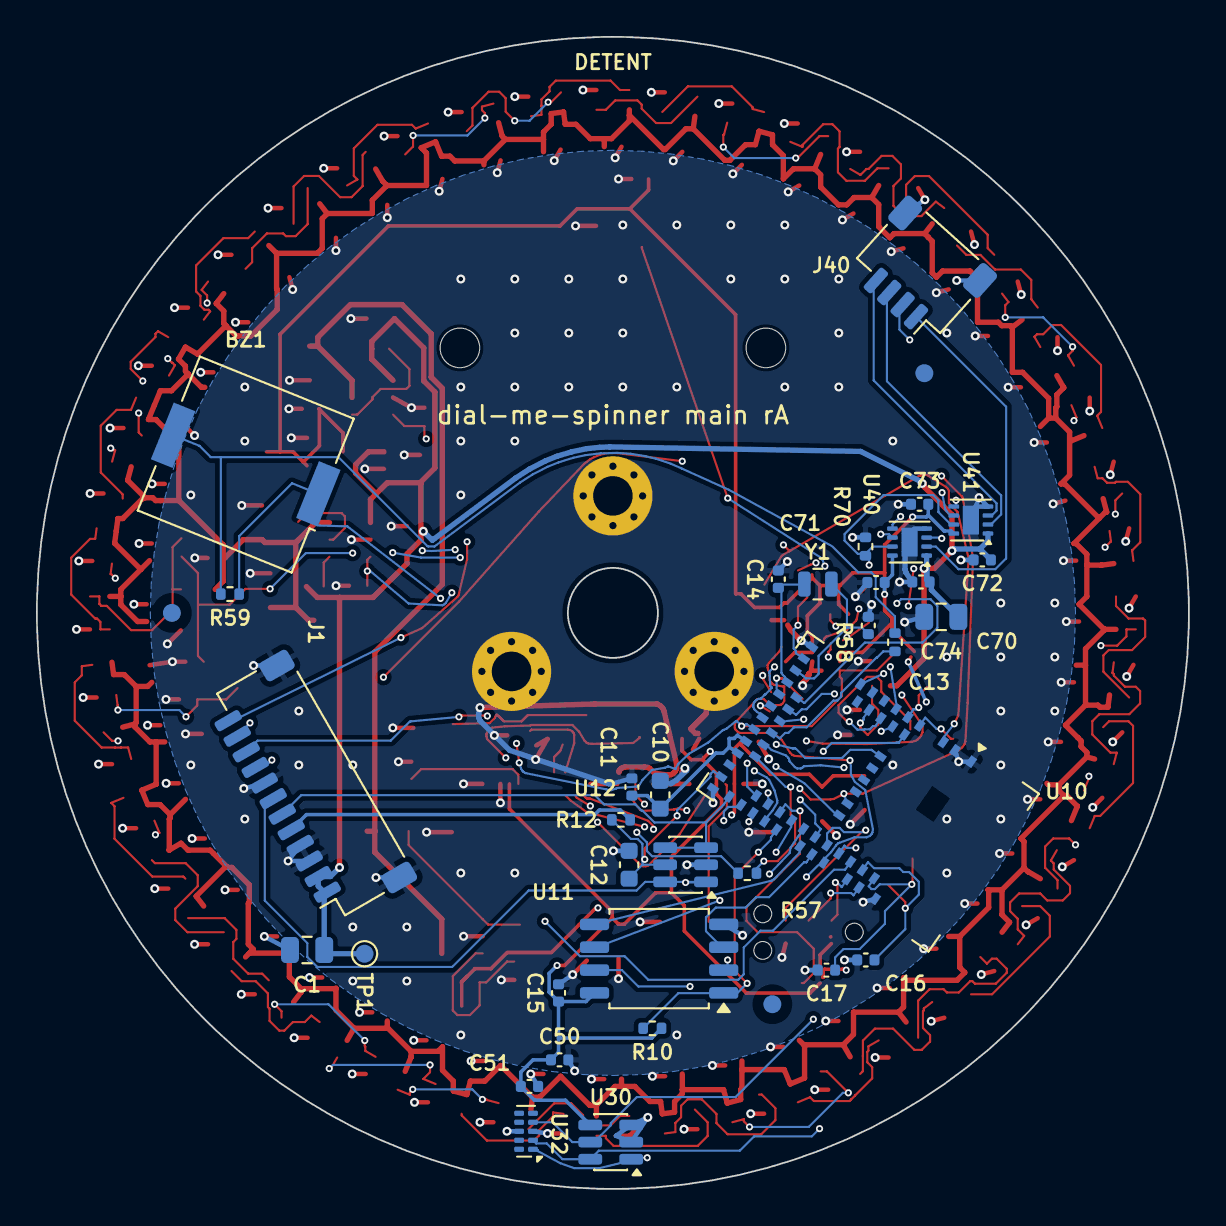
[picture p88: board dial-me-spinner-main.kicad_pcb from below]

Board: 4 copper layers, 64.0 x 64.0 mm, 209 parts (37 on the bottom side), 120 nets.

Other parts of the board:
FID1, FID2, FID3, FID4, FID5, FID6: Fiducial_1mm_Mask2mm
H4, H5: MountingHole_2.2mm_M2
