tyevco/dial-me-spinner/hardware/sim/tests/test_ldo_3v3.py

"""RT9080-33 3V3 LDO (U1 on main_power, VSYS -> +3V3): start-up, dropout, load and line transients,
output-capacitor stability, quiescent current, thermal, and fault injection.

Circuit key "ldo_3v3". IC model: models/ldo_3v3__rt9080.lib (Richtek DS9080-09, Dec 2024). Everything on +3V3
and VSYS comes from the main netlist (U1 is found by MPN, its pins by pin name, the output capacitors and pull-ups
by net), so a schematic change shows up in the next run. MLCC DC-bias, temperature and ESR data come from the
Samsung Electro-Mechanics component library, keyed by the MPN field of each capacitor (MLCC table below); a
capacitor whose MPN is not in the table fails the run instead of being silently guessed.

Load currents are datasheet figures of the +3V3 consumers (nRF52840 PS v1.1, W25Q128JV Rev F, TMAG5273 SLYS045C,
SSD1351 / NHD panel spec, DRV8837 SLVSBA4F, DRV5032 ti.com/lit/ds/symlink/drv5032.pdf) and the architecture.md
section 8.2 sleep budget. VSYS is applied at the main-board link connector: the harness drop belongs to the link
harness tests (it is ~mV at the +3V3 load currents used here).

Independent verification (second pass) changed: U1's VIN/EN connections now come from the netlist (an EN or VIN
miswire shows up in every simulation, not only in the topology assert); the U1 pinout is checked against DS section 7;
the Monte Carlo batch no longer couples its copies through shared ESR nodes (capacitors whose +3V3 pin is pin 2 had
an un-suffixed '0_cNN_esr' node); start-up uses voltage-dependent MLCC capacitance (the 0 V capacitance is ~2x the
3.3 V value, so the fixed-C deck under-stated the inrush: 0.71 -> 0.94 A); COUT minimum is the DS 17.1 / Fig. 1
1 uF effective (stricter than the 0.7 uF of section 8); tolerances come from the MPN letter everywhere; TJ uses the
JEDEC theta-JA; reverse bias (VOUT > VIN) on VSYS collapse is checked against the DS abs max.

LDO-1 (2026-10): SPEC 3 now reads 'Iq ≤ 2 µA typ / 4 µA max' (quoted and checked against SPEC.md by spec_ldo_iq), so
test_quiescent_current_max_vs_spec is a guard instead of a strict xfail; the model's no-load input current is IQ at
every accuracy / temperature / VIN corner (it was IQ + 12 nA for a +2 % part). SYS_REG: firmware sets 4.4 V (0x0A = 0x20);
the checks keep the 4.5 V POR default (the only other allowed value) as the abs-worst corner, and the DC sweep also
reads the 4.4 V +/-2 % window.
"""

from __future__ import annotations

import itertools
import math
import os
import random
import re

import numpy as np
import pytest

import spicelib

LIB = "ldo_3v3__rt9080.lib"
DS = "RT9080 DS9080-09"

# --------------------------------------------------------------------------------------------- limits
W25Q_VMIN = 2.7          # W25Q128JV Rev F 9.2: VCC 2.7-3.0 V allowed at FR <= 104 MHz (nRF QSPI <= 32 MHz)
VCI_MAX = 3.5            # SSD1351 VCI 2.4-3.5 V (NHD panel spec, display research); tighter than the 3.6 V parts
NRF_TR_VDD_MAX = 60e-3   # nRF52840 PS recommended operating conditions: tR_VDD (0 -> 1.7 V) <= 60 ms
TMAG_RAMP_MIN = 3.0e3    # TMAG5273 SLYS045C: VCC ramp >= 3 V/ms, else firmware must run one W&S cycle after POR
WS_VIH_K = 0.6           # WS2812C-2020-V6 VIH = 0.6 x VDD (Worldsemi PCN 30 Sep 2025; 0.55 x VDD in DS V1.0)
NRF_VOH_DROP = 0.4       # nRF52840 PS: VOH >= VDD - 0.4 V (standard drive)
COUT_MIN_STAB = 1.0e-6   # DS9080-09 17.1 "minimum output capacitance ... 1 uF, considering the temperature and voltage
#                          coefficient" and Fig. 1 "COUT (Effective Capacitance >= 1 uF)"; section 8 says 0.7 uF
#                          effective - the stricter DS statement is used
ESR_MIN = 1e-3           # DS9080-09 section 18: output capacitor ESR >= 1 mohm
TJ_MAX = 125.0           # DS9080-09 section 12: recommended junction temperature range -40..125 C
THETA_JA = 189.4         # DS9080-09 section 13: theta-JA (JEDEC) TSOT-23-5. The 100.7 C/W theta-JA(EVB) needs Richtek's
#                          high-conductivity 70x50 mm board; the main board is a crowded 64 mm disc, so use JEDEC
VIN_MAX = 5.5            # DS9080-09 section 12: recommended input voltage 1.2-5.5 V
REV_MAX = 0.3            # DS9080-09 section 10 absolute maximum: VOUT to VIN -6.5 .. +0.3 V
PINOUT = {"1": "VIN", "2": "GND", "3": "EN", "4": "NC", "5": "VOUT"}   # DS9080-09 sections 7/8, TSOT-23-5
SYS_OVP_K = 1.05         # BQ25180 SLUSE99C 8.3.6: SYS_OVP rising threshold ~105 % of the SYS target
RON_BAT = 0.055          # BQ25180 SLUSE99C 7.5 RON_BAT 55 mohm typ (BATFET, battery -> SYS)
VBSUP1 = 0.04            # BQ25180 SLUSE99C 7.5 VBSUP1: SYS supplemented from BAT below VBAT - 40 mV
BATOCP_SET = 1.5         # BQ25180 IBAT_OCP after firmware init (CHARGECTRL1 0x92 = 1.5 A, firmware.md 13.1)
RON_LSW = 0.08           # TPS22917 RON 80 mohm typ (power research / TPS22917 DS) - U2 in a VLED short
SPEC_LDO_IQ = "Iq ≤ 2 µA typ / 4 µA max"   # SPEC.md section 3, LDO bullet, quoted exactly (LDO-1; it read
#                          "Iq <= 2 uA" before, which a DS9080-09 max part breaks). spec_ldo_iq() checks the SPEC text
SPEC_IQ_TYP = 2e-6       # SPEC.md section 3: Iq <= 2 uA typ (DS9080-09 Table 14 IQ 2 uA typ)
SPEC_IQ_MAX = 4e-6       # SPEC.md section 3: Iq <= 4 uA max (DS9080-09 Table 14 IQ 4 uA max)
BATOCP_DEFAULT = 1.0    # BQ25180 SLUSE99C 7.5 IBAT_OCP code 01 = 1 A (POR default per power research; firmware
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
