tyevco/dial-me-spinner/(commit log)

2026-10-18 Add KiCad generator toolchain for the dial spinner PCB
    Python tooling that writes KiCad 9 schematics from a netlist description
    (label-wired, hierarchical sheets), builds custom box symbols, builds the
    board from the KiCad netlist via the pcbnew API, round-trips through
    Freerouting (Specctra DSN/SES), and produces JLCPCB fab outputs.
    Claude-Session: https://claude.ai/code/session_01P3cqdBhxLcWY3sGUVf9LAJ
2026-10-18 Add footprint generator and schematic build scaffolding
    fpgen.py builds simple footprints via the pcbnew API for parts missing
    from the KiCad libraries; hardware/design/build.py assembles sheet
    modules into the KiCad project, runs ERC, exports the netlist and
    renders each sheet.
    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
2026-10-19 Add capture spec, net contract, multi-board build and main power sheet
    SPEC.md is the architecture of record for the schematic capture: two
    boards (main hub + base) linked by a 12-way harness through the spindle,
    shared 48-magnet detent/encoder track, nRF52840 pin map and power tree.
    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
2026-10-19 Add PCB layout generator with constrained placement and greedy clustering
    layout.py places mechanically fixed parts (LED ring, encoder Hall, module,
    link, ZIF, motor connector) per SPEC §8 and clusters the rest around their
    anchor ICs via placer.py; draws outlines, holes, keep-outs and zones and can
    round-trip through Freerouting. SPEC gains the shared mechanical stack-up.
    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
2026-10-19 Add release script for gerbers, JLCPCB BOM/CPL, PDFs and 3D renders
    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
2026-10-19 WIP: schematic sheet modules in progress (mcu, leds, detent)
    Captured by the parallel capture agents; still under review.
    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
2026-10-19 WIP: LED and sensor sheets captured and verified; spec refdes/TMAG notes
    LED data series resistor raised to 220R to bound DIN clamp injection when
    VLED is off.
    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
2026-10-19 WIP: detent and base sheets captured and verified; fix link connector LCSC code
    C160413 is a 14-pin side-entry JST part; BM12B-SRSS-TB(LF)(SN) is C160398.
    Generator: place reference/value above/below horizontally-pinned 2-pin parts
    and account for power-symbol label width in part extents.
    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
    [dial_spinner.scad]
2026-10-19 Fix load-switch CT to VIN, side-entry link headers, base geometry, LED level-shifter option
    Review findings: TPS22917 CT must go to VIN; vertical link headers collide
    with the rotor hub/web, so both boards use side-entry SM12B (C160411);
    pack rotated to θ 0/180 with base-board bosses moved outside it; DNP
    SN74LV1T34 option for the thin LED data margin on USB; LCSC fix for the
    2.2M divider (C11490); new lcsc_check.py verifies every code against JLCPCB.
    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
    [base.py, display.py, leds.py, main_power.py, mcu.py]
2026-10-19 WIP: docs, mechanical model and generated KiCad projects (routing in progress)
    Docs (architecture, mechanical, firmware, assembly, bring-up) and the
    OpenSCAD enclosure/rotor model with clash check and calculations, written by
    the docs workflows; generated schematics (ERC clean) and placed boards.
    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
    [base.kicad_sch, base_cup.stl, bearing_retainer.stl, carriage_rail.stl, detent.kicad_sch, detent_carriage.stl, dial-me-spinner-base.kicad_pcb, dial-me-spinner-base.kicad_sch]
2026-10-19 WIP: firmware/bring-up docs review fixes; routing in progress
    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
    [dial-me-spinner-base.kicad_pcb]
2026-10-19 WIP: BGA escape pre-route for the charger; routing in progress
    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
    [dial-me-spinner-base.kicad_pcb]
2026-10-19 WIP: VSYS escape via on the charger BGA
    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
    [dial-me-spinner-base.kicad_pcb]
2026-10-19 Apply schematic review fixes; base board routes to 100% with zero DRC errors
    - OLED VCC input disconnect is now a TPS22917 load switch (CT to VIN) instead
    of an AO3401A/2N7002 with no real inrush control
    - TPD4E05U06 TVS on the TMAG5273 lines (floating 316L ring passes 2.4 mm away)
    - piezo: 470R series + 1M bleed; LED_DIN pull-down moved to the shifter input
    - base: explicit 2x4 DSBGA fan-out for the BQ25180, 0.4 mm power tracks,
    BAT+/GND silkscreen at the battery connector, JEITA NTC over the pack
    - SPEC: side-entry link headers on both boards, 28 AWG power leads
    Claude-Session: https://claude.ai/code/session_01P3cqdBhxLcWY3sGUVf9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
    [dial-me-spinner-base.kicad_pcb, display.kicad_sch, leds.kicad_sch, sensors.kicad_sch]
2026-10-19 WIP: re-placed boards (routing in progress)
    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
    [dial-me-spinner-base.kicad_pcb, dial-me-spinner-main.kicad_pcb]
2026-10-19 WIP: base board rerouted
    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
    [dial-me-spinner-base.kicad_pcb]
2026-10-19 Plated GND spindle holes as ESD bleed for the flywheel ring; LED B-variant caveat
    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
    [main_power.kicad_sch]
2026-10-19 JLC CPL corrections, release gate, silk reference placer, track cleanup after routing
    - jlc_cpl.py + jlc_offsets.json: per-LCSC rotation/origin corrections fitted
    from EasyEDA footprints; CPL written as top θ+α, bottom 180−θ+α
    - release.py: DRC + schematic-parity gate, DNP/exclude sync, ORDER-NOTES.md
    - silk.py: references placed clear of pads, silk and the board edge
    - pcbgen: drop duplicate segments/vias and trim dangling stub ends after SES import
    - layout: board-only holes/fiducials stay put; fiducials on both boards
    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
    [main_power.py]
2026-10-19 WIP: re-placed boards with fiducials (routing in progress), --finish clean-up step
    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
    [board_parts.scad, dial-me-spinner-base.kicad_pcb, dial-me-spinner-main.kicad_pcb, main_power.kicad_sch]
2026-10-19 Fix footprint orientation fit (duplicate MP pads), base-board review fixes in progress
    - layout.local_map pairs pads by list position, so J1/J3/J2 now face the right way
    - base: J2 at θ 222° mouth outward, RT1 on top, BQ25180 off the pack at θ 255°,
    Q1 out of the spoke sector, one boss at r 20 + rib, antenna copper keep-outs
    - finish step: zone-aware debris removal, DRC-driven dangling prune, GND stitching
    - drc() reports warnings and schematic parity
    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
    [base_cup.stl, bearing_retainer.stl, board_parts.scad, cap_ring.stl, carriage_rail.stl, detent_carriage.stl, dial-me-spinner-base.kicad_pcb, dial-me-spinner-main.kicad_pcb]
2026-10-19 WIP: docs and mechanical model updates in progress
    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
    [board_parts.scad, dial_spinner.scad]
2026-10-19 WIP: docs/mechanical/board updates in progress
    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
    [base_cup.stl, cap_ring.stl, detent_carriage.stl, dial-me-spinner-base.kicad_pcb, diffuser.stl, fa_lower_plate.stl, light_box.stl, lower_spacer.stl]
2026-10-19 SPICE test harness: netlist-driven ngspice decks, pytest fixtures and results report
    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
    [base_cup.stl, board_parts.scad, detent_carriage.stl, dial_spinner.scad, diffuser.stl, fa_lower_plate.stl, light_box.stl, lower_spacer.stl]
2026-10-19 WIP: routing, SPICE tests and docs in progress
    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
    [dial-me-spinner-base.kicad_pcb, dial_spinner.scad]
2026-10-19 Mechanical fit: SH battery connector, module u.FL outward, J1 out of the hub zone
    - base J2: JST SH 4-pin side-entry (PH was too tall under the pressed rotor web)
    - main: MDBT50Q inner end r >= 8.8 with u.FL facing out; J1 at r 19.5; top r <= 4.6
    kept for the spindle nut; low-profile-only actuator corridor on the bottom
    - placer: keep-outs can exempt footprints (low-profile parts)
    - enclosure model: coax and battery-lead paths follow the new placement; clash check
    shows only the intended contacts
    - docs synced to the earlier late-change list; SPEC updated
    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
    [base.kicad_sch, base_cup.stl, board_parts.scad, detent_carriage.stl, dial-me-spinner-base.kicad_pcb, dial-me-spinner-main.kicad_pcb, dial_spinner.scad, diffuser.stl]
2026-10-19 WIP: SPICE tests and boards in progress
    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
    [dial-me-spinner-base.kicad_pcb, dial-me-spinner-main.kicad_pcb]
2026-10-19 Fix footprint-library memory leak in layout (5.4 GB -> 0.6 GB): cache FootprintLoad results
    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
    [dial-me-spinner-base.kicad_pcb]
2026-10-19 Docs site: VitePress + GitHub Pages deploy, Simulation CI
    - VitePress builds from the repository root so the docs' relative links work on GitHub and
    on the site; README is the home page; links to code/KiCad/model files go to GitHub;
    Mermaid diagrams render; local search
    - .github/workflows/docs.yml: builds on PRs (dead-link check), deploys to Pages from main,
    and publishes the SPICE results report as a page
    - .github/workflows/sim.yml: SPICE suite gate on PRs/pushes, weekly full run incl. slow sweeps
    - docs/simulation.md: how the netlist-driven SPICE suite works and what it covers
    Claude-Session: https://claude.ai/code/session_01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
2026-10-19 WIP: SPICE circuit tests in progress
    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
2026-10-19 Routing: cap the Freerouting optimizer, 2 threads, 4 h limit, log progress next to the board
    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
2026-10-19 NFC tag: P0.09/P0.10 as NFC1/NFC2 with 180 pF tuning caps and coil pads; CHG_INT_N moves to P1.03
    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
    [board_parts.scad, dial-me-spinner-base.kicad_pcb, dial-me-spinner-main.kicad_pcb, mcu.kicad_sch]
2026-10-19 WIP: SPICE tests, boards and mechanical extract in progress
    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
2026-10-19 Mechanical: NFC coil pads have no body; board parts re-extracted
    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
    [board_parts.scad]
2026-10-19 Display study for rev B: 1.75 in round AMOLED with touch, LED light guide, NFC coil (three configurations)
    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
2026-10-19 SPICE harness: make subcircuit 'gnd' ports local when inlining models
    ngspice maps a node named gnd to global ground even inside a .subckt, so a model whose
    ground port is called GND was tied to node 0 whatever the test connected it to (found by
    the usb_input verifier). Tests that wire it to 0 are unchanged.
    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
2026-10-19 SPICE: piezo_bus reads the CHG_INT_N/BTN_N pins from nets.MCU_PINS (CHG_INT_N moved to P1.03 for NFC)
    Fixes the 59 failures on the NFC commit: the system-bus helper asserted CHG_INT_N on P0.09.
    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
    [test_piezo_bus.py]
2026-10-19 SPICE: motor_drive and piezo_bus blocks verified
    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
2026-10-19 SPICE findings (sources): U21 QOD to OLED_VIN, R4 68R, R12 4R7, 25 V VSYS caps, base R4 100k, C1 0805 X7R
    Netlists are regenerated once the last two SPICE verifications finish.
    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
    [base.kicad_sch, dial-me-spinner-base.kicad_pcb]
2026-10-19 Base board goes 4-layer (In1 GND plane); fix In1 power-plane marking for KiCad 9 (layer id 4)
    The 2-layer base never routed completely (J3 signals and the button/charger network had to
    cross the power tracks with GND routed as tracks). set_layer_types matched '(1 "In1.Cu" ...)',
    but KiCad 9 numbers In1 as layer 4, so the main board's GND plane was routed as a signal layer too.
    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
    [base.kicad_sch, dial-me-spinner-base.kicad_pcb]
2026-10-19 WIP: SPICE verification and routing in progress
    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
    [dial-me-spinner-base.kicad_pcb]
2026-10-19 SPICE: DC-bias curve for the new C1 (0805 X7R); USB-3 margin check now passes and guards it; CI lists failures (-ra)
    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
    [test_usb_input.py]
2026-10-19 Main schematic: ERC clean (VBUS_NRF power flag, documented waiver for U21 QOD tied to VOUT); Freerouting pass cap; load-switch test numerics fallback
    - build.py: ERC_WAIVERS lists intended pin-type violations; waived ones are reported as such, never dropped
    - mcu.py: PWR_FLAG on VBUS_NRF (fed from VBUS through R12)
    - display.py: L20 note gives Isat 0.72 A rated (0.92 A typical)
    - layout.py: also pass --router.max_passes (Freerouting 2.1 ignores -mp)
    - test_load_switches.py: run() retries stalled/hung decks with looser numerics (verifier NEW-6)
    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
    [display.kicad_sch, main_power.kicad_sch, mcu.kicad_sch]
2026-10-19 Autoroute: give Freerouting In1 as a layer only GND may use instead of a plane; fix oled_boost TPS22917 model runaway
    Freerouting 2.1 placed no vias through the (plane GND) on the power layer, leaving 34 base-board connections
    unrouted for 500 passes. The DSN now exports In1 as a signal layer without the plane, and every class except
    GND is held off it with use_layer; KiCad refills the GND plane after routing. A 4-minute trial reached 5 unrouted.
    oled_boost__tps22917.lib computed the CT current, tON_k and the delay term from instantaneous VIN, so a VIN sag
    raised the ramp target (18.7 A into 445 uF); VIN is now low-passed with 1 ms like load_switches (1.05 A), nominal
    tON/tR unchanged.
    Co-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
2026-10-19 Main board: pin anchors may use the opposite side over the pad (R40 now 0.6 mm from P0.06 on top); U12 anchored at the module D-
    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
    [dial-me-spinner-main.kicad_pcb]
2026-10-19 Autoroute: keep pour-only rule areas out of the DSN (KiCad exports them as hard keepouts); single-threaded Freerouting
    The base board's antenna pour bands and the main board's no-pour ring over the magnet track were exported as full
    keepouts, so Freerouting could not run tracks through them or reach the J3 pins at their edge (19-21 connections
    left on the base). With them dropped from the in-memory export the base reaches 0 unconnected in a 4-minute trial.
    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
2026-10-19 Base board routed (4 layers): 0 unconnected, DRC clean with schematic parity; prune also removes bypassed escape stubs
    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
    [dial-me-spinner-base.kicad_pcb]
2026-10-19 Layout: low-current rails on the main board (+3V3, VBUS, +13V_OLED) get a 0.2 mm Supply class
    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
2026-10-19 WIP: main board routing in progress
    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
    [dial-me-spinner-main.kicad_pcb]
2026-10-19 WIP: SPICE suite triage and mechanical clash fixes in progress (agent edits)
    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
    [board_parts.scad, dial_spinner.scad]
2026-10-19 Mechanical: clash check clear on the current boards (intended contacts only); coax and harness re-threaded past U12
    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
2026-10-19 Sleep test: read the OLED sleep maximum per temperature from architecture 8.2; R20 fault detected against the typical OLED line
    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
2026-10-19 Autoroute: keep tracks/vias out of r 1.35 mm around fiducials on their side; route with clearances +10 um
    The main board's first route put GND/VSYS/HOME_N copper inside the fiducials' 0.6 mm clearance and 2 mm mask
    openings (the DSN carries neither), and Freerouting's octagon approximation of the rotated ring LEDs landed
    6-8 um inside the 0.13 mm clearance.
    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
2026-10-19 WIP: main board re-placed for routing (footprint UUID refresh)
    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
    [dial-me-spinner-main.kicad_pcb]
2026-10-19 WIP: doc sync and main-board routing in progress
    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
2026-10-19 WIP: doc sync in progress (bring-up, assembly, mechanical, simulation, README)
    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
2026-10-19 Docs: rev-A doc sync (SPEC, architecture, firmware, bring-up, assembly, mechanical, simulation, README) against the final schematics, boards and SPICE findings
    Edited per document group and then independently checked: late changes 1-35 (4-layer base, SM04B battery
    connector, NFC on P0.09/P0.10, U21 QOD tie, R4 68 R, R12/U12 USB protection, 25 V VSYS caps) and every SPICE
    firmware rule (H0H1 drive on P0.06, HFXO per LED frame, SYS_REG 4.4 V, LED/OLED enable timing, dead-battery
    OLED rule, VLED fault latch) are now in SPEC and firmware.md; the sleep budget carries the D21 leak (38 uA).
    Claude-Session: https://claude.ai/code/session_01P3c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
2026-10-19 Schematic notes: J1 at r 19.5, VLED fall 24/26.6 ms, hot-plug 4.49-5.49 V, SM04B J2, 100k press pull-down, SYS_REG 4.4 V, side-entry J3, LED data path and margins
    Notes only; netlists unchanged. Base board still DRC-clean with schematic parity.
    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
    [base.kicad_sch, leds.kicad_sch, main_power.kicad_sch, mcu.kicad_sch]
2026-10-19 WIP: main board routing (attempt 2 in progress)
    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
    [dial-me-spinner-main.kicad_pcb]
2026-10-19 Autoroute (main): fan every GND SMD pad out to the In1 plane before routing and leave GND out of the router
    Freerouting can neither route against a plane nor cope with wiring ~190 GND pads as traces on the main board
    (attempts stalled at 50-90 unconnected, most of them GND). fanout_vias() places a clearance-checked via and a short
    track at each GND pad (locked), and dsn_drop_net() removes GND from the DSN, handing its copper over as keepouts.
    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
2026-10-19 WIP: main board re-placed with GND fan-out (routing), firmware-guard tests in progress
    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
    [dial-me-spinner-main.kicad_pcb]
2026-10-19 WIP: firmware-guard SPICE tests and NFC/mechanical model in progress
    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
    [board_parts.scad, dial_spinner.scad]
2026-10-19 WIP: NFC coil in the mechanical model, re-renders in progress
    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
    [dial_spinner.scad]
2026-10-19 Mechanical: NFC coil under the top cover, tail to J11 with a bracket-rim relief, clash check covers both; renders and STLs regenerated
    Coil: annular 2-layer flex (ID 31 / OD 52.5, 0.15 thick) bonded under the cover ceiling at z 34.80-34.95, turns
    in r 24.9-26.15; tail folds down at r 24.7 at theta 222 and laps onto J11 under a 0.5 mm rim relief. 77 clash
    checks CLEAR, only the legend's intended contacts remain. Also: SPEC keep-out overlay shows the actuator corridor
    and hub zone, stale PH entries removed, CARR_T tagged DEV.
    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
    [base_cup.stl, detent_carriage.stl, dial_spinner.scad, diffuser.stl, fa_lower_plate.stl, light_box.stl, lower_spacer.stl, oled_bracket.stl]
2026-10-19 SPICE: vsys_sense and motor_drive firmware-rule guards (agent edits; old-rule xfails keep the 3.48 V evidence)
    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
2026-10-19 WIP: main board routing (attempt 2), firmware-guard SPICE tests and xdist results merge in progress
    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
    [dial-me-spinner-main.kicad_pcb]
2026-10-19 SPICE: LDO Iq guard against the current SPEC (4 uA max), load-switch / LED-data rule guards (agent edits)
    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
2026-10-19 Layout: per-board design rules; main board signals 0.12 mm / 0.10 mm clearance, 0.4/0.2 mm vias (JLC 4-layer minimum 0.09/0.09 mm)
    The main-board route stalls at 35-50 open connections, clustered at the MDBT50Q LGA, the motor drivers and
    the QSPI flash; the finer rules give the router room there. The base board keeps its rules (already routed).
    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
2026-10-19 WIP: main board re-placed with finer rules (routing)
    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
    [dial-me-spinner-main.kicad_pcb]
2026-10-19 WIP: firmware-rule closure / main routing in progress
    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
    [dial-me-spinner-main.kicad_pcb]
2026-10-19 Firmware rules closed against the SPICE guards: VBAT_est reading margin, SHIP 3.54 V reading, MD-2/MD-3, NEW-1 3.21 V, NF-1 instantaneous on-USB cap, PI-2 3.53 V row 0.26 A, PI-3 from VBAT_est 3.91 V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
    Docs (firmware.md, SPEC, architecture, bring-up, simulation.md) and the guard-test constants now state the same
    rules; full suite 725 passed, 47 strict xfails (6 accepted risks, 34 old-rule evidence, 4 'not allowed by the
    rule', 3 rule-insufficient for the reading margin above 3.72 V, being closed next).
    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
2026-10-19 Layout: --resume continues routing the board as it is; a Freerouting crash (no session file) keeps the board instead of aborting
    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
2026-10-19 Proportional VBAT reading margin (VBAT_est = 0.979 x reading) across tests and docs; actuator step scale 0.015 mm/step (500 steps); SPEC NFC coil, LiPo bay, ring ESD wording; fab rules per board
    Full suite 729 passed, 44 strict xfails (6 accepted risks, 34 old-rule evidence, 4 'not allowed by the rule'),
    0 failed; the three reading-margin rule-insufficient xfails are retired.
    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
    [dial-me-spinner-main.kicad_pcb]
2026-10-19 PI-3 WS2812B cap from VBAT_est 3.92 V (+17.85 mV burst margin); loaded zone <= 446 PPS and full-click default across docs; placer: rotated-courtyard occupancy, flash on the module's QSPI side, divide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
2026-10-19 Docs: shoe engagement window 1.5 mm as drawn (85 % is the expected default when the measured window is >= 1.3 mm); bring-up speed beyond the loaded zone follows the 521-781 PPS ramp; calcs label
    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
2026-10-19 Layout: grid router (finish_route.py) completes what Freerouting leaves open, with rip-up and a DRC check of every new connection; GND pads off the plane get a via; unique UUIDs per board (library pa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
    [dial-me-spinner-base.kicad_pcb]
2026-10-19 finish_route: rip-up removes the whole victim net and charges nets by how often they were ripped (no ping-pong); a net ripped three times is no longer rippable
    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
2026-10-19 Layout: no tracks/vias under the clamped hub flange (bottom r < 8.8), the M4 nut (top r < 4.6) or within 0.35 mm of the centre hole on any layer; copper already there is removed and re-routed; J10 SW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
2026-10-19 finish_route: route GND connections too (pads cut off from the plane join the nearest plane-connected copper)
    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
2026-10-19 Main board routed: 0 unconnected, DRC clean (no errors or warnings) with schematic parity
    Freerouting (placement variant with J10 at the SWD pins) left 11 connections open; finish_route completed them.
    No copper under the clamped hub flange / M4 nut or near the centre hole (65 pieces re-routed). Board title on the
    bottom silk. finish_route: ends anchored like a router (tracks split at T-joints, short links to via centres),
    supplies never ripped, large victim nets lose only the conflicting copper, a net's connections all route in one
    round, windows sized from the smaller cluster; layout: --complete repeats until the clean-up keeps every joint,
    GND fix-up falls back to a signal-size via, the d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
    [dial-me-spinner-main.kicad_pcb]
2026-10-19 Mechanical model from the routed main board: board parts, calcs (coax to U12 now 0.84 mm, no parts needing action), renders, STLs (bracket pocket over D20); clash report unchanged (intended contacts 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
    [base_cup.stl, board_parts.scad, cap_ring.stl, diffuser.stl, fa_lower_plate.stl, light_box.stl, oled_bracket.stl, spindle.stl]
2026-10-19 Fab outputs for both boards (release.py, DRC + schematic parity gate passed): gerbers, JLCPCB BOM/CPL, ORDER-NOTES, PDFs, 3D renders; JLC footprint corrections for C78636, C2909356, C163455
    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
    [dial-me-spinner-base-BOM-JLCPCB.csv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]
2026-10-19 MCU sheet: U12 is 3.1 mm (pad centres) from the module's D- pad as placed; main fab outputs re-released (schematic PDF)
    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
    [dial-me-spinner-main-B_Cu.gbl, dial-me-spinner-main-B_Mask.gbs, dial-me-spinner-main-B_Paste.gbp, dial-me-spinner-main-B_Silkscreen.gbo, dial-me-spinner-main-Edge_Cuts.gm1, dial-me-spinner-main-F_Cu.gtl, dial-me-spinner-main-F_Mask.gts, dial-me-spinner-main-F_Paste.gtp]
2026-10-19 WIP: final doc pass (routed main board, placement changes, copper keep-outs, fab outputs) in progress
    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
2026-10-19 Docs: routed main board, placement changes (J10, U11, divider, test pads), copper keep-outs under the hub flange/nut/centre hole, routing flow, fab outputs; independently checked
    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
2026-10-19 No vias on SMD or connector pads: GND fan-out, stitching and the grid router keep via rings off every SMD/connector pad (any net); --complete removes any via on a pad and re-routes. Main board re-com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
    [dial-me-spinner-main-B_Cu.gbl, dial-me-spinner-main-B_Mask.gbs, dial-me-spinner-main-B_Paste.gbp, dial-me-spinner-main-B_Silkscreen.gbo, dial-me-spinner-main-Edge_Cuts.gm1, dial-me-spinner-main-F_Cu.gtl, dial-me-spinner-main-F_Mask.gts, dial-me-spinner-main-F_Paste.gtp]
2026-10-19 SPEC §8 stack-up: turned 316L spindle with M4 spigot and nut, brass hub clamped to the board (closes mechanical A7's SPEC fix); architecture topology wording; TP12/TP13 are just beyond the OLED glass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
2026-10-20 Export the flywheel ring, so the most expensive machined part has a file
    The 316L ring (BOM item 7, $15-40, the one part that must go to a CNC vendor)
    had no exported model: export_stl.sh listed 15 parts and the ring was not among
    them. rotor_carrier is the PA12-GF carrier bonded INTO the ring, and cap_ring is
    a 0.5 mm shim, so neither stands in for it. Found by trying to quote the build:
    the PCB and the printed parts upload fine, the flywheel could not be submitted.
    The geometry was already there and already exercised -- module rotor_ring()
    (chamfers, 48 magnet pockets at R_t 29.0, 4 balance holes at r 31, optional
    knurl) is used by rotor() for the assembly and clash views, and calcs.py mo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
    [dial_spinner.scad, parts_plate.scad, rotor_ring.stl]
2026-10-20 Machined parts get a kernel-backed model, STEP and drawings, because no CNC vendor takes a mesh
    OpenSCAD has no geometry kernel. It can only emit a mesh, and a mesh is not
    something a machine shop can quote from: JLCCNC's uploader rejects STL outright
    and asks for STEP, DWG, DXF or PDF, and the moment a part declares a thread it
    stops accepting geometry alone and demands a drawing. Which is the point -- a
    solid cannot carry a fit, a thread, a knurl, a finish or a general tolerance.
    So the five turned / cut metal parts now have a second description:
    - models.py builds them as exact B-rep solids (build123d / OpenCascade).
    - drawgen.py writes step/*.step and dimensioned ISO sheets to drawings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
    [cap_ring.step, dial_spinner.scad, lower_spacer.step, rotor_ring.step, spindle.step, spindle_hub.step]
2026-10-21 Move the 48 magnet pockets out of the steel into a printed shim
    The flywheel's 48 blind magnet pockets were a flat-bottom milling operation
    held to +0.02/-0.00 in stainless, and they were what made the ring expensive.
    They are now 48 through holes in a printed ring that drops into a turned
    recess, which leaves the flywheel a turning-only part.
    JLCCNC, SUS304, qty 1: $71.45 -> $52.49, machining $60.01 -> $41.05. Less
    than I guessed before quoting it -- the turning itself is still $41, so the
    pockets were 27 % of the price, not the 84 % the machining line suggested.
    The recess is sunk into the top face rather than the shim being stacked on
    top, because inertia goes as r^2: 59 % of the ring's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
    [dial_spinner.scad, magnet_shim.stl, parts_plate.scad, rotor_ring.step, rotor_ring.stl]
2026-10-22 Fix JLC CPL origins and check every row by simulating JLC's placement
    The CPL writer mapped the JLC origin onto the board with a least-squares
    fit between library and board pads keyed by pad number. Footprints with
    repeated pad numbers (MP mounting pads, USB-C S1 shell, the tactile
    switch's 1,1,2,2) collapsed to one pad per number, so the fit was wrong.
    Seven rows of the rev A release were misplaced: main J1, J20, J40 and
    base J1, J2, J3 by 1.4-4.5 mm, base SW1 by 127 mm.
    - Map the point with the footprint's own transform (rotation, and the
    local-y mirror on the bottom), exact for any footprint, and check it
    reproduces the board pads.
    - Cache each part's EasyEDA pad centres in jlc_offse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
    [dial-me-spinner-base-CPL-JLCPCB.csv, dial-me-spinner-main-CPL-JLCPCB.csv]
2026-10-22 Credit the EasyEDA source of the cached pad data; note R26 in the preview
    EasyEDA records carry a notice that reproduced library data must name the
    JLCEDA/EasyEDA Official Library as its source, with links. jlc_offsets.json
    (a _source entry), jlc_cpl.py and the README now do. assembly §3.4 notes
    that R26, the one part with no EasyEDA footprint, is an in-stock Extended
    part at JLC whose preview may show no footprint drawing.
    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
